roman885-85/hearlink/docs/uk/hardware.md

# Обладнання та схеми

[← до головної](../../README.uk.md) · [English](../en/hardware.md)

> **Набір 4.x.** Входи (цифровий AES/S/PDIF, аналоговий PCM1808, USB) тепер на **мості** — платі Raspberry Pi Pico між
> пультом і передавачем. Що докупити, як переробити модуль PCM1808, схеми підключення, зворотний бік передавача з
> роз'ємом H1 і варіанти цифрового входу — **[Набір 4.x: міст, входи, схеми](next-edition.md)**. Нижче — модулі,
> приймачі, навушники й ЦАП (для 4.x без змін) і підключення PCM1808 прямо до передавача (лише для 3.x).

## Що потрібно

### Передавач (1 шт.)

| Вузол | Що саме | Примітки |
|---|---|---|
| Модуль | **ESP32-4848S040** (він же ESP32-4848S040C_I): ESP32-S3-WROOM-1U **N16R8**, екран 4″ 480×480 (ST7701), ємнісний сенсор GT911, гніздо microSD, міст USB CH340 | потрібна саме версія з 16 МБ флеш і 8 МБ PSRAM |
| Антена | зовнішня 2,4 ГГц на роз'єм IPEX (U.FL) | модуль «1U» без антени майже не чути: на столі −45…−68 дБм замість −14 |
| Живлення | блок 5 В, **не менше 1 А** | від порту ноутбука не живити: струм в імпульсі великий, порт «відвалюється» |
| Вхід звуку | 4 резистори 10 кОм, конденсатори 1 мкФ і 4,7 нФ, фільтр зміщення 1 кОм + 100 мкФ | на роз'ємі H1 немає 3,3 В, тому зміщення береться від 5 В через фільтр |
| Розв'язка (бажано) | ізолятор «земляної петлі» 3,5 мм між пультом і передавачем | прибирає гул 50 Гц |
| Картка пам'яті (за бажанням) | microSD, FAT32 | запис ефіру, файли в ефір, оновлення |
| Зовнішній АЦП (за бажанням) | модуль **PCM1808** | стерео й менший шум; у прошивці є, **на модулі 4848 не перевірено** |

### Приймач (на кожного слухача)

| Вузол | Що саме | Примітки |
|---|---|---|
| Плата | **ESP32-S3-DevKitC-1 N16R8** (або сумісна з 16 МБ флеш і 8 МБ PSRAM) | PSRAM потрібна для оновлення по радіо: образ 2,2 МБ приймається в пам'ять цілком |
| Екран із ручкою | модуль «M75»: OLED **SH1106 1,3″ 128×64 I2C** + енкодер **EC11** з кнопкою | живити **тільки від 3,3 В**: підтяжки I2C на модулі йдуть до VCC |
| Кольоровий екран (за бажанням, з 3.03) | **IPS 1,9″ 170×320 ST7789** (модуль MSP1901), шина SPI | замість OLED; вибір — перемичкою «вивід 21 → GND»; ручка й кнопки — як і раніше. Див. розділ [нижче](#кольоровий-екран-ips-19-на-приймачі-з-прошивки-303) |
| Вихід звуку | навушники напряму: на кожне плече 1 кОм + 10 нФ і розділовий конденсатор 1 мкФ | або підсилювач навушників із різницевим входом (MAX97220) |
| Зовнішній ЦАП (за бажанням) | модуль **PCM5102** або **CS4344** (з 2.85) | чистіший звук: шум живлення процесора в навушники не потрапляє; див. розділи нижче |
| Живлення | повербанк або акумулятор із виходом 5 В | екран не обов'язковий: без нього приймач просто грає |

Плата приймача може бути й без екрана та ручки — тоді ним керують із передавача (гучність, вимкнення, усі
налаштування).

## Як виглядають модулі

### Фотографії

| | |
|---|---|
|  | **ESP32-4848S040** — модуль передавача, лицьовий бік: сенсорний екран 4″ |
|  | **ESP32-4848S040**, зворотний бік: модуль ESP32-S3 з антеною на дроті, гніздо microSD, USB-C, роз'єм H1 |
|  | напис на корпусі модуля — за ним його й шукати |
|  | **ESP32-S3 N16R8** — плата приймача (два роз'єми USB-C, кнопки BOOT і RST, кольоровий світлодіод) |
|  | **екран SH1106 1,3″ з енкодером EC11** і кнопками BACK / CONFIRM |
|  | **MAX97220** («HYT») — підсилювач навушників (за бажанням): входи L+, L−, R+, R−, вихід R, G, L, живлення VCC, GND, керування CTRL |
|  | **PCM1808** — зовнішній АЦП передавача (за бажанням) |
|  | **PCM5102** — зовнішній ЦАП приймача (за бажанням) |

Фотографії модулів належать їхнім виробникам і продавцям; ліцензія MIT проєкту на них не поширюється.

### Малюнки з підписами виводів

Малює їх `tools/gen_modules.py`. Розташування деталей умовне — виводи звіряйте з написами на своїй платі.

ESP32-4848S040
ESP32-S3-DevKitC-1
M75
IPS 1,9″ ST7789
MAX97220
PCM5102
PCM1808

Справжній вигляд плати ESP32-S3-DevKitC-1 — у документації виробника:
<https://docs.espressif.com/projects/esp-dev-kits/en/latest/esp32s3/esp32-s3-devkitc-1/>. Решту модулів легко
знайти за назвою: «ESP32-4848S040», «SH1106 1.3 OLED EC11», «MAX97220 module», «PCM5102 module», «CS4344 module» (або «Pmod I2S»), «PCM1808 module».

## Виводи

### Приймач (ESP32-S3)

| Призначення | Вивід |
|---|---|
| Екран SDA, SCL | 8, 9 |
| Ручка: A (TRA), B (TRB), кнопка (PSH) | 5, 6, 7 |
| Кнопки модуля CON, BAK (не використовуються, підтягнуті) | 15, 16 |
| Вихід звуку «+», «−» (однобітний PDM) | 17, 18 |
| PCM5102: BCK, LCK, DIN, XSMT; SCK — на GND (або на вивід 10, там нуль) | 11, 12, 13, 14 |
| CS4344: MCLK, SCLK, LRCK, SDIN (живлення VCC — від 3V3) | 10, 11, 12, 13 |
| Кольоровий світлодіод плати (WS2812) | 48 (у нових плат — 38) |
| Кольоровий екран IPS 1,9″: SCL, SDA, DC, CS, RES, BLK (з 3.03) | 42, 41, 40, 39, 2, 1 |
| Перемичка вибору екрана: на GND — кольоровий, вільний — OLED (з 3.13) | 21 |

### Передавач на модулі ESP32-4848S040

| Призначення | Вивід |
|---|---|
| Вхід звуку (вбудований АЦП) | IO2 |
| PCM1808: MCLK, BCK, LRCK, DOUT | IO43 (TXD), IO1, IO2, IO40 |
| Картка пам'яті SPI: SCK, MOSI, MISO, CS | 48, 47, 41, 42 |
| Сенсор GT911 SDA | 19 |
| Підсвітка | 38 |

Вільних виводів на модулі лише три: IO1, IO2, IO40 (на роз'ємі H1 вони підписані L1–L3; порядок на роз'ємі
знаходиться командою порту `H`). Коли працює PCM1808, вихід порту (TXD) зайнятий тактом АЦП — передавач нічого не
друкує в порт, але команди приймає. З версії 2.56 такт подається на цей вивід лише тоді, коли вхід
PCM1808 справді йде в ефір: з перевірочним звуком чи файлом із картки в ефірі порт працює як звичайно (докладніше — на
початку [«Команди порту»](commands.md)). Вбудований АЦП — лише для перевірки без зовнішнього АЦП: з ним радіо
передавача часом «стає» на 0,2 с (вбудований АЦП і радіо ділять один вузол мікросхеми).

**Виводи FMT, MD0, MD1 модуля PCM1808.** MD0 і MD1 — на GND (АЦП веде передавач). FMT за схемою — на GND (формат I2S),
але працює й FMT на 3,3 В («ліве вирівнювання», дані на такт раніше): з 3.19 передавач розпізнає формат сам і збирає
відліки наново, ліво й право ставить на місце (так у власника: «при подключении к минусу звука не было вообще»). До 3.19
з FMT на 3,3 В гучні місця «перевертались» — тріск, і рівень на індикаторі був удвічі завищений (`e14`, `e18`).

**Рівень на вході АЦП.** Повна шкала PCM1808 — 3 В розмаху (за живлення 5 В), тобто ±1,5 В. Вольтметр показує
середнє, а піки музики в 3–4 рази вищі, тож «0,7 В» на вольтметрі — уже біля краю шкали. Ознака перевантаження — червоне
«АЦП зрізає» на листі «Піки входу» або «на краю шкали» в `e14`: тоді зменшити вихід пульта (чи поставити на вході
R1, R2 по 22 кОм замість 10 — див. схему). Бас сильно навантажує АЦП: якщо низи все одно зрізаються еквалайзером
передавача, краще зрізати їх на пульті для цієї лінії.

**Такти — найслабшими виходами** (з 3.26): гармоніки такту 8,192 МГц потрапляють у діапазон 2,4 ГГц і заважали
власному радіо передавача (шум +2–3 дБ, коли в ефірі пульт). Провід такту до модуля тримайте коротким і подалі від
антени.

### Передавач на звичайній платі ESP32-S3 (без екрана)

Вхід звуку — вивід 4 (АЦП), PCM1808 — 10 (SCK), 11 (BCK), 12 (LRC), 13 (OUT). Керування — тільки з порту.

## Схеми

Передавач на модулі з екраном, вхід — вбудований АЦП:

Передавач

Вхід: R1, R2 по 10 кОм складають лівий і правий канали пульта, R3, R4 по 10 кОм задають зміщення посередині,
C1 1 мкФ відділяє постійну складову, C2 4,7 нФ зрізає радіочастоти. Сигнал послаблюється вдвічі; на вхід можна
подавати до 2 В.

Приймач, навушники напряму до плати:

Приймач із навушниками

Приймач із підсилювачем навушників (вихід «протифаза»):

Приймач

Варіанти із зовнішніми перетворювачами (не перевірені на платах):
[передавач + PCM1808](../skhema-peredatchik-4848-pcm1808.png),
приймач + PCM5102, приймач + CS4344 і приймач із кольоровим екраном — у розділах нижче.

Схеми малює `tools/gen_schema.py`; є також у SVG.

## Зовнішній ЦАП PCM5102 на приймачі

Модуль — фіолетова плата GY-PCM5102 (PCM5102A, два стабілізатори 3,3 В, гніздо 3,5 мм; на виходах послідовно по
470 Ом — тому навушники можна вмикати просто в гніздо).

| Вивід модуля | Куди | Навіщо |
|---|---|---|
| VIN | 5V приймача | живлення (на модулі свої стабілізатори 3,3 В) |
| GND | GND | |
| BCK | **11** | такт бітів, 1,024 МГц |
| LCK (LRCK) | **12** | такт каналів, 32 кГц |
| DIN | **13** | дані I2S, 16 біт |
| SCK | **GND** (або вивід 10 — приймач тримає на ньому нуль) | головний такт не подається: ЦАП відновлює його з BCK сам |
| XSMT | **14** (або 3V3) | «звук увімкнено». З 2.63 приймач тримає тут «землю» від першого рядка запуску й піднімає рівень, лише коли звук справді пішов (див. нижче «Без хлопків») |
| FLT | **GND** або 3V3 — тільки не «в повітрі» | цифровий фільтр: GND — звичайний, 3V3 — із малою затримкою |
| DEMP | **GND** або 3V3 — тільки не «в повітрі» | корекція передспотворень: GND — вимкнено, 3V3 — увімкнено (верхи м'якші) |
| FMT | **GND** | формат I2S |

Приймач із PCM5102

**Без хлопків у навушниках.** Щоб ЦАП мовчав, поки приймач завантажується, XSMT має бути на виводі 14 (а не на
3V3 і не перемичкою H3L на «H»). З версії 2.63 прошивка: (1) ставить вивід 14 у «землю» першим же рядком запуску;
(2) піднімає його, лише коли приймач у роботі й звук пішов (заставка й початок «запуску» минають із заглушеним
ЦАП), і опускає, щойно робота скінчилась; (3) перед будь-яким перезапуском плати спершу глушить ЦАП і втримує
«землю» на виводі крізь перезапуск. Одного прошивка зробити не може: від подачі живлення до її запуску (частки
секунди) вивід процесора нічим не керується. Якщо хлопок **при вмиканні живлення** лишається — поставте резистор
10–47 кОм між XSMT і «землею»: він тримає ЦАП заглушеним, доки прошивка не візьме вивід на себе.

### Підсилювач навушників MAX97220 після ЦАП

З гнізда модуля PCM5102 до навушників 32 Ом доходить близько 6 % напруги ЦАП: на виходах модуля стоять резистори
470 Ом. Тому «на повну» з навушниками напряму тихо, і цифрове «Підсилення» тут не допоможе — гучніше за повну шкалу
ЦАП цифрою не зробити. Запас дає підсилювач навушників: модуль MAX97220 («HYT») віддає в навушники всю напругу ЦАП.

| Площадка модуля | Куди |
|---|---|
| L+, R+ | лівий і правий вихід ЦАП |
| L−, R− | «земля» ЦАП (AGND) |
| VCC, GND | живлення; краще 5 В — від 3,3 В на найгучніших місцях можливий зріз |
| CTRL | на «плюс» — підсилювач увімкнено (за описом мікросхеми) |
| R, G, L | навушники |

- **Підсилення модуля — одиниця.** Усі резистори біля мікросхеми — 10 кОм. Напис «E01» на частині з них — це ті
  самі «103», припаяні догори ногами.
- **Щоб підняти підсилення**, зменшують резистор на вході «+»: підсилення = 2 · 10 кОм / (10 кОм + R). З 470 Ом
  це 1,9 (+5,6 дБ), з перемичкою — 2 (+6 дБ). Але на навушники 32 Ом мікросхема віддає приблизно до 2 В при
  живленні 5 В, а ЦАП на повній шкалі дає 2,1 В — тож із підсиленням 2 на великій гучності вона зрізає піки.
  Тоді в приймачі ставлять «Межа гучності» близько 85 % (5 В) чи 70 % (3,3 В).
- **«Підсилення» в меню приймача з підсилювачем тримають на нулі**, гучність регулюють ручкою; для слухачів варто
  обмежити «Межа гучності» — 100 % тепер справді гучно.

Числа про напругу й зріз — розрахунок за описом мікросхеми, на платі не виміряні.

**Головне — жоден керівний вивід мікросхеми не має «висіти в повітрі».** За схемою модуля чотири виводи (FLT, DEMP,
XSMT, FMT) задаються перемичками H1L–H4L на звороті, і зазвичай модуль приходить із запаяними: H1L → L, H2L → L,
H3L → H, H4L → L; SCK замкнений на «землю» краплею припою біля виводу. **Трапляються модулі з незапаяними
перемичками** — тоді ці входи нічим не задані (внутрішніх підтяжок у мікросхеми немає), і ЦАП або мовчить (XSMT),
або хрипить і тріщить (FMT, FLT, DEMP ловлять наведення від сусідніх ліній). Ліки без паяння — дроти з гребінки
модуля: FLT, DEMP і FMT на сусідній вивід AGND (G) тієї ж гребінки, XSMT — на вивід 14 приймача. Або запаяти
перемички, як у таблиці.

| Перемичка | Вивід ЦАП | Що задає | Як має бути | Якщо інакше |
|---|---|---|---|---|
| H1L | FLT | цифровий фільтр | **L** або **H** | L — звичайний фільтр, H — із малою затримкою; «в повітрі» — клацання, «бруд» у звуку |
| H2L | DEMP | корекція передспотворень 44,1 кГц | **L** або **H** | L — звук як є, H — верхи м'якші; «в повітрі» — «бруд» у звуку |
| H3L | XSMT | приглушення | **H** | L або «в повітрі» — тиша |
| H4L | FMT | формат даних | **L** (I2S) | H — інший формат: гучний шум замість звуку; «в повітрі» — хрип |

**Перевірено на приладі (09.10.2026).** На приймачі з модулем, у якого H1L, H2L і H4L не були запаяні, звук ішов із
цифровим «брудом»: фонове дзижчання на деяких гармоніках, «ніби дуже низька дискретизація» — хоча сигнал до ЦАП був
правильний біт у біт (`n8=9`). Після запаювання **H1L → H, H2L → H, H4L → L** (H3L → H уже була) бруд зник, звук
чистий. Тобто запаяні мають бути всі чотири перемички; у робочому приймачі набору стоїть саме це поєднання.

Про H2L → H: це корекція передспотворень, розрахована на 44,1 кГц; на наших 32 кГц вона приглушує верхи — за
розрахунком приблизно −2 дБ на 2 кГц, −5 дБ на 4 кГц, −8 дБ на 8 кГц (не виміряно). Якщо мові бракує чіткості —
підняти верхи на приймачі («Чіткість», смуги еквалайзера 2,5 і 6 кГц) або запаяти H2L → L.

- Якщо перемичку H3L запаяно на «H» — вивід 14 до XSMT **не під'єднувати**; якщо SCK на модулі вже замкнений на
  «землю» — нікуди його більше не вести.
- У меню приймача: «Вихід звуку» → **PCM5102** (плата перезапуститься); з порту — `o1`. Навушники з виводів 17/18
  у цьому режимі мовчать.
- Що саме йде на ЦАП, приймач показує сам: `n8=7` — чи «тремтять» BCK, LRCK і дані, рівні SCK та XSMT; `n8=9` —
  знімає сигнали з виводів і друкує біти одного слова (перевірка формату).
- Документація: [PCM5102A, Texas Instruments](https://www.ti.com/lit/ds/symlink/pcm5102a.pdf) — режим без головного
  такту (розділ 9.3.5.3, таблиця 11: 32 кГц при BCK 1,024 або 2,048 МГц), вхід XSMT (9.3.3).

## Зовнішній ЦАП CS4344 на приймачі (з прошивки 2.85)

Модуль — плата з мікросхемою **CS4344** (Cirrus Logic) і гніздом 3,5 мм: Digilent Pmod I2S або її копії, «CS4344
DAC module». На гребінці зазвичай шість виводів: MCLK, LRCK, SCLK, SDIN, GND, VCC; на різних платах підписи бувають
інші — BCK або BCLK замість SCLK, WS або LRC замість LRCK, DIN або SDATA замість SDIN.

| Вивід модуля | Куди | Навіщо |
|---|---|---|
| VCC | **3V3** приймача | живлення ЦАП, близько 16 мА. Якщо на модулі свій стабілізатор і вхід підписано «5V» чи «VIN» — тоді 5V приймача |
| GND | GND | |
| MCLK | **10** | головний такт 8 МГц — без нього CS4344 мовчить |
| SCLK (BCK, BCLK) | **11** | такт бітів, 2 МГц |
| LRCK (WS) | **12** | такт каналів, 31,25 кГц |
| SDIN (DIN, SDATA) | **13** | дані I2S, 16 біт |

Приймач із CS4344

**Живлення — 3,3 В, а не 5 В.** «Одиниця» на входах CS4344 — від 60 % напруги його живлення (опис мікросхеми,
таблиця «Digital input characteristics»). При 3,3 В це 2 В, і виводи ESP32-S3 мають запас; при 5 В — 3 В, а вивід
процесора дає 3,3 В, тобто на межі.

**Чому вихід на 31,25 кГц.** CS4344 обов'язково потребує головного такту (MCLK), і він має бути цілим кратним
частоти каналів (розділ 4.1: «MCLK/LRCK must be an integer ratio»). Для звичних 32 кГц це 8,192 МГц, а ESP32-S3
отримує його лише дробовим дільником зі 160 МГц — періоди такту нерівні (саме такий такт у 2.35–2.37 на PCM5102 давав
хрип). 160 МГц / 20 = 8 МГц ділиться без залишку, а 8 МГц / 256 = 31 250 Гц. Звук ефіру (32 кГц) приймач сам
перераховує на цю частоту тією ж підгонкою темпу, що тримає запас: на один відлік виходу припадає 1,024 відліку
ефіру замість одного. Частоти звуку при цьому не зсуваються; смуга — до 15,6 кГц.

**Вихід лінійний.** Розмах на повній шкалі — 0,65 від напруги живлення: при 3,3 В близько 0,76 В дійсного значення
(у PCM5102 — 2,1 В; CS4344 тихіший на 9 дБ). Навантаження — не менше 3 кОм, вихідний опір 100 Ом (таблиця «DAC Analog
Characteristics»): навушники прямо в гніздо модуля грають тихо, а на гучному — зі спотвореннями. Для роботи —
підсилювач навушників **MAX97220** (як після PCM5102, розділ вище): лівий і правий вихід модуля → L+ і R+; L−, R− і
«земля» модуля → «земля». Підсилення підсилювача можна підняти до 2 (резистор на вході «+» 470 Ом або перемичка):
0,76 В × 2 = 1,5 В — це менше за ~2 В, які MAX97220 віддає в навушники 32 Ом при 5 В, тож зрізу не буде (розрахунок,
не вимірювання).

**Вивід 14 — «увімкнено» підсилювача навушників** (з 3.28; власник: «в приемниках при работе с cs4344, вывод 14
использовать для управления модулем усилителя, пока устройство не загружено звука нет»). Виводу XSMT у CS4344 немає,
тож приймач веде виводом 14 сам підсилювач — так само, як XSMT у PCM5102: «земля» з першого рядка запуску, підйом —
лише коли приймач у роботі й звук пішов, «земля» в очікуванні, пошуку й сні та під час будь-якого перезапуску.
Провід — з виводу 14 на вхід увімкнення підсилювача (у MAX97220 — SHDN: високий — працює, низький — вимкнено; у
модулів підсилювачів він буває підписаний EN, SD, SHDN чи MUTE). Якщо вхід увімкнення на модулі вже запаяно на
живлення — розпаяти й завести на вивід 14; хлопок у самий момент подачі живлення прибирає резистор 10–47 кОм з цього
входу на «землю».

**Від клацань CS4344 береже себе й сама**
(Popguard, розділ 4.5): коли з'являється головний такт, вихід плавно встає за 0,25 с (0,42 с, якщо на VQ модуля стоїть
10 мкФ), а звук іде ще приблизно через 2000 відліків (≈ 64 мс); коли приймач засинає і такт зникає — вихід так само
плавно опускається. Тому після вмикання чи пробудження звук з'являється на 0,3–0,5 с пізніше, ніж із PCM5102.

**Вивід 10 і старе під'єднання PCM5102.** Раніше вивід 10 був «землею» для SCK модуля PCM5102, а SCK на самому модулі
міг бути ще й замкнений на «землю» краплею припою. Щоб не подати такт 8 МГц у замикання, приймач перед запуском
виходу перевіряє вивід 10: вмикає на ньому підтяжку до живлення, і якщо вивід однаково читається нулем — такт на нього
не подає (у `n8=7` — «ВИВІД 10 НА «ЗЕМЛІ»»); CS4344 тоді мовчить. Модуль PCM5102, залишений у режимі CS4344, грає:
він бере такт із BCK або з виводу 10.

- У меню приймача: «Вихід звуку» → **CS4344** (плата перезапуститься; по колу PDM → PCM5102 → CS4344); з порту — `o2`.
  Навушники з виводів 17/18 у цьому режимі мовчать.
- Перевірка: `n8=7` — чи «тремтять» виводи 10–13 і рядок «головний такт: джерело PLL 160 МГц, ділення 20 ціле
  (дробу z=0 y=0 x=0) → 8.000 МГц; такт бітів = головний / 4; частота виходу 31250 Гц»; `n8=8` — справжня частота
  виходу (близько 31 250 відліків за секунду).
- Документація: [CS4344/45/48, Cirrus Logic, DS613F2](https://statics.cirrus.com/pubs/proDatasheet/CS4344-45-48_F2.pdf) — розділ 4.1 (головний такт, таблиця 1), 4.2 (такт бітів,
  «External Serial Clock Mode»), 4.5 (Popguard), таблиці аналогових характеристик і цифрових входів.

**Що перевірено (14.10.2026).** Режим CS4344 — на приймачі з модулем PCM5102, який приймає ту саму схему тактів:
головний такт 8,000 МГц (дільник 20 цілий, дробу немає — прочитано з регістрів процесора), такт бітів = головний / 4,
вихід 31 249 відліків за секунду, підгонка темпу тримає запас, звук іде. **На самому модулі CS4344 не перевірено** —
у наборі його немає.

## Кольоровий екран IPS 1,9″ на приймачі (з прошивки 3.03)

Замість OLED приймач може мати кольоровий екран **IPS 1,9″ 170×320 на контролері ST7789** — модуль MSP1901
([опис на LCDwiki](https://www.lcdwiki.com/1.9inch_IPS_Module); приклад роботи з ESP32 —
[mboehmerm/IPS-Display-ST7789-170x320](https://github.com/mboehmerm/IPS-Display-ST7789-170x320)). Екран стоїть
горизонтально, 320×170; усі екрани, меню, значки, заставка й переходи для нього намальовані наново, у кольорі.
Керування те саме — ручкою (модуль M75 або окремий енкодер EC11 на тих самих виводах).

| Вивід модуля | Куди | Навіщо |
|---|---|---|
| VCC | **3V3** приймача | живлення модуля й підсвітки |
| GND | GND | |
| SCL | **42** | такт шини SPI |
| SDA | **41** | дані шини SPI |
| RES | **2** | скидання |
| DC | **40** | команда / дані |
| CS | **39** | вибір модуля |
| BLK | **1** | підсвітка: ШІМ 30 кГц (вище чутного), яскравість 1…5 |

**Вибір екрана — перемичкою (з 3.13).** Вивід **21** з'єднати з GND — приймач працює з кольоровим екраном; вивід
вільний (підтягнутий усередині до живлення) — з OLED. Читається під час увімкнення: поставили чи зняли перемичку —
перезапустити приймач. Визначити модуль програмно не можна: лінії читання в нього немає. Якщо стоять обидва екрани,
OLED при кольоровому 10 с показує підказку («OLED — зніміть перемичку 21-GND») і гасне. Команда порту `n14` каже,
який екран зараз. До 3.13 екран вибирали пунктом меню «Тип екрана» — його прибрано: якщо стоїть лише кольоровий
екран, перемикати меню без OLED нема чим.

Приймач із кольоровим екраном

**Шина.** Виводи шини SPI з прямим під'єднанням (10–13) зайняті звуком, тому шина йде через матрицю виводів. З 3.11 —
**20 МГц і найслабші виходи** ліній шини: на 40 МГц зі звичайними виходами зміна картинки давала в навушниках легкі
клацання (власник 15.10.2026; заміри показали, що радіо й цифрова частина звуку від шини не страждають — це наведення
вже після ЦАП). Після 3.11 — «практично зникли, майже не помітні». Якщо клацання чути:

- резистори **33–68 Ом** у лініях SCL і SDA біля плати (на схемі — пунктирно, за бажанням);
- дроти до модуля якомога коротші й подалі від дротів ЦАП і від антени;
- «земля» модуля — окремим дротом до GND плати; на живленні модуля 10 мкФ + 100 нФ.

Властивості модуля — командою порту `n27=<сума бітів>` (перезапуск): 1 — модуль повернутий на 180°, 2 — порядок
кольорів BGR (якщо червоне й синє переплутані), 4 — шина 80 МГц, 8 — 40 МГц (як до 3.11), 16 — сильні виходи шини
(як до 3.11). Яскравість — пункт меню «Яскравість» або `n15=1…5`.

**Що перевірено (15.10.2026, приймач 884A94).** Головний екран — 62–63 кадри за секунду, кадр 3,6–4,9 мс; на екран
іде лише те, що змінилося (сотні точок за кадр із 54 400). Оновлення прошивки по радіо в кольоровому режимі — шість
разів поспіль без збоїв. Сон і пробудження — як з OLED.

## Два способи під'єднати навушники

У меню приймача «Виводи» (і на передавачі: вікно приймача → «Налаштування» → «Вихід звуку»):

- **2 канали** — на виводі 17 лівий канал, на 18 правий; навушники напряму або стереопідсилювач. Працюють стерео
  й баланс.
- **протифаза** — один і той самий звук на двох виводах у протифазі: удвічі більший розмах для підсилювача з
  різницевим входом. З навушниками, під'єднаними напряму, у цьому режимі звук «навиворіт» — його не вмикати.

Виводи 17 і 18 поставлені на найбільший струм (до 40 мА). Гучність у навушниках напряму залежить від їхнього опору:
з 32 Ом тихіше, ніж із підсилювачем.

## Послідовність збирання

1. Спершу прошити плату ([Встановлення](install.md)) і переконатися, що вона запускається.
2. Під'єднати **тільки екран** — перевірити заставку. Потім ручку. Потім звук. По одному вузлу за раз: так видно,
   що саме не працює.
3. Перед подачею живлення перевірити, що VCC екрана на 3V3, а не на 5V.
   Кольоровий екран — так само від 3V3; перемичку 21 → GND ставити разом із ним.
4. Звук від пульта під'єднувати останнім і з малого рівня.
