roman885-85/hearlink/docs/en/technical.md

# How it works: full technical description

[← back to main page](../../README.md) · [Українська](../uk/technical.md)

Contents: [general layout](#general-layout) · [transmitter](#transmitter) · [receiver](#receiver) ·
[radio](#radio) · [packet and audio](#packet-and-audio) · [feedback](#feedback-and-commands) ·
[security](#security) · [update](#firmware-update) · [memory](#board-memory) ·
[firmware files](#firmware-files) · [quirks and pitfalls](#quirks-and-pitfalls) · [not verified](#not-verified)

## General layout

```
mixer ──line output──► [transmitter: ADC → frames → (compression) → cipher+signature] ══ ESP-NOW, 2.4 GHz ══►
      ══► [receiver: signature check → decryption → loss recovery → buffer → pace adjustment →
           clarity → volume → limiter → balance → one-bit output] ──► headphones
receiver ──(once every 2 s: information about itself)──► transmitter ──(commands)──► receiver
```

- One transmitter **broadcasts**; there can be any number of receivers, up to 16 in the transmitter's list.
- The processor everywhere is an ESP32-S3 (two cores, 240 MHz, hardware AES), 16 MB flash, 8 MB PSRAM.
- The audio rate is 32,000 samples per second, 16 bit. The audio is cut into chunks of 64 samples (2 ms).
- The protocol version is 4 (`PROTO_VER`); packets with another version are discarded.

## Bridge (4.x)

A Raspberry Pi Pico board (RP2040, 200 MHz) between the mixer and the transmitter; source in `bridge/`.

- **Inputs.** AES/EBU or S/PDIF on pin GP15, the `pico_spdif_rx` library (PIO0), 44.1 / 48 kHz, 24-bit. PCM1808 — the
  bridge drives all three clocks with integer dividers of 200 MHz: MCLK 12.5 MHz (PWM), BCK 3.125 MHz, LRCK 48 828 Hz
  (256 fs), PIO1; the I2S format (FMT to ground) is recognised by the bridge itself (data one bit late, left channel
  while LRCK = 0). USB — a USB Audio Class 2 sound card (48 kHz, 16-bit) and a “What goes on air” recording (32 kHz).
- **Resampling** (`asrc.c`): from the input rate to the transmitter clock — 32 kHz (64 taps) or 48 kHz in “Monitor”
  (32 taps); cut-off min(0.48·fout, 0.458·fin); 24-bit samples are multiplied with two 32-bit multiplications (upper
  16 bits and the low byte). A regulator keeps 16–24 frames in reserve; bridge latency ~1–1.6 ms.
- **Radio hum** (`hum.h`): after resampling the hum from the transmitter's packets repeats exactly with its frames; a
  16 ms template learns with the weight E0/(E0+E) by the cycle energy (E0 = −76 dB) — music does not get into it — and
  is subtracted.
- **Link to the transmitter.** The bridge is an I2S slave: BCK/LRCK come from the transmitter (IO1, IO2), audio goes to
  IO40; bits 7…4 of every word carry the bridge status frames (COBS + CRC). Commands — UART 115 200 from the
  transmitter's pin 43 (BP_SET once a second: input, balanced mode, hum, 48 kHz, test signal).
- **Updates.** The bridge flash holds a bootloader (28 KB, never rewritten) and the program; the transmitter carries the
  program image in its firmware (`hearlink/bridge_fw.h`) and, if the bridge CRC differs, puts it into the bootloader and
  writes the program over UART (~15 s). A failure mid-write leaves the bridge in the bootloader waiting for the next try.

## Transmitter

### Design
ESP32-4848S040 module: ESP32-S3-WROOM-1U, 480×480 display with a parallel RGB bus (ST7701 controller), GT911 touch
sensor (I2C), microSD card (SPI), CH340 USB bridge, a relay and a speaker amplifier (not used).

### Audio path
1. **Input.** The built-in ADC in continuous mode takes 64,000 samples per second; pairs are summed — the result is
   32,000 (this also gives a small gain in noise). The pace of the whole kit is set by the input. The external
   PCM1808 is connected over I2S, stereo; the transmitter recognises the data format by itself (since 3.19, see
   “What changed in 3.17–3.27”), the I2S queue is 8 frames of 2 ms.
2. **Input processing** (mixer sound only): equalizer (low cut and five bands), **gain** (−12…+24 dB), **peak
   limiter** (since 3.18), noise reduction (a separate task on the display core, since 3.23 with two frames of slack),
   measurement of level, peak and overload (the edge of the ADC scale → the `FLAG_CLIP` flag in the packet → the
   receiver shows «Гучно на вході!» (Input too loud!)), noise gate (since 3.17).
3. **Source**: the input, a test sound from the `assets` partition (voice — uncompressed, tunes — MP3 decoded on the
   fly by a separate task with a one-second buffer in PSRAM) or a file from the card.
4. **Frame**: 1, 2, 4 or 6 chunks depending on the quality. For 16 kHz — a half-band filter and decimation by two
   (flat up to 6 kHz, −3 dB at 7.5 kHz, −35 dB at 10 kHz).
5. **Compression**: IMA ADPCM (4 bits per sample) with selection of the initial step: the encoder tries several
   steps and takes the one with which the frame comes out more accurate (on sharp sound onsets this reduces channel
   crosstalk from −9 to −38 dB). The «найвища» (highest) quality goes uncompressed.
6. **Packet**: header + current frame + 1–2 previous frames (spare copies) → encryption and signature → ESP-NOW.

### Tasks (FreeRTOS)
| Task | Core | Priority | What it does |
|---|---|---|---|
| `tx` | 0 | 20 | input → frames → packets; commands to receivers; announcement of a channel hop |
| Wi-Fi (ESP-IDF core) | 0 | 23 | radio |
| `mp3` | 1 | 1…3 | MP3 decoding: priority 1 while the buffer is above 3/4, and 3 when it is below 45 % |
| `ui` | 1 | 2 | display and touch sensor |
| `rec` (card) | 1 | 1 | WAV recording, file manager, looking through the `UPDATE` folder — only this task works with the card |
| `touch` | 1 | 4 | polling the sensor, the queue of touches |
| `scan` | 1 | 3 | measuring channel occupancy (for the duration of the search) |
| `ota` | 0 | 19 | distributing firmware to receivers (for the duration of the update) |
| main loop | 1 | 1 | port, reports, saving settings, radio and ADC watchdogs |

### Screen
- Drawing goes not to the display but to a "shadow" sheet in memory; at the end of a frame only the changed
  rectangle is transferred to the display — no intermediate states are visible.
- Frame output to the RGB panel is custom: in portions of 10 lines through an intermediate buffer with pre-loading
  into the cache. Any flash read through `esp_partition_read` turns the cache off on both cores for fractions of a
  millisecond, and the picture jerks — which is why the sounds partition is **mapped into memory** (`mmap`).
- The firmware chooses the buffer for every portion itself: portion No. s always goes out of buffer s % 2 (output
  restarts from buffer 0 in every frame). The ESP-IDF 5.5.1 driver picks the buffer by the parity of an interrupt
  counter which, with `CONFIG_LCD_RGB_RESTART_IN_VSYNC`, it never resets: one merge of two interrupts and the picture
  stays broken until a restart (fixed in later ESP-IDF). The count of such faults is in the `u` report.
- While the transmitter's own firmware is being written, the cache is turned off for a long time — so the writing
  goes in cycles: backlight off → 1.7 s of writing → backlight on for 1.5 s. The screen warns about the blinking in
  advance.
- **The transmitter radio and the built-in ADC.** The Wi-Fi driver (ESP-IDF 5.5.1) sometimes stops transmitting:
  frames stay in it forever, reception works, `esp_wifi_stop/start` does not help, only `esp_wifi_deinit/init` does
  (the buffers of the stuck frames are lost — about 0.4 KB per frame). It happens only with the built-in ADC in
  continuous mode: a test on one build gave 4–7 stalls in 8 min with the ADC and 0 with the I2S input; with the ADC
  every packet takes 0.5 ms longer to get on air. The watchdog (`radioSend` in `radio.h`): 200 ms without a driver
  reply while packets are queued → full driver reload (16 ms); low memory → board restart.
  Since 2.63 the main cure is **two frames per packet** (below): on one and the same build with the built-in ADC,
  single packets gave 7 stalls in 3 min and double packets none in 14 min. The newer core (ESP-IDF 5.5.5, since
  2.63) stalls about five times less often in the worst mode, but it still stalls; the cause inside the driver has
  not been found.
- **Pin 43: PCM1808 clock or the port.** The I2S clock always runs inside; it is connected to the pin (`txMclkPin`
  in `txaudio.h`) only while the input itself is on air, otherwise the pin belongs to the UART.
- **Time budget of the radio core.** A “highest” quality frame is 2 ms. Before 2.63 the transmit task spent 1.4 ms
  per frame with the live input and 1.85 ms with the test music, 0.7–0.78 ms of it in the `esp_now_send` call itself
  (Wi-Fi code runs from flash through a small cache), and that call costs the same whatever the packet length.
  Since 2.63 two frames go in one packet: half as many calls, about 1.1–1.2 ms per frame (the “radio” stage
  0.33–0.38 ms). The `Q` command prints the breakdown by stages. Under overload the task yields the core by itself
  so that the task watchdog does not restart the board.
- Page flipping is a slide lasting 284 ms (12 steps); MP3 decoding is paused for this time.

### Transmitter radio: resilience
- **Searching for a free channel**: 2 s of silence, 150 ms on each of the 13 channels; the share of busy time is
  counted, taking adjacent channels into account.
- **Congestion**: a second is "bad" if packets waited long for the air or the driver refused them. Five bad ones
  out of eight — a hop; if the occupancy is already known — without a pause (a `CMD_HOP` announcement to all
  receivers: "from packet N I am on channel C"), otherwise — with a search. It moves to a new channel only if that
  channel is freer by at least a third.
- **Thinning**: when the driver queue grows, the transmitter deliberately skips packets (`FLAG_THIN`); the receiver
  takes their frames from the spare copies — this is not loss.
- **Reviving the radio**: if the driver stops responding to sends (all 32 buffers are taken, error
  `ESP_ERR_ESPNOW_NO_MEM`), the transmitter revives it step by step: ESP-NOW restart → Wi-Fi restart → a quick
  restart of the board without the splash screen. The "black box" (`bbox.h`) remembers the last 40 events (channel,
  settings write, card, messages) and at the moment of the first failure takes a snapshot — prints it to the port
  («# РАДІО СТАЛО…», "# RADIO STOPPED…"), writes it to `/LOG/` on the card and carries it across the restart in the
  RTC memory. The cause of such a stall has not been found yet.

## Receiver

### Design
ESP32-S3-DevKitC-1 N16R8 board; SH1106 display (I2C at 800 kHz if the display can handle it, otherwise 400), EC11
encoder, on-board WS2812 RGB LED. The audio output is one-bit (PDM) on two pins through simple RC filters, or an
external DAC: the PCM5102 (I2S at 32 kHz, no master clock — the DAC derives it from BCK) or the CS4344 (since 2.85: I2S at
31.25 kHz, an 8 MHz master clock on pin 10 — an integer division of 160 MHz by 20; bit clock 2 MHz, 32-clock channel
word). Why not 32 kHz — see hardware.md, “External CS4344 DAC”.

### Audio path
1. **Reception** (Wi-Fi task): own kit and version → signature check → replay protection → decryption.
2. **Recovery**: the packet number shows how many frames were lost. The last one or two are taken from the spare
   copies of the next packet; the rest are replaced by a smooth fade to silence, and the first frame after silence
   fades in smoothly (2–4 ms).
3. **16 → 32 kHz** with the same half-band filter (delay 0.72 ms).
4. **Buffer** — a ring of 256 ms; the sound starts playing once the set number of milliseconds has accumulated.
   The «сам» (auto) mode: buffer = the deepest dip over the last minute + 4 ms; after a dropout it immediately grows
   by the length of the dropout. The limits depend on the frame length: from 4 + frame/2 to 26 + 2·frame ms.
5. **Pace adjustment**: the crystals of the two boards run differently, so the receiver plays fractions of a
   percent faster or slower, holding the buffer (the conversion is a windowed-sinc table, Kaiser window, since 2.44;
   since 2.86 — 48 taps × 128 phases with the cutoff at 15 kHz: error no worse than −77 dB up to 15 kHz, the top above
   14 kHz rolls off smoothly, −5.6 dB at 15 kHz). No more than ±0.3 % — otherwise a "drift" of
   pitch is audible on music. With the CS4344 (2.85) the same conversion also takes the 32 kHz of the air to the
   31.25 kHz output: the input step per output sample is 1.024 × (1 ± adjustment).
6. **Speech clarity**: a "shelf" filter (+12 dB above 2 kHz) and a mix of "the sound + its boosted copy" in a
   proportion of 0.196 / 0.507 / 1 — that is +4 / +8 / +12 dB. "Strong": 1 kHz +0.9 dB, 2 kHz +6.0, 3 kHz +9.8,
   4 kHz +11.2, 8 kHz +12.0.
7. **Volume**: 21 steps of 2 dB; step 20 (100 %) — the audio as it is, below it — quieter (step 1 is −38 dB).
   There is no gain above “as it is” (since 2.40) — just like in an ordinary player or radio. Before 2.40 “as it is”
   was step 12 (60 %), and above it came gain up to +16 dB held by the limiter: on music mastered to full scale the
   limiter worked almost all the time above 60 % (at 85 % volume — 84 % of the time, up to −10.8 dB), and the sound
   “sagged” on every bass note. A quiet source is amplified at the transmitter: «Звук» (Sound) → «Підсилення входу»
   (Input gain). The volume changes smoothly. After an update from an older version the stored volume and its limit
   are converted once (+8 steps, not above 100 %), so that it sounds as before.
   Separately there is **«Підсилення» (Boost)** (0…+24 dB in 2 dB steps, since 2.48). Since 2.63 it is a plain
   multiplication after the volume (a “trim”): whatever does not fit the scale after it is held by the limiter (the
   next item). In 2.48–2.56 the boost was applied “with a hold” — only within the headroom left below full scale: at
   100 % volume with full-scale music only +0.2 dB of a +14 dB setting acted, and that looked like “the setting does
   not work”.
8. **Look-ahead limiter** (since 2.37) — common to both channels. The audio passes through a 3 ms delay
   (96 samples; before 2.86 — 1.5 ms) and the gain is computed from the largest sample in that window: it goes down
   BEFORE the peak arrives — since 2.86 as the average over the whole window, i.e. exactly to the value needed at the
   peak and never over full scale — and comes back slowly (a quarter of a second; 40 ms with compression). When there is nothing to limit, the audio passes
   unchanged. Since 2.40 the threshold is full scale, so without “Clarity” and “Boost” the limiter does not work at all (the
   one-bit output still gets no more than 30 000 of 32 767). The previous limiter (instant attack, 80 ms release) clipped the top of each peak and its gain
   wandered by 1–2 dB within one bass period — with the DAC this was heard as overload in the bass, especially
   with “Clarity” switched on.
9. **Balance** — attenuation of one channel by 3 dB per step.
10. **Output**: PDM 32 kHz on pins 17/18 (16 bits, since 2.86 rounded instead of truncated) or I2S to an external
    DAC — since 2.86 **24 bits in a 32-bit word** (before 2.86 — 16 bits: the receiver volume is digital, and at 2 of
    20 only 10 bits of the sound were left). After power-on the PDM pins rise to mid-level in 0.7 s; before sleep they
    drop to ground in 0.5 s — so that the capacitors do not click in the headphones.

### States
```
SEARCH (splash 4 s, waits up to 10 s) ─signal─► STARTUP (4.4 s; sound from 1.5 s) ─► RUNNING
RUNNING ─10 s without a signal─► LEAVING (6 s of a message) ─► STANDBY (sleep)
STANDBY ─heard the transmitter─► WAKE-UP (splash) ─► STARTUP   (before 3.14 a knob press woke it too)
any ─"turn off" from the transmitter─► LEAVING ─► STANDBY (woken only by "turn on" from the transmitter; before 2.65 also by a double press of the knob)
```
The knob acts only while running and only while there is a signal (packets not older than 0.5 s; since 3.14): without a
signal, while searching, asleep or turned off from the transmitter it does nothing, and an open menu closes when the
signal is lost. The service exit for a turned-off receiver whose transmitter is gone remains: hold the knob for 10 s
without the transmitter being heard — the kit is forgotten and the receiver asks for access again.

The sleep cycle: radio off, light sleep of the processor for 0.5 s (woken by the timer; before 3.14 also by the knob button), then
70 ms of listening to its own channel; every fourth cycle — another 12 channels at 25 ms each. If the transmitter is
heard — once every ~2 s the receiver reports "I am asleep" and waits 80 ms for a command in reply.

### The receiver radio: staying alive (since 2.63)
A receiver transmits little — two short packets about itself every two seconds — but the transmitting part of its
Wi-Fi driver can stall too while reception keeps working: the sound plays, commands are executed, and the
transmitter does not “see” such a receiver (twice within 24 hours on 2026-10-09/10; only a restart of the receiver
cured it). Before 2.63 the receiver did not watch its own transmissions at all. Now:
- **Send watchdog** (`rxSend`, `rxTxWatchTick` in `radio.h`). Every transmission is counted and the receiver waits
  for the driver's “packet sent” reply. A packet in the driver without a reply for more than 0.5 s (or four
  refusals in a row) — the Wi-Fi driver is reloaded completely (20–30 ms without reception, 16–24 ms of sound from
  the spare copies or silence).
- **The channel is never changed under the receiver's own packet.** The channel search, the “adjacent channel”
  correction, the hop after the transmitter and the sleep cycle wait until the packet is gone (the hop — no longer
  than 12 ms). The second status packet goes only after the driver has answered the first; no status is sent while
  a hop is announced or when the transmitter has not been heard for more than 0.4 s.
- **Check against the “whom I hear” list** (`TxSeen`, below; `rxSeenTick` in `rxlink.h`) — catches what the
  watchdog cannot see. The transmitter is heard, it announces whom it hears, the receiver has reported itself four
  times — and it is not in the list for 12 s: reload the radio; another 12 s — restart the board once, without the
  splash (about a second without sound). If it is still not heard after that, the receiver is not the cause (for
  example, the transmitter is farther than the receiver can reach): no more restarts, only rare radio reloads
  (after 1, 2, 4, 8 and then every 10 min). Everything is forgotten once the receiver has been heard for ten
  minutes in a row. If the transmitter's list of receivers is full, the receiver does nothing.
- **The receiver reports every such case to the transmitter** with a line (the “event” kind of the radio debug
  channel, always sent): the transmitter prints it to the port and appends it to the log on the card —
  `# [4C3B10] приймач: радіо не відповідало…`.
- A check without a real fault — the receiver port command `n12` (see [commands](commands.md)).

### Tasks
| Task | Core | Priority | What it does |
|---|---|---|---|
| `rx` | 1 | 20 | audio output, in blocks of 1 ms |
| Wi-Fi | 0 | 23 | receiving packets |
| `ui` | 0 (before 2.96 — 1) | 2 (21 while a frame is being sent) | screen at 60 frames/s, knob, menu |
| `led` | 0 | 3 | LED 200 times/s (smooth "breathing" by dithering between adjacent levels) |
| `knob` timer (esp_timer) | 0 | — | (since 3.09) the knob button every 5 ms: debouncing is 4 equal samples, presses and releases are counted, so they are not lost even between slow frames |
| main loop | 1 | 1 | port, reports, states, sleep, information to the transmitter, update |

### Receiver screen
The frame is drawn by the U8g2 library into its own sheet; what goes to the display is **custom output**: the frame
is compared with the previous one, and for each of the eight pages of the display one transfer is sent with only the
changed columns. This gives 60 frames/s (the library gave 33). "Halftones" on the one-bit display — with a 4×4
raster; transitions between screens — by blending with the previous frame (dissolve, slide, circular reveal,
curtain).

The I2C bus takes 32 bytes at a time: the ESP-IDF 5.5 driver (`i2c_master_transmit`, synchronous) puts the next portion
from the task that called it, when the interrupt says "the previous one is gone". So the output speed depends on how
fast the display task gets the core. Before 2.96 it shared core 1 with the sound task (priority 20), and with noise
suppression in stereo a frame took ~20 ms and the screen showed 17–23 frames/s. Since 2.93 the display task is raised to
priority 21 while a frame is being sent, since 2.96 it runs on core 0 (40–45 % free there; the radio at priority 23
still goes first). Measurements — in `G1`: «екран: N кадрів за секунду, малювання …, передача кадру …» (display: frames
per second, drawing, frame transfer); the sound chain stages — `Y15`.

Since 3.12 the OLED main-screen status line (link level, name, volume) is redrawn only when something in it changed:
the key is the bar heights as drawn, the volume, the name and the ticker offset (`rxs::statusKey`); otherwise it comes
from a 1 KB cache, and only the line under it and the view below are drawn every frame (`Y17` — as before 3.12). The
spectrum for both displays is analysed with the esp-dsp library (`dsps_fft2r_fc32`, S3 vector instructions): 320 µs
instead of 1721 (`Y19`/`Y20`/`Y21`). Its output is in bit-reversed bin order; the bins up to 8 kHz are read through the
permutation table, the whole array is not reordered. Bands: OLED — 14, colour — 10.

### Colour display (since 3.03)
IPS 1.9″ 170×320 on an ST7789, landscape 320×170 (`rxlcd.h` — hardware, `rxcolor.h` — all screens, `rxstrip.h` —
output). The display type is set by a jumper: pin 21 to GND — colour, open — OLED (since 3.13; before that, a setting).

- **The bus.** SPI2 through the GPIO matrix (the IO MUX pins 10–13 are taken by audio), DMA, the `esp_lcd` driver
  (ST7789: inversion, `swap_xy`, mirror, a 35-row gap). Since 3.11 — 20 MHz and the weakest output drive
  (`GPIO_DRIVE_CAP_0`): at 40 MHz with normal drive, picture changes caused clicks in the headphones. Measurements (`Y22`):
  radio noise is the same whether the bus is idle or busy non-stop (−90.5 / −90.0 dBm), no packet losses; the audio
  output never ran dry (`n8=8`). So it is pick-up after the DAC, and the cure is slower edges. A full frame takes 76 ms
  at 20 MHz and 55 ms at 40 (22 of them on the bus, the rest is the CPU).
- **The frame lives in external memory** (PSRAM, 108 KB), a second frame is for transitions. It is drawn in one pass
  over the scene (`m2::Gfx` with anti-aliasing: 4-bit font text, circles, lines, gradients). Only what changed goes to
  the display: 32×10 tile hashes; a strip may send several pieces if two or more unchanged tiles separate the changes
  (since 3.09). A piece is copied to internal memory, its bytes are swapped (the display wants the high byte first) and
  it goes out by DMA while the next one is prepared.
- **Scene and key (since 3.07).** `ui_rx.h` fills a `Scene` once per frame (what is on the display); `sceneKey` is a hash
  of everything the static part of the screen depends on, with the precision it is drawn with (the link level in
  quarter steps, the mute frame "breathing" in steps). While the key is unchanged, the frame is not redrawn: the analyser
  redraws only the bars that moved (`analyzerStep`: a piece of the column is cleared and redrawn with clipping — exactly
  as a full redraw would; neighbouring pieces go out as one if that is cheaper), and the areas that move by themselves
  (`sceneDyn`: the ticker, the flipping volume, the mute intro, the menu edit arrows) are redrawn with clipping. Key 0
  means the whole screen moves (searching, "it's me", splash): the full frame every time.
- **Transitions.** The previous screen is a snapshot of the frame at the start of the transition (since 3.09; before,
  it was redrawn every frame): slides copy rows of the snapshot, the "iris" draws the new screen only inside the circle's
  square and computes a square root only for edge pixels, the "wipe" draws the new screen only left of its edge.
- **Main screen (since 3.08).** Volume top left (154×78), the analyser bottom left (154×80, 10 bars with peak marks),
  link, stereo/mono, noise reduction and the name on the right (154×162).
- **Measurements (884A94, 15.10.2026).** Main screen: 62–63 frames/s, 3.6–4.9 ms per frame (spectrum 0.35–0.40, drawing
  0.4–0.6, sending 1.2–3.2), 750–900 pixels per frame out of 54,400. Before 3.06 the frame was drawn in 17 strips of 10
  rows — 17 passes over the scene: 6–35 frames/s; 3.06 (frame in PSRAM) — 32–51; 3.07 (key) — 61–63, 5–9 ms per frame.
- **Simulator** `tools/simrxc/run.sh`: the same code on a Mac — an animation, a sheet of key frames, a check "the
  incrementally drawn screen = the frame drawn in full" (`-DAN_NO_JITTER` — without the ±1 pixel bar tolerance;
  `SIM_DIFF=1` — which pixels differ), a check of transitions against a reference, `SIM_EN=1` — English labels.

## Radio
- **ESP-NOW**, broadcast address, channels 1–13 of the 2.4 GHz band, 20 MHz bandwidth.
- Rates: 1, 2, 5.5, 11 Mbit/s (DSSS, 802.11b), 6…54 Mbit/s (OFDM, 802.11g), 0.5 Mbit/s (Espressif's "long range"
  mode). On the bench, 3–8 % of packets were lost at 6–24 Mbit/s and 0–2 % at 1–11: a single carrier holds up
  better against narrow interference such as Bluetooth.
- The stream "fits" if a packet occupies no more than 45 % of the interval between packets.
- The transmitter listens to the air before every transmission, like an ordinary Wi-Fi participant, so it does not
  harm neighboring networks.
- Wi-Fi power saving is turned off (`WIFI_PS_NONE`).

## Packet and audio

Header (14 bytes, sent in the clear but signed):

| Field | Bytes | Content |
|---|---|---|
| `magic` | 2 | `0x4C48` ("HL") |
| `ver` | 1 | 4 |
| `kit` | 1 | kit number |
| `boot` | 4 | "epoch" — the number of the transmitter's power-on |
| `seq` | 4 | packet number |
| `flags` | 1 | low bits: tone, overload, silence, thinning; high 4 — the transmitter's channel number |
| `q` | 1 | quality (0–3), `0x80` — stereo, `0x40` — the interface language is English, `0x10` — two frames in the packet (since 2.63) |

Then, encrypted: the current frame (uncompressed or an ADPCM block: first sample 2 bytes, step 1 byte, 4 bits per
sample), in stereo — a block of the channel difference, then the spare copies, and at the end — an 8-byte signature.

| Quality | Frame | Copies (mono/stereo) | Packet | Packets/s | Stream |
|---|---|---|---|---|---|
| «найвища» (highest, since 2.63) | 64 samples, 2 ms; **two frames per packet** | copies of the four previous frames (the two previous packets) | 418 / 564 bytes (mono / stereo) | 250 | ~840 / ~1130 kbit/s |
| highest (since 2.77, exact copies) | the same; the previous packet once more uncompressed | 2 exact + 2 compressed | 604 / 750 | 250 | ~1210 / ~1500 |
| highest stereo (since 2.87) | the same; **channel difference uncompressed** — in the frames and in the copies of the previous packet | 2 exact (mid and difference) + 2 compressed (mid only) | 1116 | 250 | ~2230 |
| «найвища» (before 2.63 and for old receivers) | 64 samples, 2 ms | 2 / 1 | ~220 bytes | 500 | ~850 kbit/s |
| «стандартна» (standard) | 128, 4 ms | 2 / 1 | ~223 | 250 | ~430 |
| «мова» (speech) | 128 @16 kHz, 8 ms | 2 / 1 | ~223 | 125 | ~215 |
| «дальня» (far) | 192 @16 kHz, 12 ms | 1 / — | ~220 | 83 | ~141 |

A single packet is no longer than 250 bytes (the limit of ESP-NOW version 1) — hence the frame lengths and the
number of copies.

**Two frames per packet (since 2.63, «найвища» only).** ESP-NOW version 2 (ESP-IDF 5.4+) carries up to 1470 bytes.
A double packet: header 14 · frame A (mid 128 and, in stereo, difference 35) · frame B · compressed copies of the
**four previous frames** — the two previous packets, from the nearest to the farthest (35 each) · in stereo — copies
of their difference (19 each) · signature 8. 564 bytes in stereo, 418 in mono. The packet number is the number of
the first frame and the second frame is the next number, so frames and numbers are the same as in single packets.
Why: a send call costs the radio core 0.7 ms whatever the packet length, and 500 calls a second kept the core
70–93 % busy; now it is 250. On air a packet takes 633 µs out of 4000 (15 %) instead of 383 out of 2000 (19 %).
The price: +2 ms of delay.
Loss resistance: two lost packets in a row (8 ms of sound) are recovered completely and in stereo. A calculation on
the computer (`tools/host/dbl.cpp`, 8 s of sound, random packet loss) — sound lost:

| Packet loss | Single, stereo | Double, stereo | Single, mono | Double, mono |
|---|---|---|---|---|
| 5 % | 18 ms | 0 | 0 | 0 |
| 10 % | 68 ms | 0 | 0 | 0 |
| 20 % | 302 ms | 76 ms | 64 ms | 76 ms |

Compatibility: an old receiver drops a double packet as foreign, and an old receiver that is asleep or has just
been switched on cannot find the transmitter by the rare single packets either. So (a) the transmitter **remembers
the version of every receiver** of its list in flash and uses double packets only when **all** receivers of the
list — in touch or not — have reported version 2.60 or newer (the first release with double packets is 2.63), and not while the “add a receiver” window is open;
`?` names the receiver that is in the way; (b) after every 75 double packets (three times a second) an ordinary
single packet with the number of the second frame follows: new receivers drop it as a repeat, and an old one that
is awake stays in touch by it. A receiver that no longer exists but is still in the list keeps the transmitter on
single packets — delete it from the list. A pause-free channel hop is scheduled on a pair boundary.

**Stereo**: what goes on air is the "mid" (L+R)/2 — the same sound as in mono — and the "difference" (L−R)/2. A
receiver in mono mode does not touch the difference. Before 2.86 the difference was ADPCM (4 bits per sample); since
2.86 on "найвища" it goes **uncompressed**, like the mid: in stereo the receiver gets the same L and R that left the
transmitter (up to the least significant bit lost when dividing by 2). The packet (since 2.87) is 1116 bytes: header · two frames
(mid 128 + difference 128) · mid of N−1, N−2 uncompressed · mid of N−3, N−4 — ADPCM · difference of N−1, N−2
uncompressed · tag. A single loss is restored bit for bit in stereo; when two packets in a row are lost, frames N−3,
N−4 play in mono, the difference fading out and back in within 1 ms. At 5.5 Mbit/s it is 1878 µs of 4000 (47 % of the
air; the previous kind — 34 %). In 2.86 the packet was 968 bytes and the copies of the difference stayed 4-bit — on the
clean sound every loss sounded like a rustle. The transmitter uses the new kind when every receiver on the list has
reported 2.87+; serial `Qr0` — temporarily the old way (to compare by ear).

**Channel number in the header**: adjacent Wi-Fi channels overlap, and a receiver may hear a packet while sitting
on an adjacent one; by this number it tunes exactly.

## Feedback and commands

| Message | Tag | Who → whom | Content |
|---|---|---|---|
| `RxStatus` / `RxStatus2` | `0x5348` | receiver → transmitter, once every 2 s | volume, flags (mute, turned off, screen, sound is playing, sleep, stereo, output alive), signal, buffer, loss, dropouts, uptime, version, name (13 or 32 letters) |
| `RxInfo` (since 2.32) | `0x5348`, different length | receiver → transmitter | clarity, balance, volume limit, view, LED, language, whether a headphone test is running |
| `TxCommand` / `TxCommand2` | `0x4348` | transmitter → receiver | command and argument (below) |
| `TxSeen` (since 2.63) | `0x5648` | transmitter → all receivers, every 2 s | “whom I hear”: the numbers of the receivers in touch (up to 16) and a “list is full” flag; a receiver that does not find itself repairs its own radio |
| `PairReq` / `PairRsp` | `0x5048` / `0x5148` | adding a receiver | X25519 public keys, the kit key under the shared secret |
| `KeyMsg` / `KeyReq` | `0x4B48` / `0x5248` | kit key change | the new key under the receiver's personal key |
| OTA | `0x4F48` | update | announcement, blocks, polling, status, cancellation |
| debugging | `0x4748` | both ways | serial lines and commands over the radio; since 2.63 also a receiver “event” (it reloaded its radio or restarted by itself): always sent, the transmitter writes it to the port and to the log on the card |

Transmitter commands: 1 "identify yourself", 2 name, 3 turn on/off, 4 volume, 5 mute, 6 output stereo/antiphase,
7 output check by ear, 8 "forget the kit", 9 channel hop (to everyone), 10 setting (number × 32 + value:
0 clarity, 1 balance+5, 2 volume limit, 3 view, 4 LED, 5 language), 11 headphone test.
Each command is sent four times; the receiver executes it once (power-on number + counter).

**Compatibility**: new messages are distinguished by length or by a new tag, old ones do not change — an old
transmitter simply skips the new ones. The over-the-air update format never changes: old receivers are updated
through it.

## Security
- **Kit key** — 32 random bytes, born in the transmitter, stored in the boards, never goes on air or to the port.
- **Cipher** AES-128-CTR, **signature** AES-128 CBC-MAC (8 bytes in the packet); encryption first, then the
  signature; on reception the signature is checked first. It is computed by the chip's **hardware AES**, block by
  block, directly through the registers — tens of microseconds per packet with no memory allocation. The ready-made
  AES-CCM from mbedTLS cost 1.2 ms per packet (60 % of the processor at 500 packets/s), so it is not used.
- **Nonce**: packet type + epoch + packet number (+ receiver number). Every message type has its own type number —
  the nonce never repeats.
- **Replays**: the receiver remembers the highest epoch and packet number; yesterday's recording of the air cannot
  be slipped to it.
- **Adding**: an X25519 exchange, the four-digit code is a fingerprint of the receiver's public key; the operator
  compares it by eye. The transmitter listens for requests only while the adding window is open.
- **The receiver's personal key** is derived from the same exchange: the new kit key is protected with it when
  someone is removed. A removed receiver cannot obtain the new key.
- What the security does not give: the air can still be jammed with interference, as before.

## Firmware update

**Over the radio** (`ota.h`):
1. The transmitter stops the sound and for 2.5 s announces: size, number of blocks, SHA-256 fingerprint, version.
2. The receiver compares the fingerprint with its own firmware: the same — "I have this one"; different — it
   takes memory for the whole image (PSRAM, ~2.2 MB) and answers "receiving".
3. Blocks of 200 bytes in a row (~11,000 blocks in ~11–18 s). Once every 0.3 s the receiver reports which blocks
   are missing; the transmitter resends them.
4. The receiver verifies the fingerprint of the whole image, writes it to the second firmware partition, makes this
   partition the boot one and restarts.

**From the card** (`upd.h`): the file is checked (an image for ESP32-S3, length, fingerprint in the tail, the tag
`HEARLINK-FW:<version>`); first to the receivers over the radio, then the transmitter writes itself. The order is
deliberate: while the distribution is in progress, both sides run the old firmware and are certain to understand
each other.

## Board memory

`hearlink/partitions.csv` (16 MB flash):

| Partition | Address | Size | What |
|---|---|---|---|
| nvs | 0x9000 | 20 KB | settings, keys, list of receivers |
| otadata | 0xE000 | 8 KB | which firmware partition to boot |
| app0 | 0x10000 | 3 MB | firmware |
| assets | 0x310000 | 9.9 MB | transmitter test sounds |
| app1 | 0xCF0000 | 3 MB | second firmware partition (update) |
| coredump | 0xFF0000 | 64 KB | dump of the last crash |

In NVS: namespace `hearlink`, entry `cfg` — the `Settings` structure in one piece (new fields are added only at the
end: an entry from an older version is shorter, from a newer one — longer, the beginning is read); `hl-peers` /
`list3` — the list of receivers with personal keys; a separate namespace — the kit key, the epoch, the key
generation.

The sounds partition: "HLPK", the number of entries, the entries (name 16 bytes, offset, length); the last byte of
the name is the type: 0 — uncompressed sound 32 kHz mono, 1 — MP3.

## Firmware files
| File | What is in it |
|---|---|
| `hearlink.ino` | startup, serial commands, reports, settings |
| `config.h` | version, sample rate, pins, settings structure |
| `proto.h` | packets, qualities, ADPCM, 16↔32 kHz conversion |
| `radio.h` | ESP-NOW, rates, parsing of incoming packets, reviving the radio |
| `sec.h` | cipher, signature, keys, adding and removing receivers |
| `bbox.h` | the radio "black box" |
| `txaudio.h`, `txmp3.h`, `assets.h` | input, test sounds, MP3 |
| `txpeers.h` | list of receivers, commands, "auto" rate |
| `txscan.h` | channel search, congestion, hop |
| `txrec.h`, `txfiles.h`, `fm.h`, `fmui.h`, `cardfmt.h` | card: recording, files, formatting |
| `ota.h`, `upd.h` | update over the radio and from the card |
| `panel4848.h`, `m2gfx.*`, `txui.h`, `ui_tx.h`, `slide.h`, fonts `f*.h`, `m2*.h` | transmitter screen |
| `rxaudio.h` | reception, buffer, audio output |
| `rxlink.h`, `rxled.h` | information to the transmitter, commands, states, sleep, LED |
| `rxfx.h`, `rxscreens.h`, `ui_rx.h` | receiver screen and menu |
| `rxcolor.h`, `rxstrip.h`, `rxlcd.h`, fonts `rxTxt*.h`, `rxNum.h`, `logo_rx.h` | receiver colour display (since 3.03): screens, change output, hardware |
| `rsdot.h`, `nsfx.h` | pace-conversion convolution, noise reduction and compression |
| `lang.h`, `lang_en.h` | translation of on-screen texts |
| `dbgair.h`, `dbgtee.h` | debugging over the radio |

## What changed in 2.64–3.02 (technical)

- **Receiver status messages (2.64)** — to the transmitter’s address with acknowledgement and retries, not
  “to everybody”; with a weak signal the receiver raises its power to 20 dBm by itself (since 2.77 — below −76 dBm,
  back above −70). `P` shows delivery counters for each receiver.
- **“The transmitter is in charge” (2.65)** — a receiver turned off from the transmitter cannot be turned on with its
  own knob; the transmitter brings it back to the set state. **Radio update (2.66–2.67)**: the receiver does not sleep
  while receiving, the hand-out does not wait for laggards longer than 3 minutes, the “freezes at 99 %” bug is fixed.
- **Processing “for hearing” (2.68–2.72, `hearlink/nsfx.h`)** — in the receiver: compression instead of
  “boost + limiter”, the boost removed in speech pauses, spectral noise reduction (FFT 256, the Wiener rule with the
  decision-directed approach, the noise is learned only in pauses: not silence, flat in spectrum and 15 dB below the
  loudest of the last 10 minutes — since 2.76); in the transmitter — input noise reduction on the display core. 2.75–2.76
  fix two bugs that made noise reduction almost inactive on the devices (garbage in the “sample remembered” flag after a
  restart; no pauses found for 10 minutes after a sound gap).
- **Input noise gate (3.17, `txaudio.h`, `TxGate`)** — after noise reduction and level metering, before “silence on
  air”; mixer sound only. Frame level (2 ms) — the mean square of the mid and the difference; the input noise — the
  quietest (down in ~40 ms, up 0.25 dB/s, within −96…−36 dB); the threshold — noise + 3…15 dB or manual (`e12`); a 6 dB
  soft knee; after sound it stays open 60 / 150 / 300 ms and closes evenly in decibels in 60 / 150 / 400 ms; it opens
  within a frame; the gain changes sample by sample. Host check (noise −62 dB, “words” −20 dB and a quiet syllable
  −34 dB): pauses −11.9 / −19.8 / −29.5 dB / zero, words and the syllable 0.00 dB, extra sample jump up to 3 units. With
  the gate off it still measures the input noise — shown on the “Input noise” page and by `e10`.
- **Rate steps (2.73–2.83, `txpeers.h`, `rateAutoTick`)** — two: the upper (5.5 Mbit/s in “auto” or the one chosen by
  hand) and 1 Mbit/s. Down: the smoothed signal of the weakest receiver is −75 dBm or weaker, or it loses sound, or a
  weak receiver has just vanished; up: all at −70 dBm or better for 30 s (if the weakest is −66 or better) or 120 s,
  doubling the wait if it had to step down again after returning (up to 10 min). A rate or quality chosen by hand steps
  up at once when possible, otherwise the screen explains why. The `cfg.rateLadder` setting («Слабкий сигнал»). While
  packets are being lost, the receiver’s buffer does not go below the copy depth + a frame + 2 ms; the channel search
  starts only after 2.5 s of silence.
- **«Найвища» (2.77)** — the double packet repeats the previous packet uncompressed: one loss is recovered bit for bit.
- **The far-mode codec (2.79–2.82, `hearlink/subc.h`)** — eight cosine-modulated bands (an 80-sample window, a 2.25 ms
  filter-bank delay), a frame of 128 samples = 4 ms, scale and bits of every band anew in every frame, noise fill for
  bands without bits; a 158-byte packet: frame 46 + copy 46 + copy 32 + coarse copy 12. Since 2.82 analysis, packing and
  synthesis run from fast memory (IRAM): the ESP32-S3 instruction cache is only 16 KB for both cores, and code from flash
  cost four times the estimate (encoder 0.58 → 0.16 ms per frame, receiver 0.60 → 0.14 ms per packet).
- **Channel (2.82–2.83, `txscan.h`)** — the channel scan adds a “strong neighbour risk” from access point beacons and
  their real channel; the transmitter counts seconds when a packet waited 15 ms or more for the air and shows it on
  «Ефір»; the soft move is a trial with a return (`hopSoftTick`). Since 2.88 also by the packet losses of receivers
  with a good signal (`airLossPm`: every second the largest of the latest loss shares among those playing at −62 dBm
  or stronger, averaged over a minute; threshold 15 ‰; stay if on the new channel the losses are at least 30 % smaller
  and not larger by 1 %). Measured 14.10: on channel 1 the near receiver (−47 dBm) lost 1–6 % of packets, on channel 5 —
  0 %; by its own scan the transmitter considered channel 1 the best.
- **Sound self-recovery (2.84)** — the row number of the tempo-adjustment table is computed in integers (once in ~17 min
  it rounded up to 128, and the row past the table end was read — the source of a “not-a-number” that silenced the
  filters for good); not-a-numbers at the processing input, after noise reduction and at the output are replaced with
  zero and the filter memory is reset; an output watchdog (the output stuck on one value for 1.5 s while loud sound is
  on air — reset; did not help within 4 s — a quiet restart, no more than once in 10 min); a restart with `CMD_RESTART`
  from the transmitter and a menu item.
- **CS4344 (2.85)** — see “Design” above and hardware.md.
- **“Graininess” (2.86)** — the owner: with an ideal signal, on both DACs, on the test sound and on a good recording —
  “unpleasant graininess”. The chain was reproduced on a computer (`tools/host/rxchain.cpp`) and the error of each
  stage measured per frequency band. Four causes: (1) **the 4-bit channel difference in stereo** — its noise is flat in
  frequency while the top of music is quiet: in the 2–16 kHz bands the noise was only 27…2 dB below the music, and at
  15–16 kHz louder than it; (2) **16 bits with truncation after the digital volume** — at volume 2 of 20 only 5–10 bits
  of the sound were left, and the distortion followed the sound; (3) **the limiter** with +24 dB “Boost” and no
  compression could not keep up with its 0.3 ms attack: 1426 samples in 87 s went over full scale and were clipped
  hard; (4) **the 24-tap pace conversion** — image frequencies at 14–16 kHz (−26…−6 dB). Fixed: uncompressed
  difference (2.87: in the copies too; a 1116-byte packet), 24 bits to the DAC, a limiter with a 3 ms window average (over full scale — a few
  samples, intermodulation −48 → −59 dB), a 48-tap table. Packet check — `tools/host/dbl.cpp`: the difference arrives
  bit for bit.
- **Noise suppression in stereo and radio updates (2.89–2.92)** — the owner: “clicks appear when the noise suppressor is
  on”, “one channel disappears”. (1) The channel difference had no spectrum of its own — it was only delayed and
  attenuated by one overall number, so when the mid was attenuated per band, L and R stopped being “left and right”:
  quiet music panned to L leaked into R at −16…−20 dB (`tools/host/nsstereo.cpp`). Since 2.89 the difference goes
  through the same window and transform with the same band gains as the mid: leakage −27…−31 dB (that is only the
  noise of R suppressed a little differently), noise in R with loud music in L −56…−60 dB instead of −52. (2) The DAC
  output ran dry once in 30–60 s — the output queue was 2 ms, and the heaviest block with noise suppression took up to
  0.65–0.9 ms plus rare delays from the shared instruction cache and the radio; since 2.92 the queue is 4 ms: not a
  single dropout in 3 minutes. (3) A radio update with noise suppression on ran 6–12 times slower (both receiving and
  writing) — the whole sound chain was processing silence; since 2.90 plain silence goes to the output during an update:
  two receivers update in 45 s instead of 2–10 minutes. (4) The transmitter waited for the write at most 2 minutes and
  counted the rest as “vanished”; since 2.91 — while the receivers write and answer, up to 10 minutes.
- **Receiver menu and analyzer with noise suppression (2.93–3.02)** — the owner: “with the noise suppressor on the menu
  and the analyzer on the main page are very sluggish”. Measured (`Y15`, `Y14` in a build with `HL_TASK_LOAD`): since
  2.86 the sound chain took 710 µs of every millisecond, with noise suppression in stereo 830–910 (pace conversion
  270–290, processing and output 270–300, noise suppression 140, block preparation 130–150); the `rx` task — 83–93 % of
  core 1, the display got 14 %: 17–30 frames/s. Done: (1) a frame goes to the display at a priority above the sound
  (2.93); (2) the display task on core 0 (2.96); (3) the pace-conversion convolution as a separate function compiled with
  O2 (`hearlink/rsdot.h`): inside `rxTask` (9 KB of code, `-Os`) the sum lived on the stack, ~45 cycles per tap; now two
  partial sums per convolution, a coefficient is corrected once and used in both — 648 cycles per sample instead of
  ~2000, the difference from the former computation is float rounding (`tools/host/rsdot.cpp`); (4) in the compressor
  `log10f`/`powf` (up to four times per 8 samples) replaced with exact approximations `nsxLog2a`/`nsxExp2a` (error under
  a millionth of a dB; the `tools/host/nsfx.cpp` check prints the same figures); (5) the volume `powf` — only when the
  volume changes (two calls per block cost ~70 µs); (6) the noise-suppression step compiled with O2. Result on the
  devices 15.10: the chain of 4C3B10 (noise suppression 2, compression 3) — 630 µs per millisecond, 884A94 — 485; the
  display 62–63 frames/s on the main screen and in the menu; output ran dry 0 times in 3 minutes on both. Nothing was
  moved to fast memory (IRAM): the transmitter has 42 KB of internal memory free with the rule “not less than 40”.

## What changed in 3.03–3.13 (technical)

- **Colour display (3.03–3.08)** — see "Colour display" above: strips → frame in PSRAM (3.06) → scene key and incremental
  drawing (3.07) → main screen by the owner's layout, 10 bars with peaks (3.08). Menu items "Brightness" and (until
  3.13) "Screen type", icons 22, 23.
- **Over-the-air update with the colour display (3.06).** The task watchdog restarted the receiver (core 0 without idle
  time for over 5 s: the display drew without pauses next to the flash writes). Now during an update the display draws
  10 frames/s and always yields at least 2 ms; six updates in a row checked.
- **Knob button (3.09)** — by a timer every 5 ms, not once per frame: on the mute screen a frame took 30–40 ms, and a
  short press was lost ("cannot leave mute on the first press").
- **20 MHz bus and the weakest outputs (3.11)** — against clicks from picture changes; `n27` (bits 8, 16) — as before.
- **esp-dsp for the spectrum, OLED status line cache (3.12).**
- **Display select jumper (3.13)** — pin 21 to GND; the "Screen type" item is removed.
- **Diagnostics:** `Y22` (display bus interference), `Y23` (listen for pick-up), `Y17`/`Y18`, `Y19`–`Y21`; `Y15` — the most
  important values first (a long line is cut over the radio).

## What changed in 3.17–3.27 (technical)

The owner, 16.10: “with overloads at the input there is crackling at the output”; “on the test sound everything is
perfect even at full overload on the level meter, but through the ADC the same level is just crackling”. The test sound
bypasses I2S, the equalizer and the noise reduction, so “clean on the test sound” says nothing about the input — the
causes were found from recordings made on the device (`e19`/`e21`/`e22`, `tools/adcdump.py`).

- **Input noise gate (3.17)** — see above, in 2.64–3.02.
- **Input peak limiter (3.18, `TxLim`)** — after the equalizer and the gain: a 48-sample delay (1.5 ms), the smallest
  “must cut” over the window via a deque, release, the average over the window; the peak is the larger channel
  (|mid| + |side|), so no sample passes the ceiling; below the ceiling — soft compression (±3 dB knee). Memory from the
  heap, transmitter only. Serial `e14…e17`; on screen — the “Input peaks” page (3.24).
- **PCM1808 data format (3.19–3.21).** With FMT at 3.3 V the module sends “left-justified” data — one clock earlier than
  the ESP32's Philips I2S expects: the sample's MSB lands in bit 0 of the PREVIOUS word, the word holds D22…D0. The
  sample read twice as loud, and everything above half of the ADC scale flipped its sign — crackling. Recognition per
  frame: in an aligned word bit 8 is the LSB (noise) and bit 0 is zero; in a shifted one the other way round (4 frames in
  a row). Shifted words are rebuilt: the sign from bit 0 of the previous word, D22…D0 from its own; the first sample of a
  frame takes whichever of the two signs is closer to the next sample of the same channel (I2S can skip between
  frames). In left-justified mode the left channel is at high LRCK, so with the shift the channels are swapped back.
  Checked on device recordings: without the mixer the sign matches bit 0 of the previous word in 100 % of words; with the
  mixer, 188 and 201 sign flips per 1.5 s → 0. Serial `e18`.
- **Lost I2S frames (3.21–3.22) — the main crackle.** With the mixer the transmit task spent 1.76 ms of 2 per frame on
  average (input processing 465 µs against 232 for the test sound), and I2S lost frames — 20–30 gaps of 2 ms per second.
  The equalizer and gain (`txInEqGain`), the limiter (`TxLim::run`) and the gate (`TxGate::apply`) are built with -O2
  and placed in IRAM (the methods moved out of the struct bodies: otherwise the linker reports “l32r: literal placed
  after use”), `txReadI2s` with -O2; the I2S queue is 8 frames (was 4). Gaps — 0. The I2S loss counter
  (`on_recv_q_ovf`) is in `e14`.
- **Slack for the input noise reduction (3.23).** The task on the display core had one frame (2 ms), but its step (an FFT
  of 256 samples) falls on every second frame and takes ~1.3 ms: it was late thousands of times, and an unprocessed frame
  went on air — a quiet “digital” click in silence. Now two frames (the noise-reduction path is 10 ms instead of 8); if
  it is late anyway — the unprocessed frame, attenuated by the current reduction. Late frames — 0.
- **Weak I2S clock outputs (3.26).** MCLK (pin 43), BCK and LRCK use `GPIO_DRIVE_CAP_0`: the 8.192 MHz harmonics come
  every 8.2 MHz and fall into any 2.4 GHz channel; the transmitter's radio noise with the mixer was 2–3 dB higher than
  with the test sound, now 0.5 dB.
- **Colour display.** Analyser bars — each row's shade by its height on the scale (`anRowColor`: green up to 1/3, then
  to yellow, bright red at the top; 3.23 — the whole bar in one colour, 3.25 — by rows); only rows that moved are
  redrawn, fewer pixels per frame than before. All text is white (3.23, 3.27).
- **Diagnostics:** `e18` (ADC format), `e19`/`e21`/`e22` (recording raw ADC words and what goes on air), `e20` +
  `tools/adcdump.py`; `e14` shows the ADC counters, lost I2S frames, corrected first-sample signs.

## Quirks and pitfalls

Things that have already been stepped on — so as not to step on them again.

- **The scene key must know everything that is drawn, with the same precision.** The link icon was drawn smoothly
  while the key knew the level in quarters — the incrementally drawn screen drifted from the full redraw (found by the
  simulator check). Rule: draw with exactly the precision the key knows.
- **The rounded top of a bar.** When a bar grows, the old rounded top must be erased — the new corners go onto the
  background, not onto the old colour.
- **Display bus pick-up in the headphones** is neither radio nor digital: the "radio noise" and "output ran dry"
  measurements do not see it. The cure is slower edges (output drive, bus clock) and wiring.
- **"<" and ">" in schematic labels** (`tools/gen_schema.py`) break the SVG — `sips` then silently produces no PNG.

- **A software restart of the ESP32 does not reset the pins.** The Arduino core's `pinMode` takes the pin's
  "previous interrupt type" and enables it by itself. In sleep, the knob button is a wake-up source with a "while
  the level is low" interrupt; after "sleep → over-the-air update → restart" the first press hung the board
  (interrupt watchdog). The cure: remove the interrupt and the wake-up source at startup and after every wake-up.
- **`attachInterrupt` installs the handler through a service task with a 1 KB stack** — if an audio interrupt
  arrives at that moment, the stack overflows ("Stack canary watchpoint triggered (ipc1)"). The knob interrupts are
  attached directly (`esp_intr_alloc` from the screen task).
- **The task watchdog (5 s).** In a receiver it watches the idle task of core 0. In the transmitter, since 2.63,
  it watches **the transmit task itself** (`esp_task_wdt_add` in `txTask`): with single packets the radio core is
  93–100 % busy, and “the idle task got no time for five seconds” there is ordinary work with a background load,
  not a hang; because of it the watchdog used to restart the transmitter while an update was being handed out (five
  times in a row on 2026-10-10). The idle task must be taken off with `esp_task_wdt_reconfigure()` and
  `idle_core_mask = 0`: `disableCore0WDT()` of the Arduino core leaves the idle hook behind, and it prints “task not
  found” 500 times a second.
- **Long computations do not belong on the radio core.** The preparation of an update hand-out (the fingerprint of
  the 2.2 MB firmware) runs in a separate task on the display core: on the radio core with single packets it did
  not finish even in 40 s.
- **Flash operations turn the cache off on both cores** — the transmitter's picture jerks; read through `mmap`.
- **ESP-NOW packets longer than 250 bytes** work (ESP-NOW version 2): since 2.63 «найвища» goes in 564-byte
  packets. The old note “the driver sent them 2.5 times slower and went silent” was about a build with a slow cipher
  and never disproved long packets.
- **Do not change the radio channel while your own packet is still in the driver** (and do not put a second packet
  on top of the first) — see “The receiver radio: staying alive”.
- **The pin that drives the DAC's XSMT floats until the firmware starts**: the firmware holds it at ground from its
  first line until the sound begins and across a software restart (`gpio_hold_en`), but the first fractions of a
  second after power-up are covered only by a resistor to ground (see [hardware](hardware.md)).
- **`WiFi.mode(WIFI_OFF)` in core 3.3.3 does not remove the driver**; the handler of the "station started" event
  turns power saving on by itself — it has to be turned off again.
- **The clear part of the packet under the signature must be no longer than 16 bytes**: with 20 the cipher silently
  refused.
- **The version in the receiver's message is ×10 with rounding** (2.31 and 2.34 are both "23") — versions cannot be
  compared by it; the transmitter learns the receiver's capabilities from which messages it sends.
- **A counter changed by two tasks without protection "drifts"** — make two counters (put / took).
- **The built-in ADC of the ESP32-S3** stops from time to time — there is a watchdog that restarts it.
- **Pins 17 and 18** are at their weakest after a reset (10 mA) — they are set to the highest drive current.
- **The 4848S040 module**: there is no 3.3 V on the connectors; the CH340 bridge makes errors at speeds above
  230,400; do not power it from a laptop port.

## Not verified
- Range in a large hall. One measurement: at 8 m with the module's internal antenna the receiver lost the signal;
  after the external antenna was connected there were no systematic measurements.
- The "input to headphones" delay acoustically: the estimate is 13–17 ms (since 2.37 including the 1.5 ms of the limiter) for "highest", ~20, 30–35 and 40–50 ms for
  the others.
- Receiver power consumption in operation and in sleep, battery run time.
- PCM1808 on the transmitter module. (PCM5102 on the receiver does produce sound — verified on 2026-10-08; its sound quality is still being evaluated.)
- More than two receivers at the same time.
- The cause of the rare stall of the transmitter's Wi-Fi driver (it revives itself; the details are written by the
  "black box").
- The cause of a receiver playing while the transmitter does not hear it (since 2.63 the receiver repairs itself and
  leaves a record in the log on the card — the cause is to be found from those records).
- Double packets in really crowded air (a packet is longer, but there are half as many of them).
