roman885-85/hearlink/docs/uk/commands.md

# Команди порту та налагодження

[← до головної](../../README.uk.md) · [English](../en/commands.md)

Порт USB, **115200 бод**, команда — рядок із кінцем рядка. Перша літера — команда, далі аргумент без пробілу
(`c7`, `V12`). Відповіді — українською. Приймач мовчить у порт, доки з порту нічого не прийшло; після першої
команди друкує звіт щосекунди.

> **Набір 4.x.** Вивід 43 (TXD) передавача тепер завжди — порт і провід команд мосту: передавач друкує в порт за
> будь-якого входу. (У 3.x, поки в ефірі був PCM1808 прямо на передавачі, порт мовчав — такт АЦП ішов тим самим
> виводом.) `a1` — вхід передавача з моста (I2S), `a0` — вбудований АЦП лише для налагодження.

З комп'ютера: `python3 tools/port.py ПОРТ СЕКУНД [команда …]` — надіслати команди й показати відповіді;
`python3 tools/txlog.py ПОРТ СЕКУНД [секунда:команда …]` — записати весь друк із позначками часу й надіслати
команди в призначені секунди.

## Загальні

| Команда | Дія |
|---|---|
| `?` | усі налаштування, версія, причина останнього запуску |
| `t` / `r` | зробити плату передавачем / приймачем (перезапуск) |
| `b0` / `b1` | плата: звичайна ESP32-S3 / модуль ESP32-4848S040 (перезапуск) |
| `k<0–255>` | номер набору |
| `c<1–13>` | канал; `c0` — приймач шукає канал сам |
| `L0` / `L1` | мова написів: українська / English |
| `K` | захист: чи є ключ набору, лічильники відкинутих пакетів; `K0` — забути ключ |
| `B` | самоперевірка шифру й вимір його часу |
| `u` | перевірка екрана, ручки, сенсора, картки |
| `x<0–3>` | налагодження: апаратний AES «вхолосту» додатково до робочого |

## Передавач

| Команда | Дія |
|---|---|
| `v<швидкість>` | 0.5 1 2 5.5 11 6 9 12 18 24 36 48 54 Мбіт/с; `v0` — сама. З 2.78 вибрана вручну — верхня сходинка: заради слабкого приймача передавач сходить на 1 Мбіт/с сам (якщо «Слабкий сигнал: знижую») |
| `Ql2` / `Ql3` | налаштування «Слабкий сигнал»: не знижувати / знижувати швидкість заради слабкого приймача (запам'ятовується, як з екрана; з 2.83) |
| `Ql0` / `Ql1` | нижню сходинку швидкості тимчасово заборонити / дозволити — для вимірів на заданій швидкості (не запам'ятовується) |
| `Qc0` / `Qc1` | новий кодек дальнього режиму заборонити / дозволити — порівняти на слух із колишнім стисненням (не запам'ятовується; з 2.79) |
| `Qr0` / `Qr1` / `Qr2` | різниця каналів «найвищої» в стерео: 4-бітна, як до 2.86 (порівняти на слух) / без стиснення, коли всі приймачі списку мають 2.87+ (так і стоїть) / завжди (дослід). Не запам'ятовується; `?` каже, яка зараз іде |
| `p<2–20>` | потужність, дБм |
| `q<0–3>` | якість: 0 найвища, 1 стандартна, 2 мова, 3 дальня |
| `g<0–6>` | джерело: 0 вхід, 1 тон, 2 голос, 3 голос і музика, 4 музика, 5 музика з оголошенням, 6 перевірка каналів ліво/право |
| `y<№> <знач.>` | перевірочний звук: 1 мелодія (0 — по черзі), 2 оголошення раз на N с, 3 музика під голосом, дБ, 4 пауза між повторами голосу, 5 гучність музики, 6 гучність голосу |
| `w0` / `w1` | стерео в ефір |
| `a0` / `a1` | вхід: вбудований АЦП / PCM1808 (перезапуск) |
| `m` | тиша в ефірі (пакети йдуть, звуку немає) |
| `z1` / `z0` | замовкнути в ефірі зовсім / повернутися — перевірка сну приймачів |
| `s` | знайти вільний канал |
| `h0` / `h1` / `h2` / `h3` | відхід із зайнятого каналу: вимк. / увімк. / перейти зараз / 6 с вважати «поганими» |
| `h` / `h4` | стан м'якого переходу (з 2.83): чи йде проба, секунди з чеканням ефіру 15 мс і довше, досвід каналів, оцінки за заміром / проба найкращого за заміром каналу зараз із поверненням за хвилину (перевірка ходу) |
| `T0` / `T1` | проріджування пакетів при зайнятому ефірі |
| `A1` / `A0` | рахувати чужі передачі на своєму каналі |
| `O` | вимкнути передавач (вмикає дотик до екрана) |
| `S<назва>` | назва джерела звуку; `S` — повернути «З пульта» |
| `H` | модуль 4848: перевірка вільних виводів IO1, IO2, IO40 (25 с) |
| `D` | стан картки пам'яті |
| `Z1` / `Z0` / `Z` | запис на картку: почати / зупинити / список; `Z2`, `Z3`, `Zv<файл>` — перевірочний візерунок і його звірка |
| `F…` | файли: `Fl<тека>` список, `Fi<файл>` відомості, `Fp<файл>` в ефір, `Fs` стоп, `Fm<тека>` створити, `Fd<шлях>` видалити, `Fc<файл>\|<тека>` копіювати, `F` — що в ефірі |
| `Q` | «чорна скринька» радіо; `Q0…Q3` — до якої сходинки оживляти (лише дослід: обмеження саме знімається за 60 с або за 5 с без ефіру); `Q7 Q8 Q9 Q6` — виконати сходинку на здоровому радіо; `Q10` — удаваний «мертвий» драйвер; `Qn` — що чує радіо (рівень шуму); `Qp<біти>` — дослід із режимами радіо (1 b, 2 g, 4 n, 8 LR; `Qp15` — як звичайно). `Q` також друкує заміри: проміжки між надсиланнями, шлях одиночного пакета, час обробки кадру за етапами |
| `Y1`/`Y0`, `Y3`/`Y4`, `Y5…Y8` | досліди з виведенням кадру екрана |
| `M8` | попередження на весь екран «оновлення кабелем — екран згасне на хвилину» (25 с або до скидання плати) |
| `Qp<налаштування>=<значення>` | (модуль із екраном, з 2.83) вибір «як з екрана» без дотику — перевірка обробки; номери — `enum Param` у `txui.h` (2 — швидкість, 9 — якість, 20 — «Слабкий сигнал»). З 2.86 — лише зі знаком «=»: до того цей розбір забирав і `Qp<біти>`, і на модулі з екраном дослід із режимами радіо не працював |
| `e6=<0…3>`, `e8=<0…4>`, `e7=1` / `e7=0` | шумозаглушення входу (з 2.71–2.72): сила / чутливість / зразок шуму — запам'ятати зараз / сам у паузах |
| `e10=<0…4>`, `e11=<0…4>`, `e12=<-80…-30>`, `e13=<0…2>`; `e10` | шумовий поріг входу (з 3.17): вимкнено / у паузах −12 / −20 / −30 дБ / тиша; поріг на 3 / 6 / 9 / 12 / 15 дБ над шумом входу; ручний поріг у дБ від повної шкали (`e12=0` — знову від шуму); закриття швидко / середньо / повільно. `e10` без «=» — показати: шум входу, поріг зараз, скільки часу закрито |
| `e14=<0/1>`, `e15=<0…3>`, `e16=<0…3>`, `e17=<0…2>`; `e14` | обмежувач піків входу (з 3.18; на екрані — лист «Піки входу», з 3.24): вимкнено / увімкнено; стеля −0,5 / −1 / −2 / −3 дБ; стискання піків немає / легке / середнє / сильне; відпускання швидко / середньо / повільно. `e14` без «=» — показати: скільки обмежувач знижував, і рахунок самого АЦП з минулого показу — найбільші відліки, «на краю шкали» (справжній зріз АЦП), «перескоків через весь розмах», молодший байт слова, втрачені кадри I2S, формат даних |
| `e18=<0…2>`; `e18` | формат даних PCM1808 (з 3.19): 0 — сам (з коробки), 1 — читати як є, 2 — завжди збирати відліки наново (дані на такт раніше — FMT на 3,3 В, «ліве вирівнювання»). Не зберігається — для проби на слух |
| `e19=<мс>`, `e21=<мс>`, `e22=<мс>`; `e19`; `e20` | запис для розбору на комп'ютері (з 3.20): `e19` — сирі 32-бітні слова АЦП, щойно вхід оживе; `e21` — те саме, але вхід вмикається сам на час запису (перевірочний звук повертається сам); `e22` — те, що йде в ефір після всієї обробки (з 3.21). До 1500 мс (`e22` — не більше 1000). `e19` без «=» — що із записом; `e20` — вивантажити (`python3 tools/adcdump.py <порт> <файл.bin>`) |
| `Qd0` / `Qd1` / `Qd2` / `Qd3` | два кадри в пакеті на «найвищій»: ніколи / сам, коли всі приймачі на зв'язку вміють (так і стоїть) / завжди (дослід); з 2.77 у подвійному пакеті минулий пакет повторено без стиснення, `Qd3` — колишні стиснуті копії. Діє до перезапуску. `?` каже «ДВА кадри в пакеті» чи «один кадр у пакеті» |
| `Y9`, `Y10`/`Y11` | навмисно збити драйвер екрана з черги буферів; класти порції кадру, куди каже драйвер (як до 2.49) / по-своєму |

### Приймачі з передавача
| Команда | Дія |
|---|---|
| `P` | список приймачів із усіма показниками та налаштуваннями; з 2.73 — рядок «звук від команди P0»: скільки звуку пропало в кожного |
| `P0` | обнулити ці лічильники |
| `I` | першому на зв'язку — «покажи себе» |
| `E0` / `E1` | вимкнути / увімкнути його; `E0 <номер>` / `E1 <номер>` — саме цей приймач |
| `E2 <номер>` | перезапустити цей приймач (як кнопка «Перезапустити»; приймачі з 2.84) |
| `V<0–20>` | гучність |
| `W0` / `W1` | вихід «протифаза» / «два канали» |
| `N<ім'я>` | дати ім'я |
| `X` | перевірка виходу на слух (п'ять станів по 6 с) |
| `i<№>=<знач.>[@номер]` | налаштування: 0 чіткість 0–3, 1 баланс −5…5, 2 межа гучності 1–20, 3 вигляд 0–2, 4 світлодіод 0–3, 5 мова 0–2; `i9=1` / `i9=0` — перевірка навушників. Приклад: `i0=2@884A94` |
| `i7=<дБ 0…24>[@номер]` | цифрове підсилення приймача, як «trim» (на самому приймачі — `n10=<дБ>`); у відповіді `n7=3` — «підсилення +N дБ (зараз …)» |
| `i6=<0…3>[@номер]` | блокування ручки приймача: 0 немає, 1 меню, 2 гучність, 3 усе (на самому приймачі — `n6=<0…3>`) |
| `i16…i22=<знач.>[@номер]` | обробка звуку приймача (з 2.68 / 2.72): 16 шумозаглушення 0–3, 17 стискання 0–3, 18 у паузах 0–3, 19 чутливість до шуму 0–4, 20 поріг пауз 0–4 (+3…+15 дБ), 21 закриття пауз 0–2, 22 зразок шуму (2 — запам'ятати зараз, 0 — сам) |
| `i23`, `i24=<дБ>[@номер]`, `i25=<0/1>[@номер]` | еквалайзер приймача: смуги 2,5 кГц і 6 кГц (−12…12 дБ) і зріз низів; стан і рівень до/після — у відповіді `n7=3`. **Відома помилка 2.72–2.85:** номери `i20…i22` зайняті обробкою, тож смуги 125 Гц, 400 Гц і 1 кГц з порту не задаються (з екрана передавача — задаються) |
| `e`, `e<0…4>=<дБ>`, `e5=<0/1>` | еквалайзер входу передавача: показати / смуга / зріз низів; `e9=1` — проба: діяти й на тон 1 кГц (для виміру) |
| `a0` / `a1` / `a2` | вхід: вбудований / PCM1808 / проба — PCM1808 на один запуск без головного такту (порт працює; звичайно з PCM1808 передавач у порт не друкує: такт іде виводом TXD) |
| `J` / `J1` / `J0` | запити на доступ / відкрити вікно додавання на 3 хв / закрити |
| `j<№>` | дозволити доступ приймачу зі списку запитів |
| `R<номер>` | видалити приймач із набору (`R4C3B10`) |
| `M` / `M1` / `M0` | оновлення приймачів по радіо: стан / почати / скасувати |
| `M6` / `M7` | автооновлення приймачів зі старішою прошивкою: увімкнути (так з коробки) / вимкнути |
| `M2` / `M3` / `M4` / `M5` / `M9` | оновити все з картки / переглянути теку `UPDATE` / пробне / дозволити старішу версію / примусовий прохід |

### Екран передавача без рук
| Команда | Дія |
|---|---|
| `U<0–5>`, `U9` | відкрити вкладку (0 головна … 5 довідка), 9 — картку |
| `Ut<№>` | «натиснути» кнопку з цим номером |
| `Ux<x>,<y>,<мс>` | дотик у точці; серія: `Ux<пауза>:<x>,<y>,<мс>;<x>,<y>,<мс>;…` |
| `Uk`, `Uq` | що набрано на клавіатурі / що на екрані картки |
| `ud` | друкувати кожен дотик сенсора |

### Міст із передавача (4.x)

| Команда | Дія |
|---|---|
| `C` | стан моста: що обрано й що звучить, AES (частота, помилки), кадри стану, версія й CRC програми моста, хід оновлення |
| `C1` / `C2` / `C7` | вхід моста: цифровий (AES/S/PDIF) / аналоговий (PCM1808) / USB (комп'ютер) — як кнопки на екрані |
| `C3` … `C6` | перевірочний сигнал моста замість входу через увесь шлях: `C3` вимкнути, `C4` тон 1 кГц −12 дБ, `C5` рожевий шум −20 дБ, `C6` розгортка 20 Гц → 16 кГц |
| `C8` | журнал моста (до 512 записів) |
| `C9` | оновити програму моста зараз (звичайно передавач робить це сам, коли CRC не збігається) |
| `C10` / `C11` | аналоговий вхід: стерео / симетричний (моно з різниці каналів) |
| `C12` / `C13` | гул радіо на аналоговому вході: прибирати / не прибирати |
| `q0` … `q4` | якість звуку: найвища / стандартна / мова / дальня / **монітор** (48 кГц, 24 біти; лише з моста) |
| `H` | модуль 4848S040: перевірка виводів IO1, IO2, IO40 (25 с: торкатися дротом від GND — передавач назве вивід) |

## Міст

Порт USB самого моста (Pi Pico), друк — щосекундний рядок стану. Команда — **одна буква без кінця рядка**
(`HL_DTR=1 HL_NOLF=1 python3 tools/timedcmd.py ПОРТ СЕКУНД файл 1:c`). Вибір входу з порту тримається хвилину,
потім міст знову слухає передавач.

| Буква | Дія |
|---|---|
| `?` або `h` | перелік букв і версія |
| `a` / `p` / `w` / `u` / `m` | вхід: AES / PCM1808 / USB / як велить передавач / тиша |
| `t` | перевірочний сигнал по колу (тон, рожевий шум, розгортка) |
| `d` | аналоговий вхід симетричний ↔ стерео (до перезапуску) |
| `r` | гул радіо: прибирати ↔ ні — навпаки до передавача (до перезапуску) |
| `c` | одночасний знімок обох входів: 1024 сирі кадри AES і PCM1808 з одного моменту (рядки `@@CAP…`) |
| `g` | що на вході AES: 1 мс опитування виводу 15 |
| `k` | чи живі виводи: такти й дані PCM1808, такти передавача, AES |
| `j` | журнал моста |
| `l` | у завантажувач (чекає програму від передавача) |
| `b` | у режим запису USB без диска (для picotool) |

## Приймач

| Команда | Дія |
|---|---|
| `d<0\|4–40>` | запас, мс (0 — сам) |
| `l<0–20>` | гучність |
| `m` | тиша |
| `o0` / `o1` / `o2` | вихід: PDM / PCM5102 / CS4344 (перезапуск; `o2` — з 2.85) |
| `w0` / `w1` | виводи: протифаза / два канали |
| `n` | налаштування «для слуху»: чіткість, баланс, межа, вигляд, світлодіод, мова |
| `n<№>=<знач.>` | змінити (номери як у `i`) |
| `n9=1` / `n9=0` | перевірка навушників |
| `n7=1` / `n7=2` / `n7=3` | відкрити меню / екран «Зв'язок» / головний екран |
| `n11=1` / `n11=2` / `n11=0` | перевірка сумісності без старої прошивки: не розуміти подвійних пакетів / ще й називатися версією 2.56 (передавач повернеться до одиночних пакетів) / як є. До перезапуску |
| `n12=1…4` / `n12=0` | перевірка самолікування радіо приймача без справжньої несправності: 1 — драйвер «узяв пакет і мовчить»; 2 — пакети «йдуть у нікуди» (до перезавантаження радіо); 3 — те саме до перезапуску плати; 4 — і після перезапуску; 0 — вимкнути |
| `Y2` | (з 2.93) вільний час обох ядер за секунду, умовні одиниці: більше — вільніше. Друге ядро приймача — звук і екран |
| `Y12` / `Y13` | (з 2.93) кадр на екран іде з пріоритетом екрана, як до 2.93 (порівняти) / вище за звук (так і стоїть). До перезапуску; частоту кадрів показує звіт при `G1` — «екран: N кадрів за секунду, малювання …, передача кадру …» |
| `Y15` | (з 2.94) ступені тракту звуку, мкс на блок 1 мс від минулого такого виклику: усього й найдовший блок (з 3.12 — на початку рядка: по радіо довгий рядок обрізається), до підгонки темпу (запас, темп, налаштування, гучність), підгонка темпу, шумозаглушення, обробка й вихід, решта. Понад ~900 мкс у середньому — ядру звуку тісно |
| `n14` | (з 3.03; з 3.13 — лише довідка) який екран зараз: тип вибирає перемичка — вивід 21 на GND — кольоровий, вільний — OLED |
| `n15=1…5` | (з 3.03) яскравість: підсвітка кольорового екрана або контраст OLED (як пункт меню «Яскравість») |
| `n27=<сума бітів>` | (з 3.03) властивості кольорового модуля, перезапуск: 1 — повернутий на 180°, 2 — кольори BGR, 4 — шина 80 МГц, 8 — 40 МГц (як до 3.11; без 4 і 8 — 20 МГц), 16 — сильні виходи шини (як до 3.11; без нього — найслабші) |
| `Y17` / `Y18` | (з 3.12) OLED: рядок стану головного екрана щокадру наново (як до 3.12) / із запасу — малюється, лише коли в ньому щось змінилося (так і стоїть). Порівняти «малювання» у звіті екрана |
| `Y19` / `Y20` / `Y21` | (з 3.12) розбір спектра своїм БПФ (як до 3.12) / бібліотекою esp-dsp (так і стоїть; у 5,4 раза швидше) / обидва на одній копії вікна звуку: рівні смуг, найбільша різниця в дБ і час кожного |
| `Y22` | (з 3.10) кольоровий екран: перевірка завад від шини — 7 фаз по 5 с (екран стоїть / шина без упину з різною силою виходів); у кожній — шум радіо, «ефір зайнятий», втрати пакетів; підсумок — таблицею у звіті |
| `Y23[=0…3]` | (з 3.11) кольоровий екран: 8 с кадр цілком без упину — послухати наведення в навушниках; сила виходів шини на цей час (без числа — за налаштуванням) |
| `Y16` | (з 2.98) згортка підгонки темпу окремо: тактів на виклик (3.02 — 648) |
| `Y14` | час ядер по задачах за 2 с — лише у збірці з `#define HL_TASK_LOAD` (функції FreeRTOS займають 600 байт швидкої пам'яті, у передавача їх нема звідки взяти) |

У звіті `?` приймача (з 2.63) — два рядки про його радіо: скільки пакетів надіслано й на скільки драйвер
відповів, найдовше чекання відповіді, скільки разів радіо перезавантажувалось (не відповідало + передавач не чув) і
чи чує приймач передавач: «передавач мене чує: ТАК / НІ / невідомо».

### Ручка без рук
Вивід сам замикається на «землю» — рівно те, що робить кнопка чи контакт енкодера.

| Команда | Дія |
|---|---|
| `n8=1` | налаштування виводу кнопки (вид переривання, чи дозволене, чи будить зі сну) і лічильники сну |
| `n8=<мс>` (від 50) | натиснути на стільки мілісекунд: 300 — натискання, 1000 — довге (відкриє меню) |
| `n8=3` / `n8=4` | повернути на один клац в один і в другий бік |
| `n8=5` | натиснути на секунду, не затримуючи головний цикл |
| `n8=6` | те саме через 30 с — перевірка пробудження зі сну (уві сні порт не слухає) |
| `n8=7` | що на виводах виходу звуку: частка одиниць і перепади на 10 (SCK), 11 (BCK), 12 (LRCK), 13 (дані), 17, 18 (PDM); рівень XSMT (вивід 14); з CS4344 (2.85) — ще й дільник головного такту (ціле чи з дробом), частоту виходу і чи не на «землі» вивід 10 |
| `n8=9` | «логічний аналізатор»: знімає BCK, LRCK і дані з виводів (ЦАП на цей час приглушено, на вихід ідуть відомі числа 0x5A01 / 0xA5F3) і друкує біти одного слова — видно формат і зсув |
| `n8=8` | справжні частоти за час від попереднього такого виклику: звук з ефіру (годинник передавача) і вихід (свій годинник), у відліках за секунду та ppm |
| `n8=2` | лишити вивід «брудним», як після сну в старих версіях (перевірка очищення при запуску) |
| `n8=11` / `n8=12` / `n8=13` / `n8=14` | перевірка самовідновлення звуку (з 2.84): «не число» на вхід обробки / у пам'ять еквалайзера / тримати вихід на одному числі (сторож мусить скинути обробку, потім перезапустити плату) / зняти |

## Налагодження по радіо
На передавачі: «Налашт.» → «Налагодження ефіром» або `G1` (вимкнути — `G0`). Після цього рядки порту приймачів
видно в порту передавача з номером: `[884A94] ПРИЙМАЧ к=7 …`. Команда іншому пристрою набору:

```
@884A94 ?        приймачу з цим номером
@tx u            передавачу (з порту приймача)
@* ?             усім
```

Пакети налагодження закриті ключем набору; команда чинна лише свіжа.

## Щосекундний звіт

Передавач:
```
ПЕРЕДАВАЧ к=7 шв=5.5 як=найвища набір 1 | пакетів 500, відмов 0, не пішло в ефір 0, перезапусків радіо 0,
до ефіру сер. 1600 макс. 6300 мкс | …
```
- *відмов* — драйвер не взяв пакет (черга повна); *до ефіру* — скільки пакет чекав вільного ефіру: середнє понад
  ~10 мс або максимум понад ~60 мс — ефір зайнятий.

Приймач:
```
ПРИЙМАЧ к=7 набір 1 | кадрів 500, відновлено 0, втрачено 0, порожньо 0.0 мс, зсувів 0, перезапусків 0, з копій 0 |
запас 10.6 мс (9.0…12.1, ціль 10.6 сам), темп +68 ppm | сигнал -37 дБм | рівень -11.5 дБ …
екран: 62 кадрів за секунду, передача кадру сер. 2.7 мс, найдовша 6.7 мс, обмін 800 кГц
```
- *відновлено* — кадри, взяті із запасних копій; *втрачено* — не відновлені (чути як коротку тишу);
  *порожньо* — скільки мілісекунд запас був порожній; *зсувів* — запас переповнився й був скинутий;
  *перезапусків* — приймання починалося заново; *з копій* — навмисне проріджування передавача (не втрати);
  *темп* — наскільки приймач підганяє свій хід під передавач.

## Інструменти вимірювань (`tools/`)

| Інструмент | Що робить |
|---|---|
| `port.py` | порт: надіслати команди, показати відповіді |
| `txlog.py` | весь друк плати у файл із часом + команди за розкладом |
| `watch.py`, `watch2.py` | передавач (і приймач) поруч: підсумок за N секунд — очікування ефіру, відмови, провали |
| `duo.py`, `trio.py`, `kwatch.py` | виміри з двох-трьох боків, перевірка зміни ключа |
| `sleeptest.py` | сон і пробудження приймачів за розкладом команд: `sleeptest.py ПОРТ 4:z1 26:z0 конец:42` |
| `stallrun.sh` | прогін «чи стає радіо передавача»: рядок на хвилину — час роботи, вхід, один чи два кадри в пакеті, зупинки радіо, час обробки кадру: `caffeinate -i tools/stallrun.sh ПОРТ <a0\|a1\|-> <Qd0\|Qd1\|-> ХВИЛИН` |
| `getlogs.py`, `logstat.py` | зняти журнали `/LOG/` з картки через порт і порахувати зупинки радіо та зв'язок приймачів |
| `qsweep.py` | порівняння якостей і швидкостей: `qsweep.py ПОРТ СЕКУНД якість:швидкість[:потужність] …` |
| `sweep.py`, `hoptest.py` | порівняння каналів, перевірка переходу на канал |
| `fliptest.py`, `idletest.py` | плавність перегортання сторінок і спокій екрана передавача |
| `sendfile.py` | покласти файл на картку передавача через порт |
| `langtest.py` | перевірка перекладу |
| `linktest/` | окрема прошивка перевірки радіоканалу на «голих» платах |
