roman885-85/hearlink/docs/uk/technical.md

# Як це влаштовано: повний технічний опис

[← до головної](../../README.uk.md) · [English](../en/technical.md)

Зміст: [загальна схема](#загальна-схема) · [передавач](#передавач) · [приймач](#приймач) · [радіо](#радіо) ·
[пакет і звук](#пакет-і-звук) · [зворотний зв'язок](#зворотний-звязок-і-команди) · [захист](#захист) ·
[оновлення](#оновлення-прошивки) · [пам'ять](#память-плати) · [файли прошивки](#файли-прошивки) ·
[особливості й граблі](#особливості-й-граблі) · [що не перевірено](#що-не-перевірено)

## Загальна схема

```
пульт ──лінійний вихід──► [передавач: АЦП → кадри → (стиснення) → шифр+підпис] ══ ESP-NOW, 2,4 ГГц ══►
      ══► [приймач: перевірка підпису → розшифрування → відновлення втрат → запас → підстроювання темпу →
           чіткість → гучність → обмежувач → баланс → однобітний вихід] ──► навушники
приймач ──(раз на 2 с: відомості про себе)──► передавач ──(команди)──► приймач
```

- Один передавач мовить **широкомовно**; приймачів може бути скільки завгодно, у списку передавача — до 16.
- Процесор усюди ESP32-S3 (два ядра, 240 МГц, апаратний AES), 16 МБ флеш, 8 МБ PSRAM.
- Частота звуку 32 000 відліків за секунду, 16 біт. Звук ріжеться на шматки по 64 відліки (2 мс).
- Версія протоколу — 4 (`PROTO_VER`); пакети з іншою версією відкидаються.

## Міст (4.x)

Плата Raspberry Pi Pico (RP2040, 200 МГц) між пультом і передавачем; вихідні тексти — `bridge/`.

- **Входи.** AES/EBU або S/PDIF — вивід GP15, бібліотека `pico_spdif_rx` (PIO0), 44,1 / 48 кГц, 24 біти. PCM1808 — міст
  веде всі три такти цілими дільниками від 200 МГц: MCLK 12,5 МГц (ШІМ), BCK 3,125 МГц, LRCK 48 828 Гц (256 fs), PIO1;
  формат I2S (FMT на землі) міст розпізнає сам (дані на біт пізніше, лівий канал — при LRCK = 0). USB — звукова карта
  USB Audio Class 2 (48 кГц, 16 біт) і запис «Що йде в ефір» (32 кГц).
- **Перерахунок частоти** (`asrc.c`): з частоти входу в такт передавача — 32 кГц (64 відводи) або 48 кГц у
  «Моніторі» (32 відводи); зріз min(0,48·fвих, 0,458·fвх); 24-бітні відліки множаться двома 32-бітними множеннями
  (старші 16 і молодший байт). Регулятор тримає запас 16–24 кадри; затримка моста ~1–1,6 мс.
- **Гул радіо** (`hum.h`): після перерахунку гул від пакетів передавача повторюється рівно в такт його кадрам; шаблон
  16 мс вчиться з вагою E0/(E0+E) за енергією циклу (E0 = −76 дБ) — музика в шаблон не потрапляє — і віднімається.
- **Зв'язок із передавачем.** Міст — ведений I2S: такти BCK/LRCK дає передавач (IO1, IO2), звук іде на IO40; у
  бітах 7…4 кожного слова — кадри стану моста (COBS + CRC). Команди — UART 115 200 з виводу 43 передавача (BP_SET раз
  на секунду: вхід, симетричний режим, гул, 48 кГц, перевірочний сигнал).
- **Оновлення.** У флеші моста — завантажувач (28 КБ, не переписується) і програма; передавач везе образ програми
  у своїй прошивці (`hearlink/bridge_fw.h`) і, якщо CRC моста інший, переводить його в завантажувач і пише програму
  по UART (~15 с). Збій посеред запису — міст лишається в завантажувачі й чекає наступної спроби.

## Передавач

### Будова
Модуль ESP32-4848S040: ESP32-S3-WROOM-1U, екран 480×480 з паралельною шиною RGB (контролер ST7701), сенсор GT911
(I2C), картка microSD (SPI), міст USB CH340, реле й підсилювач динаміка (не використовуються).

### Шлях звуку
1. **Вхід.** Вбудований АЦП у безперервному режимі знімає 64 000 відліків за секунду; пари складаються — виходить
   32 000 (це й невеликий виграш у шумі). Темп усього набору задає саме вхід. Зовнішній PCM1808 — по I2S, стерео;
   формат даних передавач розпізнає сам (з 3.19, див. «Що змінилось у 3.17–3.27»), черга I2S — 8 кадрів по 2 мс.
2. **Обробка входу** (лише звук із пульта): еквалайзер (зріз низів і п'ять смуг), **підсилення** (−12…+24 дБ),
   **обмежувач піків** (з 3.18), шумозаглушення (окрема задача на ядрі екрана, з 3.23 — із запасом 2 кадри),
   вимірювання рівня, піку та перевантаження (край шкали АЦП → прапорець `FLAG_CLIP` у пакеті → приймач показує
   «Гучно на вході!»), шумовий поріг (з 3.17).
3. **Джерело**: вхід, перевірочний звук із розділу `assets` (голос — без стиснення, мелодії — MP3, які на льоту
   розбирає окрема задача із запасом на секунду в PSRAM) або файл із картки.
4. **Кадр**: 1, 2, 4 або 6 шматків залежно від якості. Для 16 кГц — півсмуговий фільтр і проріджування вдвічі
   (рівно до 6 кГц, −3 дБ на 7,5 кГц, −35 дБ на 10 кГц).
5. **Стиснення** IMA ADPCM (4 біти на відлік) з підбором початкового кроку: кодер пробує кілька кроків і бере той,
   з яким кадр виходить точніше (на різких початках звуку це знижує просочування каналів із −9 до −38 дБ).
   «Найвища» якість іде без стиснення.
6. **Пакет**: заголовок + поточний кадр + 1–2 попередні кадри (запасні копії) → шифрування й підпис → ESP-NOW.

### Задачі (FreeRTOS)
| Задача | Ядро | Пріоритет | Що робить |
|---|---|---|---|
| `tx` | 0 | 20 | вхід → кадри → пакети; команди приймачам; оголошення переходу на канал |
| Wi-Fi (ядро ESP-IDF) | 0 | 23 | радіо |
| `mp3` | 1 | 1…3 | розбір MP3: пріоритет 1, поки запас більший за 3/4, і 3, коли менший за 45 % |
| `ui` | 1 | 2 | екран і сенсор |
| `rec` (картка) | 1 | 1 | запис WAV, файловий менеджер, перегляд теки `UPDATE` — з карткою працює лише вона |
| `touch` | 1 | 4 | опитування сенсора, черга дотиків |
| `scan` | 1 | 3 | вимірювання зайнятості каналів (на час пошуку) |
| `ota` | 0 | 19 | роздавання прошивки приймачам (на час оновлення) |
| головний цикл | 1 | 1 | порт, звіти, збереження налаштувань, сторожі радіо й АЦП |

### Екран
- Малювання йде не на екран, а в «тіньовий» аркуш у пам'яті; у кінці кадру на екран переноситься лише змінений
  прямокутник — проміжних станів не видно.
- Виведення кадру на панель RGB — власне: порціями по 10 рядків через проміжний буфер із попереднім
  підвантаженням у кеш. Будь-яке читання флеш через `esp_partition_read` на частки мілісекунди вимикає кеш на обох
  ядрах, і картинка смикається — тому розділ звуків **відображено в пам'ять** (`mmap`).
- Буфер для кожної порції прошивка вибирає сама: порція № s завжди йде з буфера s % 2 (видача в кожному кадрі
  починається з буфера 0). Драйвер ESP-IDF 5.5.1 вибирає буфер за парністю лічильника переривань, якого за
  `CONFIG_LCD_RGB_RESTART_IN_VSYNC` ніколи не скидає: одне злиття двох переривань — і картинка зірвана до перезапуску
  (у новішому ESP-IDF виправлено). Лічильник таких збоїв — у звіті `u`.
- Під час запису прошивки самого передавача кеш вимикається надовго — тому запис іде колами: підсвітку погасили →
  1,7 с запису → підсвітку ввімкнули на 1,5 с. Про блимання екран попереджає заздалегідь.
- **Радіо передавача і вбудований АЦП.** Драйвер Wi-Fi (ESP-IDF 5.5.1) часом перестає передавати: кадри лишаються в
  нього назавжди, приймання працює, `esp_wifi_stop/start` не допомагає, допомагає лише `esp_wifi_deinit/init` (буфери
  завислих кадрів при цьому губляться — близько 0,4 КБ на кадр). Трапляється це тільки з вбудованим АЦП у
  безперервному режимі: дослід на одній збірці — 4–7 зупинок за 8 хв з АЦП і 0 зі входом I2S; з АЦП кожен пакет іде
  в ефір на 0,5 мс довше. Сторож (`radioSend` у `radio.h`): 200 мс без відповіді драйвера при пакетах у черзі →
  повне перезавантаження драйвера (16 мс); мало пам'яті → перезапуск плати.
  З 2.63 головні ліки — **два кадри в пакеті** (нижче): на тій самій збірці з вбудованим АЦП одиночні пакети дали
  7 зупинок за 3 хв, подвійні — жодної за 14 хв. Новіше ядро (ESP-IDF 5.5.5, з 2.63) зупиняється в найгіршому
  режимі разів у п'ять рідше, але зупиняється; причину всередині драйвера не знайдено.
- **Вивід 43: такт PCM1808 або порт.** Такт I2S усередині йде завжди; на вивід він підключається (`txMclkPin` у
  `txaudio.h`) лише коли в ефірі сам вхід, інакше вивід віддано UART.
- **Бюджет часу ядра радіо.** Кадр «найвищої» якості — 2 мс. До 2.63 задача передачі витрачала на кадр 1,4 мс зі
  звуком із входу й 1,85 мс із перевірочною музикою, з них 0,7–0,78 мс — сам виклик `esp_now_send` (код Wi-Fi
  виконується з флеш-пам'яті через малий кеш), і коштує цей виклик однаково за будь-якої довжини пакета. З 2.63
  два кадри йдуть одним пакетом: викликів удвічі менше, на кадр — близько 1,1–1,2 мс (етап «радіо» 0,33–0,38 мс).
  Команда `Q` друкує розклад за етапами. За перевантаження задача сама віддає ядро, щоб сторож задач не
  перезапустив плату.
- Перегортання сторінок — зсув за 284 мс (12 кроків); на цей час розбір MP3 призупиняється.

### Радіо передавача: живучість
- **Пошук вільного каналу**: 2 с тиші, по 150 мс на кожен із 13 каналів, рахується частка зайнятого часу з
  урахуванням сусідніх каналів.
- **Затор**: секунда «погана», якщо пакети чекали ефіру довго або драйвер відмовляв. П'ять поганих із восьми —
  перехід; якщо зайнятість уже відома — без паузи (оголошення `CMD_HOP` усім приймачам: «з пакета N я на каналі C»),
  інакше — з пошуком. На новий канал переходить, лише якщо там вільніше щонайменше на третину.
- **Проріджування**: коли черга драйвера росте, передавач навмисно пропускає пакети (`FLAG_THIN`); їхні кадри
  приймач бере із запасних копій — це не втрати.
- **Оживлення радіо**: якщо драйвер перестає відповідати на відправлення (всі 32 буфери зайняті, помилка
  `ESP_ERR_ESPNOW_NO_MEM`), передавач оживляє його сходинками: перезапуск ESP-NOW → перезапуск Wi-Fi → швидкий
  перезапуск плати без заставки. «Чорна скринька» (`bbox.h`) пам'ятає 40 останніх подій (канал, запис налаштувань,
  картка, повідомлення) і в мить першої відмови робить зліпок — друкує в порт («# РАДІО СТАЛО…»), пише в `/LOG/`
  на картці й переносить через перезапуск у пам'яті годинника. Причину такої зупинки поки не знайдено.

## Приймач

### Будова
Плата ESP32-S3-DevKitC-1 N16R8; екран SH1106 (I2C 800 кГц, якщо екран тягне, інакше 400), енкодер EC11, кольоровий
світлодіод WS2812 на платі. Вихід звуку — однобітний (PDM) на двох виводах через прості RC-фільтри або зовнішній ЦАП:
PCM5102 (I2S 32 кГц, без головного такту — ЦАП бере його з BCK) чи CS4344 (з 2.85: I2S 31,25 кГц, головний такт 8 МГц
на виводі 10 — ціле ділення 160 МГц / 20; такт бітів 2 МГц, слово каналу 32 такти). Чому не 32 кГц — див. hardware.md,
«Зовнішній ЦАП CS4344».

### Шлях звуку
1. **Приймання** (задача Wi-Fi): свій набір і версія → перевірка підпису → захист від повторів → розшифрування.
2. **Відновлення**: номер пакета показує, скільки кадрів пропало. Один-два останні беруться із запасних копій
   наступного пакета; решта замінюється плавним спадом до тиші, а перший кадр після тиші входить плавно (2–4 мс).
3. **16 → 32 кГц** тим самим півсмуговим фільтром (затримка 0,72 мс).
4. **Запас** — кільце на 256 мс; звук починає грати, коли набралося заданих мілісекунд. Режим «сам»: запас =
   найглибше просідання за останню хвилину + 4 мс; після провалу одразу росте на довжину провалу. Межі залежать
   від довжини кадру: від 4 + кадр/2 до 26 + 2·кадр мс.
5. **Підстроювання темпу**: кварци двох плат ідуть по-різному, тому приймач грає на частки відсотка швидше чи
   повільніше, утримуючи запас (перерахунок — таблиця sinc із вікном Кайзера, з 2.44; з 2.86 — 48 відліків × 128 фаз і зріз
   на 15 кГц: до 15 кГц похибка не більша за −77 дБ, верх вище 14 кГц плавно спадає, −5,6 дБ на 15 кГц). Не більше ±0,3 % — інакше на музиці чути «плавання» висоти.
   З CS4344 (2.85) той самий перерахунок ще й переводить 32 кГц ефіру на 31,25 кГц виходу: крок по входу на відлік
   виходу — 1,024 × (1 ± підстроювання).
6. **Чіткість мови**: фільтр-«полиця» (+12 дБ вище 2 кГц) і суміш «звук + його піднята копія» у частці 0,196 /
   0,507 / 1 — це +4 / +8 / +12 дБ. «Сильна»: 1 кГц +0,9 дБ, 2 кГц +6,0, 3 кГц +9,8, 4 кГц +11,2, 8 кГц +12,0.
7. **Гучність**: 21 крок по 2 дБ; крок 20 (100 %) — звук як є, нижче — тихіше (крок 1 — на 38 дБ). Підсилення
   понад «як є» немає (з 2.40) — так само, як у звичайному програвачі чи радіо. До 2.40 «як є» був крок 12 (60 %),
   а вище йшло підсилення до +16 дБ з обмежувачем: на музиці, записаній на всю шкалу, вище 60 % обмежувач працював
   майже весь час (85 % гучності — 84 % часу, до −10,8 дБ), і звук «завалювався» на кожному басі. Тихе джерело
   підсилюють на передавачі: «Звук» → «Підсилення входу». Змінюється плавно. Після оновлення з давнішої версії
   збережена гучність і її межа один раз перераховуються (+8 кроків, не вище 100 %), щоб звучало як раніше.
   Окремо є **«Підсилення»** (0…+24 дБ кроком 2, з 2.48). З 2.63 це просте множення після гучності («trim»): усе,
   що після нього не вміщується в шкалу, притримує обмежувач (наступний пункт). У 2.48–2.56 підсилення йшло
   «з притримкою» — лише в запас, що лишався до повної шкали: на гучності 100 % з музикою на всю шкалу з +14 дБ
   діяло +0,2 дБ, і це сприймалось як «настройка не працює».
8. **Обмежувач** із заглядуванням уперед (з 2.37) — спільний для обох каналів. Звук іде через затримку 3 мс
   (96 відліків; до 2.86 — 1,5 мс), а підсилення рахується за найбільшим відліком у цьому вікні: воно опускається ще
   ДО піка — з 2.86 середнім за все вікно, тобто рівно до потрібного на мить піка й без виходу за шкалу, — і повільно
   (чверть секунди; зі стисканням — 40 мс) повертається. Коли обмежувати нема чого, звук проходить без змін. З 2.40 поріг —
   повна шкала, тож без «Чіткості» й «Підсилення» обмежувач не працює взагалі (однобітний вихід, як і раніше, отримує не більше
   30 000 з 32 767). Попередній
   обмежувач (миттєва атака, відпускання 80 мс) зрізав верхівку піка й «гуляв» усередині періоду баса на 1–2 дБ —
   із ЦАП це було чути як перевантаження на низах, особливо з увімкненою «Чіткістю».
9. **Баланс** — ослаблення одного каналу по 3 дБ на крок.
10. **Вихід**: PDM 32 кГц на виводах 17/18 (16 біт, з 2.86 — з округленням, а не відкиданням дробу) або I2S на
    зовнішній ЦАП — з 2.86 **24 біти у 32-бітному слові** (до 2.86 — 16 біт: гучність приймача цифрова, і на 2 з 20
    від звуку лишалося 10 розрядів). Після ввімкнення виводи PDM піднімаються до середини за 0,7 с, перед сном за 0,5 с
    опускаються до «землі» — щоб конденсатори не клацали в навушниках.

### Стани
```
ПОШУК (заставка 4 с, чекає до 10 с) ─сигнал─► ЗАПУСК (4,4 с; звук із 1,5 с) ─► РОБОТА
РОБОТА ─10 с без сигналу─► ВІДХІД (6 с повідомлення) ─► ОЧІКУВАННЯ (сон)
ОЧІКУВАННЯ ─почув передавач─► ПРОБУДЖЕННЯ (заставка) ─► ЗАПУСК   (до 3.14 будило й натискання ручки)
будь-який ─«вимкнути» з передавача─► ВІДХІД ─► ОЧІКУВАННЯ (будить лише «увімкнути» з передавача; до 2.65 — ще й подвійне натискання ручки)
```
Ручка діє лише в роботі й лише поки є сигнал (пакети не старші 0,5 с; з 3.14): без сигналу, у пошуку, уві сні й коли
приймач вимкнено з передавача вона не робить нічого, відкрите меню без сигналу закривається. Службовий вихід для
вимкненого приймача, чий передавач зник, лишився: ручку тримають 10 с, і за цей час передавача не чути — набір
забувається, приймач просить доступ заново.

Коло сну: радіо вимкнено, легкий сон процесора 0,5 с (будить таймер; до 3.14 — ще й кнопка ручки), потім 70 мс слухання свого
каналу; кожне четверте коло — ще 12 каналів по 25 мс. Якщо передавач чутно — раз на ~2 с приймач повідомляє «сплю»
й 80 мс чекає команди у відповідь.

### Радіо приймача: живучість (з 2.63)
Приймач передає мало — раз на дві секунди два короткі пакети про себе, — але й у нього передавальна частина
драйвера Wi-Fi може стати, тоді як приймання працює: звук іде, команди виконуються, а передавач такого приймача
«не бачить» (двічі за добу 09–10.10.2026, лікувалося лише перезапуском приймача). До 2.63 приймач за своїми
надсиланнями не стежив зовсім. Тепер:
- **Сторож надсилань** (`rxSend`, `rxTxWatchTick` у `radio.h`). Кожне надсилання рахується, приймач чекає
  відповіді драйвера «пакет пішов». Пакет у драйвера без відповіді довше 0,5 с (або чотири відмови поспіль) —
  драйвер Wi-Fi перезавантажується повністю (20–30 мс без приймання, 16–24 мс звуку з копій чи тиші).
- **Канал не міняється під власним пакетом.** Пошук каналу, поправка «сусіднього каналу», перехід услід за
  передавачем і коло сну чекають, поки свій пакет піде (перехід — не довше 12 мс). Другий пакет відомостей іде
  лише після відповіді драйвера на перший; відомості не шлються, коли оголошено перехід і коли передавача не чути
  довше 0,4 с.
- **Звірка зі списком «кого чую»** (`TxSeen`, нижче; `rxSeenTick` у `rxlink.h`) — ловить і те, чого сторож не
  бачить. Передавач чутно, він оголошує, кого чує, приймач чотири рази повідомив про себе — а в списку його немає
  12 с: перезавантажити радіо; ще 12 с — один раз перезапустити плату без заставки (близько секунди без звуку).
  Якщо не чують і після цього — справа не в приймачі (наприклад, передавач далі, ніж дістає приймач): перезапусків
  більше немає, лишаються рідкі перезавантаження радіо (через 1, 2, 4, 8 і далі по 10 хв). Усе забувається, коли
  приймач чують десять хвилин поспіль. Якщо список приймачів у передавача повний — приймач нічого не робить.
- **Про кожен такий випадок приймач повідомляє передавачеві** рядком (вид «подія» налагодження по радіо, іде
  завжди): передавач друкує його в порт і дописує в журнал на картці — `# [4C3B10] приймач: радіо не відповідало…`.
- Перевірка без справжньої несправності — команда порту приймача `n12` (див. [команди](commands.md)).

### Задачі
| Задача | Ядро | Пріоритет | Що робить |
|---|---|---|---|
| `rx` | 1 | 20 | вихід звуку, блоками по 1 мс |
| Wi-Fi | 0 | 23 | приймання пакетів |
| `ui` | 0 (до 2.96 — 1) | 2 (на час передачі кадру — 21) | екран 60 кадрів/с, ручка, меню |
| `led` | 0 | 3 | світлодіод 200 разів/с (плавне «дихання» тремтінням між сусідніми рівнями) |
| таймер `knob` (esp_timer) | 0 | — | (з 3.09) кнопка ручки раз на 5 мс: захист від брязкоту — 4 однакові відліки, натискання й відпускання рахуються лічильниками, тож не губляться й між повільними кадрами |
| головний цикл | 1 | 1 | порт, звіти, стани, сон, відомості передавачу, оновлення |

### Екран приймача
Кадр малює бібліотека U8g2 у свій аркуш; на екран іде **власне виведення**: кадр порівнюється з попереднім, і по
кожній із восьми сторінок екрана йде одна посилка лише зі зміненими стовпцями. Так виходить 60 кадрів/с (бібліотека
давала 33). «Півтони» на однобітному екрані — растром 4×4; переходи між екранами — змішуванням із попереднім кадром
(розчинення, зсув, розкриття колом, шторка).

Шина I2C бере за раз 32 байти: драйвер ESP-IDF 5.5 (`i2c_master_transmit`, синхронно) кладе наступну порцію з
задачі, що його викликала, коли переривання скаже «попередня пішла». Тому швидкість виведення залежить від того, як
швидко задача екрана отримує ядро. До 2.96 вона ділила ядро 1 із задачею звуку (пріоритет 20), і з шумозаглушенням у
стерео кадр ішов ~20 мс, а екран показував 17–23 кадри/с. З 2.93 на час передачі кадру задача екрана піднімається до
пріоритету 21, з 2.96 вона — на ядрі 0 (там вільно 40–45 %, радіо з пріоритетом 23 її однаково випереджає). Заміри — у
`G1`: «екран: N кадрів за секунду, малювання …, передача кадру …»; ступені тракту звуку — `Y15`.

З 3.12 рядок стану головного екрана OLED (рівень зв'язку, ім'я, гучність) малюється, лише коли в ньому щось
змінилося: ключ — висоти стовпчиків, як вони малюються, гучність, ім'я й зсув бігучого рядка (`rxs::statusKey`); інакше
він береться із запасу (1 КБ), а щокадру малюються лише риска під ним і вигляд нижче (`Y17` — як до 3.12). Розбір
спектра для обох екранів — бібліотекою esp-dsp (`dsps_fft2r_fc32`, векторні команди S3): 320 мкс замість 1721
(`Y19`/`Y20`/`Y21`). Результат у неї — з переставленими бітами номера стовпця; потрібні стовпці до 8 кГц читаються через
таблицю перестановки, увесь масив не переставляється. Смуг: OLED — 14, кольоровий — 10.

### Кольоровий екран (з 3.03)
IPS 1,9″ 170×320 на ST7789, горизонтально 320×170 (`rxlcd.h` — залізо, `rxcolor.h` — усі екрани, `rxstrip.h` —
виведення). Тип екрана — перемичкою: вивід 21 на GND — кольоровий, вільний — OLED (з 3.13; до того — налаштування).

- **Шина.** SPI2 через матрицю виводів (виводи IO MUX 10–13 зайняті звуком), DMA, драйвер `esp_lcd` (ST7789: інверсія,
  `swap_xy`, дзеркало, зсув 35 рядків). З 3.11 — 20 МГц і найслабші виходи (`GPIO_DRIVE_CAP_0`): на 40 МГц зі звичайними
  виходами зміна картинки давала клацання в навушниках. Заміри (`Y22`): шум радіо однаковий, коли шина стоїть і коли
  гонить кадри без упину (−90,5 / −90,0 дБм), втрат пакетів немає; вихід звуку без даних — 0 разів (`n8=8`). Тобто це
  наведення вже після ЦАП, і лікується воно пологими фронтами. Кадр цілком при 20 МГц — 76 мс, при 40 — 55 (з них на
  шині 22: решта — процесор).
- **Кадр — у зовнішній пам'яті** (PSRAM, 108 КБ), другий кадр — для переходів. Малюється одним обходом сцени
  (`m2::Gfx` зі згладжуванням: текст 4-бітними шрифтами, кола, лінії, градієнти). На екран іде лише те, що змінилося:
  відбитки плиток 32×10 точок; у смузі — кілька кусків, якщо між змінами дві й більше незмінні плитки (з 3.09). Кусок
  копіюється у внутрішню пам'ять, байти переставляються (екран чекає старший першим) і йде по DMA, поки готується
  наступний.
- **Сцена й ключ (з 3.07).** `ui_rx.h` раз на кадр заповнює `Scene` (що на екрані); `sceneKey` — відбиток усього, від
  чого залежить нерухома частина екрана, з тією точністю, з якою вона малюється (рівень зв'язку — чвертями поділки,
  «дихання» рамки «тиші» — ступенями). Поки ключ той самий, кадр цілком не малюється: аналізатор дорисовує лише риски,
  що зрушили (`analyzerStep`: шматок стовпця стирається й малюється наново з обрізанням — точно як при малюванні
  цілком; сусідні шматки — однією посилкою, якщо так дешевше), а області, що рухаються самі (`sceneDyn`: бігучий
  рядок, гучність, що «перегортається», вступ «тиші», стрілки правки в меню), — з обрізанням. Ключ 0 — екран рухається
  весь (пошук, «це я», заставка): кадр цілком щоразу.
- **Переходи.** Попередній екран — знімок кадру на початку переходу (з 3.09; до того малювався наново щокадру): зсуви —
  копіюванням рядків знімка, «діафрагма» — новий екран лише в квадраті кола, корінь — лише для точок краю, «шторка» —
  новий лише лівіше краю.
- **Головний екран (з 3.08).** Ліворуч угорі гучність (154×78), ліворуч унизу аналізатор (154×80, 10 рисок із
  позначками піків), праворуч зв'язок, стерео/моно, шумодав, ім'я (154×162).
- **Заміри (884A94, 15.10.2026).** Головний екран: 62–63 кадри/с, кадр 3,6–4,9 мс (розбір спектра 0,35–0,40,
  малювання 0,4–0,6, відправка 1,2–3,2), 750–900 точок за кадр із 54 400. До 3.06 кадр малювався 17 смугами по 10
  рядків — 17 обходів сцени: 6–35 кадрів/с; у 3.06 (кадр у PSRAM) — 32–51; у 3.07 (ключ) — 61–63, кадр 5–9 мс.
- **Симулятор** `tools/simrxc/run.sh`: той самий код на Mac — анімація, аркуш ключових кадрів, звірка «дорисований екран =
  кадр, намальований цілком» (`-DAN_NO_JITTER` — без допуску ±1 точка в рисках; `SIM_DIFF=1` — які точки розійшлися),
  звірка переходів з еталоном, `SIM_EN=1` — англійські написи.

## Радіо
- **ESP-NOW**, широкомовна адреса, канали 1–13 діапазону 2,4 ГГц, смуга 20 МГц.
- Швидкості: 1, 2, 5,5, 11 Мбіт/с (DSSS, 802.11b), 6…54 Мбіт/с (OFDM, 802.11g), 0,5 Мбіт/с («дальній» режим
  Espressif). На столі на 6–24 Мбіт/с губилося 3–8 % пакетів, на 1–11 — 0–2 %: одна несуча краще тримає вузькі
  завади на кшталт Bluetooth.
- Потік «вміщується», якщо пакет займає не більше 45 % проміжку між пакетами.
- Передавач слухає ефір перед кожною передачею, як звичайний учасник Wi-Fi, тож сусіднім мережам не шкодить.
- Енергозбереження Wi-Fi вимкнено (`WIFI_PS_NONE`).

## Пакет і звук

Заголовок (14 байтів, іде відкрито, але підписаний):

| Поле | Байтів | Зміст |
|---|---|---|
| `magic` | 2 | `0x4C48` («HL») |
| `ver` | 1 | 4 |
| `kit` | 1 | номер набору |
| `boot` | 4 | «епоха» — номер увімкнення передавача |
| `seq` | 4 | номер пакета |
| `flags` | 1 | молодші біти: тон, перевантаження, тиша, проріджування; старші 4 — номер каналу передавача |
| `q` | 1 | якість (0–3), `0x80` — стерео, `0x40` — мова написів англійська, `0x10` — у пакеті два кадри (з 2.63) |

Далі зашифровано: поточний кадр (без стиснення або блок ADPCM: перший відлік 2 байти, крок 1 байт, по 4 біти на
відлік), у стерео — блок різниці каналів, далі запасні копії, у кінці — підпис 8 байтів.

| Якість | Кадр | Копій (моно/стерео) | Пакет | Пакетів/с | Потік |
|---|---|---|---|---|---|
| найвища (з 2.63) | 64 відліки, 2 мс; **два кадри в пакеті** | копії чотирьох попередніх кадрів (двох минулих пакетів) | 418 / 564 байти (моно / стерео) | 250 | ~840 / ~1130 кбіт/с |
| найвища (з 2.77, точні копії) | те саме; минулий пакет — ще раз без стиснення | 2 точні + 2 стиснуті | 604 / 750 | 250 | ~1210 / ~1500 |
| найвища стерео (з 2.87) | те саме; **різниця каналів без стиснення** — і в кадрах, і в копіях минулого пакета | 2 точні (середина й різниця) + 2 стиснуті (лише середина) | 1116 | 250 | ~2230 |
| найвища (до 2.63 і для старих приймачів) | 64 відліки, 2 мс | 2 / 1 | ~220 байтів | 500 | ~850 кбіт/с |
| стандартна | 128, 4 мс | 2 / 1 | ~223 | 250 | ~430 |
| мова | 128 @16 кГц, 8 мс | 2 / 1 | ~223 | 125 | ~215 |
| дальня | 192 @16 кГц, 12 мс | 1 / — | ~220 | 83 | ~141 |

Одиночний пакет не довший за 250 байтів (межа ESP-NOW версії 1) — звідси довжини кадрів і кількість копій.

**Два кадри в пакеті (з 2.63, лише «найвища»).** ESP-NOW версії 2 (ESP-IDF 5.4+) несе до 1470 байтів. Подвійний
пакет: заголовок 14 · кадр A (середина 128 і, у стерео, різниця 35) · кадр B · стиснуті копії **чотирьох попередніх
кадрів** — двох минулих пакетів, від ближчого до дальшого (по 35) · у стерео — копії їхньої різниці (по 19) ·
підпис 8. Разом 564 байти в стерео, 418 у моно. Номер пакета — номер першого кадру, другий кадр — наступний номер,
тобто кадри й номери ті самі, що в одиночних пакетах.
Навіщо: виклик надсилання коштує ядру радіо 0,7 мс за будь-якої довжини пакета, і 500 викликів за секунду займали
ядро на 70–93 %; тепер 250. В ефірі пакет 633 мкс із 4000 (15 %) замість 383 із 2000 (19 %). Ціна: +2 мс затримки.
Стійкість до втрат: два загублені пакети поспіль (8 мс звуку) відновлюються повністю і в стерео. Розрахунок на
комп'ютері (`tools/host/dbl.cpp`, 8 с звуку, випадкові втрати пакетів) — пропало звуку:

| Втрати пакетів | Одиночні, стерео | Подвійні, стерео | Одиночні, моно | Подвійні, моно |
|---|---|---|---|---|
| 5 % | 18 мс | 0 | 0 | 0 |
| 10 % | 68 мс | 0 | 0 | 0 |
| 20 % | 302 мс | 76 мс | 64 мс | 76 мс |

Сумісність: старий приймач подвійний пакет відкидає як чужий, а сплячий чи щойно ввімкнений старий приймач не
знаходить передавач і за рідкими одиночними пакетами. Тому (а) передавач **пам'ятає у флеш-пам'яті версію кожного
приймача** зі списку й іде подвійними, лише коли **всі** приймачі списку — на зв'язку вони чи ні — повідомляли
версію 2.60 або новішу (перший випуск із подвійними пакетами — 2.63), і не тоді, коли відкрите вікно додавання приймачів; `?` каже, який приймач заважає;
(б) кожні 75 подвійних пакетів (тричі на секунду) слідом іде звичайний одиночний пакет із номером другого кадру:
нові приймачі відкидають його як повтор, а старий, що не спить, за ним лишається на зв'язку. Приймач, якого вже
немає, але який лишився в списку, тримає передавач на одиночних пакетах — його треба видалити зі списку.
Перехід на інший канал без паузи призначається на межу пари.

**Стерео**: в ефір іде «середина» (Л+П)/2 — той самий звук, що в моно, — і «різниця» (Л−П)/2. Приймач у режимі
моно різницю не чіпає. До 2.86 різниця йшла ADPCM (4 біти на відлік), з 2.86 на «найвищій» — **без стиснення**, як
середина: у стерео приймач отримує ті самі Л і П, що пішли з передавача (з точністю до молодшого біта від ділення на 2).
Пакет (з 2.87) — 1116 байтів: заголовок · два кадри (середина 128 + різниця 128) · середина N−1, N−2 без стиснення ·
середина N−3, N−4 — ADPCM · різниця N−1, N−2 без стиснення · підпис. Одиночна втрата відновлюється біт у біт і в
стерео; при двох втратах поспіль кадри N−3, N−4 звучать у моно, різниця за 1 мс плавно йде до нуля й повертається. На
5,5 Мбіт/с — 1878 мкс із 4000 (47 % ефіру; попередній вид — 34 %). У 2.86 пакет був 968 байтів, і копії різниці
лишалися 4-бітними — на чистому звуці кожна втрата звучала шелестом. Передавач іде новим видом, коли всі приймачі
списку повідомляли 2.87+; порт `Qr0` — тимчасово по-старому (порівняти на слух).

**Номер каналу в заголовку**: сусідні канали Wi-Fi перекриваються, і приймач може почути пакет, стоячи на
сусідньому; за цим числом він стає точно.

## Зворотний зв'язок і команди

| Повідомлення | Ознака | Хто → кому | Зміст |
|---|---|---|---|
| `RxStatus` / `RxStatus2` | `0x5348` | приймач → передавач, раз на 2 с | гучність, прапорці (тиша, вимкнений, екран, звук іде, сон, стерео, вихід живий), сигнал, запас, втрати, провали, час роботи, версія, ім'я (13 або 32 літери) |
| `RxInfo` (з 2.32) | `0x5348`, інша довжина | приймач → передавач | чіткість, баланс, межа гучності, вигляд, світлодіод, мова, чи йде перевірка навушників |
| `TxCommand` / `TxCommand2` | `0x4348` | передавач → приймач | команда й аргумент (нижче) |
| `TxSeen` (з 2.63) | `0x5648` | передавач → усім приймачам, раз на 2 с | «кого чую»: номери приймачів на зв'язку (до 16) і ознака «список повний»; приймач, що не знайшов себе, лагодить своє радіо сам |
| `PairReq` / `PairRsp` | `0x5048` / `0x5148` | додавання приймача | відкриті ключі X25519, ключ набору під спільним секретом |
| `KeyMsg` / `KeyReq` | `0x4B48` / `0x5248` | зміна ключа набору | новий ключ під особистим ключем приймача |
| OTA | `0x4F48` | оновлення | оголошення, блоки, опитування, стан, скасування |
| налагодження | `0x4748` | в обидва боки | рядки порту й команди по радіо; з 2.63 — ще й «подія» приймача (сам перезавантажив радіо чи перезапустився): іде завжди, передавач пише її в порт і в журнал на картці |

Команди передавача: 1 «покажи себе», 2 ім'я, 3 увімкнути/вимкнути, 4 гучність, 5 тиша, 6 вихід стерео/протифаза,
7 перевірка виходу на слух, 8 «забудь набір», 9 перехід на канал (усім), 10 налаштування (номер × 32 + значення:
0 чіткість, 1 баланс+5, 2 межа гучності, 3 вигляд, 4 світлодіод, 5 мова), 11 перевірка навушників.
Кожна команда шлеться чотири рази; приймач виконує її один раз (номер увімкнення + лічильник).

**Сумісність**: нові повідомлення розрізняються довжиною або новою ознакою, старі не змінюються — старий передавач
нові просто пропускає. Формат оновлення по радіо не змінюється ніколи: за ним оновлюються старі приймачі.

## Захист
- **Ключ набору** — 32 випадкові байти, народжується в передавачі, зберігається в платах, в ефір і в порт не
  виходить.
- **Шифр** AES-128-CTR, **підпис** AES-128 CBC-MAC (у пакеті 8 байтів); спершу шифрування, потім підпис; на
  прийманні спершу перевірка підпису. Рахує **апаратний AES** мікросхеми, поблочно, напряму через регістри —
  десятки мікросекунд на пакет без виділення пам'яті. Готовий AES-CCM із mbedTLS коштував 1,2 мс на пакет (60 %
  процесора при 500 пакетах/с), тому не використовується.
- **Одноразове число**: вид пакета + епоха + номер пакета (+ номер приймача). Кожен вид повідомлення має свій
  номер виду — число не повторюється.
- **Повтори**: приймач пам'ятає найбільшу епоху й номер пакета; учорашній запис ефіру йому не підсунути.
- **Додавання**: обмін X25519, код із чотирьох цифр — відбиток відкритого ключа приймача; оператор звіряє його
  очима. Передавач слухає запити лише при відкритому вікні додавання.
- **Особистий ключ приймача** виводиться з того ж обміну: ним закривається новий ключ набору, коли когось
  видаляють. Видалений приймач нового ключа отримати не може.
- Чого захист не дає: заглушити ефір завадою можна, як і раніше.

## Оновлення прошивки

**По радіо** (`ota.h`):
1. Передавач зупиняє звук і 2,5 с оголошує: розмір, кількість блоків, відбиток SHA-256, версію.
2. Приймач звіряє відбиток зі своєю прошивкою: та сама — «в мене така», інша — бере пам'ять під увесь образ
   (PSRAM, ~2,2 МБ) і відповідає «приймаю».
3. Блоки по 200 байтів підряд (~11 000 блоків за ~11–18 с). Раз на 0,3 с приймач повідомляє, яких блоків бракує;
   передавач досилає.
4. Приймач звіряє відбиток усього образу, пише його в другий розділ прошивки, робить цей розділ завантажувальним
   і перезапускається.

**З картки** (`upd.h`): файл перевіряється (образ для ESP32-S3, довжина, відбиток у хвості, мітка
`HEARLINK-FW:<версія>`); спершу приймачам по радіо, потім передавач пише себе. Порядок навмисний: поки йде роздача,
обидві сторони працюють на старій прошивці й напевно розуміють одна одну.

## Пам'ять плати

`hearlink/partitions.csv` (флеш 16 МБ):

| Розділ | Адреса | Розмір | Що |
|---|---|---|---|
| nvs | 0x9000 | 20 КБ | налаштування, ключі, список приймачів |
| otadata | 0xE000 | 8 КБ | який розділ прошивки завантажувати |
| app0 | 0x10000 | 3 МБ | прошивка |
| assets | 0x310000 | 9,9 МБ | перевірочні звуки передавача |
| app1 | 0xCF0000 | 3 МБ | другий розділ прошивки (оновлення) |
| coredump | 0xFF0000 | 64 КБ | знімок останнього збою |

У NVS: простір `hearlink`, запис `cfg` — структура `Settings` одним шматком (нові поля додаються тільки в кінець:
запис від старої версії коротший, від новішої — довший, читається початок); `hl-peers` / `list3` — список
приймачів з особистими ключами; окремий простір — ключ набору, епоха, покоління ключа.

Розділ звуків: «HLPK», кількість записів, записи (ім'я 16 байтів, зсув, довжина); останній байт імені — вид:
0 — звук без стиснення 32 кГц моно, 1 — MP3.

## Файли прошивки
| Файл | Що в ньому |
|---|---|
| `hearlink.ino` | запуск, команди порту, звіти, налаштування |
| `config.h` | версія, частота, виводи, структура налаштувань |
| `proto.h` | пакети, якості, ADPCM, перехід 16↔32 кГц |
| `radio.h` | ESP-NOW, швидкості, розбір вхідних пакетів, оживлення радіо |
| `sec.h` | шифр, підпис, ключі, додавання й видалення приймачів |
| `bbox.h` | «чорна скринька» радіо |
| `txaudio.h`, `txmp3.h`, `assets.h` | вхід, перевірочні звуки, MP3 |
| `txpeers.h` | список приймачів, команди, швидкість «сама» |
| `txscan.h` | пошук каналу, затор, перехід |
| `txrec.h`, `txfiles.h`, `fm.h`, `fmui.h`, `cardfmt.h` | картка: запис, файли, форматування |
| `ota.h`, `upd.h` | оновлення по радіо та з картки |
| `panel4848.h`, `m2gfx.*`, `txui.h`, `ui_tx.h`, `slide.h`, шрифти `f*.h`, `m2*.h` | екран передавача |
| `rxaudio.h` | приймання, запас, вихід звуку |
| `rxlink.h`, `rxled.h` | відомості передавачу, команди, стани, сон, світлодіод |
| `rxfx.h`, `rxscreens.h`, `ui_rx.h` | екран і меню приймача |
| `rxcolor.h`, `rxstrip.h`, `rxlcd.h`, шрифти `rxTxt*.h`, `rxNum.h`, `logo_rx.h` | кольоровий екран приймача (з 3.03): екрани, виведення змін, залізо |
| `rsdot.h`, `nsfx.h` | згортка підгонки темпу, шумозаглушення й стискання |
| `lang.h`, `lang_en.h` | переклад написів |
| `dbgair.h`, `dbgtee.h` | налагодження по радіо |

## Що змінилось у 2.64–3.02 (технічно)

- **Повідомлення приймача про себе (2.64)** — на адресу передавача з підтвердженням і повторами, а не «всім»; при
  слабкому сигналі приймач сам піднімає потужність до 20 дБм (з 2.77 — нижче −76 дБм, назад вище −70). У `P` —
  лічильники доставки кожного приймача.
- **«Передавач головний» (2.65)** — приймач, вимкнений із передавача, своєю ручкою не вмикається; передавач сам
  повертає його в заданий стан. **Оновлення по радіо (2.66–2.67)**: приймач не засинає під час прийому, роздача не
  чекає відсталих довше 3 хвилин, виправлено «завмирає на 99 %».
- **Обробка «для слуху» (2.68–2.72, `hearlink/nsfx.h`)** — на приймачі: стискання замість «підсилення + обмежувач»,
  зняття підсилення в паузах мови, спектральне шумозаглушення (FFT 256, правило Вінера з рішучим зворотним зв'язком,
  оцінка шуму лише в паузах: тиша не вся, рівна за спектром і на 15 дБ тихіша за найгучніше за 10 хв — з 2.76); на
  передавачі — шумозаглушення входу на ядрі екрана. 2.75–2.76 — дві помилки, через які шумозаглушення на приладах
  майже не працювало (сміття в ознаці «зразок запам'ятовано» після перезапуску; паузи не знаходились 10 хв після
  розриву звуку).
- **Шумовий поріг входу (3.17, `txaudio.h`, `TxGate`)** — після шумозаглушення й вимірювання рівня, до «тиші в ефірі»;
  лише звук із пульта. Рівень кадру (2 мс) — середнє квадратів середини й різниці; шум входу — найтихіше (вниз за ~40 мс,
  угору 0,25 дБ/с, у межах −96…−36 дБ); поріг — шум + 3…15 дБ або вручну (`e12`); м'яке коліно 6 дБ; після звуку
  тримається відкритим 60 / 150 / 300 мс і закривається рівно в децибелах за 60 / 150 / 400 мс; відкривається за кадр;
  множник — по відліках. Перевірка на комп'ютері (шум −62 дБ, «слова» −20 дБ і тихий склад −34 дБ): паузи −11,9 / −19,8 /
  −29,5 дБ / нуль, слова й склад — 0,00 дБ, зайвий стрибок відліку — до 3 одиниць. Вимкнений поріг усе одно міряє шум
  входу — його видно на листі «Шум входу» й у `e10`.
- **Сходинки швидкості (2.73–2.83, `txpeers.h`, `rateAutoTick`)** — дві: верхня (5,5 Мбіт/с у «самої» або обрана
  вручну) і 1 Мбіт/с. Униз: згладжений сигнал найслабшого приймача −75 дБм і слабше, або в нього пропадає звук, або
  слабкий приймач щойно зник; угору: усі −70 дБм і краще 30 с (якщо найслабший −66 і краще) чи 120 с, із подвоєнням
  строку, якщо після повернення довелося знову сходити (до 10 хв). Ручний вибір швидкості чи якості — підйом одразу,
  якщо можна, інакше пояснення на екрані. Налаштування `cfg.rateLadder` («Слабкий сигнал»). Запас приймача, поки
  пакети губляться, не опускається нижче глибини копій + кадр + 2 мс; пошук каналу — лише після 2,5 с тиші.
- **«Найвища» (2.77)** — у подвійному пакеті минулий пакет повторено без стиснення: одна втрата відновлюється біт у біт.
- **Кодек дальнього режиму (2.79–2.82, `hearlink/subc.h`)** — вісім косинусно-модульованих смуг (вікно 80 відліків,
  затримка набору 2,25 мс), кадр 128 відліків = 4 мс, масштаб і біти кожної смуги в кожному кадрі заново, заповнення
  шумом смуг без бітів; пакет 158 байт: кадр 46 + копія 46 + копія 32 + груба копія 12. З 2.82 розбір, пакування й
  збирання — у швидкій пам'яті (IRAM): у кеші команд ESP32-S3 лише 16 КБ на обидва ядра, і код із флешу коштував
  учетверо більше за розрахунок (кодер 0,58 → 0,16 мс на кадр, приймач 0,60 → 0,14 мс на пакет).
- **Канал (2.82–2.83, `txscan.h`)** — замір каналів додає «ризик від сильного сусіда» за маяками точок доступу та їхнім
  справжнім каналом; передавач рахує секунди, коли пакет чекав ефіру 15 мс і довше, і пише це на «Ефірі»; м'який
  перехід — проба з поверненням (`hopSoftTick`). З 2.88 — і за втратами пакетів у приймачів із добрим сигналом
  (`airLossPm`: щосекунди найбільша з останніх часток втрат у тих, що грають на −62 дБм і сильніше, середнє за хвилину;
  поріг 15 ‰; лишатися — якщо на новому каналі втрат менше хоча б на 30 % і не більше на 1 %). Вимір 14.10: на каналі 1
  ближній приймач (−47 дБм) губив 1–6 % пакетів, на каналі 5 — 0 %; передавач за своїм заміром вважав канал 1 найкращим.
- **Самовідновлення звуку (2.84)** — номер рядка таблиці підгонки темпу рахується цілими (раз на ~17 хв він округлявся
  до 128, і читався рядок за краєм таблиці — звідти «не число», що назавжди глушило фільтри); «не числа» на вході
  обробки, після шумозаглушення й на виході замінюються нулем зі скиданням пам'яті фільтрів; сторож виходу (вихід
  1,5 с на одному числі при гучному звуці в ефірі — скидання, не допомогло за 4 с — тихий перезапуск, не частіше разу
  на 10 хв); перезапуск командою `CMD_RESTART` з передавача й пунктом меню.
- **CS4344 (2.85)** — див. вище «Будова» і hardware.md.
- **«Зернистість» (2.86)** — власник: на ідеальному сигналі, на обох ЦАП, на перевірочному звуці й гарному записі
  «неприємна зернистість». Тракт повторено на комп'ютері (`tools/host/rxchain.cpp`) і поміряно похибку кожного ступеня
  за смугами частот. Знайдено чотири причини: (1) **4-бітна різниця каналів у стерео** — її шум рівний по частоті, а
  верх у музики тихий: у смугах 2–16 кГц шум був лише на 27…2 дБ тихіший за музику, на 15–16 кГц — гучніший; (2) **16
  біт із відкиданням дробу після цифрової гучності** — на гучності 2 з 20 від звуку лишалося 5–10 розрядів, спотворення
  йшли за звуком; (3) **обмежувач** при «Підсиленні» +24 дБ без стискання не встигав атакою за 0,3 мс: 1426 відліків
  за 87 с виходили за шкалу й зрізалися жорстко; (4) **підгонка темпу** 24 відліки — дзеркальні частоти на 14–16 кГц
  (−26…−6 дБ). Виправлено: різниця без стиснення (2.87: і в копіях; пакет 1116 байтів), 24 біти на ЦАП, обмежувач із середнім за вікно
  3 мс (за шкалу — одиниці відліків, інтермодуляція −48 → −59 дБ), таблиця 48 відліків. Перевірка пакета —
  `tools/host/dbl.cpp`: різниця доходить біт у біт.
- **Шумозаглушення в стерео й оновлення по радіо (2.89–2.92)** — власник: «при включенні шумодава з'являються клацання»,
  «пропадає один канал». (1) Різниця каналів не мала свого спектра — лише чекала й ослаблялася одним загальним числом,
  тож при ослабленні середини по смугах Л і П переставали бути «лівим і правим»: тиха музика, зведена в Л, протікала
  в П на −16…−20 дБ (`tools/host/nsstereo.cpp`). З 2.89 різниця йде тим самим вікном і перетворенням із тими самими
  посиленнями смуг, що й середина: протікання −27…−31 дБ (це вже лише по-різному приглушений шум П), шум у П на гучній
  музиці в Л — −56…−60 дБ замість −52. (2) Вихід на ЦАП лишався без даних раз на 30–60 с — черга виходу була 2 мс, а
  найважчий блок із шумозаглушенням — до 0,65–0,9 мс плюс рідкі затримки від спільного кешу команд і радіо; з 2.92
  черга — 4 мс: за 3 хвилини — жодного пропуску. (3) Оновлення по радіо з увімкненим шумозаглушенням ішло в 6–12 разів
  повільніше (і прийом, і запис) — увесь звуковий тракт рахував тишу; з 2.90 на час оновлення на вихід іде готова
  тиша без рахунку: оновлення двох приймачів — 45 с замість 2–10 хвилин. (4) Передавач чекав запис не довше 2 хвилин
  і решту вважав «зниклими»; з 2.91 — поки приймачі пишуть і відгукуються, до 10 хвилин.
- **Меню й аналізатор приймача з шумозаглушенням (2.93–3.02)** — власник: «при включенном шумодаве очень тормозит
  меню и анализатор на главной странице». Замір (`Y15`, `Y14` у збірці з `HL_TASK_LOAD`): тракт звуку з 2.86 брав
  710 мкс із кожної мілісекунди, із шумозаглушенням у стерео — 830–910 (підгонка темпу 270–290, обробка й вихід
  270–300, шумозаглушення 140, підготовка блока 130–150); задача `rx` — 83–93 % ядра 1, екрану лишалося 14 %:
  17–30 кадрів/с. Зроблено: (1) кадр на екран — із пріоритетом вище звуку (2.93); (2) екран — на ядрі 0 (2.96);
  (3) згортка підгонки темпу — окремою функцією з O2 (`hearlink/rsdot.h`): у `rxTask` (9 КБ коду, `-Os`) сума жила в
  стеку, ~45 тактів на відвід; тепер дві суми на згортку, коефіцієнт підправляється раз і йде в обидві — 648 тактів
  на відлік замість ~2000, розбіжність із колишнім рахунком — округлення float (`tools/host/rsdot.cpp`); (4) у
  стисканні `log10f`/`powf` (до чотирьох разів на 8 відліків) замінено точними наближеннями `nsxLog2a`/`nsxExp2a`
  (похибка менше мільйонної частки дБ; перевірка `tools/host/nsfx.cpp` — ті самі цифри); (5) `powf` гучності —
  лише коли гучність змінилась (два виклики на блок коштували ~70 мкс); (6) крок шумозаглушення — з O2. Результат на
  приладах 15.10: тракт 4C3B10 (шумозаглушення 2, стискання 3) — 630 мкс на мілісекунду, 884A94 — 485; екран 62–63
  кадри/с на головній і в меню; вихід без даних — 0 разів за 3 хвилини на обох. У швидку пам'ять (IRAM) нічого не
  переносилось: у передавача внутрішньої вільно 42 КБ при правилі «не менше 40».

## Що змінилось у 3.03–3.13 (технічно)

- **Кольоровий екран (3.03–3.08)** — див. «Кольоровий екран» вище: смуги → кадр у PSRAM (3.06) → ключ сцени й
  дорисовування (3.07) → головний екран за розкладкою власника, 10 рисок із піками (3.08). Пункти меню «Яскравість» і
  (до 3.13) «Тип екрана», значки 22, 23.
- **Оновлення по радіо з кольоровим екраном (3.06).** Приймач перезапускав сторож задач (ядро 0 без простою понад 5 с:
  екран малював без пауз поряд із записом у флеш). Тепер на час оновлення екран малює 10 кадрів/с і завжди віддає
  щонайменше 2 мс; перевірено шість оновлень поспіль.
- **Кнопка ручки (3.09)** — таймером раз на 5 мс, не щокадру: на «тиші» кадр ішов 30–40 мс, і коротке натискання
  губилось («вийти з тиші не виходить з першого разу»).
- **Шина 20 МГц і найслабші виходи (3.11)** — проти клацань від зміни картинки; `n27` (біти 8, 16) — як було.
- **esp-dsp для спектра, запас рядка стану OLED (3.12).**
- **Перемичка вибору екрана (3.13)** — вивід 21 на GND; пункт «Тип екрана» прибрано.
- **Діагностика:** `Y22` (завади шини екрана), `Y23` (послухати наведення), `Y17`/`Y18`, `Y19`–`Y21`; `Y15` — найважливіше
  на початку рядка (по радіо довгий рядок обрізається).

## Що змінилось у 3.17–3.27 (технічно)

Власник 16.10: «при перегрузах на входе начинается треск на выходе»; «на тестовом звуке все идеально, даже при полном
перегрузе на индикаторе уровня, а через ацп этот же уровень это просто треск». Перевірочний звук іде повз I2S,
еквалайзер і шумозаглушення, тож «на перевірочному чисто» нічого не каже про вхід — причини знайдено записами з приладу
(`e19`/`e21`/`e22`, `tools/adcdump.py`).

- **Шумовий поріг входу (3.17)** — див. вище, у 2.64–3.02.
- **Обмежувач піків входу (3.18, `TxLim`)** — після еквалайзера й підсилення: затримка 48 відліків (1,5 мс),
  найменше «треба знизити» за вікно — чергою, відпускання, середнє за вікно; пік — більший із каналів
  (|середина| + |різниця|), тож за стелю відлік не виходить; нижче стелі — м'яке стискання (коліно ±3 дБ). Пам'ять — з
  купи, лише в передавача. Порт `e14…e17`; на екрані — лист «Піки входу» (3.24).
- **Формат даних PCM1808 (3.19–3.21).** Із FMT на 3,3 В модуль шле «ліве вирівнювання» — на такт раніше, ніж чекає
  I2S Philips у ESP32: старший розряд відліку потрапляє в біт 0 ПОПЕРЕДНЬОГО слова, у слові — D22…D0. Відлік читався
  вдвічі гучнішим, а все вище половини шкали АЦП «перевертало» знак — тріск. Розпізнавання по кожному кадру: у рівного
  слова біт 8 — молодший розряд (шум), біт 0 — нуль; у зсунутого навпаки (4 кадри поспіль). Зсунуті слова збираються
  наново: знак — біт 0 попереднього слова, D22…D0 — зі свого; перший відлік кадру — з того з двох варіантів знака, що
  ближчий до наступного відліку того ж каналу (між кадрами I2S буває пропуск). У «лівому вирівнюванні» лівий канал — за
  високого LRCK, тож при зсуві канали беруться навпаки. Перевірено на записах приладу: без пульта знак збігається з
  бітом 0 попереднього слова в 100 % слів, із пультом «перевертань» 188 і 201 за 1,5 с → 0. Порт `e18`.
- **Втрати кадрів I2S (3.21–3.22) — головний тріск.** Із пультом задача передачі витрачала на кадр у середньому
  1,76 мс із 2 (обробка входу — 465 мкс проти 232 у перевірочного звуку), і I2S губив кадри — 20–30 розривів по 2 мс за
  секунду. Еквалайзер і підсилення (`txInEqGain`), обмежувач (`TxLim::run`) і поріг (`TxGate::apply`) — з -O2 і в IRAM
  (методи винесено з тіла структур: інакше компонувальник «l32r: literal placed after use»), `txReadI2s` — з -O2;
  черга I2S — 8 кадрів (було 4). Розривів — 0. Лічильник втрат I2S (`on_recv_q_ovf`) — у `e14`.
- **Запас шумозаглушенню входу (3.23).** Задача на ядрі екрана мала один кадр (2 мс), а її крок (БПФ на 256 відліків)
  припадає на кожен другий кадр і триває ~1,3 мс: не встигала тисячі разів, і в ефір ішов кадр без обробки — у тиші
  тихе «цифрове» клацання. Тепер — два кадри (шлях шумозаглушення 10 мс замість 8); якщо не встигла все одно — кадр
  без обробки, приглушений на поточне «прибирає». Запізнень — 0.
- **Слабкі виходи тактів I2S (3.26).** MCLK (вивід 43), BCK і LRCK — `GPIO_DRIVE_CAP_0`: гармоніки 8,192 МГц ідуть
  кожні 8,2 МГц і потрапляють у будь-який канал 2,4 ГГц; шум радіо в передавача з пультом був на 2–3 дБ вищий, ніж із
  перевірочним звуком, тепер — на 0,5 дБ.
- **Кольоровий екран.** Стовпчики аналізатора — відтінок кожного рядка за висотою на шкалі (`anRowColor`: зелений до
  1/3, далі до жовтого, угорі — яскраво-червоний; 3.23 — увесь стовпчик одним кольором, 3.25 — рядками); дорисовуються
  лише зсунуті рядки, точок на екран за кадр навіть менше, ніж раніше. Усі написи — білі (3.23, 3.27).
- **Діагностика:** `e18` (формат АЦП), `e19`/`e21`/`e22` (запис сирих слів АЦП і того, що йде в ефір), `e20` +
  `tools/adcdump.py`; у `e14` — рахунок АЦП, втрачені кадри I2S, виправлені знаки першого відліку.

## Особливості й граблі

Те, на що вже наступали, — щоб не наступити знову.

- **Ключ сцени має знати все, що малюється, з тією самою точністю.** Значок рівня зв'язку малювався плавно, а ключ
  знав рівень чвертями — дорисований екран розходився з намальованим цілком (знайшла звірка симулятора). Правило:
  малювати рівно з тією точністю, яку знає ключ.
- **Скруглений верх риски.** Коли риска виросла, старий скруглений верх треба стерти — нові кути лягають на тло, а не
  на старий колір.
- **Наведення від шини екрана в навушниках** — не радіо й не цифра: заміри «шуму радіо» й «виходу без даних» його не
  бачать. Лікується пологими фронтами (сила виходів, частота шини) і проводкою.
- **Знаки «<» і «>» у написах схем** (`tools/gen_schema.py`) ламають SVG — `sips` тоді мовчки не робить PNG.

- **Програмний перезапуск ESP32 не скидає виводи.** `pinMode` ядра Arduino бере у виводу «попередній вид
  переривання» й сам його вмикає. Кнопка ручки у сні — «будильник» із перериванням «поки рівень низький»; після
  «сон → оновлення по радіо → перезапуск» перше натискання вішало плату (сторож переривань). Лікування: знімати
  переривання й «будильник» при запуску та після кожного пробудження.
- **`attachInterrupt` ставить обробник через службову задачу зі стеком 1 КБ** — якщо в цю мить приходить
  переривання звуку, стек переповнюється («Stack canary watchpoint triggered (ipc1)»). Переривання ручки
  підключаються напряму (`esp_intr_alloc` із задачі екрана).
- **Сторож задач (5 с).** У приймача він стежить за бездіяльною задачею ядра 0. У передавача з 2.63 — за **самою
  задачею передачі** (`esp_task_wdt_add` у `txTask`): ядро радіо за одиночних пакетів зайняте на 93–100 %, і
  «бездіяльна задача п'ять секунд не отримувала часу» там — звичайна робота з фоновим навантаженням, а не
  зависання; сторож через це перезапускав передавач під час роздачі оновлення (п'ять разів поспіль 10.10.2026).
  Знімати бездіяльну задачу треба `esp_task_wdt_reconfigure()` з `idle_core_mask = 0`: `disableCore0WDT()` ядра
  Arduino лишає «холостий гачок», і той 500 разів на секунду друкує «task not found».
- **Довгий рахунок — не на ядрі радіо.** Підготовка роздачі оновлення (відбиток 2,2 МБ прошивки) йде окремою
  задачею на ядрі екрана: на ядрі радіо за одиночних пакетів вона не закінчувалась і за 40 с.
- **Операції з флеш вимикають кеш на обох ядрах** — картинка передавача смикається; читати через `mmap`.
- **Пакети ESP-NOW довші за 250 байтів** працюють (ESP-NOW версії 2): з 2.63 «найвища» йде пакетами по 564
  байти. Давній запис «драйвер слав їх у 2,5 раза повільніше й замовкав» стосувався збірки з повільним шифром і
  довгих пакетів не спростовував.
- **Не міняти канал радіо, поки власний пакет ще в драйвера** (і не класти другий пакет поверх першого) — див.
  «Радіо приймача: живучість».
- **Вивід, що керує XSMT ЦАП, до запуску прошивки «висить у повітрі»**: прошивка тримає його в «землі» від першого
  рядка до початку звуку й крізь програмний перезапуск (`gpio_hold_en`), але перші частки секунди після подачі
  живлення закриває лише резистор на «землю» (див. [обладнання](hardware.md)).
- **`WiFi.mode(WIFI_OFF)` у ядрі 3.3.3 не знімає драйвер**; обробник події «станція стартувала» сам вмикає
  енергозбереження — його треба вимикати знову.
- **Відкрита частина пакета під підписом — не довша за 16 байтів**: із 20 шифр мовчки відмовляв.
- **Версія в повідомленні приймача — ×10 з округленням** (2.31 і 2.34 обидві «23») — порівнювати версії за нею не
  можна; можливості приймача передавач дізнається з того, які повідомлення той шле.
- **Лічильник, який міняють дві задачі без захисту, «пливе»** — робити два лічильники (поклав / забрав).
- **Вбудований АЦП ESP32-S3** час від часу зупиняється — є сторож, що його перезапускає.
- **Виводи 17 і 18** після скидання найслабші (10 мА) — їм ставиться найбільший струм.
- **Модуль 4848S040**: 3,3 В на роз'ємах немає; міст CH340 помиляється на швидкостях вище 230 400; від порту
  ноутбука не живити.

## Що не перевірено
- Дальність у великому залі. Один вимір: на 8 м із внутрішньою антеною модуля приймач втрачав сигнал; після
  підключення зовнішньої антени систематичних вимірів не було.
- Затримка «від входу до навушників» акустично: оцінка 13–17 мс для «найвищої» (з 2.37 — разом із 1,5 мс обмежувача), ~20, 30–35 і 40–50 мс для решти.
- Споживання приймача в роботі й у сні, час роботи від акумулятора.
- PCM1808 на модулі передавача. (PCM5102 на приймачі звук дає — перевірено 08.10.2026; якість звуку з ним ще оцінюється.)
- Більше двох приймачів одночасно.
- Причина рідкісної зупинки драйвера Wi-Fi передавача (він оживляється сам, подробиці пише «чорна скринька»).
- Причина того, що приймач грає, а передавач його не чує (з 2.63 приймач лагодиться сам і лишає запис у журналі на
  картці — за цими записами причину й шукати).
- Подвійні пакети в справді забитому ефірі (пакет довший, зате пакетів удвічі менше).
