roman885-85/hearlink/docs/img/rx-color-main.png

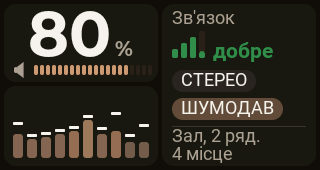
docs/img/rx-color-main.png
