roman885-85/hearlink/docs/img/tx-00-zastavka.png

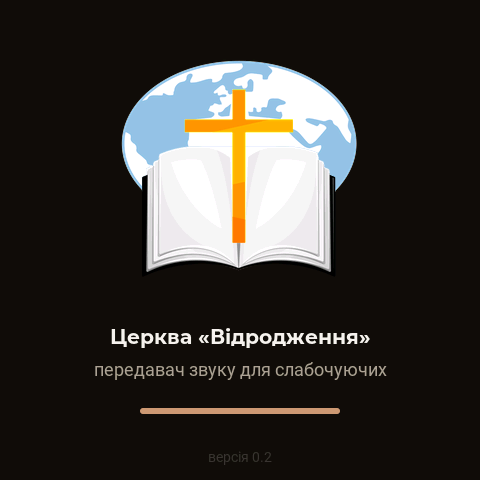
docs/img/tx-00-zastavka.png
