roman885-85/hearlink/docs/img/tx-01i-golovna-usb.png

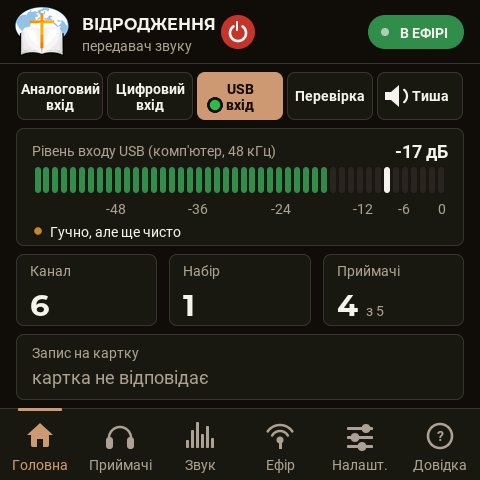
docs/img/tx-01i-golovna-usb.png
