roman885-85/hearlink/docs/img/tx-05a-zvuk-yakist.png

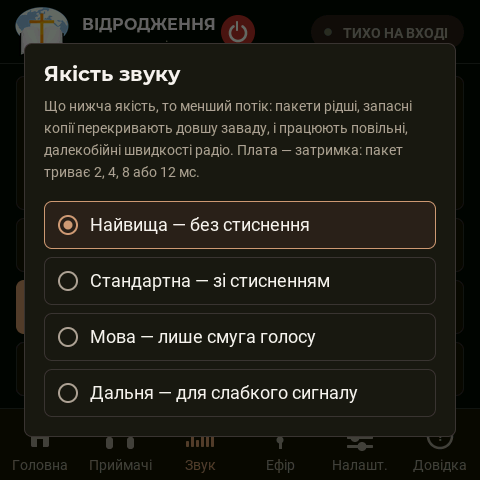
docs/img/tx-05a-zvuk-yakist.png
