roman885-85/hearlink/docs/img/tx-11-nalashtuvannya.png

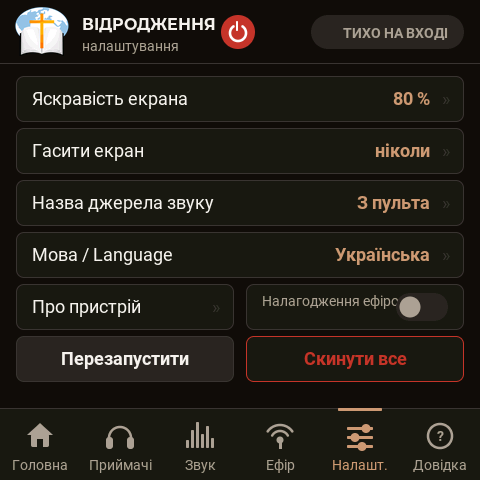
docs/img/tx-11-nalashtuvannya.png
