roman885-85/hearlink/docs/img/tx-14-dovidka.png

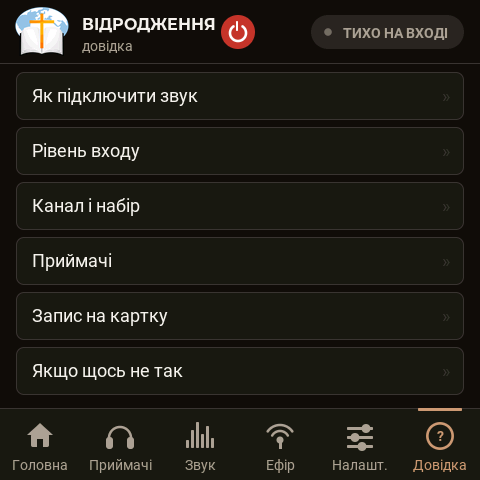
docs/img/tx-14-dovidka.png
