roman885-85/hearlink/docs/img/tx-17d-onovlennya-pochatok.png

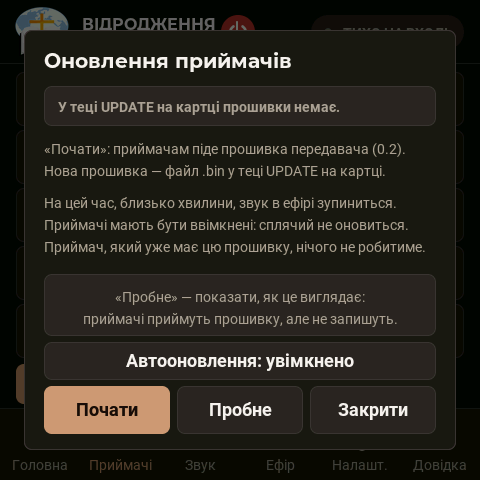
docs/img/tx-17d-onovlennya-pochatok.png
