roman885-85/hearlink/docs/img/tx-21b-zator-kanal-zmineno.png

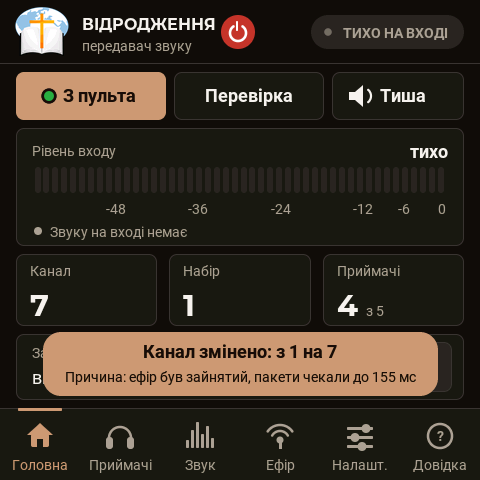
docs/img/tx-21b-zator-kanal-zmineno.png
