roman885-85/hearlink/docs/img/tx-en-1-home.png

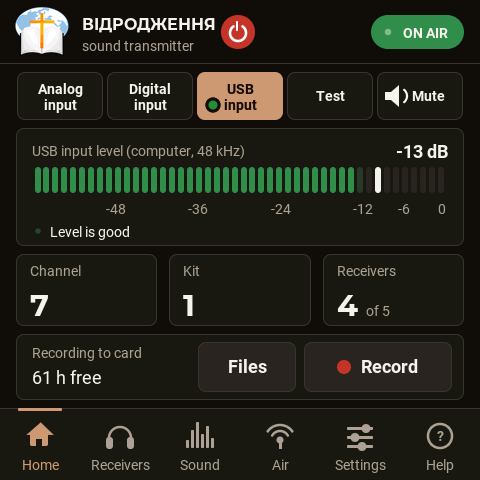
docs/img/tx-en-1-home.png
