roman885-85/hearlink/docs/img/tx-en-2-receivers.png

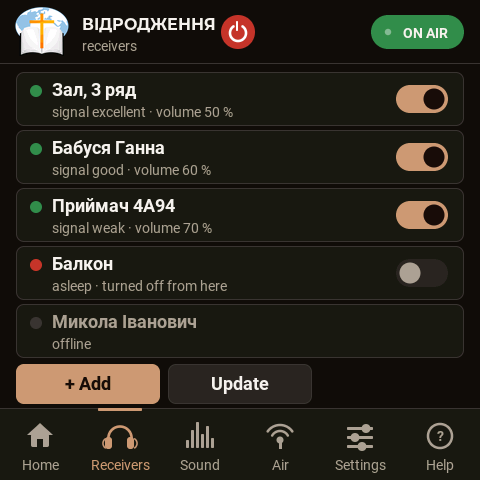
docs/img/tx-en-2-receivers.png
