roman885-85/hearlink/docs/img/tx-en-3-sound.png

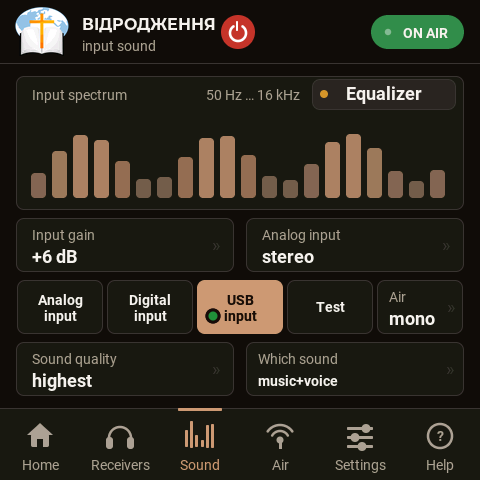
docs/img/tx-en-3-sound.png
