roman885-85/hearlink/docs/img/tx-en-4-air.png

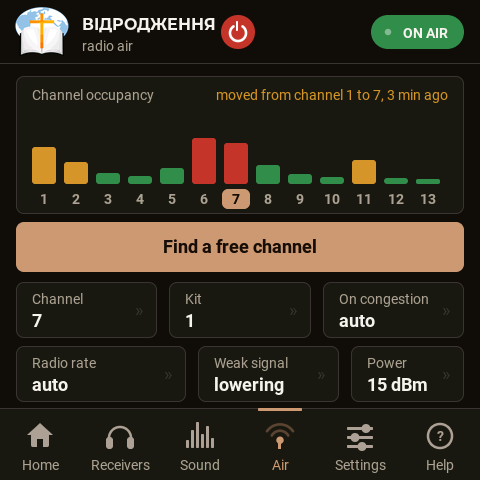
docs/img/tx-en-4-air.png
