roman885-85/hearlink/docs/img/tx-overview.png

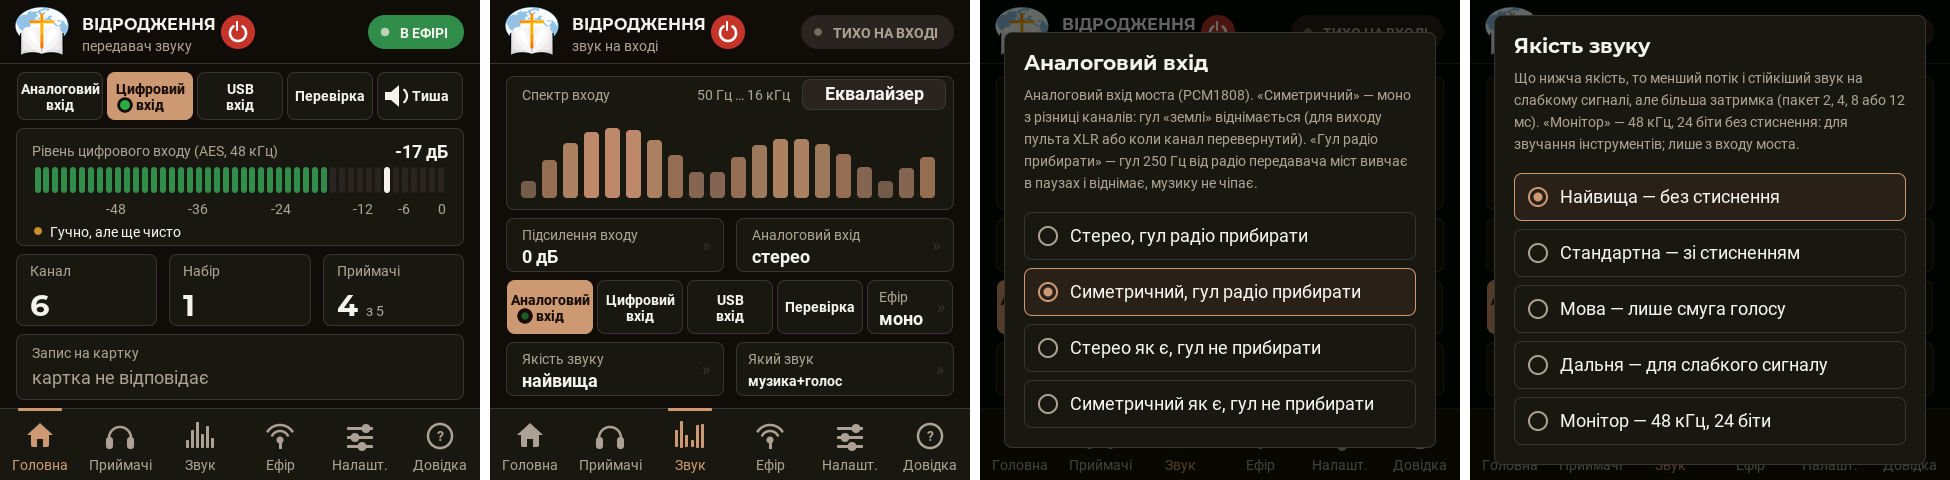
docs/img/tx-overview.png
