roman885-85/hearlink/docs/menyu-0.6.png

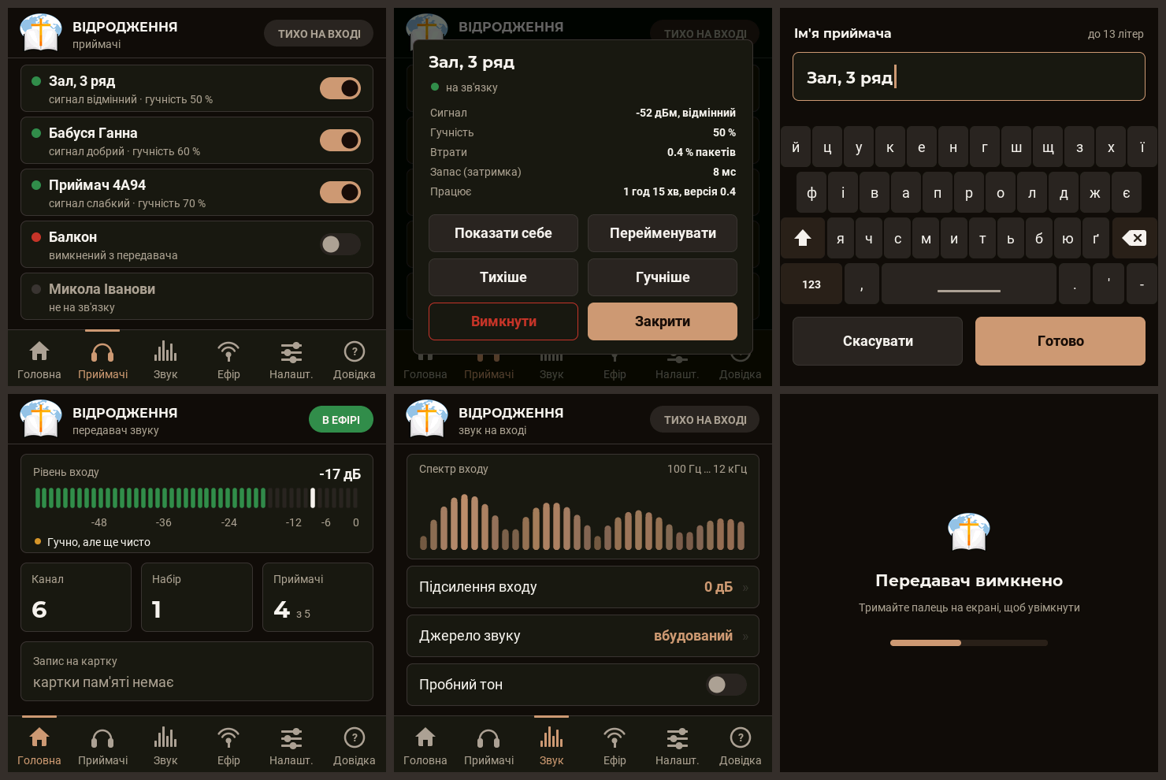
docs/menyu-0.6.png
