roman885-85/hearlink/docs/menyu-peredatchika.png

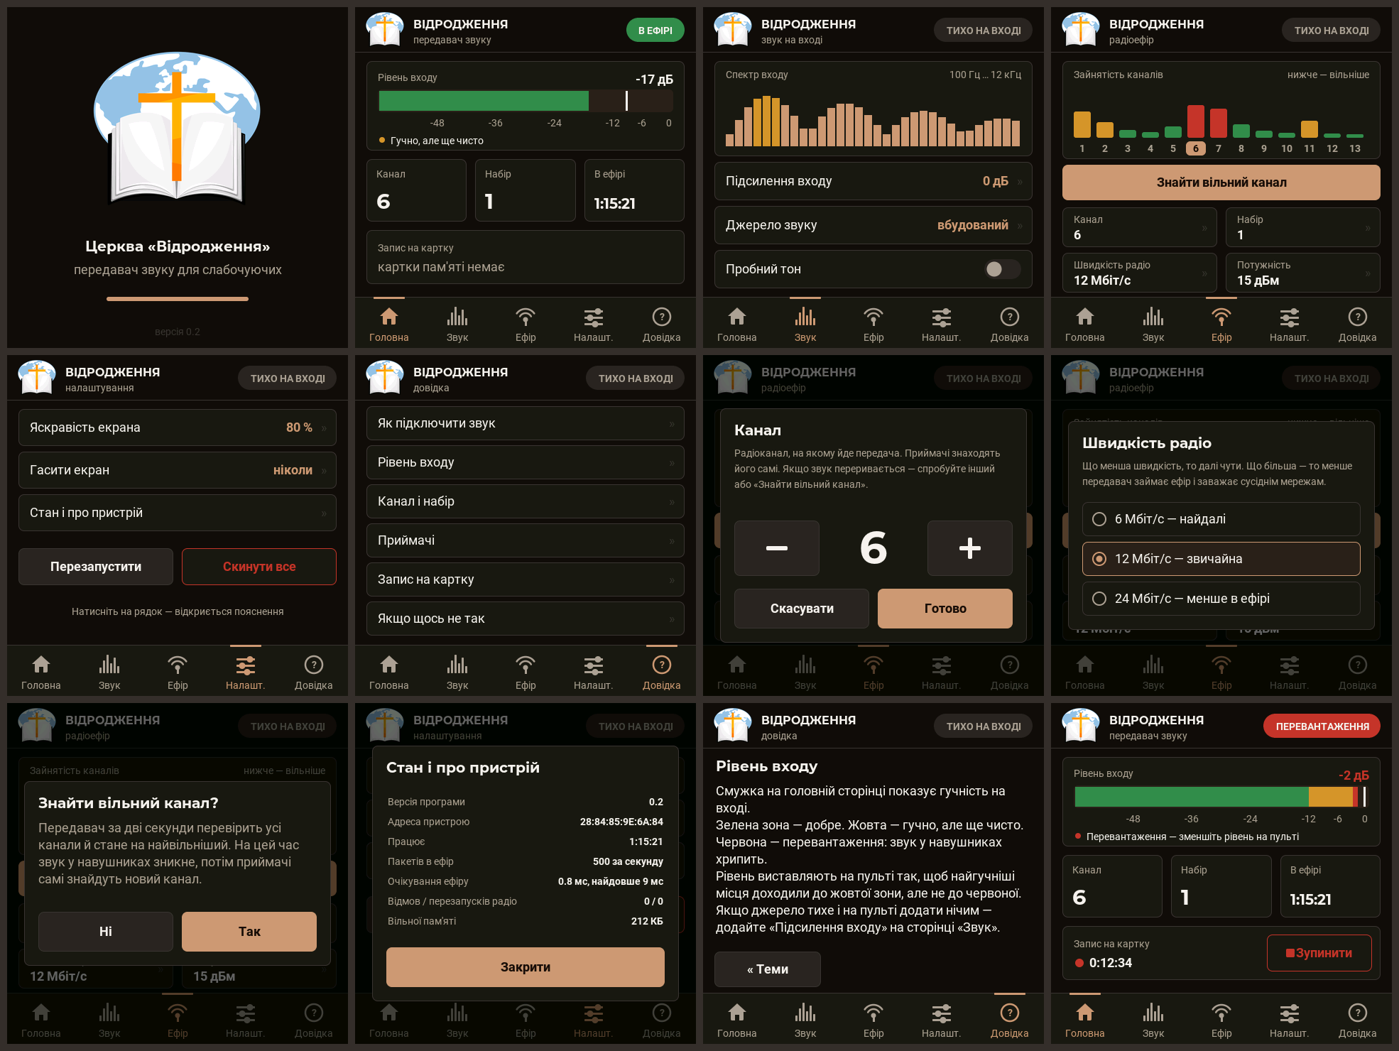
docs/menyu-peredatchika.png
