roman885-85/hearlink/docs/peredavach-english.png

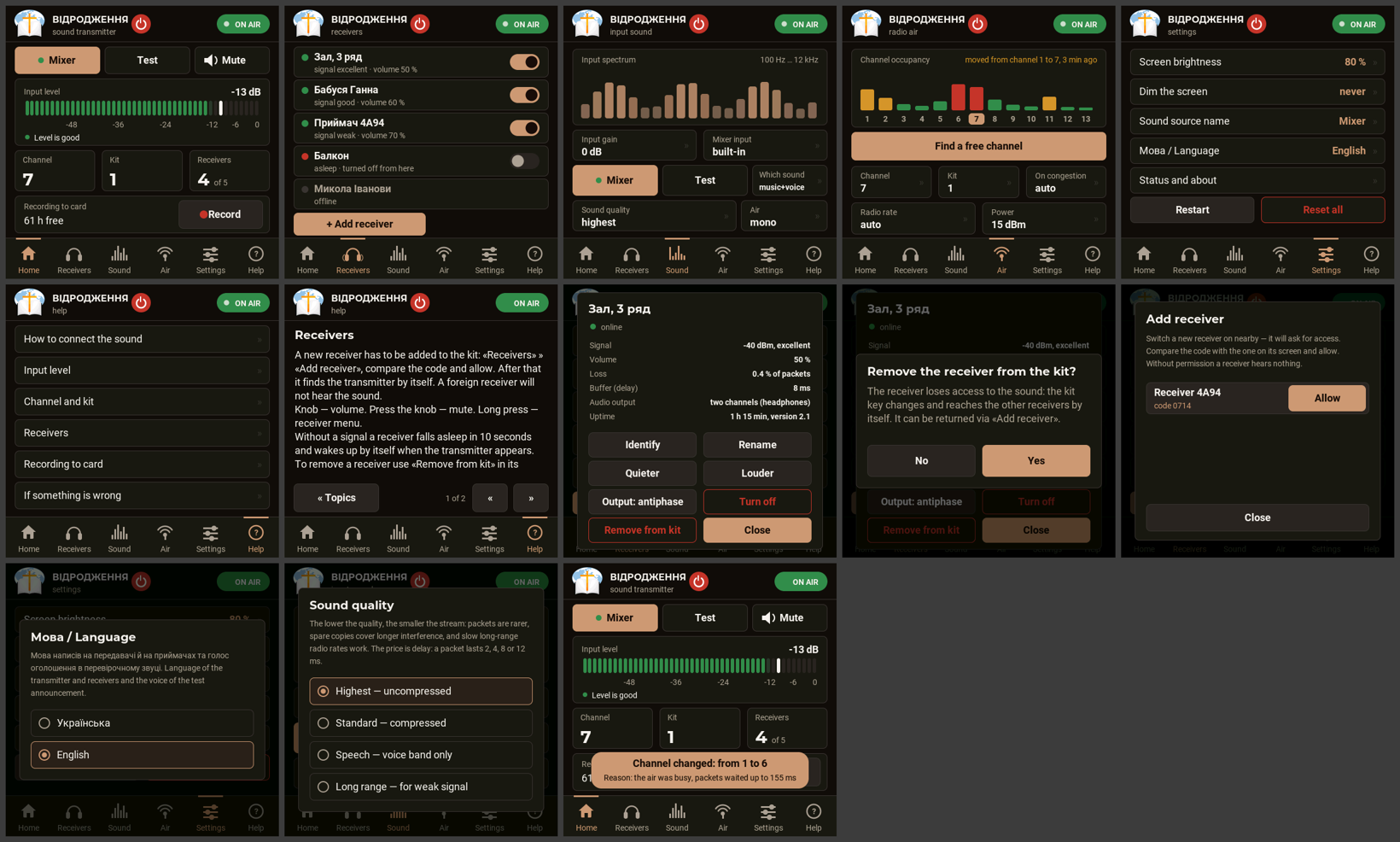
docs/peredavach-english.png
