roman885-85/hearlink/docs/peredavach-fayly-kartky.png

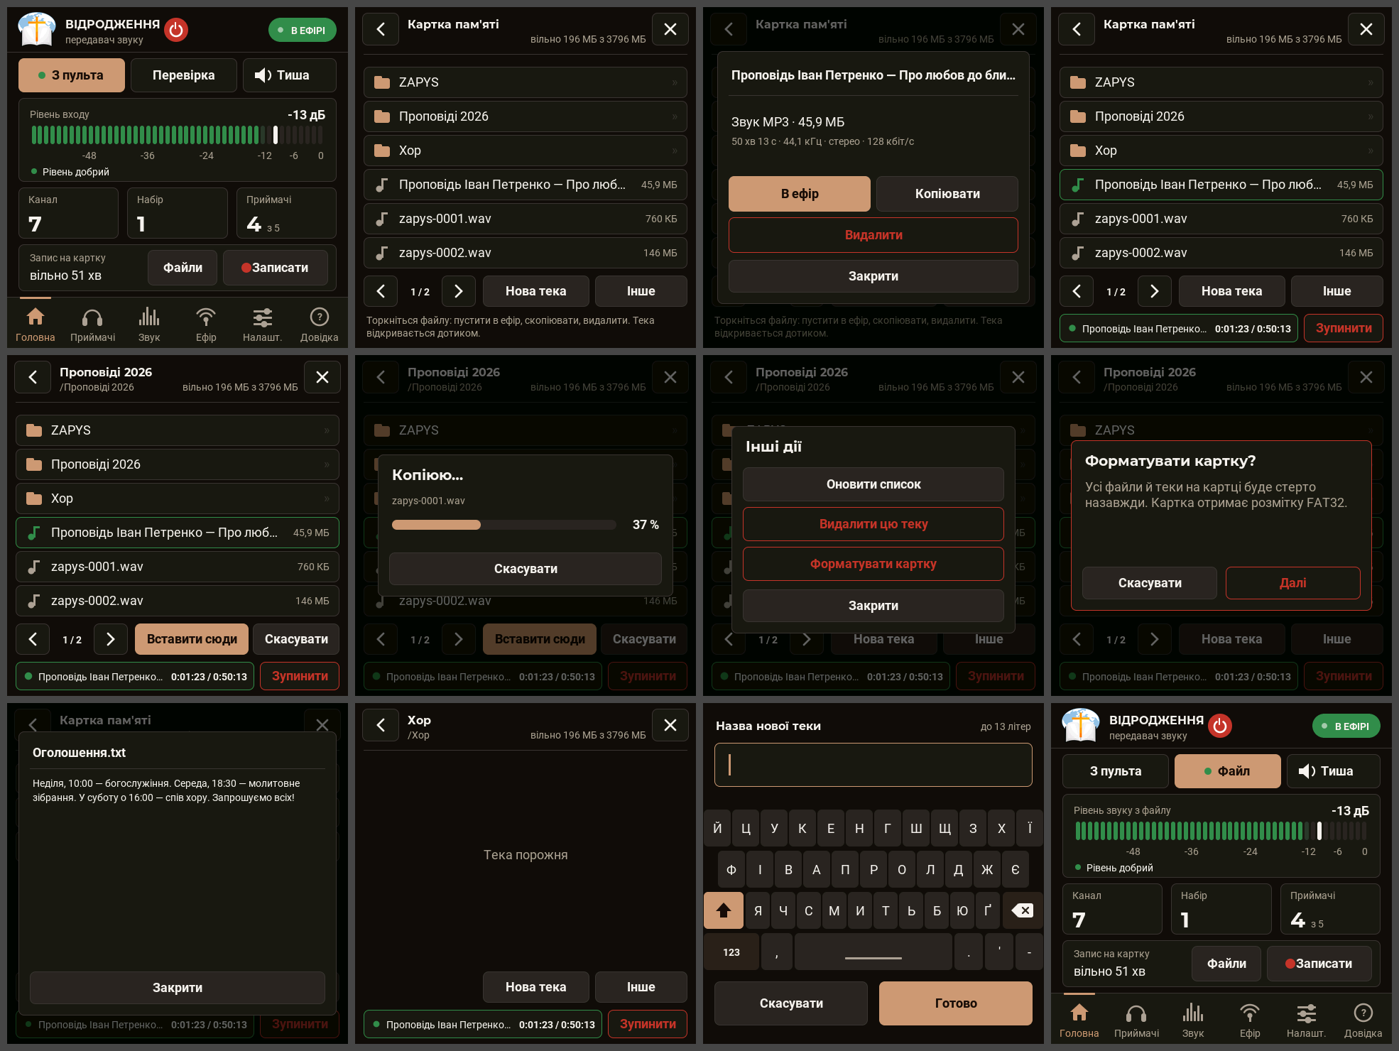
docs/peredavach-fayly-kartky.png
