roman885-85/hearlink/docs/peredavach-nalashtuvannya-dzherelo.png

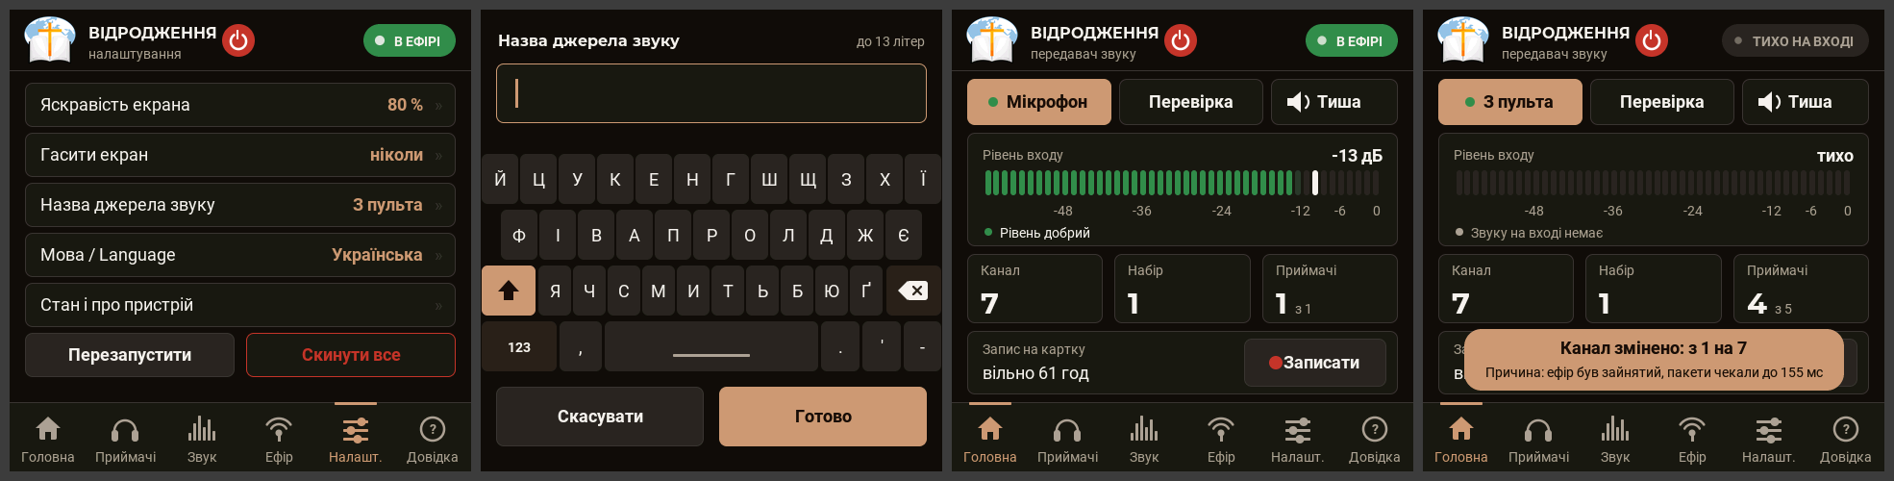
docs/peredavach-nalashtuvannya-dzherelo.png
