roman885-85/hearlink/docs/peredavach-novi-ekrany.png

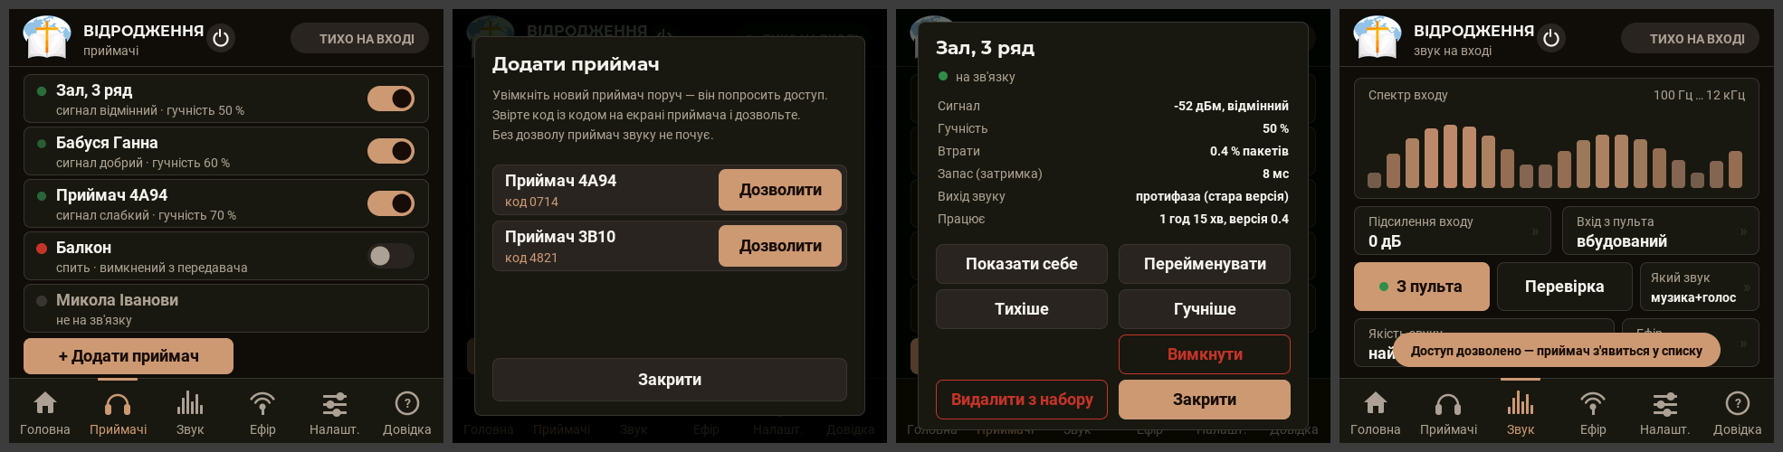
docs/peredavach-novi-ekrany.png
