roman885-85/hearlink/docs/peredavach-zhyvi-vognyky.png

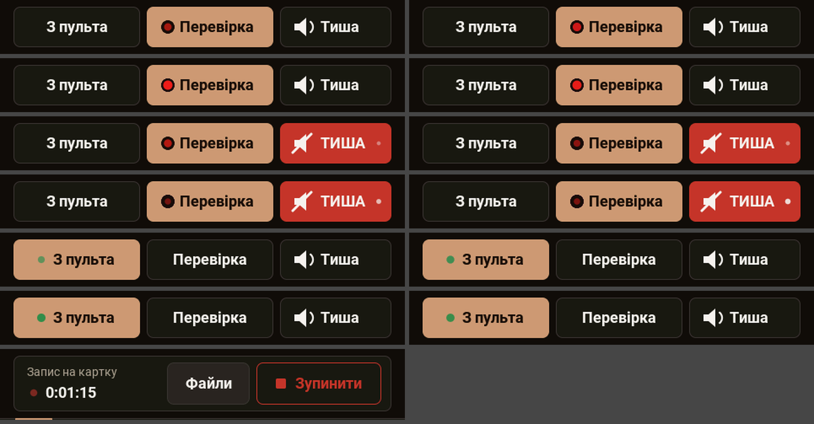
docs/peredavach-zhyvi-vognyky.png
