roman885-85/hearlink/docs/photos/yd-rp2040-flat.jpg

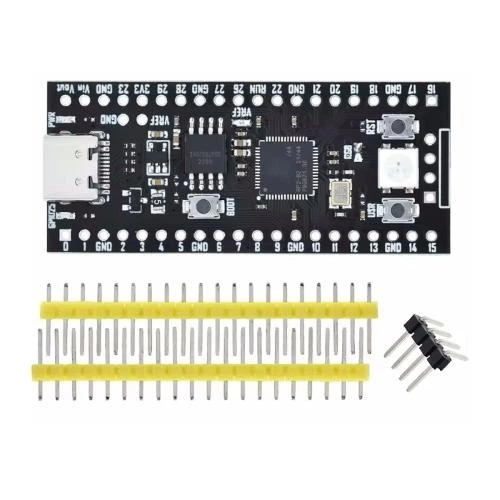
docs/photos/yd-rp2040-flat.jpg
