roman885-85/hearlink/docs/pryimach-ekrany-kadry.png

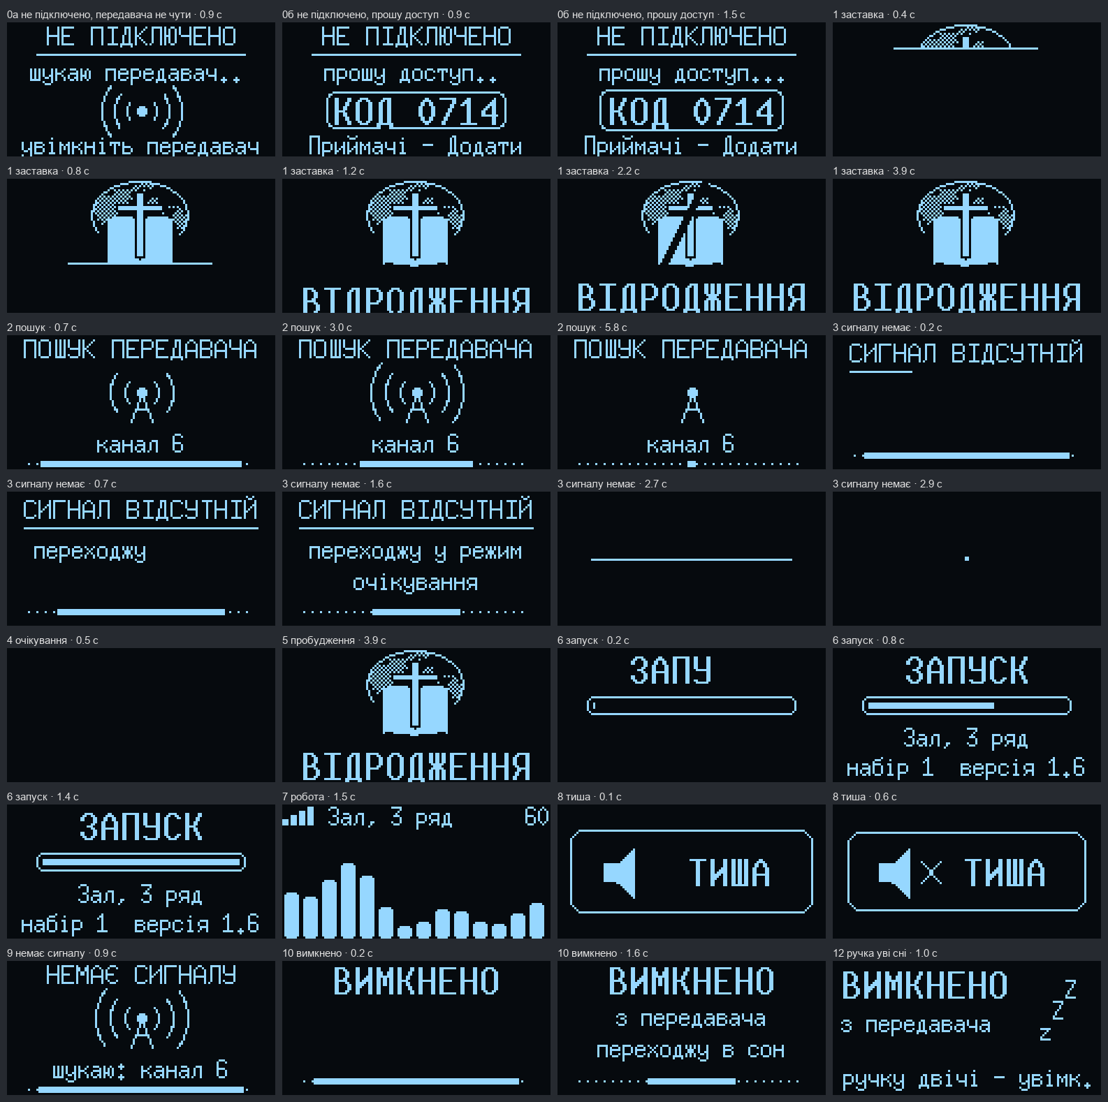
docs/pryimach-ekrany-kadry.png
