roman885-85/hearlink/docs/pryimach-ekrany.gif

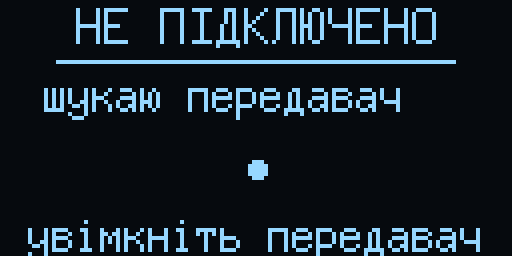
docs/pryimach-ekrany.gif
