roman885-85/hearlink/docs/skhema-peredatchik-4848-pcm1808.png

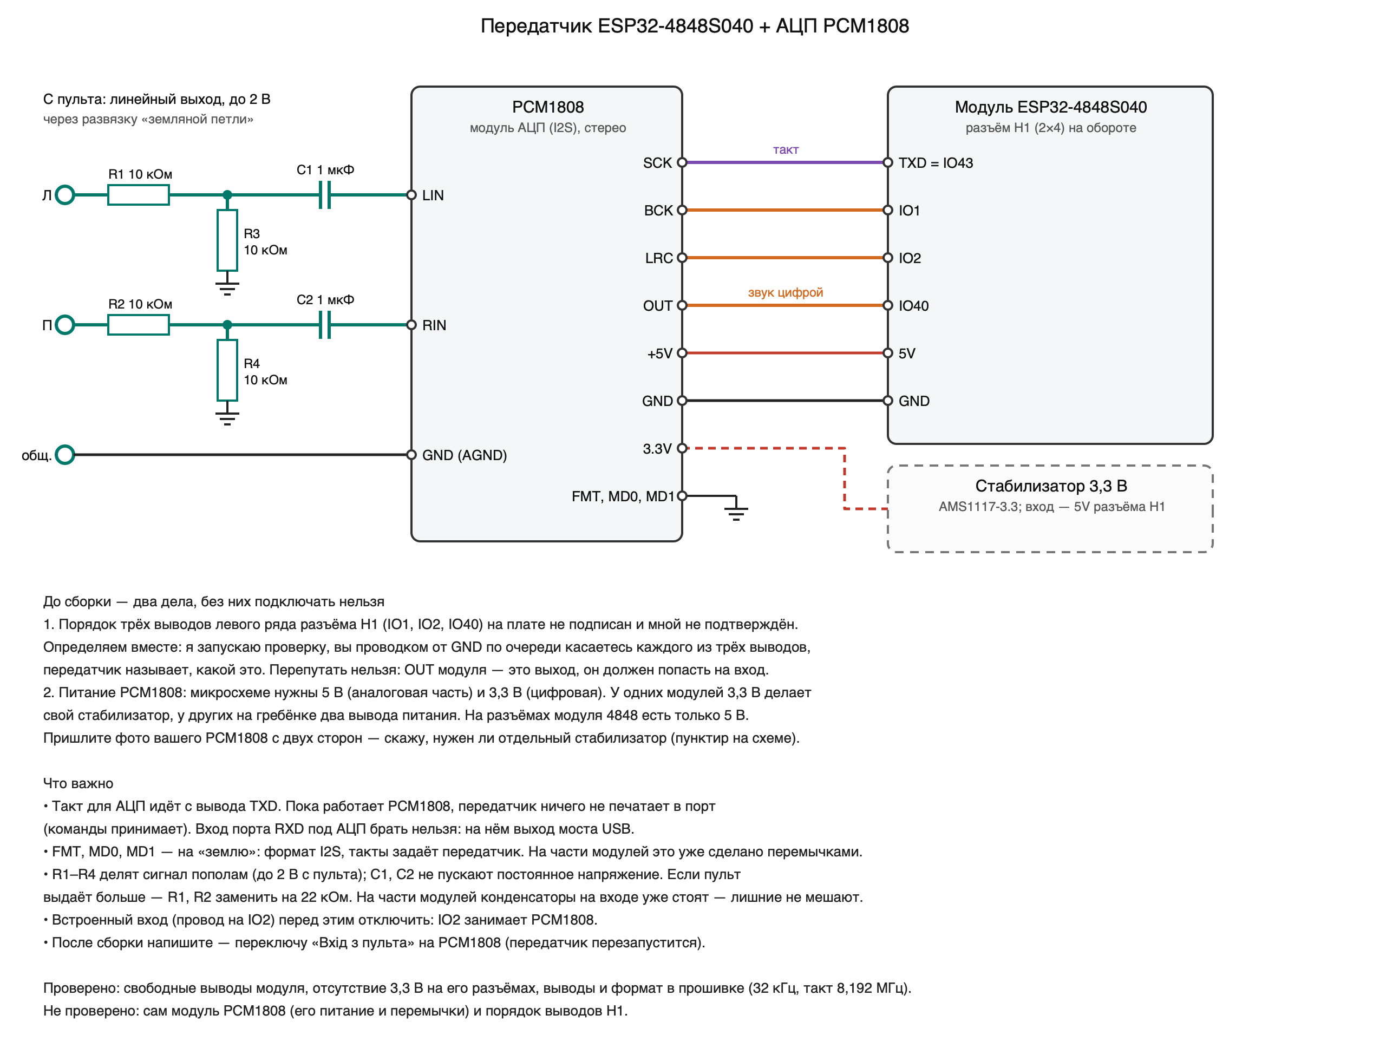
docs/skhema-peredatchik-4848-pcm1808.png
