roman885-85/hearlink/docs/skhema-peredatchik.png

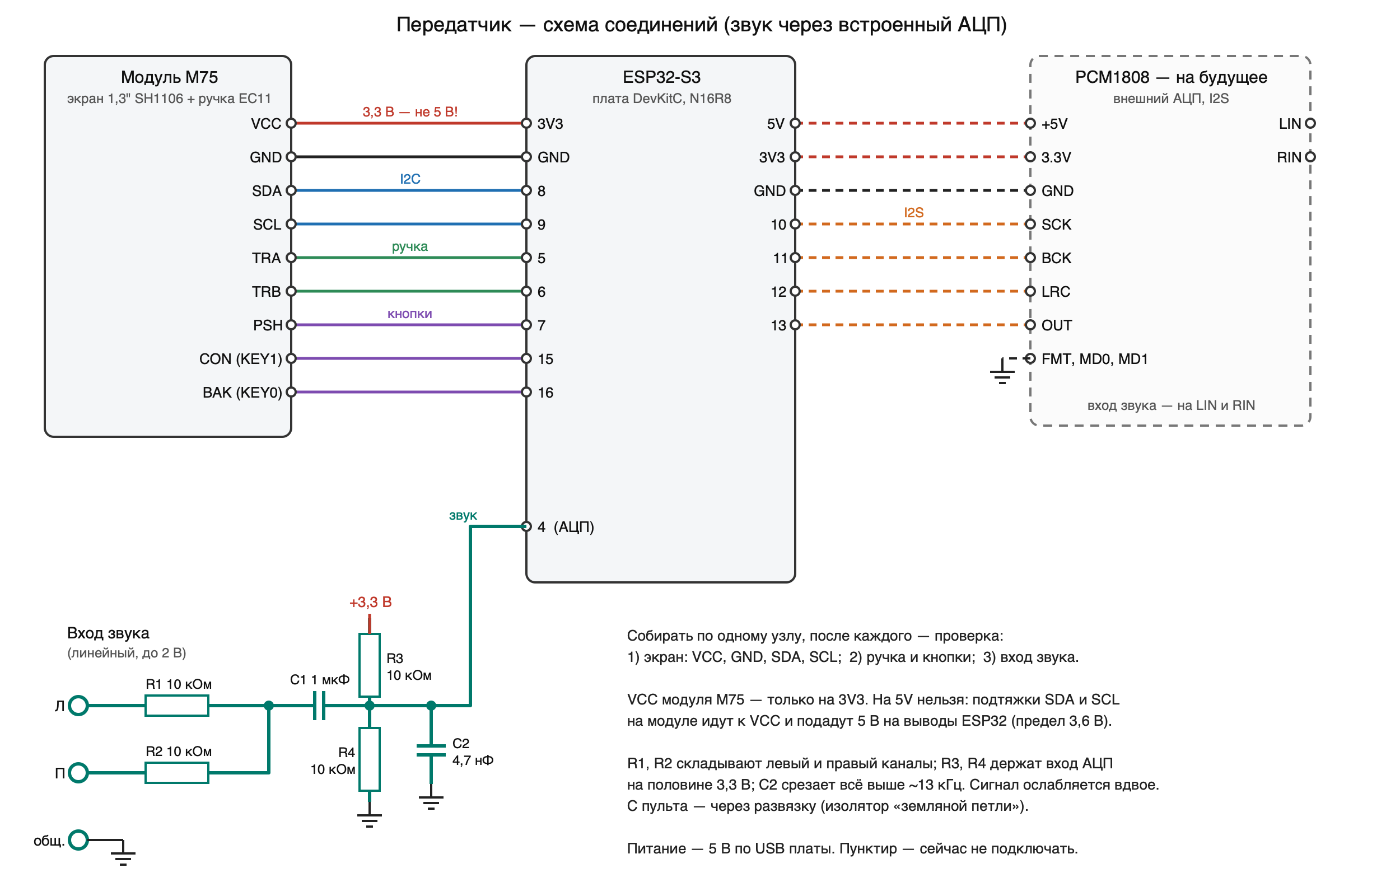
docs/skhema-peredatchik.png
