roman885-85/hearlink/docs/skhema-priemnik-esp32.png

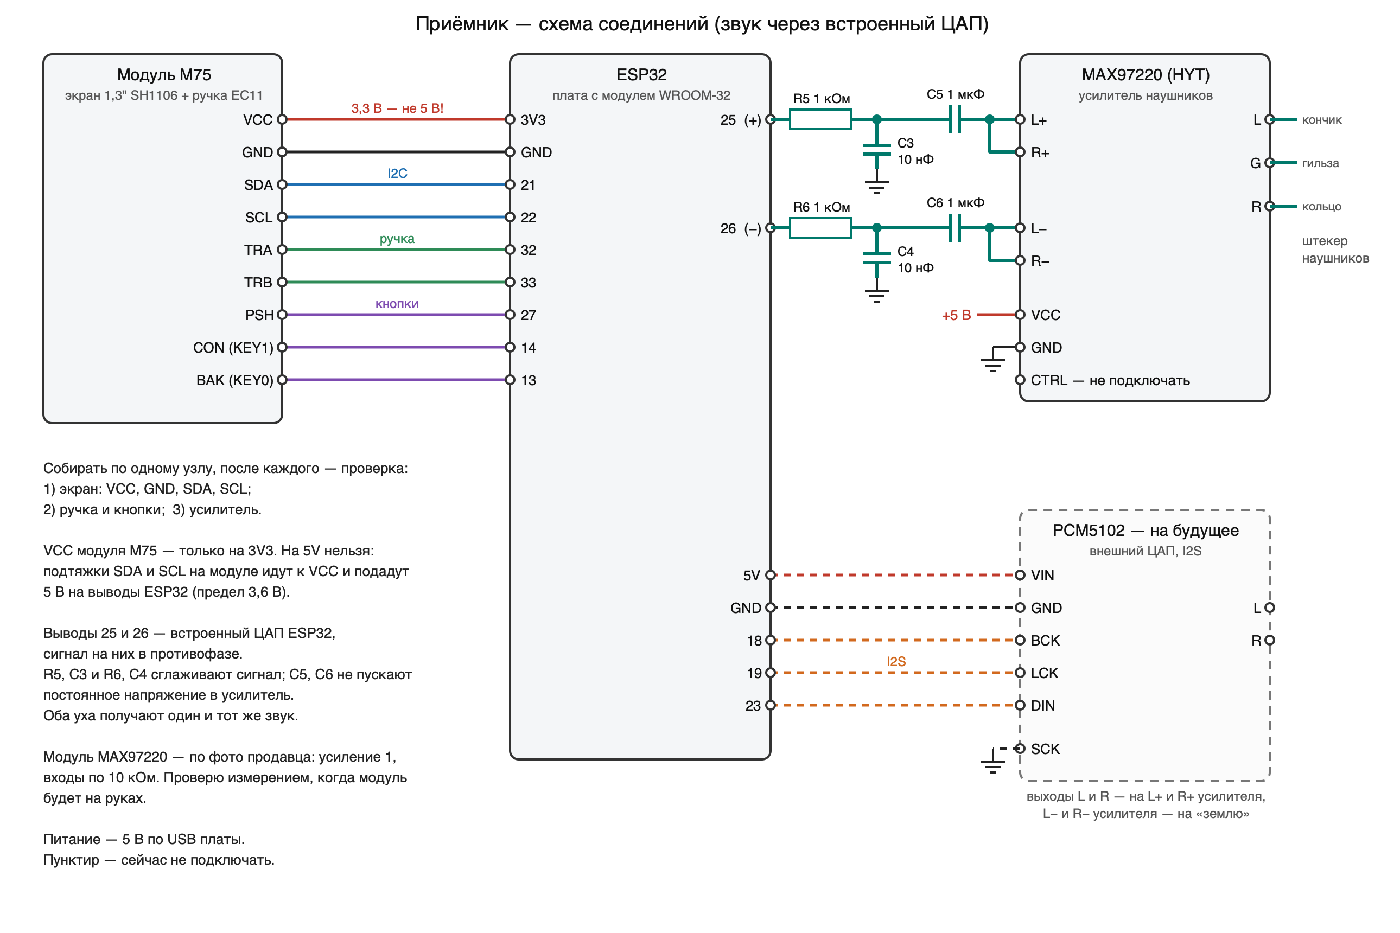
docs/skhema-priemnik-esp32.png
