roman885-85/hearlink/hearlink/config.h

// Общие настройки набора: частота звука, размер пакета, выводы плат.
#pragma once
#include <Arduino.h>

#define FW_VERSION "4.00"
#define SRATE 32000        // отсчётов звука в секунду
#define FRAME 64        // отсчётов в одном куске звука (2 мс); пакет набирается из 1–6 кусков — см. качество
#define MAGIC 0x4C48    // «HL» — по этим байтам свои пакеты отличаются от чужих
#define PROTO_VER 4

#if CONFIG_IDF_TARGET_ESP32S3
// модуль M75: экран SH1106 + ручка EC11 + две кнопки
#define PIN_SDA 8
#define PIN_SCL 9
#define PIN_ENC_A 5
#define PIN_ENC_B 6
#define PIN_ENC_SW 7
#define PIN_KEY_CON 15
#define PIN_KEY_BAK 16
// звук встроенными средствами
#define PIN_ADC_DEVKIT 4     // вход передатчика (ADC1) на обычной плате S3
#define PIN_ADC_4848 2       // то же на модуле ESP32-4848S040: свободны только IO1, IO2, IO40
#define PIN_OUT_P 17    // выход приёмника «+» (PDM)
#define PIN_OUT_N 18    // выход приёмника «−» (PDM, в противофазе)
// внешние модули I2S — на будущее
#define PIN_I2S_MCLK 10
#define PIN_I2S_BCK 11
#define PIN_I2S_WS 12
#define PIN_I2S_DIN 13  // от PCM1808 (передатчик)
#define PIN_I2S_DOUT 13 // к PCM5102 (приёмник)
#define PIN_DAC_XSMT 14 // приёмник: «звук включён» для PCM5102 (вывод XSMT модуля) — высокий, пока выход работает
// Приёмник: перемычка с этого вывода на «землю» — цветной экран IPS 1,9″, вывод свободен (подтянут к питанию) — OLED
// (с 3.13; владелец 15.10: «дисплеи переключать отдельным свободным пином на землю… если не подключен к земле, то oled
// (по умолчанию)», «через меню нет смысла переключать, если изначально использовать только цветной дисплей без
// подключенного олед»). 21 — на той же гребёнке, что выводы цветного экрана (39–42, 1, 2) и GND; не загрузочный, не
// связан с памятью (47, 48 у плат с октальной памятью могут быть на 1,8 В; 38/48 — светодиод у разных выпусков платы).
#define PIN_RX_COLOR 21
// То же на модуле ESP32-4848S040: выводы 10–13 там заняты экраном. Свободных три (IO1, IO2, IO40), PCM1808 нужно
// четыре. Четвёртым берётся ВЫХОД порта (TXD, IO43) под такт АЦП: это выход процессора, спорить ему не с кем —
// мост USB на нём только слушает. Вход порта (RXD, IO44) брать под данные АЦП нельзя: на нём сидит выход моста
// USB, два выхода на одном проводе. Цена: пока работает PCM1808, передатчик ничего не печатает в порт
// (команды принимает по-прежнему).
#define PIN_I2S_MCLK_4848 43
#define PIN_I2S_BCK_4848 1
#define PIN_I2S_WS_4848 2
#define PIN_I2S_DIN_4848 40
#else
#error "Пока собирается только для ESP32-S3 (у обычного ESP32 другие драйверы АЦП и PDM — добавим отдельно)"
#endif

// Сколько миллисекунд прошло с отметки t. Отметку может обновить другая задача (приём, передача) уже после того,
// как здесь прочитали время: разность выходит «минус одна миллисекунда» и без знака превращается в 49 суток.
// Так сторож радио несколько раз в минуту ложно перезапускал радио, а приёмник уходил искать канал (06.10).
static inline uint32_t msSince(uint32_t t, uint32_t now) {
  int32_t d = (int32_t)(now - t);
  return d < 0 ? 0 : (uint32_t)d;
}
static inline uint32_t msSince(uint32_t t) {
  return msSince(t, millis());
}

// какая плата: от этого зависят выводы и экран
enum { BOARD_DEVKIT = 0, BOARD_4848 = 1 };

// вход и выход звука
enum { IN_ADC = 0, IN_I2S = 1 };
enum { OUT_PDM = 0, OUT_I2S = 1, OUT_CS4344 = 2 };   // выход приёмника: однобитный на выводах 17/18 · ЦАП PCM5102 · ЦАП CS4344 (с 2.85)

// проверочный звук передатчика
enum { TEST_OFF = 0, TEST_TONE, TEST_VOICE, TEST_ALL, TEST_MUSIC, TEST_DUCK, TEST_LR, TEST_COUNT };   // 3 — голос и музыка по кругу, 5 — музыка с объявлением каждые 30 с

// качество звука в эфире (подробно — в proto.h); больше номер — меньше поток и дальше связь
enum { Q_HI = 0, Q_STD, Q_SPEECH, Q_FAR, Q_COUNT };
// «Монітор» (с 23.10): 48 кГц, 24 бита без сжатия, двойной пакет раз в 4 мс — для мониторинга звучания инструментов
// (владелец 22.10: «очень важно максимально близкое звучание от исходного»). Вне лестницы качеств (QDEF, Q_COUNT):
// скорость его не понижает; идёт только со входа моста (мост даёт 48 кГц, BP_OUT48).
#define Q_MON 4
#define MON_RATE 48000
#define MON_N 96   // отсчётов в кадре 2 мс

// настройки, которые хранятся в плате
struct Settings {
  bool isTx = false;
  uint8_t kit = 1;        // номер набора
  uint8_t channel = 6;    // канал Wi-Fi 1–13
  uint8_t rateIdx = 2;    // см. RATES в radio.h (2 — 5,5 Мбит/с)
  int8_t powerDbm = 15;
  uint8_t input = IN_ADC;
  uint8_t output = OUT_PDM;
  uint8_t tone = 0;       // передатчик: проверочный звук вместо входа — см. TEST_… ниже
  uint8_t depthMs = 0;    // приёмник: запас, мс; 0 — подбирается сам
  uint8_t volume = 16;    // приёмник: шаг громкости 0–20 (20 — звук как есть, шаг 2 дБ; до 2.40 «как есть» был шаг 12)
  bool autoChannel = true; // приёмник сам ищет канал своего набора
  uint8_t board = BOARD_DEVKIT;
  int8_t gainDb = 0;       // передатчик: подсиление входа, дБ
  uint8_t brightness = 80; // экран передатчика, %
  uint8_t dimIdx = 0;      // гасить экран: 0 никогда, 1 — через 1 мин, 2 — 5 мин, 3 — 15 мин
  uint8_t reserve[13] = {}; // запас
  char name[28] = "";      // приёмник: имя, которое ему дали с передатчика (пусто — «Приймач XXXX»)
  uint8_t off = 0;         // приёмник выключен с передатчика
  uint8_t rateAuto = 1;    // передатчик сам выбирает скорость радио по тому, как его слышат приёмники
  uint8_t quality = Q_HI;  // передатчик: качество звука в эфире
  // проверочный звук передатчика
  uint8_t testTrack = 0;   // какая мелодия: 0 — по очереди, иначе её номер
  uint8_t duckS = 30;      // «музыка с объявлением»: голос раз в столько секунд
  int8_t duckDb = -16;     // на сколько музыка тише, пока говорит голос, дБ
  uint8_t voiceGapS = 2;   // режим «голос»: пауза между повторами, с
  int8_t musicDb = 0;      // громкость музыки, дБ
  int8_t voiceDb = 0;      // громкость голоса, дБ
  uint8_t stereo = 0;      // передатчик: слать в эфир стерео, когда источник стереофонический
  uint8_t rxStereo = 1;    // приёмник: на двух выводах левый и правый канал (наушники напрямую, стерео-усилитель);
                           // 0 — один звук в противофазе (усилитель с разностным входом). По умолчанию два канала:
                           // с наушниками, подключёнными напрямую, противофаза звучит «наизнанку», и заметить это трудно
  uint8_t lastTone = TEST_DUCK;   // передатчик: какой проверочный звук включает кнопка «Перевірка» (последний выбранный)
  uint8_t txMute = 0;      // передатчик: тишина в эфире (владелец, 07.10: «запоминать последние настройки»)
  uint8_t autoHop = 1;     // передатчик: при затяжном заторе самому искать более свободный канал и переходить на него
  uint8_t lang = 0;        // язык надписей: 0 — українська (основной), 1 — English. Приёмник берёт его у передатчика
  char srcName[28] = "";   // передатчик: как назван источник звука (пусто — «З пульта»); владелец 07.10: «добавить функцию
                           // переименования источника звука»
  uint8_t dbgAir = 0;      // передатчик: отладка по радио — строки порта всех устройств набора видны в порту любого из них
  char nameLong[66] = "";  // приёмник: имя до 32 букв (с 2.19). Прежнее поле name (13 букв) осталось на месте — настройки
                           // записаны в плату одним куском, и раздвинуть поле в середине значило бы их испортить
                           // (владелец 07.10: «данная функция опционально должна включаться в настройках»)
  // ---- приёмник, с версии 2.32: меню «для слуха и удобства» (владелец 07.10 выбрал пункты из предложенного списка).
  // Каждую из них можно сменить и ручкой приёмника, и с передатчика (окно приёмника → «Налаштування»).
  uint8_t rxClarity = 0;   // чёткость речи: подъём верхних частот (выше ~1,5 кГц): 0 — нет, 1…3 — +4, +8, +12 дБ
  int8_t rxBalance = 0;    // баланс: −5…+5 (минус — громче левое: правое тише на 3 дБ за шаг); только при выходе «2 канали»
  uint8_t rxVolMax = 20;   // предел громкости, шаг 1…20: потолок шкалы — 100 % на ручке звучит как этот шаг (с 2.41;
                           // раньше выше него громкость просто не поднималась)
  uint8_t rxView = 0;      // вид главного экрана: 0 — спектр, 1 — стрелочные индикаторы, 2 — крупная громкость
  uint8_t rxLed = 2;       // светодиод: 0 — выключен, 1 — слабо, 2 — обычно, 3 — ярко
  uint8_t rxLang = 0;      // язык надписей: 0 — как у передатчика, 1 — українська, 2 — English
  uint8_t volScale = 1;    // шкала громкости: 1 — «100 % = звук как есть» (с 2.40). В записи от прежней версии поля нет —
                           // по этому признаку громкость и её предел один раз пересчитываются (см. settingsLoad)
  uint8_t autoUpd = 1;     // передатчик: сам обновляет по радио приёмники со старой прошивкой, когда они выходят на связь
  // приёмник, с 2.45: эквалайзер (настраивается с передатчика). Пять полос, значение 0…12 = −12…+12 дБ шагом 2 (6 — ровно):
  // 125 Гц (низ, «полка»), 400 Гц, 1 кГц, 2,5 кГц, 6 кГц (верх, «полка»). И срез низов ниже 100 Гц (1 — включён).
  uint8_t rxEq[5] = { 6, 6, 6, 6, 6 };
  uint8_t rxLowCut = 1;
  // передатчик, с 2.45: эквалайзер входа — тот же набор полос, действует на звук с пульта для всех приёмников сразу
  uint8_t txEq[5] = { 6, 6, 6, 6, 6 };
  uint8_t txLowCut = 0;
  // приёмник, с 2.46: блокировка ручки с передатчика (владелец 08.10: «полное удаленное управление приемниками с
  // передатчика, включая блокировку управления, громкости или меню»): 0 — нет, 1 — меню (долгое нажатие), 2 — громкость
  // (поворот и «тиша» нажатием), 3 — всё. С передатчика при этом всё меняется по-прежнему.
  uint8_t rxLock = 0;
  // приёмник, с 2.48: цифровое усиление сверх «звука как есть» (владелец 09.10: «требуется добавить цифровой настраиваемый
  // буст громкости на приемниках — усилитель наушников не очень вытягивает громкость»): 0…12 = 0…+24 дБ шагом 2.
  // Тихий звук усиливается полностью, громкий — насколько есть место до полной шкалы (см. rxaudio.h, «придержка»).
  uint8_t rxBoost = 0;
  // с 2.68: обработка «для слуха» (nsfx.h; владелец 11.10: «требуется активное шумоподавление… на передатчике и
  // приемниках», «при сильном усилении возникают завалы в звуке», «с настройками и включением\отключением функций»).
  // Шумозаглушение: 0 — выключено, 1…3 — слабое / среднее / сильное. У передатчика — звук со входа, сразу для всех
  // приёмников; у приёмника — свой выбор слушателя.
  uint8_t txNs = 0;
  uint8_t rxNs = 0;
  // Сжатие приёмника — как ведёт себя усиление у края шкалы: 0 — как до 2.68 (множитель и ограничитель, после громкого
  // звук «проваливается»), 1 — лёгкое, 2 — среднее, 3 — сильное.
  uint8_t rxComp = 1;
  // В паузах (приёмник): 0 — ничего, 1 — усиление снять, 2 — и приглушить ещё на 6 дБ, 3 — на 12 дБ.
  uint8_t rxGate = 0;
  // с 2.72 (владелец 11.10: «добавить настройки для шумодавов»): чувствительность шумозаглушения 0…4 (по умолчанию 2 —
  // средняя) у передатчика и приёмника; порог паузы 0…4 = на 3 / 6 / 9 / 12 / 15 дБ над шумом (по умолчанию 6);
  // скорость закрытия паузы 0…2 = быстро / средне / медленно.
  uint8_t txNsSens = 2;
  uint8_t rxNsSens = 2;
  uint8_t rxGateThr = 1;
  uint8_t rxGateRel = 1;
  uint8_t rateTop = 255;   // передатчик: скорость, выбранная вручную (номер в RATES); 255 — не выбрана («сама»).
                           // С 2.78 это ВЕРХНЯЯ ступень: ради слабого приёмника передатчик сам опускается с неё до
                           // 1 Мбит/с и возвращается (rateAutoTick в txpeers.h); работает он на cfg.rateIdx
  uint8_t rateLadder = 1;  // передатчик (с 2.83): ради слабого приёмника опускаться до 1 Мбит/с (1) или держать выбранную
                           // скорость и качество всегда (0) — настройка «Слабкий сигнал» на странице «Ефір». Владелец
                           // 12.10: «качество и скорость трансляции не переключается» — дальний приёмник держал нижнюю
                           // ступень, и выбор на экране ничего не менял, а выключить это можно было только с порта
  // приёмник, с 3.03 (владелец 15.10: цветной экран «опционально вместо текущего»): экран — 0 — OLED SH1106 1,3″ (модуль
  // M75), 1 — цветной IPS 1,9″ ST7789 320×170 по SPI (rxlcd.h); яркость 1…5 (подсветка цветного, у OLED — контраст);
  // свойства цветного модуля: бит 0 — повёрнут на 180°, бит 1 — порядок цветов BGR, бит 2 — шина 80 МГц (иначе 40)
  uint8_t rxDisp = 0;       // до 3.13 — тип экрана настройкой; с 3.13 не используется (тип задаёт перемычка PIN_RX_COLOR)
  uint8_t rxBright = 3;
  uint8_t rxDispOpt = 0;
  // передатчик, с 3.17: шумовой порог входа (txaudio.h, TxGate). Владелец 16.10: «имеется ровный фоновый шум в виде
  // шипения с передатчика… остается программный метод», «при проверочном звуке шипение полностью отсутствует, а значит
  // причина точно в adc», «функции настраиваемые должны быть». В паузах звук со входа убавляется (или глушится совсем),
  // пока он не громче шума входа на заданный порог; шум входа передатчик меряет сам.
  uint8_t txGate = 0;      // 0 — выключен; в паузах тише на 1 — 12 дБ, 2 — 20, 3 — 30, 4 — тишина
  uint8_t txGateThr = 2;   // порог: 0…4 — звук громче шума входа на 3 / 6 / 9 / 12 / 15 дБ
  uint8_t txGateRel = 1;   // закрытие: 0 — быстро, 1 — средне, 2 — медленно (держится 60 / 150 / 300 мс, гаснет 60 / 150 / 400 мс)
  int8_t txGateDb = 0;     // ручной порог, дБ от полной шкалы (−80…−30); 0 — порог от шума входа (txGateThr)
  // передатчик, с 3.18: ограничитель пиков входа (txaudio.h, TxLim). Владелец 16.10: «при перегрузах на входе начинается
  // треск на выходе. Нужно, чтобы передатчик выполнял компрессию звука в таких пиках, чтобы при завышенном входе, на
  // выходе был максимально громкий звук без искажений и треска».
  uint8_t txLim = 1;       // 0 — выключен (вход идёт как раньше: эквалайзер и подсиление с упором в край шкалы), 1 — включён
  uint8_t txLimCeil = 1;   // потолок: 0…3 — −0,5 / −1 / −2 / −3 дБ от полной шкалы
  uint8_t txLimComp = 1;   // сжатие пиков ниже потолка: 0 — нет (только ограничитель), 1 — лёгкое, 2 — среднее, 3 — сильное
  uint8_t txLimRel = 1;    // отпускание: 0 — быстро (40 мс), 1 — средне (120 мс), 2 — медленно (300 мс)
  // передатчик, с 4.00 («Next Edition», мост на Raspberry Pi Pico — bridge/, txbridge.h): какой вход играет мост.
  // Владелец 21.10: «вместо пульта название аналоговый вход и отдельно кнопка цифровой вход».
  uint8_t bridgeSrc = 1;   // 1 — цифровой вход (AES3 с пульта), 2 — аналоговый (PCM1808), 4 — USB (компьютер, с 22.10); как BP_SRC_* в bridge_proto.h.
                           // Сначала — цифровой: у владельца при переходе на 4.00 играл он (мост сам выбрал AES)
  uint8_t brAutoUpd = 1;   // мост с другой версией — передатчик сам ставит ему программу из своей прошивки (txbridge.h)
  // Аналоговый вход моста — симметричный (с 22.10, BP_PCM_DIFF в bridge_proto.h): мост берёт разность каналов PCM1808
  // (Л − П) / 2 в оба канала — моно. Гул «земли» одинаков в обоих проводах и вычитается (замер 22.10: 250 Гц −22…−34 дБ,
  // шум в тишине −81 → −89 дБ). Для симметричного выхода пульта (XLR: 2 → Л, 3 → П, 1 → земля) и для стерео, у
  // которого один канал пришёл перевёрнутым (у владельца 22.10 — так: каналы в противофазе, бас в разности +23 дБ).
  uint8_t pcmDiff = 0;
  // Гул радио передатчика на аналоговом входе моста — вычитать (с 23.10, BP_PCM_HUM, bridge/src/hum.h): импульсы тока
  // радио (250 Гц, −81 дБ в тишине) мост учит в паузах и вычитает — на записях 22.10 линия 250 Гц −81 → −100…−117 дБ,
  // музыка не меняется ни на бит. Выключатель — окно «Аналоговий вхід» (варианты «… як є») и порт C12 / C13.
  uint8_t pcmHum = 1;
  // новые настройки добавлять в конец: запись от старой версии короче, и прежние поля не слетают
};
extern Settings cfg;
