roman885-85/hearlink/hearlink/hearlink.ino

// Набор для слабослышащих: передатчик звука и приёмники с наушниками.
//
// Одна прошивка на все платы. Роль (передатчик или приёмник) и настройки хранятся в плате.
// Порт 115200, команды строкой:
//   ?            — что сейчас настроено
//   t / r        — сделать плату передатчиком / приёмником (перезапуск)
//   k<0–255>     — номер набора           c<1–13> — канал        c0 — приёмник ищет канал сам
//   v<скорость>  — 0.5 1 2 5.5 11 6 9 12 18 24 36 48 54 Мбит/с, v0 — сама      p<2–20> — мощность, дБм
//   g<0–6>       — передатчик: проверочный звук вместо входа (1 тон, 2 голос, 3 голос и музыка, 4 музыка,
//                  5 — музыка, раз в N с уходит в фон под голос, 6 — проверка каналов: гудок слева, два справа)
//   q<0–3>       — передатчик: качество звука (0 найвища, 1 стандартна, 2 мова, 3 дальня)
//   w<0|1>       — передатчик: стерео в эфир (идёт, когда источник стереофонический); приёмник: выход стерео
//                  (левый и правый на двух выводах) вместо моно в противофазе
//   W<0|1>       — передатчик: первому приёмнику на связи — выход «протифаза» / «два канали»
//   V<0–20>      — передатчик: первому приёмнику на связи — громкость
//   X            — передатчик: первому приёмнику на связи — проверка выхода на слух (пять состояний по 6 с,
//                  перед каждым гудки с его номером; то же — «Показати себе» дважды подряд)
//   y<№> <знач.> — передатчик: настройки проверочного звука: 1 — мелодия (0 по очереди), 2 — объявление раз в N с,
//                  3 — музыка под голосом, дБ, 4 — пауза между повторами голоса, с, 5 — громкость музыки, дБ,
//                  6 — громкость голоса, дБ
//   a<0|1>       — передатчик: вход — встроенный АЦП / внешний PCM1808 (перезапуск)
//   o<0|1|2>     — приёмник: выход — PDM / внешний PCM5102 / внешний CS4344 (перезапуск)
//   d<0|4–40>    — приёмник: запас, мс (0 — сам) l<0–20> — громкость    m — тишина вкл/выкл
//   m            — передатчик: тишина в эфире вкл/выкл (пакеты идут, звука в них нет)
//   U<0–5>       — передатчик: открыть вкладку меню (для замеров времени кадра на каждой)
//   u            — проверка экрана: приёмник — экран, ручка, кнопки; передатчик — экран, сенсор, время кадра, карта
//   s            — передатчик: найти свободный канал (звук прервётся на две секунды)
//   H            — передатчик на модуле 4848S040: проверка свободных выводов IO1, IO2, IO40 (25 с)
//   P            — передатчик: список приёмников (P0 — начать счёт их сообщений заново);  I — первому из них «покажи себя»;  E<0|1> — выключить/включить его;
//                  N<имя> — дать ему имя;  E<0|1> <номер> — выключить/включить приёмник с этим номером (например E0 4C3B10)
//   b<0|1>       — плата: 0 — обычная ESP32-S3, 1 — модуль ESP32-4848S040 (перезапуск)
//   K            — защита: есть ли ключ набора, счётчики отвергнутых пакетов;  K0 — забыть ключ (приёмник попросит
//                  доступ заново; передатчик заведёт новый ключ — все приёмники придётся подключить снова)
//   J / J1 / J0  — передатчик: просьбы приёмников о доступе / открыть окно добавления на 3 минуты / закрыть
//   j<№>         — передатчик: дозволить доступ приёмнику из списка просьб
//   R<номер>     — передатчик: удалить приёмник из набора (шесть знаков номера, например R4C3B10): он теряет доступ,
//                  ключ набора меняется и сам уходит оставшимся приёмникам
//   O            — передатчик: выключить (то же, что кнопка в шапке); включает касание экрана
//   h<0|1|2|3>   — передатчик: сам уходит с занятого канала — выключить / включить; h2 — искать и перейти сейчас;
//                  h3 — шесть ближайших секунд считать «плохими» (проверка самого счёта затора);
//                  h4 — «мягкий» уход сейчас: проба лучшего по замеру канала и через минуту возврат (проверка хода);
//                  h без числа — состояние, в том числе «мягкого» ухода и опыт работы на каналах
//   L<0|1>       — язык надписей: 0 — українська, 1 — English (ставится на передатчике, приёмники берут его сами)
//   S<имя>       — передатчик: назвать источник звука (надпись на кнопке вместо «З пульта»); S без имени — вернуть
//   D            — передатчик: что с картой памяти (отвечает ли, объём, разметка)
//   C…           — передатчик 4.x, мост: C — его стан; C1 — цифровой вход, C2 — аналоговый, C7 — USB (компьютер);
//                  C3…C6 — проверочный сигнал моста (нет, тон, розовый шум, развёртка); C8 — журнал моста; C9 — обновить мост сейчас;
//                  C10 / C11 — аналоговый вход стерео / симметричный (разность каналов, моно — гул «земли» вычитается)
//   B            — самопроверка шифра и замер его времени на плате
//   M / M1 / M0  — передатчик: обновление прошивки приёмников по радио (ota.h) — состояние / начать / отменить
//   Q            — передатчик: «чёрный ящик» радио (bbox.h) — счётчики, последний слепок, события этой минуты;
//                  Q0…Q3 — до какой ступени оживлять вставшее радио, Q7/Q8/Q9/Q6 — проверить ступени на здоровом
//   Ut<№> / Uk   — передатчик: «нажать» кнопку с этим номером (49 — клавиатура имени источника) / что набрано на клавиатуре
//   Ux…          — передатчик: «касание» экрана без пальца: Ux<x>,<y>,<мс>[,<сдвиг>] или серия
//                  Ux<пауза мс>:<x>,<y>,<мс>;<x>,<y>,<мс>;…  (проверка клавиатуры: скорость, уход пальца при отрыве)
//   G1 / G0 / G  — передатчик: отладка по радио; «@884A94 ?» — команда другому устройству набора
extern "C" {   // закрытая библиотека радиочасти: только чтение её показаний (опыты, команда Qn)
int phy_get_noise_floor(void);
int read_hw_noisefloor(void);
uint8_t phy_get_cca(void);
uint32_t phy_get_cca_cnt(uint32_t *out);
}
#include "soc/gpio_struct.h"   // для проверки настройки вывода кнопки (команда n8)
#include "hal/gpio_ll.h"       // сброс прерываний выводов при запуске
#include "driver/gpio.h"
#include "soc/i2s_struct.h"   // проверка n8=7 у приёмника с CS4344: делитель главного такта (I2S0.tx_clkm_…)
#include <Preferences.h>
#include "config.h"

Settings cfg;
static Preferences prefs;
void settingsSave();
void settingsFactory();

#include "dbgtee.h"   // с этого места Serial — порт «с ответвлением» (отладка по радио)
#include "radio.h"
#include "eq.h"       // эквалайзер — общий для входа передатчика и для приёмника
#include "txbridge.h"  // 4.x: мост на Pi Pico — входы аналоговый и цифровой (до txaudio.h: звуковая задача кладёт ему байты)
#include "txaudio.h"
#include "txpeers.h"
#include "txbrupd.h"   // 4.x: обновление моста отсюда, команды мосту, его стан в порт (после txaudio.h)
#include "rxaudio.h"
#include "rxlink.h"
#include "ota.h"      // обновление прошивки приёмников по радио
#include "ui_rx.h"
#include "dbgair.h"
#include "ui_tx.h"

void settingsSave() {
  uint32_t t0 = millis();
  prefs.putBytes("cfg", &cfg, sizeof(cfg));
  rLastNvsMs = millis();
  bbMark(BB_NVS, 0, millis() - t0);
}

// Радио не оживает (см. radioSend в radio.h): перезапустить плату без заставки и замера каналов — эфир вернётся
// через секунды. Признак «быстрый запуск» переживает перезапуск в памяти часов.
#define QUICK_BOOT 0x51424F4Fu
RTC_NOINIT_ATTR static uint32_t quickBootMagic;
RTC_NOINIT_ATTR static uint32_t quickBootCount;   // сколько таких перезапусков подряд (с включения питания)
// Метка прошивки набора внутри образа: по ней передатчик узнаёт «свой» файл на карте и его версию (upd.h).
static const char FW_TAG[] = FW_TAG_KEY FW_VERSION;
// Передатчик обновил сам себя с карты: перезапуск без заставки, после запуска — сообщение на экране.
#define UPDATED_BOOT 0x55504454u
RTC_NOINIT_ATTR static uint32_t updatedMagic;
static void updRestart() {
  settingsSave();
  quickBootMagic = QUICK_BOOT;
  updatedMagic = UPDATED_BOOT;
  ESP.restart();
}
// Приёмник: передатчик нас не слышит, перезагрузка радио не помогла (rxlink.h, rxSeenTick) — перезапустить плату.
// Признак переживает перезапуск в памяти часов: запуск будет без заставки, и второй раз подряд так не перезапустимся.
static void rxHealRestart() {
  rxHealBootMagic = RX_HEAL_BOOT;
  rxHealBootCount = rxHealBootCount + 1;
  if (rxTxFake == 4) rxFakeKeep = RX_HEAL_BOOT;   // проверка n12=4: «неисправность» остаётся и после перезапуска
  Serial.println("передавач не чує цей приймач, перезавантаження радіо не допомогло — перезапускаю плату");
  Serial.flush();
  rRebooting = true;
  ESP.restart();
}
// Приёмник: выход звука стоял при звуке в эфире, сброс обработки не помог (сторож в rxaudio.h) — перезапуск без заставки.
static void rxSoundRestart(const char *why) {
  rxHealBootMagic = RX_SOUND_BOOT;
  rxSoundBootCount = rxSoundBootCount + 1;
  Serial.printf("%s — перезапускаю плату\n", why);
  Serial.flush();
  settingsSave();
  rRebooting = true;
  ESP.restart();
}
// Приёмник: перезапуск по просьбе — с передатчика (без заставки: слушателю нужен звук, а не картинка) или из меню.
static void rxAskedRestart(bool fromTx) {
  if (fromTx) rxHealBootMagic = RX_ASKED_BOOT;
  Serial.println(fromTx ? "передавач попросив перезапуститися — перезапускаю плату" : "перезапуск із меню — перезапускаю плату");
  Serial.flush();
  settingsSave();
  rRebooting = true;
  ESP.restart();
}
static void radioDead() {
  bbRefresh();
  quickBootMagic = QUICK_BOOT;
  if (quickBoot && millis() < 15000) {   // только что так перезапускались, а радио опять стоит — сброс поглубже:
    esp_sleep_enable_timer_wakeup(100000);   // сон на 0,1 с снимает питание со всей цифровой части, кроме часов
    esp_deep_sleep_start();
  }
  ESP.restart();
}

void settingsFactory() {   // всё стереть и начать с начальных настроек (роль и вид платы сохраняются)
  bool isTx = cfg.isTx;
  uint8_t board = cfg.board;
  cfg = Settings();
  cfg.isTx = isTx;
  cfg.board = board;
  settingsSave();
}

static void settingsLoad() {
  prefs.begin("hearlink", false);
  size_t len = prefs.getBytesLength("cfg");   // запись от старой версии короче — новые поля остаются по умолчанию
  bool oldVolScale = len && len <= offsetof(Settings, volScale);   // записана до 2.40: шкала громкости была другой
  if (len && len <= sizeof(cfg)) prefs.getBytes("cfg", &cfg, len);
  else if (len && len <= 1024) {   // запись длиннее — её оставила более новая прошивка (вернулись на прежнюю): взять своё начало.
    uint8_t *tmp = (uint8_t *)malloc(len);   // До 2.32 такая запись не читалась вовсе, и возврат стирал все настройки
    if (tmp) {
      if (prefs.getBytes("cfg", tmp, len) == len) memcpy((void *)&cfg, tmp, sizeof(cfg));
      free(tmp);
    }
  }
  if (cfg.channel < 1 || cfg.channel > 13) cfg.channel = 6;
  {   // первая загрузка с другой версией прошивки — сказать на экране «оновлено» (после заливки по кабелю тоже)
    String seen = prefs.getString("fwseen", "");
    if (seen != FW_VERSION) {
      fwChangedBoot = seen.length() > 0;
      prefs.putString("fwseen", FW_VERSION);
    }
  }
  cfg.name[sizeof(cfg.name) - 1] = 0;   // имена, записанные до 2.19, могли кончаться половиной буквы (ошибка стирания
  cfg.nameLong[sizeof(cfg.nameLong) - 1] = 0;   // на клавиатуре передатчика) — обрывки убрать
  cfg.srcName[sizeof(cfg.srcName) - 1] = 0;
  utf8Clean(cfg.name);
  utf8Clean(cfg.nameLong);
  utf8Clean(cfg.srcName);
  if (cfg.rateIdx >= N_RATES) cfg.rateIdx = 2;
  if (cfg.rateTop != 255 && cfg.rateTop >= N_RATES) cfg.rateTop = 255;
  if (cfg.rateLadder > 1) cfg.rateLadder = 1;
  if ((cfg.depthMs && cfg.depthMs < 4) || cfg.depthMs > 40) cfg.depthMs = 0;
  if (cfg.volume > 20) cfg.volume = 16;
  if (cfg.tone >= TEST_COUNT) cfg.tone = 0;
  if (cfg.gainDb < -12 || cfg.gainDb > 24) cfg.gainDb = 0;
  if (cfg.brightness < 10 || cfg.brightness > 100) cfg.brightness = 80;
  if (cfg.dimIdx > 3) cfg.dimIdx = 0;
  if (cfg.txGate > 4) cfg.txGate = 0;
  if (cfg.txGateThr > 4) cfg.txGateThr = 2;
  if (cfg.txGateRel > 2) cfg.txGateRel = 1;
  if (cfg.txGateDb && (cfg.txGateDb < -80 || cfg.txGateDb > -30)) cfg.txGateDb = 0;
  if (cfg.txLim > 1) cfg.txLim = 1;
  if (cfg.txLimCeil > 3) cfg.txLimCeil = 1;
  if (cfg.txLimComp > 3) cfg.txLimComp = 1;
  if (cfg.txLimRel > 2) cfg.txLimRel = 1;
  if (cfg.quality >= Q_COUNT && cfg.quality != Q_MON) cfg.quality = Q_HI;
  if (cfg.testTrack > 7) cfg.testTrack = 0;
  if (cfg.duckS < 10 || cfg.duckS > 240) cfg.duckS = 30;
  if (cfg.duckDb < -40 || cfg.duckDb > -6) cfg.duckDb = -16;
  if (cfg.voiceGapS < 1 || cfg.voiceGapS > 60) cfg.voiceGapS = 2;
  if (cfg.musicDb < -30 || cfg.musicDb > 0) cfg.musicDb = 0;
  if (cfg.voiceDb < -30 || cfg.voiceDb > 0) cfg.voiceDb = 0;
  if (cfg.lastTone < 1 || cfg.lastTone >= TEST_COUNT) cfg.lastTone = TEST_DUCK;
  if (cfg.txMute > 1) cfg.txMute = 0;
  if (cfg.stereo > 1) cfg.stereo = 0;
  if (cfg.rxStereo > 1) cfg.rxStereo = 0;
  if (cfg.rxClarity > 3) cfg.rxClarity = 0;
  if (cfg.rxBalance < -5 || cfg.rxBalance > 5) cfg.rxBalance = 0;
  if (cfg.rxVolMax < 1 || cfg.rxVolMax > 20) cfg.rxVolMax = 20;
  if (cfg.rxView > 2) cfg.rxView = 0;
  if (cfg.rxLed > 3) cfg.rxLed = 2;
  if (cfg.rxLang > 2) cfg.rxLang = 0;
  if (cfg.autoUpd > 1) cfg.autoUpd = 1;
  for (uint8_t &v : cfg.rxEq) if (v > 12) v = 6;
  if (cfg.rxLowCut > 1) cfg.rxLowCut = 1;
  for (uint8_t &v : cfg.txEq) if (v > 12) v = 6;
  if (cfg.txLowCut > 1) cfg.txLowCut = 0;
  if (cfg.rxLock > 3) cfg.rxLock = 0;
  if (cfg.rxBoost > 12) cfg.rxBoost = 0;
  if (cfg.txNs > 3) cfg.txNs = 0;
  if (cfg.rxNs > 3) cfg.rxNs = 0;
  if (cfg.rxComp > 3) cfg.rxComp = 1;
  if (cfg.rxGate > 3) cfg.rxGate = 0;
  if (cfg.txNsSens > 4) cfg.txNsSens = 2;
  if (cfg.rxNsSens > 4) cfg.rxNsSens = 2;
  if (cfg.rxGateThr > 4) cfg.rxGateThr = 1;
  if (cfg.rxGateRel > 2) cfg.rxGateRel = 1;
  // До 2.40 «звук как есть» был шаг 12 (60 %), с 2.40 — шаг 20 (100 %). Чтобы после обновления приёмник звучал как до
  // него, шаг и предел сдвигаются на 8; всё, что стояло выше 60 % (там было усиление с ограничителем), становится 100 %.
  if (oldVolScale) {
    if (cfg.volume) cfg.volume = cfg.volume + 8 > 20 ? 20 : cfg.volume + 8;
    cfg.rxVolMax = cfg.rxVolMax + 8 > 20 ? 20 : cfg.rxVolMax + 8;
    cfg.volScale = 1;
    prefs.putBytes("cfg", &cfg, sizeof(cfg));
  }
}

// Почему плата запустилась в этот раз: важно отличать включение питания от провала напряжения и сбоя программы.
static const char *resetReason() {
  switch (esp_reset_reason()) {
    case ESP_RST_POWERON: return "увімкнення живлення";
    case ESP_RST_BROWNOUT: return "ПРОСІДАННЯ ЖИВЛЕННЯ";
    case ESP_RST_SW: return "перезапуск програмою";
    case ESP_RST_PANIC: return "ЗБІЙ ПРОГРАМИ";
    case ESP_RST_INT_WDT: return "ЗАВИСАННЯ (сторож переривань)";
    case ESP_RST_TASK_WDT: return "ЗАВИСАННЯ (сторож задач)";
    case ESP_RST_WDT: return "ЗАВИСАННЯ (сторож)";
    case ESP_RST_EXT: return "кнопка або порт";
    case ESP_RST_DEEPSLEEP: return "глибокий перезапуск (радіо не оживало)";
    default: return "інше";
  }
}

// Проверка свободных выводов модуля ESP32-4848S040 (IO1, IO2, IO40 — левый ряд разъёма H1).
// Сначала печатает, не притянуты ли выводы чем-то на самой плате; затем 25 секунд следит за ними:
// кто коснётся вывода проводом, идущим на GND разъёма, — в порт пишется, какой это вывод. Так находится
// порядок выводов L1–L3 без схемы платы. Вывод IO2 занят входом звука — он проверяется по отсчётам АЦП.
static void pinProbe() {
  if (cfg.board != BOARD_4848 || !cfg.isTx) {
    Serial.println("перевірка виводів — лише для передавача на модулі 4848S040");
    return;
  }
  auto adcAvg = []() {
    uint32_t s = 0;
    for (int i = 0; i < 50; i++) {
      s += txRawLast;
      delay(4);
    }
    return s / 50;
  };
  for (int pin : { 1, 40 }) {
    pinMode(pin, INPUT_PULLUP);
    delay(30);
    int up = digitalRead(pin);
    pinMode(pin, INPUT_PULLDOWN);
    delay(30);
    int dn = digitalRead(pin);
    pinMode(pin, INPUT_PULLUP);
    Serial.printf("IO%d: з підтяжкою вгору %d, вниз %d — %s\n", pin, up, dn,
                  up && !dn ? "вільний" : !up ? "щось тягне до землі" : "щось тягне до живлення");
  }
  uint32_t free = adcAvg();
  gpio_pullup_en(GPIO_NUM_2);
  delay(300);
  uint32_t up = adcAvg();
  float v = up * 3.1f / 4095;
  Serial.printf("IO2 (вхід звуку): без підтяжки %u з 4095, з внутрішньою підтяжкою %u (≈%.2f В)", (unsigned)free, (unsigned)up, v);
  if (v > 2.9f) Serial.println(" — вільний");
  else Serial.printf(" — на платі опір до землі ≈ %.0f кОм\n", 45.0f * v / (3.3f - v));
  Serial.println("тепер 25 с: торкайтеся дротом від GND до виводів L1–L3 по черзі…");
  int was1 = 1, was40 = 1, was2 = up > 600;
  for (uint32_t t0 = millis(); millis() - t0 < 25000;) {
    int a = digitalRead(1), b = digitalRead(40), c = adcAvg() > up / 2 && up > 600;
    if (a != was1) Serial.printf("  IO1: %s\n", a ? "відпустили" : "ЗАМКНУЛИ НА ЗЕМЛЮ");
    if (b != was40) Serial.printf("  IO40: %s\n", b ? "відпустили" : "ЗАМКНУЛИ НА ЗЕМЛЮ");
    if (up > 600 && c != was2) Serial.printf("  IO2: %s\n", c ? "відпустили" : "ЗАМКНУЛИ НА ЗЕМЛЮ");
    was1 = a;
    was40 = b;
    was2 = c;
  }
  gpio_pullup_dis(GPIO_NUM_2);
  pinMode(1, INPUT);
  pinMode(40, INPUT);
  Serial.println("перевірку виводів закінчено");
}

static void help() {
  Serial.printf("запуск через: %s; працює %u с\n", resetReason(), (unsigned)(millis() / 1000));
  Serial.printf("версія %s, %s, набір %u, канал %u%s, швидкість %s Мбіт/с%s, потужність %d дБм\n", FW_VERSION,
                cfg.isTx ? "ПЕРЕДАВАЧ" : "ПРИЙМАЧ", cfg.kit, cfg.channel, !cfg.isTx && cfg.autoChannel ? " (пошук сам)" : "",
                RATES[cfg.rateIdx].name, !cfg.isTx ? "" : cfg.rateAuto ? " (обирається сама)" : cfg.rateTop < N_RATES && cfg.rateTop != cfg.rateIdx ? " (обрано більшу — знижено заради слабкого приймача)" : " (обрано вручну)", cfg.powerDbm);
  Serial.printf("плата: %s; зібрано ядром Arduino %s (ESP-IDF %s)\n", cfg.board == BOARD_4848 ? "ESP32-4848S040" : "ESP32-S3", ESP_ARDUINO_VERSION_STR, esp_get_idf_version());
  if (cfg.isTx) {   // чому передавач стоїть на цій швидкості (rateAutoTick, txpeers.h)
    static const char *const WHY[] = { "приймачів на зв'язку немає", "усі приймачі чують добре", "найслабший приймач чує слабо", "у слабкого приймача пропадає звук", "слабкий приймач зник зі зв'язку — три хвилини тримаємо нижчу", "сигнал уже добрий — чекаємо строку повернення", "нижчої ступені немає або її вимкнено (налаштування «Слабкий сигнал» чи Ql0)" };
    Serial.printf("швидкість: верхня ступінь %s Мбіт/с (%s), зараз %s Мбіт/с — %s; найслабший із тих, що грають: %02X%02X%02X, %d дБм; змін швидкості від увімкнення: %u\n", RATES[cfg.rateAuto || cfg.rateTop >= N_RATES ? (cfg.rateAuto ? (int)R_5M : (int)cfg.rateIdx) : (int)cfg.rateTop].name, cfg.rateAuto ? "сама" : "обрано вручну", RATES[cfg.rateIdx].name, WHY[rateWhy > 6 ? 0 : rateWhy], rateWhyId[0], rateWhyId[1], rateWhyId[2], (int)rateWhyRssi, (unsigned)rateSteps);
  }
  if (cfg.isTx) Serial.printf("слабкий сигнал: швидкість заради далекого приймача %s (екран: «Ефір» › «Слабкий сигнал»; порт: Ql3 / Ql2)\n", cfg.rateLadder ? "ЗНИЖУЄТЬСЯ сама" : "НЕ знижується — завжди як обрано");
  if (cfg.isTx) Serial.printf("очікування ефіру на каналі %u: за останні %u с пакет чекав 15 мс і довше у %u секундах (у таких — у середньому до %u мс)%s\n", cfg.channel, (unsigned)airSecs, (unsigned)airSlowSecs, (unsigned)airSlowMs, airSecs >= 20 && airSlowSecs * 60 >= airSecs * 10 ? " — поруч сильна мережа або канал зайнятий: приймачі тримають більший запас, звук затримується; спробуйте інший канал" : "");
  if (cfg.isTx) Serial.printf("сторож задач: стежить за задачею передачі — %s (код 0x%x); за холостою задачею ядра радіо — %s\n", txWdtErr == 0 ? "так" : "НІ", (unsigned)txWdtErr, txIdleWdtOff ? "ні (знято)" : "так");
  Serial.printf("захист: ключ набору %s%s\n", secHave ? "є" : "НЕМАЄ", cfg.isTx || secHave ? "" : " — приймач не підключено до набору, просить доступ");
  if (cfg.isTx) {
    static const char *const T[TEST_COUNT] = { "вимкнено", "тон 1000 Гц", "голос", "голос і музика", "музика", "музика з оголошенням", "перевірка каналів (лівий — один гудок, правий — два)" };
    Serial.printf("вхід: %s, перевірочний звук: %s%s\n", cfg.input == IN_I2S ? (txI2sProbe ? "PCM1808 (I2S) — ПРОБА без головного такту" : "PCM1808 (I2S)") : "вбудований АЦП", T[cfg.tone < TEST_COUNT ? cfg.tone : 0],
                  txSoundsOk ? "" : " (звуків у пам'яті немає — замість них тон)");
    Serial.printf("  мелодія: %s; оголошення кожні %u с; музика під голосом %d дБ; повтор голосу через %u с; гучність музики %d дБ, голосу %d дБ\n",
                  cfg.testTrack ? String(cfg.testTrack).c_str() : "по черзі", cfg.duckS, cfg.duckDb, cfg.voiceGapS, cfg.musicDb, cfg.voiceDb);
    if (mpFrames && mpItem >= 0)
      Serial.printf("  зараз мелодія «%s» (%.15s)\n", assetTitles[mpItem][0] ? assetTitles[mpItem] : "без назви", assetTab[mpItem].name);
    if (mpFrames) {
      Serial.printf("мелодії MP3: %u Гц, каналів %u, %u кбіт/с; розбір кадру сер. %u, макс. %u мкс (кадр — 36 мс звуку); недобір %u, помилок %u\n", (unsigned)mpRate,
                    (unsigned)mpChans, (unsigned)mpKbps, (unsigned)(mpUsSum / mpFrames), (unsigned)mpUsMax, (unsigned)mpUnder, (unsigned)mpErrors);
      Serial.printf("  запас розібраного звуку %u мс, пріоритет розбору %u (1 — не заважає екрану, 3 — понад екран)\n", (unsigned)((mpHead - mpTail) * 1000 / SRATE), mpPrio);
      mpUsSum = 0;      // счёт — с прошлого вызова «?»: так видно, что было именно в этот промежуток
      mpFrames = 0;
      mpUsMax = 0;
      mpUnder = 0;
    }
    int q = txQNow < Q_COUNT ? (int)txQNow : qForRate(cfg.quality == Q_MON ? Q_HI : cfg.quality, cfg.rateIdx);
    bool st = txStNow;
    if (cfg.quality == Q_MON) {   // «Монітор» (с 23.10): своя ветка задачи звука (txaudio.h)
      uint32_t pl = (uint32_t)qPktLenMon(), air = airUs(pl, cfg.rateIdx);
      Serial.printf("якість звуку: МОНІТОР — %u Гц, 24 біти, стерео, два кадри по 2 мс у пакеті без копій, пакет %u байт, в ефірі %u мкс із 4000 (%u %%)%s\n",
                    (unsigned)MON_RATE, (unsigned)pl, (unsigned)air, (unsigned)(air / 40), cfg.input == IN_I2S ? "" : " — НЕ ЙДЕ: потрібен вхід моста");
    } else {
      bool db = txDblNow && q == Q_HI;   // два кадра в пакете (proto.h, Q_DOUBLE)
      bool dp = db && txDupNow;          // двойной пакет с точными копиями прошлого (с 2.77)
      bool ps = dp && st && txPcmSNow;   // и стерео с разностью без сжатия (с 2.86)
      bool sb = txSubNow && q == Q_STD;   // «стандартна» подполосным кодеком (с 2.79)
      int pl = sb ? qPktLenSub() : ps ? qPktLen4(q) : dp ? qPktLen3(q, st) : db ? qPktLen2(q, st) : qPktLen(q, st);
      uint32_t per = qFrameUs(q) * (db ? 2 : 1);
      if (q == Q_HI && !db && txDoubleMode == 1 && txDoubleWhy == 1) Serial.printf("два кадри в пакеті поки не можна: приймач %02X%02X%02X зі списку не повідомляв версію 2.60 або новішу (оновиться сам, щойно вийде на зв'язок; якщо його вже немає — видаліть зі списку)\n", txDoubleWho[0], txDoubleWho[1], txDoubleWho[2]);
      else if (q == Q_HI && !db && txDoubleMode == 1 && txDoubleWhy == 2) Serial.println("два кадри в пакеті поки не можна: відкрите вікно додавання приймачів");
      Serial.printf("якість звуку: %s%s — %u Гц, кадр %u мс, %s, пакет %d байт, в ефірі %u мкс із %u (%u %%)\n", Q_NAME[q],
                    q != cfg.quality ? " (знижено: обрана не вміщається в цю швидкість)" : "", QDEF[q].sr, (unsigned)(qFrameUs(q) / 1000),
                    sb ? "новий кодек (вісім смуг), у пакеті кадр і три запасні копії" : dp ? "ДВА кадри в пакеті, минулий пакет повторено без стиснення" : db ? "ДВА кадри в пакеті (копії стиснені)" : "один кадр у пакеті", pl, (unsigned)airUs(pl, cfg.rateIdx), (unsigned)per, (unsigned)(airUs(pl, cfg.rateIdx) * 100 / per));
    }
    Serial.printf("стерео в ефір: %s; зараз в ефірі %s%s%s\n", cfg.stereo ? "увімкнено" : "вимкнено", st ? "СТЕРЕО" : "моно",
                  cfg.stereo && !st ? " (джерело моно або якість «дальня»)" : "",
                  st && txPcmSNow ? ", різниця каналів БЕЗ стиснення (16 біт, як середина; Qr0 — 4-бітна, як до 2.86)" :
                  st && q == Q_HI ? (txSideMode == 0 ? ", різниця каналів 4-бітна (задано Qr0; Qr1 — без стиснення)" : !txPcmSOk ? ", різниця каналів 4-бітна: не всі приймачі зі списку мають 2.87+" : ", різниця каналів 4-бітна") : "");
    txNsPrint();
    txGatePrint();
    txLimPrint();
  }
  else Serial.printf("ім'я: «%s»%s; вихід: %s, %s, запас %s, гучність %u з 20\n", rxName(), cfg.off ? " (ВИМКНЕНИЙ з передавача)" : "", cfg.output == OUT_CS4344 ? "CS4344 (I2S, 31 250 Гц, головний такт 8 МГц на виводі 10)" : cfg.output == OUT_I2S ? "PCM5102 (I2S)" : "PDM",
                     cfg.rxStereo ? "ДВА КАНАЛИ (навушники напряму або стерео)" : cfg.output != OUT_PDM ? "моно" : "ПРОТИФАЗА (підсилювач з різницевим входом)",
                     cfg.depthMs ? (String(cfg.depthMs) + " мс").c_str() : "підбирається сам", cfg.volume);
  if (!cfg.isTx)   // выходной тракт (с 2.86): разрядность, таблица подгонки темпа, ограничитель
    Serial.printf("тракт виходу: %s; підгонка темпу — %s; обмежувач — вікно 3 мс, атака середнім за вікно\n",
                  cfg.output == OUT_PDM ? "16 біт з округленням (однобітний вихід)" : "24 біти у 32-бітному слові",
                  !rxRsTab ? "кубічна (на таблицю не знайшлося пам'яті)" : rxRsTaps == RXRS_MAX ? "таблиця 48 × 128, зріз 15 кГц" : "таблиця 24 × 128 (на більшу не знайшлося пам'яті)");
  if (!cfg.isTx) {   // здоровье радио приёмника (с 2.59): свои отправки и слышит ли его передатчик
    uint32_t now = millis();
    Serial.printf("радіо приймача: надіслано пакетів %u, відповідей драйвера %u, відмов %u, «не пішло» %u, найдовше чекання %u мс; перезавантажень радіо %u (не відповідало) + %u (передавач не чув); перезапусків плати через це %u\n", (unsigned)rxTxPutCount, (unsigned)rxTxDoneCount, (unsigned)rxTxErr, (unsigned)rxTxFail, (unsigned)rxTxWaitMaxMs, (unsigned)rxHealStuck, (unsigned)rxHealUnseen, (unsigned)rxHealBootCount);
    Serial.printf("  передавач мене чує: %s; оголошень «кого чую» прийнято %u; повідомлень про себе надіслано %u\n", !rxRosterMs ? "невідомо (передавач до 2.59 цього не оголошує)" : msSince(rxRosterMs, now) > 5000 ? "невідомо (оголошень зараз немає)" : rxSeenMs && msSince(rxSeenMs, now) < 9000 ? "ТАК" : rxRosterFull ? "ні (у передавача список приймачів повний)" : "НІ", (unsigned)rxRosterN, (unsigned)rxStatusSent);
    Serial.printf("  повідомлення про себе на адресу передавача: підтверджено %u (у середньому за %u мс, найдовше %u), не підтверджено %u (найдовше %u мс), без відповіді драйвера %u; надіслано «всім» %u; останнє підтвердження %s\n", (unsigned)rxUniOk, rxUniOk ? (unsigned)(rxUniMsSum / rxUniOk) : 0u, (unsigned)rxUniMsMax, (unsigned)rxUniFail, (unsigned)rxUniFailMsMax, (unsigned)rxUniLate, (unsigned)rxUniAll, !rxAckMs ? "не було" : (String(msSince(rxAckMs, now) / 1000.0f, 1) + " с тому").c_str());
    Serial.printf("  потужність радіо зараз %d дБм (налаштована %d; до повної піднімалась %u разів), передавача чую на %d дБм%s\n", (int)rxPowerNow, (int)cfg.powerDbm, (unsigned)rxPowerUps, (int)rRssi, rxUniOff ? "; ПЕРЕВІРКА: повідомлення йдуть по-старому, «всім» (n13=0 — вимкнути)" : "");
    rxFxPrint();
  }
  if (!cfg.isTx) {   // чем громкость оборачивается на деле: шкала 0…100 % растянута на 0…«межа гучності»
    float g = rxVolumeGain(rxVolumeScaled(cfg.volume));
    Serial.printf("гучність %u %% при межі %u %% — звук %s%.1f дБ від повної шкали\n", cfg.volume * 5, cfg.rxVolMax * 5, g > 0 ? "" : "вимкнено, ", g > 0 ? 20 * log10f(g) : 0.0f);
  }
}

// Свободное время ядер: на каждом ядре секунду крутится пустой счётчик с самым низким приоритетом. Чем меньше насчитал,
// тем больше ядро занято остальным (в том числе прерываниями). Числа сравнивать между собой и между режимами.
static volatile uint32_t spinCount[2];
static volatile bool spinRun;
static void spinTask(void *arg) {
  int core = (int)(intptr_t)arg;
  uint32_t n = 0;
  while (spinRun) {
    n = n + 1;
    __asm__ __volatile__("nop");
  }
  spinCount[core] = n;
  vTaskDelete(NULL);
}
static void cpuProbe() {
  spinCount[0] = spinCount[1] = 0;
  spinRun = true;
  xTaskCreatePinnedToCore(spinTask, "spin0", 2048, (void *)0, 1, NULL, 0);
  xTaskCreatePinnedToCore(spinTask, "spin1", 2048, (void *)1, 1, NULL, 1);
  delay(1000);
  spinRun = false;
  delay(60);
  Serial.printf("вільний час ядер за секунду (умовні одиниці, більше — вільніше): перше (радіо) %u, друге (екран) %u\n", (unsigned)(spinCount[0] / 1000),
                (unsigned)(spinCount[1] / 1000));
}

// Время ядер по задачам (с 2.94): счётчики времени FreeRTOS (в ядре Arduino они включены) — сколько каждая задача
// работала за две секунды, в процентах ядра; IDLE — свободное время. Прерывания засчитываются той задаче, которую
// прервали. Задачи без привязки к ядру — отдельной строкой.
// В обычную сборку не входит (с 3.01): uxTaskGetSystemState и её помощники лежат в быстрой памяти (FreeRTOS собран в
// IRAM) — 600 байт, а у передатчика каждый байт быстрой памяти уходит из внутренней кучи. Включается строкой
// #define HL_TASK_LOAD перед этим местом; команда — Y14.
#ifdef HL_TASK_LOAD
static void taskLoad() {
  const int MAXT = 40;
  TaskStatus_t *a = (TaskStatus_t *)malloc(sizeof(TaskStatus_t) * MAXT * 2);
  if (!a) return;
  TaskStatus_t *b = a + MAXT;
  configRUN_TIME_COUNTER_TYPE ta = 0, tb = 0;
  UBaseType_t na = uxTaskGetSystemState(a, MAXT, &ta);
  delay(2000);
  UBaseType_t nb = uxTaskGetSystemState(b, MAXT, &tb);
  uint32_t span = (uint32_t)(tb - ta);
  if (!span) span = 1;
  uint32_t d[MAXT];
  for (UBaseType_t i = 0; i < nb; i++) {
    uint32_t prev = 0;
    for (UBaseType_t j = 0; j < na; j++)
      if (a[j].xHandle == b[i].xHandle) {
        prev = a[j].ulRunTimeCounter;
        break;
      }
    d[i] = b[i].ulRunTimeCounter - prev;
  }
  const BaseType_t CORES[3] = { 0, 1, tskNO_AFFINITY };
  for (int c = 0; c < 3; c++) {
    char line[320];
    int len = snprintf(line, sizeof(line), c < 2 ? "ядро %d за %.1f с, %% часу:" : "без прив'язки до ядра%.0d за %.1f с:", c < 2 ? c : 0, span / 1e6f);
    bool used[MAXT] = {};
    for (;;) {   // по убыванию времени
      int best = -1;
      for (UBaseType_t i = 0; i < nb; i++)
        if (!used[i] && b[i].xCoreID == CORES[c] && (best < 0 || d[i] > d[best])) best = i;
      if (best < 0 || d[best] * 1000ull / span < 3) break;   // меньше 0,3 % — не печатать
      used[best] = true;
      len += snprintf(line + len, sizeof(line) - len, " %s %.1f", b[best].pcTaskName, d[best] * 100.0f / span);
      if (len >= (int)sizeof(line) - 32) break;
    }
    Serial.println(line);
  }
  free(a);
}
#endif

// Сверка записи проверочного узора (Z2): в файле должен идти счётчик без единого разрыва. Разрыв — потерянные,
// повторённые или не туда записанные секторы; печатается, где он и на сколько отсчётов.
static void recVerify(const char *path) {
  static int16_t *buf;   // во внешней памяти
  char full[300];
  if (!buf) buf = (int16_t *)heap_caps_malloc(1024 * 2, MALLOC_CAP_SPIRAM);
  if (!buf) return;
  snprintf(full, sizeof(full), "/sd%s", path);
  FILE *f = fopen(full, "rb");
  WavFmt w;
  if (!f || wavParse(f, w)) {
    Serial.println("звірка: файл не відкрився або це не запис");
    if (f) fclose(f);
    return;
  }
  fseek(f, w.dataPos, SEEK_SET);
  uint32_t total = w.dataLen / 2, n = 0, breaks = 0, at[5], jump[5];
  int16_t prev = 0;
  bool have = false;
  while (n < total) {
    size_t k = fread(buf, 2, total - n > 1024 ? 1024 : total - n, f);
    if (!k) break;
    for (size_t i = 0; i < k; i++) {
      if (have && (int16_t)(prev + 1) != buf[i]) {
        if (breaks < 5) {
          at[breaks] = n + i;
          jump[breaks] = (uint16_t)(buf[i] - prev - 1);
        }
        breaks++;
      }
      prev = buf[i];
      have = true;
    }
    n += k;
  }
  fclose(f);
  Serial.printf("звірка «%s»: дані з %u-го байта, відліків %u з %u (%.1f с), розривів лічильника %u", path, (unsigned)w.dataPos, (unsigned)n, (unsigned)total, n / (float)SRATE,
                (unsigned)breaks);
  for (uint32_t i = 0; i < breaks && i < 5; i++) Serial.printf("; на %u-му відліку стрибок %u", (unsigned)at[i], (unsigned)jump[i]);
  Serial.println();
}

// Приём файла с компьютера на карту через порт (tools/sendfile.py): Fu<путь>|<размер>|<скорость порта>.
// Карта стоит в передатчике, другого пути положить на неё файл без вынимания нет (владелец 07.10: «файл в загрузках …
// скопируй на карту и проверь»). Файл идёт кусками по 2048 байт; у каждого куска заголовок (A5 5A, длина) и
// контрольная сумма; на каждый кусок ответ: 06 'K' — принят, 15 'N' — повторить, 18 'E' — карта не пишет, конец.
// На время передачи порт переходит на заданную скорость (230400: на 460800 мост этого модуля сбоит), главный цикл
// стоит — отчётов в порт нет, журнал на карту и уход с занятого канала на эти минуты не работают.
static uint16_t upCrc(const uint8_t *d, size_t n) {
  uint16_t c = 0xFFFF;
  for (size_t i = 0; i < n; i++) {
    c ^= (uint16_t)d[i] << 8;
    for (int k = 0; k < 8; k++) c = c & 0x8000 ? (c << 1) ^ 0x1021 : c << 1;
  }
  return c;
}
static void fmUpload(const String &path, uint32_t size, uint32_t baud) {
  const uint32_t BLK = 2048;
  static uint8_t *buf;
  char full[300];
  snprintf(full, sizeof(full), "/sd%s", path.c_str());
  if (!buf) buf = (uint8_t *)heap_caps_malloc(BLK + 8, MALLOC_CAP_SPIRAM);
  if (!recSd || recOn || fm.op || fmWant || !buf || !size) {
    hwSerial.println("UPLOAD FAIL busy");
    return;
  }
  FILE *f = fopen(full, "wb");
  if (!f) {
    hwSerial.println("UPLOAD FAIL open");
    return;
  }
  hwSerial.printf("UPLOAD READY %u\n", (unsigned)BLK);
  hwSerial.flush();
  delay(60);
  hwSerial.end();                     // большой приёмный буфер порта (4 КБ) держим только на время передачи файла
  hwSerial.setRxBufferSize(4096);
  hwSerial.begin(baud);
  uint32_t got = 0, bad = 0;
  bool ok = true;
  sdwOn = true;   // секторы копятся и уходят на карту крупно — как при записи
  hwSerial.setTimeout(6000);
  while (got < size && ok) {
    uint32_t want = size - got > BLK ? BLK : size - got;
    uint8_t h[4];
    bool good = hwSerial.readBytes(h, 4) == 4 && h[0] == 0xA5 && h[1] == 0x5A && (uint32_t)(h[2] | h[3] << 8) == want &&
                hwSerial.readBytes(buf, want + 2) == want + 2 && upCrc(buf, want) == (uint16_t)(buf[want] << 8 | buf[want + 1]);
    if (!good) {
      if (++bad > 20) {
        ok = false;
        break;
      }
      delay(150);   // переждать остаток испорченного куска и выбросить его
      while (hwSerial.available()) hwSerial.read();
      hwSerial.write((uint8_t)0x15);
      hwSerial.write('N');
      continue;
    }
    if (fwrite(buf, 1, want, f) != want) {
      ok = false;
      break;
    }
    got += want;
    hwSerial.write((uint8_t)0x06);
    hwSerial.write('K');
  }
  if (fclose(f)) ok = false;
  sdwOn = false;
  if (!ok) {
    hwSerial.write((uint8_t)0x18);
    hwSerial.write('E');
    unlink(full);
  }
  hwSerial.flush();
  delay(300);
  hwSerial.end();
  hwSerial.setRxBufferSize(256);
  hwSerial.begin(115200);
  hwSerial.setTimeout(1000);
  delay(300);
  hwSerial.printf("\nUPLOAD %s %u з %u байт, повторів %u\n", ok ? "DONE" : "FAIL", (unsigned)got, (unsigned)size, (unsigned)bad);
}

// Обработка «для слуха» (nsfx.h): что включено и что она делает прямо сейчас.
static void txNsPrint() {
  static const char *const LV[] = { "вимкнено", "слабке (до −8 дБ)", "середнє (до −14 дБ)", "сильне (до −20 дБ)" };
  uint32_t n = txNsCalls, sum = txNsUsSum, mx = txNsUsMax;
  txNsCalls = 0;
  txNsUsSum = 0;
  txNsUsMax = 0;
  Serial.printf("шумозаглушення входу: %s (e6=0…3), чутливість %u (e8=0…4); шум %s (e7=1 — запам'ятати зараз, e7=0 — сам); зараз прибирає %.1f дБ, кроків у паузах %u; час на кадр (на ядрі екрана) сер. %u, найдовше %u мкс; не встигло кадрів %u\n", LV[cfg.txNs > 3 ? 0 : cfg.txNs], cfg.txNsSens, txNsFrozen ? "запам'ятовано на прохання" : "запам'ятовується сам у паузах", cfg.txNs ? -txNsRedDb : 0.0f, (unsigned)txNsPauseHops, n ? (unsigned)(sum / n) : 0u, (unsigned)mx, (unsigned)txNsLate);
}
// Шумовой порог входа (с 3.17, txaudio.h): настройки, шум входа, порог и что он делает сейчас.
static void txGatePrint() {
  static const char *const DP[] = { "вимкнено", "у паузах тихіше на 12 дБ", "у паузах тихіше на 20 дБ", "у паузах тихіше на 30 дБ", "у паузах тиша" };
  static const char *const RL[] = { "швидко", "середньо", "повільно" };
  uint32_t fr = txGateFrames, cl = txGateClosed, sw = txGateCloses;
  txGateFrames = 0;
  txGateClosed = 0;
  txGateCloses = 0;
  char thr[96];
  if (cfg.txGateDb) snprintf(thr, sizeof(thr), "вручну %d дБ (e12=0 — від шуму)", cfg.txGateDb);
  else snprintf(thr, sizeof(thr), "шум +%d дБ (e11=0…4; e12=-80…-30 — вручну)", 3 + 3 * (cfg.txGateThr > 4 ? 2 : cfg.txGateThr));
  Serial.printf("шумовий поріг входу: %s (e10=0…4); поріг %s; закриття %s (e13=0…2); шум входу %.1f дБ, поріг зараз %.1f дБ, звук %.1f дБ — %s; з минулого показу закрито %u%% часу, закривався %u разів\n",
                DP[cfg.txGate > 4 ? 0 : cfg.txGate], thr, RL[cfg.txGateRel > 2 ? 1 : cfg.txGateRel], txGateFloorDb, txGateThrDb, txGateLevDb,
                !txGateActive ? "не діє (перевірочний звук, файл або вимкнено)" : txGateOpen ? "відкрито" : "закрито", fr ? (unsigned)(cl * 100 / fr) : 0u, (unsigned)sw);
}
// Запись «сырых» слов АЦП (с 3.20, txaudio.h): вернуть проверочный звук после записи (e21) и выгрузка в порт.
static void txRawCapTick() {
  if (txRawCapTone == 0xFF) return;
  if (txRawCapState == 3 || millis() - txRawCapT0 > 6000) {
    cfg.tone = txRawCapTone;
    txRawCapTone = 0xFF;
    if (txRawCapState != 3) txRawCapState = 0;
  }
}
static void txRawCapDump() {
  static const char B64[] = "ABCDEFGHIJKLMNOPQRSTUVWXYZabcdefghijklmnopqrstuvwxyz0123456789+/";
  if (txRawCapState != 3 || !txRawCap) {
    Serial.println("запис АЦП: немає готового запису (e19=<мс> або e21=<мс>)");
    return;
  }
  uint32_t n = txRawCapN;
  Serial.printf("@@ADC begin %u %s\n", (unsigned)n, txRawCapKind ? "efir" : "adc");
  char line[300];
  for (uint32_t i = 0; i < n; i += 48) {
    uint32_t m = n - i < 48 ? n - i : 48;
    const uint8_t *p = (const uint8_t *)(txRawCap + i);
    uint32_t len = m * 4, o = snprintf(line, sizeof(line), "@@ADC %u ", (unsigned)i);
    for (uint32_t k = 0; k < len; k += 3) {
      uint32_t v = p[k] << 16 | (k + 1 < len ? p[k + 1] << 8 : 0) | (k + 2 < len ? p[k + 2] : 0);
      line[o++] = B64[v >> 18 & 63];
      line[o++] = B64[v >> 12 & 63];
      line[o++] = k + 1 < len ? B64[v >> 6 & 63] : '=';
      line[o++] = k + 2 < len ? B64[v & 63] : '=';
    }
    line[o] = 0;
    Serial.println(line);
    if ((i / 48) % 16 == 15) delay(1);
  }
  Serial.println("@@ADC end");
}
// Ограничитель пиков входа (с 3.18) и счёт самого АЦП: упирается ли он в край шкалы и нет ли «перескоков» отсчёта через
// весь размах (так выглядела бы ошибка формата данных — сдвиг на бит, — а не перегрузка).
static void txLimPrint() {
  static const char *const CL[] = { "-0,5", "-1", "-2", "-3" };
  static const char *const CP[] = { "немає (лише обмежувач)", "легке (від -6 дБ, 2:1)", "середнє (від -10 дБ, 3:1)", "сильне (від -14 дБ, 4:1)" };
  static const char *const RL[] = { "швидко", "середньо", "повільно" };
  float low = txLimLowG;
  uint32_t busy = txLimBusy, fr = txAdcFrames;
  txLimLowG = 1;
  txLimBusy = 0;
  Serial.printf("обмежувач піків входу: %s (e14=0/1); стеля %s дБ (e15=0…3); стискання %s (e16=0…3); відпускання %s (e17=0…2); підсилення входу %+d дБ; з минулого показу найбільше убавлено %.1f дБ, обмежувач працював %u мс\n",
                cfg.txLim ? "увімкнено" : "вимкнено", CL[cfg.txLimCeil > 3 ? 1 : cfg.txLimCeil], CP[cfg.txLimComp > 3 ? 1 : cfg.txLimComp], RL[cfg.txLimRel > 2 ? 1 : cfg.txLimRel],
                (int)cfg.gainDb, low < 1 ? -20.0f * log10f(low > 1e-6f ? low : 1e-6f) : 0.0f, (unsigned)(busy / 32));
  Serial.printf("АЦП PCM1808 з минулого показу: кадрів %u; найбільше |Л| %u, |П| %u; на краю шкали Л %u, П %u відліків; перескоків через весь розмах Л %u, П %u; молодший байт слова 0x%02X\n",
                (unsigned)fr, (unsigned)txAdcPeakL, (unsigned)txAdcPeakR, (unsigned)txAdcRailL, (unsigned)txAdcRailR, (unsigned)txAdcJumpL, (unsigned)txAdcJumpR, (unsigned)txAdcLowOr);
  static const char *const FF[] = { "само", "як є (e18=1)", "зсув на біт (e18=2)" };
  uint32_t w = txAdcWords, n0 = txAdcBit0, n8 = txAdcBit8;
  Serial.printf("АЦП: втрачено кадрів I2S %u; знак першого відліку кадру виправлено %u разів\n", (unsigned)txI2sOvfN, (unsigned)txAdcEdgeFix);
  txI2sOvfN = 0;
  txAdcEdgeFix = 0;
  Serial.printf("формат даних АЦП: %s, вибір %s (e18=0…2); слів з даними %u, з бітом 0 — %u, з бітом 8 — %u (%s); перемикань %u\n",
                (txAdcFmtForce ? txAdcFmtForce == 2 : txAdcShift) ? "дані зсунуті на біт — збираю відліки наново" : "дані рівно, як є",
                FF[txAdcFmtForce > 2 ? 0 : txAdcFmtForce], (unsigned)w, (unsigned)n0, (unsigned)n8,
                !w ? "АЦП мовчить — вхід не в ефірі" : n8 && !n0 ? "так буває при рівних даних" : n0 && !n8 ? "так буває при зсуві на біт" : "ознаки змішані",
                (unsigned)txAdcFlips);
  txAdcWords = txAdcBit0 = txAdcBit8 = 0;
  txAdcFrames = 0;
  txAdcPeakL = txAdcPeakR = 0;
  txAdcRailL = txAdcRailR = 0;
  txAdcJumpL = txAdcJumpR = 0;
  txAdcLowOr = 0;
}
static void rxFxPrint() {
  uint32_t n = rxNsCalls, sum = rxNsUsSum, mx = rxNsUsMax;
  float red = rxDynRedDb, gate = rxGateRedDb;
  rxNsCalls = 0;
  rxNsUsSum = 0;
  rxNsUsMax = 0;
  rxDynRedDb = 0;
  rxGateRedDb = 0;
  Serial.printf("обробка звуку: 16 шумозаглушення %u (зараз прибирає %.1f дБ, кроків у паузах %u, час на блок сер. %u, найдовше %u мкс); 17 стискання %u (найбільше з минулого разу −%.1f дБ); 18 у паузах %u (найбільше −%.1f дБ, дно шуму %.0f дБ); обмежувач найглибше %.1f дБ; 19 чутливість %u, 20 поріг пауз +%u дБ, 21 закриття пауз %u, 22 зразок шуму %s\n", cfg.rxNs, cfg.rxNs ? -rxNsRedDb : 0.0f, (unsigned)rxNsPauseHops, n ? (unsigned)(sum / n) : 0u, (unsigned)mx, cfg.rxComp, red, cfg.rxGate, gate, rxGateFloorDb, 20 * log10f(rxLimLow > 0.001f ? rxLimLow : 0.001f), cfg.rxNsSens, 3 + 3 * cfg.rxGateThr, cfg.rxGateRel, rxNsFrozen ? "запам'ятовано" : "сам");
}

// Проба нейросети ESP-SR над файлом с карты (итог 11.10 — в ЖУРНАЛе): в обычную сборку не входит (она тянет 139 КБ
// кода); включается строкой #define HL_NSNET_TEST перед этим местом.
#ifdef HL_NSNET_TEST
#include "nsnettest.h"
#endif
// Файловый менеджер карты — с порта (для проверки без рук). Ждёт конца работы и печатает итог.
static void fmSerial(const String &arg) {
  char c = arg.length() ? arg[0] : 0;
  if (!c) {
    Serial.printf("файл в ефірі: %s «%s» %u / %u с; кінець %u, помилка читання %u; розбір: %u Гц, %u кан., кадрів %u, помилок %u, недоборів %u, сер. %.1f мс, найдовше %.1f мс; читання картки %u мс, перерахунок частоти %u мс, запас %u мс\n",
                  fm.playing ? "ТАК" : "ні", fm.playName, (unsigned)fm.playS, (unsigned)fm.playTotalS, (unsigned)fm.playEnd, (unsigned)cpErr, (unsigned)mpRate, (unsigned)cpChans,
                  (unsigned)mpFrames, (unsigned)mpErrors, (unsigned)mpUnder, mpFrames ? mpUsSum / 1000.0f / mpFrames : 0.0f, mpUsMax / 1000.0f,
                  (unsigned)(cpReadUs / 1000), (unsigned)(cpRsUs / 1000), (unsigned)((mpHead - mpTail) / 32));
    cpReadUs = 0;
    cpRsUs = 0;
    mpFrames = 0;
    mpUsSum = 0;
    mpUsMax = 0;
    return;
  }
  String p = arg.substring(1), q;
  int bar = p.indexOf('|');
  if (bar >= 0) {
    q = p.substring(bar + 1);
    p = p.substring(0, bar);
  }
  if (c == 'w') {   // Fw — волна файла в эфире (плеер, с 3.28): сколько посчитано, кадров, длительность
    Serial.printf("хвиля: %s, стовпців %u з %u (%u%%)%s, «повна висота» %u дБ; кадрів MP3 %u (місця кадрів — %s), тривалість %u мс; частота %u; звук у файлі %u…%u; пауза %s\n",
                  cw.mp3 ? "MP3" : "WAV", (unsigned)cw.ready, (unsigned)CW_N, (unsigned)cw.pct, cw.done ? ", готово" : cw.failed ? ", НЕ ВДАЛОСЯ" : "", (unsigned)cw.ref,
                  (unsigned)cw.frames, cw.cap ? "є" : "немає пам'яті", (unsigned)cw.durMs, (unsigned)cw.rate, (unsigned)cw.start, (unsigned)cw.end, cpPause ? "так" : "ні");
    return;
  }
  if (c == 'k') {   // Fk<секунда> — перейти в файлі (як дотик по хвилі)
    cardSeekMs((uint32_t)(p.toFloat() * 1000));
    Serial.printf("перехід на %.1f с: %s\n", p.toFloat(), fm.playing && cw.rate ? "попрошено" : "не можна (файл не грає або ще не прочитано)");
    return;
  }
  if (c == 'z') {   // Fz — пауза / далі
    cardPause(!cpPause);
    Serial.printf("пауза: %s\n", cpPause ? "так" : "ні");
    return;
  }
  if (c == 'u') {   // Fu<путь>|<размер>|<скорость> — принять файл с компьютера (tools/sendfile.py)
    int b2 = q.indexOf('|');
    fmUpload(p, (uint32_t)q.toInt(), b2 >= 0 ? (uint32_t)q.substring(b2 + 1).toInt() : 115200);
    return;
  }
#ifdef HL_NSNET_TEST
  if (c == 'n') {   // Fn<вход.wav>|<выход.wav>|<с секунды>|<секунд> — проба нейросетевого шумоподавления над файлом (nsnettest.h)
    nsnetTest(p, q);
    return;
  }
#endif
  if (c == 'x') {   // Fx<файл>|<смещение>|<длина> — отдать кусок любого файла с карты на компьютер (tools/getfile.py):
                    // строки «=<48 байт в base64>*<сумма байтов, 4 знака>»; так снимаются записи звука для разбора
    int b2 = q.indexOf('|');
    uint32_t off = (uint32_t)strtoul(q.c_str(), NULL, 10), len = b2 >= 0 ? (uint32_t)strtoul(q.c_str() + b2 + 1, NULL, 10) : 0, total = 0;
    char full[300];
    snprintf(full, sizeof(full), "/sd%s", p.c_str());
    FILE *f = fopen(full, "rb");
    if (!f) {
      Serial.println("файл не відкрився");
      return;
    }
    fseek(f, 0, SEEK_END);
    uint32_t size = (uint32_t)ftell(f);
    fseek(f, off, SEEK_SET);
    static uint8_t raw[48];
    static char b64[72];
    while (total < len) {
      size_t n = fread(raw, 1, len - total < 48 ? len - total : 48, f), o = 0;
      if (!n) break;
      uint32_t sum = 0;
      for (size_t i = 0; i < n; i++) sum += raw[i];
      static const char T[] = "ABCDEFGHIJKLMNOPQRSTUVWXYZabcdefghijklmnopqrstuvwxyz0123456789+/";
      for (size_t i = 0; i < n; i += 3) {
        uint32_t v = raw[i] << 16 | (i + 1 < n ? raw[i + 1] << 8 : 0) | (i + 2 < n ? raw[i + 2] : 0);
        b64[o++] = T[v >> 18];
        b64[o++] = T[(v >> 12) & 63];
        b64[o++] = i + 1 < n ? T[(v >> 6) & 63] : '=';
        b64[o++] = i + 2 < n ? T[v & 63] : '=';
      }
      b64[o] = 0;
      Serial.printf("=%s*%04X\n", b64, (unsigned)(sum & 0xFFFF));
      total += n;
    }
    fclose(f);
    Serial.printf("— кінець шматка: %u байт від %u; розмір файла %u —\n", (unsigned)total, (unsigned)off, (unsigned)size);
    return;
  }
  if (c == 't') {   // Ft<файл> — напечатать текстовый файл с карты целиком (журнал работы после зала)
    char full[300];
    snprintf(full, sizeof(full), "/sd%s", p.c_str());
    FILE *f = fopen(full, "rb");
    if (!f) {
      Serial.println("файл не відкрився");
      return;
    }
    static char buf[513];
    size_t n, total = 0;
    while ((n = fread(buf, 1, 512, f)) > 0) {
      Serial.write((const uint8_t *)buf, n);
      total += n;
    }
    fclose(f);
    Serial.printf("\n— кінець файла, %u байт; рядків журналу записано %u, не записано %u —\n", (unsigned)total, (unsigned)logLines, (unsigned)logFails);
    return;
  }
  int op = c == 'l' ? FM_LIST : c == 'm' ? FM_MKDIR : c == 'd' ? FM_DELETE : c == 'c' ? FM_COPY : c == 'i' ? FM_INFO : c == 'p' ? FM_PLAY : c == 's' ? FM_STOP : 0;
  if (!op) return;
  uint32_t seq = fm.doneSeq, t0 = millis(), shown = 0;
  if (!fmAsk(op, p.c_str(), q.c_str())) {
    Serial.println("картка зайнята або її немає");
    return;
  }
  if (op == FM_PLAY || op == FM_STOP) {
    Serial.println(op == FM_PLAY ? "файл пішов в ефір" : "зупиняю файл");
    return;
  }
  while (fm.doneSeq == seq && millis() - t0 < 300000) {
    delay(20);
    if (op == FM_COPY && millis() - shown > 2000) {
      shown = millis();
      Serial.printf("  копіюю: %u %%\n", (unsigned)fm.progress);
    }
  }
  Serial.printf("картка: дія %d, код %u, %u мс; вільно %u МБ з %u\n", op, (unsigned)fm.result, (unsigned)(millis() - t0), (unsigned)fm.freeMb, (unsigned)fm.totalMb);
  if (op == FM_LIST && !fm.result) {
    for (int i = 0; i < fm.n; i++) Serial.printf("  %s %s  %u\n", fm.ent[i].dir ? "[тека]" : "      ", fm.ent[i].name, (unsigned)fm.ent[i].size);
    Serial.printf("  записів %d, не показано %d\n", fm.n, fm.more);
  }
  if (op == FM_INFO && !fm.result)
    Serial.printf("  «%s»: вид %u, в ефір %s (причина %u), %u Гц, %u кан., %u біт, %u кбіт/с, %u с, %u байт\n", fm.info.name, fm.info.kind, fm.info.playable ? "можна" : "НЕ МОЖНА",
                  fm.info.why, (unsigned)fm.info.rate, fm.info.chans, fm.info.bits, fm.info.kbps, (unsigned)fm.info.durS, (unsigned)fm.info.size);
}

// «Чёрный ящик» радио (bbox.h): последний слепок и — по просьбе — события этой минуты.
static void bbPrint(bool live) {
  char *t = logExtra ? logExtra + 2048 : nullptr;   // вторая половина той же памяти: первая может ждать записи на карту
  if (!t) return;
  Serial.printf("радіо: ставало %u разів, оживлено без перезапуску плати %u, швидких перезапусків плати %u; оживляти до ступеня %u, починати з %u\n",
                (unsigned)bbDeaths, (unsigned)rRevived, (unsigned)quickBootCount, rReviveMax, rReviveFrom);
  Serial.printf("надсилання: %s; у своїй черзі зараз %u, пакет у драйвера: %s; (старий спосіб) надсилань поверх попереднього пакета %u\n", rSerial && rq ? "по одному" : "як до 2.52",
                (unsigned)(rqHead - rqTail), rqInFlight ? "так" : "ні", (unsigned)rBusySends);
  {
    static uint32_t g0[4], bs0, sn0, ss0;
    uint32_t g[4], bs = rBusySends, sn = rSoloN, ss = rSoloSumUs, mx = rSoloMaxUs, tot = 0;
    rSoloMaxUs = 0;
    for (int i = 0; i < 4; i++) {
      g[i] = rGapHist[i] - g0[i];
      g0[i] += g[i];
      tot += g[i];
    }
    if (tot)
      Serial.printf("заміри з минулого Q: проміжки між надсиланнями <1 мс %u %%, 1–1,6 мс %u %%, 1,6–2,4 мс %u %%, довші %u %%; поверх попереднього %u %%; пакет «наодинці» (драйвер був вільний): %u шт., сер. %u мкс, найдовше %u мкс\n",
                    (unsigned)(g[0] * 100 / tot), (unsigned)(g[1] * 100 / tot), (unsigned)(g[2] * 100 / tot), (unsigned)(g[3] * 100 / tot), (unsigned)((bs - bs0) * 100 / tot),
                    (unsigned)(sn - sn0), sn != sn0 ? (unsigned)((ss - ss0) / (sn - sn0)) : 0, (unsigned)mx);
    bs0 = bs;
    sn0 = sn;
    ss0 = ss;
    static uint32_t pn0, ps0, po0;
    uint32_t pn = txProcN, ps = txProcSumUs, po = txProcOver, pm = txProcMaxUs;
    txProcMaxUs = 0;
    if (pn != pn0)
      Serial.printf("обробка кадру задачею передачі з минулого Q: сер. %u мкс, найдовше %u мкс, довших за 2000 мкс %u із %u; перевантажень (задача сама віддала ядро) від запуску %u\n",
                    (unsigned)((ps - ps0) / (pn - pn0)), (unsigned)pm, (unsigned)(po - po0), (unsigned)(pn - pn0), (unsigned)txYields);
    if (pn != pn0) {
      static uint32_t s0[7];
      static const char *const NM[7] = { "джерело", "рівні", "стиснення", "складання", "шифр", "радіо", "решта" };
      Serial.print("  за етапами, мкс на кадр:");
      for (int i = 0; i < 7; i++) {
        uint32_t v = txSec[i];
        Serial.printf(" %s %u", NM[i], (unsigned)((v - s0[i]) / (pn - pn0)));
        s0[i] = v;
      }
      Serial.println();
    }
    pn0 = pn;
    ps0 = ps;
    po0 = po;
  }
  if (bbSnapMagic == BB_MAGIC) {
    bbFormat(bbSnap, t, 2048, false);
    Serial.print(t);
  }
  if (live) {
    bbFormat(bbSnap, t, 2048, true);
    Serial.print("останні події:");
    Serial.print(t);
  }
}

static void command(String s) {
  s.trim();
  if (!s.length()) return;
  if (s[0] == '@') {   // команда другому устройству набора — по радио (dbgair.h)
    dbgRemote(s);
    return;
  }
  char c = s[0];
  String arg = s.substring(1);
  arg.trim();
  long v = arg.toInt();
  bool restart = false;
  if (cfg.isTx) bbMark(BB_CMD, (uint8_t)c, (uint32_t)(v < 0 ? 0 : v));
  switch (c) {
    case '?': help(); return;
    case 't':
      if (!cfg.isTx && cfg.autoChannel) cfg.channel = 6;   // канал, на котором приёмник застал поиск, передатчику не нужен
      cfg.isTx = true;                                     // (уже передатчик — канал не трогать: 07.10 так сбил канал владельца)
      restart = true;
      break;
    case 'r': cfg.isTx = false; restart = true; break;
    case 'k':
      if (v < 0 || v > 255) return;
      cfg.kit = v;
      rxNeedPrime = true;
      break;
    case 'c':
      if (v < 0 || v > 13 || (v == 0 && cfg.isTx)) return;
      if (cfg.isTx) {   // передатчик (с 4.00): переход с объявлением приёмникам; канал запишется, когда переход сделан
        txChannelSet((uint8_t)v);
        Serial.printf("канал: %u → %u%s\n", cfg.channel, (unsigned)v, txHopCh ? " (оголошую приймачам, перехід за ~0,2 с)" : "");
        return;
      }
      cfg.autoChannel = v == 0;
      if (v) cfg.channel = v;
      rApply = true;
      break;
    case 'v': {   // v0 — скорость выбирается сама
      int i = 0;
      while (i < N_RATES && arg != RATES[i].name) i++;
      if (arg == "0") {
        cfg.rateAuto = 1;
        cfg.rateTop = 255;
        rateKick = 1;
      } else if (i == N_RATES) return;
      else {   // выбранная вручную — верхняя ступень: ради слабого приёмника передатчик опустится с неё сам (Ql0 — запретить)
        cfg.rateAuto = 0;
        cfg.rateTop = i;
        // как с экрана (ui_tx.h): стоим внизу ради слабого приёмника — наверх ведёт rateAutoTick (сразу, если уже можно)
        if (!(cfg.isTx && rateHeldLow())) {
          cfg.rateIdx = i;
          rApply = true;
        }
        rateKick = 1;
      }
      break;
    }
    case 'w':
      if (cfg.isTx) cfg.stereo = v ? 1 : 0;
      else cfg.rxStereo = v ? 1 : 0;
      break;
    case 'y': {
      int sp = arg.indexOf(' ');
      if (sp < 0) return;
      long x = arg.substring(sp + 1).toInt();
      switch (v) {
        case 1: cfg.testTrack = constrain(x, 0, 7); break;
        case 2: cfg.duckS = constrain(x, 10, 240); break;
        case 3: cfg.duckDb = constrain(x, -40, -6); break;
        case 4: cfg.voiceGapS = constrain(x, 1, 60); break;
        case 5: cfg.musicDb = constrain(x, -30, 0); break;
        case 6: cfg.voiceDb = constrain(x, -30, 0); break;
        default: return;
      }
      break;
    }
    case 'q':   // якість звуку: 0 найвища … 3 дальня, 4 — «Монітор» (48 кГц, 24 біти, з 23.10)
      if (v < 0 || (v >= Q_COUNT && v != Q_MON)) return;
      cfg.quality = v;
      if (cfg.isTx && rateHeldLow()) rateKick = 1;   // как с экрана: подняться с нижней ступени, если приёмники уже слышат
      break;
    case 'p':
      if (v < 2 || v > 20) return;
      cfg.powerDbm = v;
      rApply = true;
      break;
    case 'g':   // 0 вход, 1 тон, 2 голос, 3 голос и музыка, 4 музыка, 5 музыка с объявлением
      if (v < 0 || v >= TEST_COUNT) return;
      cfg.tone = v;
      if (v) cfg.lastTone = v;
      break;
    case 'U':   // передатчик: открыть вкладку меню (0 головна … 5 довідка) — для замеров без рук
      if (cfg.isTx && arg.length() && arg[0] == 't') txscreen::tapAsk = arg.substring(1).toInt();   // Ut<номер> — «нажать» кнопку
      else if (cfg.isTx && arg.length() && arg[0] == 'q') txscreen::fmStateAsk = true;                // Uq — что на экране карты
      else if (cfg.isTx && arg.length() && arg[0] == 'k') txscreen::kbReport();                       // Uk — что набрано на клавиатуре
      else if (cfg.isTx && arg.length() && arg[0] == 'x' && !fakeAsk) {   // «касания» экрана без пальца (проверка клавиатуры):
        // Ux<x>,<y>,<мс>[,<сдвиг>] — одно; Ux<пауза>:<x>,<y>,<мс>[,<сдвиг>];<x>,<y>,<мс>;… — несколько подряд
        const char *c = arg.c_str() + 1;
        const char *colon = strchr(c, ':');
        fakeGap = colon ? atoi(c) : 50;
        if (colon) c = colon + 1;
        int n = 0;
        while (*c && n < 24) {
          int x = 0, y = 0, ms = 80, dx = 0;
          if (sscanf(c, "%d,%d,%d,%d", &x, &y, &ms, &dx) < 2) break;
          fakeTap[n++] = FakeTap{ (int16_t)x, (int16_t)y, (int16_t)dx, (uint16_t)(ms < 8 ? 8 : ms > 5000 ? 5000 : ms) };
          c = strchr(c, ';');
          if (!c) break;
          c++;
        }
        fakeN = n;
        fakeAsk = n > 0;
      } else if (cfg.isTx && v >= 0 && (v < ui::PG_N || v == 9)) txscreen::pageAsk = v;   // U<0–5> — открыть вкладку, U9 — карту
      return;
    case 'b': cfg.board = v ? BOARD_4848 : BOARD_DEVKIT; restart = true; break;
    case 'a':   // a0 — встроенный вход, a1 — PCM1808; a2 — проба: PCM1808 на один запуск без главного такта (порт работает)
      cfg.input = v ? IN_I2S : IN_ADC;
      txI2sNoMclk = v == 2 ? I2S_NO_MCLK : 0;
      restart = true;
      break;
    case 'o': cfg.output = v == 2 ? OUT_CS4344 : v ? OUT_I2S : OUT_PDM; restart = true; break;
    case 'd':
      if (v != 0 && (v < 4 || v > 40)) return;
      cfg.depthMs = v;
      break;
    case 'l':
      if (v < 0 || v > 20) return;
      cfg.volume = v;
      break;
    case 'm':   // приёмник: тишина в наушниках; передатчик: тишина в эфире
      if (cfg.isTx) {
        txMute = !txMute;
        cfg.txMute = txMute;
        settingsSave();
        Serial.printf("тиша в ефірі: %s\n", txMute ? "УВІМКНЕНО" : "вимкнено");
      } else rxMute = !rxMute;
      return;
    case 's':
      if (cfg.isTx) scanStart();
      return;
    case 'z':   // передатчик: замолчать в эфире совсем (z1) и вернуться (z0) — проверка ожидания приёмников; не запоминается
      if (cfg.isTx) {
        txHold = arg.length() ? v != 0 : !txHold;
        Serial.printf("передача %s\n", txHold ? "ЗУПИНЕНА (z0 — повернути)" : "йде");
      }
      return;
    case 'K':   // защита: состояние; K0 — забыть ключ
      if (arg == "0") {
        if (cfg.isTx) {
          secNewKey();
          Serial.println("створено НОВИЙ ключ набору: усі приймачі треба додати заново");
        } else {
          secForget();
          Serial.println("ключ набору забуто: приймач проситиме доступ");
        }
      }
      Serial.printf("захист: ключ набору %s (покоління %u), епоха %u; відкинуто: з чужим підписом %u, старих (повторів) %u; шифр апаратний AES-128\n",
                    secHave ? "Є" : "НЕМАЄ", (unsigned)secGen, (unsigned)secEpoch, (unsigned)secBadTag, (unsigned)secReplay);
      if (!cfg.isTx) Serial.printf("  особистий ключ приймача %s; новий ключ набору просив %u, отримав %u разів\n", secDev.ok ? "є" : "НЕМАЄ", (unsigned)rxKeyAsked,
                                   (unsigned)rxKeyTaken);
      Serial.printf("пам'ять: вільно %u байт (найменше з запуску %u), найбільший шматок %u; апаратний AES додатково: звернень %u, помилок %u\n",
                    (unsigned)heap_caps_get_free_size(MALLOC_CAP_INTERNAL), (unsigned)heap_caps_get_minimum_free_size(MALLOC_CAP_INTERNAL),
                    (unsigned)heap_caps_get_largest_free_block(MALLOC_CAP_INTERNAL), (unsigned)secHwRuns, (unsigned)secHwFails);
      if (cfg.isTx) pairPrint();
      else if (!secHave) Serial.printf("  прошу доступ: код %04u, запитів надіслано %u, передавач %s\n", (unsigned)rxPairCode, (unsigned)rxPairAsked,
                                       msSince(rLastAnyMs) < 1000 && rLastAnyMs ? "чути" : "не чути");
      return;
    case 'J':
      if (!cfg.isTx) return;
      if (arg.length()) pairOpen(v != 0);
      pairPrint();
      return;
    case 'j':
      if (cfg.isTx && v >= 1 && v <= PAIR_ASKS) pairApproveAsk = v - 1;
      return;
    case 'R':   // передатчик: удалить приёмник из набора — R<шесть знаков номера>, например R4C3B10
      if (cfg.isTx && arg.length() == 6) {
        uint8_t id[3];
        for (int i = 0; i < 3; i++) id[i] = (uint8_t)strtol(arg.substring(i * 2, i * 2 + 2).c_str(), NULL, 16);
        int i = peerFind(id);
        if (i >= 0) peerRemove(i);
        else Serial.println("такого приймача в наборі немає");
      }
      return;
    case 'B': secSelfTest(); return;
    case 'D':   // передатчик: что с картой памяти; D<число> — скорость обмена с картой, МГц (D4, D8, D16, D20), карта подключается заново
      if (cfg.isTx && cfg.board == BOARD_4848 && arg.length() && v >= 1 && v <= 40) {
        recSpiHz = (uint32_t)v * 1000000;
        recRemount = true;
        Serial.printf("картка: обмін тепер %ld МГц\n", v);
        return;
      }
      if (cfg.isTx && cfg.board == BOARD_4848) {
        Serial.printf("запис: обмін %u МГц; записів куска %u, найдовший %u мс; втрачено відліків %u; збоїв запису %u (останній: на %u-му байті, errno %d, тривав %u мс)\n",
                      (unsigned)(recSpiHz / 1000000), (unsigned)recWrN, (unsigned)recWrMaxMs, (unsigned)recLost, (unsigned)recFails, (unsigned)recFailAt, recFailErrno,
                      (unsigned)recFailMs);
        Serial.printf("картка: кластер %u КБ; звернень на запис %u, скидань накопичувача %u, повторів після заминки %u, найдовше чекання %u мс, здався %u разів\n",
                      (unsigned)recClusterKb, (unsigned)sdOps, (unsigned)sdwFlushes, (unsigned)sdRetries, (unsigned)sdSettleMaxMs, (unsigned)sdGiveUps);
        Serial.printf("  по одному сектору: %u разів, сер. %.1f мс; по кілька: %u разів, секторів %u, сер. %.1f мс на звернення; найдовше %.0f мс\n", (unsigned)sdN1,
                      sdN1 ? sdUs1 / 1000.0f / sdN1 : 0.0f, (unsigned)sdNm, (unsigned)sdSecM, sdNm ? sdUsM / 1000.0f / sdNm : 0.0f, sdMaxUs / 1000.0f);
        sdN1 = sdUs1 = sdNm = sdSecM = sdUsM = sdMaxUs = 0;
        static const char *const ST[] = { "картка не відповідає (її немає або немає контакту)", "підключена", "відповідає, але розмітка не та",
                                          "відповідає, але не запускається" };
        if (recCard == CARD_OK)
          Serial.printf("  %s; внутрішньої пам'яті до підключення картки %u КБ, після %u КБ\n", recOn ? "іде запис" : recFull ? "місця немає" : "запису немає",
                        (unsigned)(recMemBefore / 1024), (unsigned)(recMemAfter / 1024));
        Serial.printf("картка пам'яті: %s; обсяг %u МБ%s%s; вільно %u МБ%s\n", ST[recCard & 3], (unsigned)recCardMb, recCardFs[0] ? ", розмітка " : "", recCardFs,
                      (unsigned)recFreeMb, recCard == CARD_BAD_FS ? " — потрібна FAT32 (exFAT ця прошивка не читає)" : "");
        if (recCard != CARD_OK)
          Serial.printf("  відповідь на скидання: 0x%02X (0x01 — картка є, 0xFF — мовчить); на другий запит: 0x%02X [%02X %02X %02X %02X]; рівні виводів зараз: 41=%d 42=%d 47=%d 48=%d\n",
                        recRaw0, recRaw8, recRaw7[0], recRaw7[1], recRaw7[2], recRaw7[3], digitalRead(41), digitalRead(42), digitalRead(47), digitalRead(48));
        if (recCard != CARD_OK)
          Serial.printf("  вручну (без блока SPI): відповідь 0x%02X [%02X %02X %02X %02X %02X %02X %02X %02X]; такт 48: вгору %s, вниз %s; дані 47: вгору %s, вниз %s; лінія від картки 41 з підтяжкою вниз: у спокої %d, при вибраній картці %d; блок SPI %s\n",
                        recBbR1, recBbResp[0], recBbResp[1], recBbResp[2], recBbResp[3], recBbResp[4], recBbResp[5], recBbResp[6], recBbResp[7],
                        (recBbPins & 1) ? "так" : "НІ", (recBbPins & 2) ? "так" : "НІ", (recBbPins & 4) ? "так" : "НІ", (recBbPins & 8) ? "так" : "НІ",
                        (recBbPins >> 4) & 1, (recBbPins >> 5) & 1, recSpiOk ? "запущено" : "НЕ ЗАПУСТИВСЯ");
        recBbAsk = true;
        recProbeAsk = true;
      }
      return;
    case 'G':   // передатчик: отладка по радио — G1 включить, G0 выключить (то же — «Налашт.» › «Налагодження ефіром»); G — состояние
      if (cfg.isTx && arg.length()) {
        cfg.dbgAir = v ? 1 : 0;
        settingsSave();
        if (cfg.board == BOARD_4848) ui::needFull = true;
      }
      Serial.printf("налагодження ефіром: %s; надіслано рядків %u, почуто чужих %u, не вмістилось %u\n", dbgAirOn() ? "УВІМКНЕНО" : "вимкнено", (unsigned)dbgSent,
                    (unsigned)dbgHeard, (unsigned)dbgDropped);
      return;
    case 'Y':   // передатчик: Y1 — вывод кадра экрана «по-старому» (для сравнения), Y0 — свой; плата перезапускается
      if (cfg.isTx && v >= 5 && v <= 8) {   // Y5…Y8 — опыт: способ подготовки порции кадра в движении (0…3)
        lcdSlideMode = v - 5;
        Serial.printf("вивід кадру в русі: спосіб %u\n", lcdSlideMode);
        return;
      }
      if (v == 2) {   // Y2 — сколько свободного времени на каждом ядре: секунду крутим пустой счётчик на обоих (приёмник — с 2.93)
        cpuProbe();
        return;
      }
      if (v == 14) {   // Y14 — время ядер по задачам за 2 с (с 2.94; только в сборке с HL_TASK_LOAD)
#ifdef HL_TASK_LOAD
        taskLoad();
#else
        Serial.println("Y14 — лише у збірці з HL_TASK_LOAD (див. taskLoad у hearlink.ino)");
#endif
        return;
      }
      if (!cfg.isTx && v == 16 && rxRsTab && rxRing && rxRingS) {   // Y16 — приёмник: свёртка подгонки темпа отдельно, 32 вызова подряд (кэш «тёплый»), лучшее из 50
        uint32_t best = UINT32_MAX, first = 0;
        float ym = 0, ysum = 0;
        for (int r = 0; r < 50; r++) {
          uint32_t t0 = esp_cpu_get_cycle_count();
          for (int k = 0; k < 32; k++) {
            float a = 0, b = 0;
            rsDot(rxRsTab + (k & 63) * rxRsTaps, 0.37f, rxRsTaps, rxRing + 64 * k, rxRingS + 64 * k, &a, &b);
            ym += a;
            ysum += b;
          }
          uint32_t dt = esp_cpu_get_cycle_count() - t0;
          if (!r) first = dt;
          if (dt < best) best = dt;
        }
        Serial.printf("згортка підгонки темпу (%d відводів, два канали): найкраще %u тактів на виклик, перший прохід %u (%s)\n", rxRsTaps, (unsigned)(best / 32), (unsigned)(first / 32),
                      ym + ysum == 12345.0f ? "!" : "ok");
        return;
      }
      if (!cfg.isTx && (v == 17 || v == 18)) {   // Y17 — строка состояния OLED каждый кадр заново (как до 3.12), Y18 — из запаса (с 3.12)
        oledCache = v == 18;
        oledStaticKey = 0;
        Serial.printf("рядок стану OLED: %s\n", oledCache ? "із запасу, малюється лише при зміні" : "щокадру заново (як до 3.12)");
        return;
      }
      if (!cfg.isTx && (v == 19 || v == 20)) {   // Y19 — разбор спектра своим БПФ (как до 3.12), Y20 — esp-dsp (с 3.12, ui_rx.h)
        fftUseDsp = v == 20;
        Serial.printf("розбір спектра: %s\n", fftUseDsp ? (fftDsp ? "esp-dsp" : "esp-dsp не запустився — свій") : "свій (як до 3.12)");
        return;
      }
      if (!cfg.isTx && v == 21) {   // Y21 — оба разбора на одном окне звука: уровни полос и разница (с 3.12)
        fftCmpReady = false;
        fftCmpAsk = true;
        for (int t = 0; t < 300 && !fftCmpReady; t++) delay(1);
        if (!fftCmpReady) {
          fftCmpAsk = false;
          Serial.println("спектр зараз не рахується (не головний екран зі спектром)");
          return;
        }
        float dmax = 0;
        char line[200];
        int n = snprintf(line, sizeof(line), "смуги, дБ (свій / esp-dsp):");
        for (int b = 0; b < specBands && n < (int)sizeof(line) - 16; b++) {
          float d = fabsf(fftCmpA[b] - fftCmpB[b]);
          if (d > dmax) dmax = d;
          n += snprintf(line + n, sizeof(line) - n, " %.0f/%.0f", fftCmpA[b], fftCmpB[b]);
        }
        Serial.println(line);
        Serial.printf("найбільша різниця %.3f дБ; розбір: свій %u мкс, esp-dsp %u мкс\n", dmax, (unsigned)fftCmpUsA, (unsigned)fftCmpUsB);
        return;
      }
      if (!cfg.isTx && v == 23) {   // Y23[=сила 0…3] — приёмник с цветным экраном: 8 с кадр целиком без остановки — послушать наводку (с 3.11)
        if (!uiHaveColor) {
          Serial.println("кольорового екрана немає (n14=1)");
          return;
        }
        int eq = arg.indexOf('=');
        int cap = eq > 0 ? arg.substring(eq + 1).toInt() : -1;
        if (cap > 3) cap = 3;
        rxLcdDrive(cap);
        lcdStressUntil = (millis() + 8000) | 1;
        Serial.printf("8 с — кадр цілком без упину, виводи шини %d, шина %u МГц\n", cap < 0 ? (int)rxLcdCap : cap, (unsigned)rxLcdMhz(cfg.rxDispOpt));
        return;
      }
      if (!cfg.isTx && v == 22) {   // Y22 — приёмник с цветным экраном: помеха шины экрана радио, 7 фаз по 5 с (с 3.09; ui_rx.h, LCD_EMI)
        if (!uiHaveColor) {
          Serial.println("кольорового екрана немає (n14=1)");
          return;
        }
        lcdEmiStart();
        Serial.printf("перевірка завад від шини екрана: %d фаз по %u с, підсумок — у звіті за ~%u с\n", LCD_EMI_N, (unsigned)(LCD_EMI_MS / 1000), (unsigned)(LCD_EMI_N * LCD_EMI_MS / 1000 + 2));
        return;
      }
      if (!cfg.isTx && v == 15) {   // Y15 — приёмник: ступени тракта, мкс на блок 1 мс с прошлого такого вызова (с 2.94)
        rxStReady = false;
        rxStAsk = true;
        for (int t = 0; t < 50 && !rxStReady; t++) delay(1);
        if (!rxStReady) {
          rxStAsk = false;
          Serial.println("тракт приймача зараз не рахує (звук вимкнено)");
          return;
        }
        uint32_t n = rxStResN, *c = rxStRes;
        float k = n ? 1.0f / n : 0;
        // самое важное — в начале строки: по радио (отладка G1) длинная строка обрезается
        Serial.printf("тракт приймача: усього %.0f мкс на блок 1 мс, найдовший блок %u (блоків %u): до підгонки темпу %.0f, підгонка темпу %.0f, шумозаглушення %.0f, обробка й вихід %.0f, решта %.0f\n",
                      ((float)c[0] + c[1] + c[2] + c[3] + c[4]) * k, (unsigned)rxStResMax, (unsigned)n, c[0] * k, c[1] * k, c[2] * k, c[3] * k, c[4] * k);
        Serial.printf("  до підгонки темпу: запас %.0f, темп %.0f, налаштування %.0f, гучність %.0f\n", c[5] * k, c[6] * k, c[7] * k, c[8] * k);
        return;
      }
      if (!cfg.isTx && (v == 12 || v == 13)) {   // приёмник: Y12 — кадр экрана уходит с приоритетом экрана (как до 2.93), Y13 — выше звука
        oledFlushHigh = v == 13;
        Serial.printf("передача кадру на екран: %s\n", oledFlushHigh ? "вище за звук (як з 2.93)" : "з пріоритетом екрана (як до 2.93)");
        return;
      }
      if (cfg.isTx && (v == 3 || v == 4)) {   // Y3 — выключить подгрузку порций кадра в кэш (для сравнения), Y4 — включить; затем замер ядер
        lcdNoPreload = v == 3;
        delay(300);
        cpuProbe();
        return;
      }
      if (cfg.isTx && cfg.board == BOARD_4848 && v == 9) {   // Y9 — опыт: нарочно сбить драйвер экрана с очереди буферов (panel4848.h)
        lcdProvokeFlip();
        return;
      }
      if (cfg.isTx && cfg.board == BOARD_4848 && (v == 10 || v == 11)) {   // Y10 — класть порции, куда велит драйвер (как до 2.49), Y11 — по-своему
        lcdBbTrustDriver = v == 10;
        Serial.printf("буфер для порції кадру: %s\n", lcdBbTrustDriver ? "той, що називає драйвер (як до 2.49)" : "свій — за місцем порції в кадрі");
        return;
      }
      if (cfg.isTx && cfg.board == BOARD_4848 && v <= 1 && arg.length()) {
        lcdClassicMagic = v ? LCD_CLASSIC : 0;
        Serial.println("перезапуск із іншим виводом кадру");
        Serial.flush();
        ESP.restart();
      }
      return;
    case 'F':   // передатчик: файловый менеджер карты с порта — Fl<папка> список, Fi<файл> сведения, Fp<файл> в эфир, Fs стоп,
                // Fx<файл>|<смещение>|<длина> — кусок файла на компьютер (tools/getfile.py),
                // Fm<папка> создать, Fd<путь> удалить, Fc<файл>|<папка> копировать; F — что сейчас в эфире. Форматирования с порта нет.
      if (cfg.isTx && cfg.board == BOARD_4848) fmSerial(arg);
      return;
    case 'Z':   // передатчик: запись на карту — Z1 начать, Z0 остановить, Z — список записей
      if (cfg.isTx && cfg.board == BOARD_4848) {
        if (!recSd) Serial.println("картки немає — запис неможливий");
        else if (arg.length() == 0) recListAsk = true;
        else if (arg[0] == 'v') recVerify(arg.c_str() + 1);   // Zv<файл> — сверить запись проверочного узора
        else if (v) {   // Z1 — запись звука; Z2 — проверочный узор (счётчик); Z3 — узор без накопителя секторов
          recPattern = v >= 2;
          recNoCache = v == 3;
          recWantStart = true;
        } else recWantStop = true;
      }
      return;
    case 'C':   // передатчик 4.x: мост — C стан; C1 — цифровий вхід (AES), C2 — аналоговий (PCM1808), C7 — USB; C8 — журнал моста; C9 — оновити міст зараз
      if (cfg.isTx) {
        if (arg.length() && v == 9) brUpd.ask = true;
        if (arg.length() && v == 8) {
          txBridgeLogAsk();
          return;
        }
        if (arg.length() && (v == 10 || v == 11)) {   // аналоговый вход: C10 — стерео, C11 — симметричный (cfg.pcmDiff)
          cfg.pcmDiff = v == 11 ? 1 : 0;
          txBr.kick = true;
          settingsSave();
          if (cfg.board == BOARD_4848) ui::needFull = true;
        }
        if (arg.length() && (v == 12 || v == 13)) {   // гул радио на аналоговом входе: C12 — вычитать, C13 — нет (cfg.pcmHum)
          cfg.pcmHum = v == 12 ? 1 : 0;
          txBr.kick = true;
          settingsSave();
          if (cfg.board == BOARD_4848) ui::needFull = true;
        }
        if (arg.length() && v >= 3 && v <= 6) {   // проверочный сигнал моста: C3 нет, C4 тон, C5 розовый шум, C6 развёртка
          txBr.gen = (uint8_t)(v - 3);
          if (cfg.tone) cfg.tone = 0;   // сигнал идёт входом — вход и должен быть в эфире
          txBr.kick = true;
        }
        if (arg.length() && (v == BP_SRC_AES || v == BP_SRC_PCM || v == 7)) {
          cfg.bridgeSrc = (uint8_t)(v == 7 ? BP_SRC_USB : v);
          if (cfg.tone) cfg.tone = 0;   // выбор входа — это и «в ефір вхід» (как кнопка на экране)
          txBr.gen = BP_GEN_OFF;
          txBr.kick = true;
          settingsSave();
          if (cfg.board == BOARD_4848) ui::needFull = true;
        }
        txBridgePrint();
      }
      return;
    case 'S':   // передатчик: имя источника звука на кнопке (S без имени — вернуть «З пульта»)
      if (cfg.isTx) {
        strlcpy(cfg.srcName, arg.c_str(), sizeof(cfg.srcName));
        settingsSave();
        if (cfg.board == BOARD_4848) ui::needFull = true;
        Serial.printf("назва джерела звуку: «%s»\n", cfg.srcName[0] ? cfg.srcName : "З пульта");
      }
      return;
    case 'L':   // язык надписей: L0 — українська, L1 — English (на передатчике; приёмники берут его у передатчика)
      if (arg.length()) {
        cfg.lang = v ? 1 : 0;
        uiLang = cfg.lang;
        settingsSave();
        if (cfg.isTx && cfg.board == BOARD_4848) ui::needFull = true;
      }
      Serial.printf("мова написів: %s", cfg.lang ? "English" : "українська");
      if (cfg.isTx) Serial.printf("; голос оголошення: запис «%s»%s", txVoiceName(), cfg.lang && assetFind("golos-en") < 0 ? " (англійського голосу в пам'яті немає)" : "");
      Serial.println();
      return;
    case 'h':   // передатчик: сам уходит с занятого канала — h1 / h0; h2 — перейти сейчас (проверка без настоящего затора)
      if (cfg.isTx) {
        if (v == 2) hopForce = true;
        else if (v == 3) {            // шесть «плохих» секунд подряд — проверить счёт затора (паузу после прошлой попытки снять)
          hopFake = 6;
          hopQuietUntil = 0;
        } else if (v == 4) hopSoftForce = true;   // «мягкий» уход сейчас: проба лучшего по замеру канала, через минуту работы на нём — возврат (проверка хода)
        else if (arg.length()) cfg.autoHop = v ? 1 : 0;
        Serial.printf("канал при заторі: %s%s\n", cfg.autoHop ? "міняю сам" : "не міняю", v == 2 ? "; пошук почнеться за секунду" : v == 3 ? "; шість секунд вважаю поганими" : v == 4 ? "; м'яка проба почнеться за секунду, за хвилину повернуся" : "");
        hopSoftPrint();
        if (v < 2 && arg.length()) settingsSave();
      }
      return;
    case 'O':   // передатчик: выключить (как кнопкой в шапке); включает касание экрана — или сброс
      if (cfg.isTx && cfg.board == BOARD_4848) txscreen::offAsk = true;
      return;
    case 'x':   // отладка: шифр вхолостую вдобавок к рабочему (1 — в задаче передачи, 2 — в задаче Wi-Fi, 3 — в обеих, 0 — выключить)
      secShadow = v & 3;
      Serial.printf("апаратний AES додатково: %u\n", (unsigned)secShadow);
      return;
    case 'T':   // передатчик: короткая очередь и прореживание пакетов при занятом эфире — T1 (обычно), T0 — как до версии 1.7; не запоминается
      if (cfg.isTx) {
        txThinOn = v != 0;
        Serial.printf("прорідження при зайнятому ефірі %s\n", txThinOn ? "увімкнено" : "ВИМКНЕНО");
      }
      return;
    case 'A':   // передатчик: считать чужие передачи на своём канале (A1) — в ежесекундном отчёте; A0 — выключить
      if (cfg.isTx) {
        monSet(v != 0);
        Serial.printf("спостереження за ефіром %s\n", monOn ? "увімкнено" : "вимкнено");
      }
      return;
    case 'P':
      if (cfg.isTx && arg == "0") {
        peersStatZero();
        Serial.println("лічбу повідомлень приймачів почато заново");
      }
      peersPrint();
      return;
    case 'n':   // приёмник: настройки «для слуха и удобства» — n показать; n<номер>=<значение> сменить; n9=1 / n9=0 — проверка наушников
      if (!cfg.isTx) {
        int p = -1, val = 0;
        if (arg == "14") arg = "14=0";   // n14 без значения — тоже справка об экране (с 3.13)
        if (sscanf(arg.c_str(), "%d=%d", &p, &val) == 2) {
          if (p == 9) rxEarStart(val != 0);
          else if (p == 10) {   // n10=<дБ 0…24> — усиление (с 2.48)
            if (rxParamSet(RXP_X_BOOST, val / 2)) settingsSave();
          }
          else if (p == 11) {   // n11=<0|1|2> — проверка: вести себя как прошивка до 2.60 (см. rxOldSim в radio.h)
            rxOldSim = val < 0 || val > 2 ? 0 : (uint8_t)val;
            Serial.printf("перевірка сумісності: %s\n", rxOldSim == 2 ? "подвійних пакетів не знаю і називаюсь версією 2.56" : rxOldSim ? "подвійних пакетів не знаю" : "вимкнено");
          }
          else if (p == 12) {   // n12=<0…4> — проверка самолечения радио приёмника без настоящей неисправности (см. rxTxFake в radio.h)
            rxTxFake = val < 0 || val > 4 ? 0 : (uint8_t)val;
            static const char *const FK[] = { "вимкнено", "драйвер «узяв пакет і мовчить»", "пакети «йдуть у нікуди» (до перезавантаження радіо)", "пакети «йдуть у нікуди» (до перезапуску плати)", "пакети «йдуть у нікуди» (і після перезапуску плати)" };
            Serial.printf("перевірка радіо приймача: %s\n", FK[rxTxFake]);
          }
          else if (p == 13) {   // n13=<0|1> — проверка: сообщать о себе по-старому, «всем», без подтверждения (см. rxSendTo в radio.h)
            rxUniOff = val ? 1 : 0;
            Serial.printf("повідомлення про себе: %s\n", rxUniOff ? "по-старому, «всім» (перевірка)" : "на адресу передавача, з підтвердженням");
          }
          else if (p == 14) {   // n14 — какой экран (с 3.13 только справка: тип задаёт перемычка вывода 21 на «землю», ui_rx.h)
            Serial.printf("екран: %s; вибір — перемичкою: вивід %d на землі — кольоровий IPS 1,9″ (SCL 42, SDA 41, DC 40, CS 39, RES 2, BLK 1), вільний — OLED\n",
                          uiHaveColor ? "кольоровий" : rxColorJumper ? "перемичку поставлено, але кольоровий не запустився" : "OLED", PIN_RX_COLOR);
          }
          else if (p == 15) {   // n15=<1…5> — яркость экрана (с 3.03)
            cfg.rxBright = (uint8_t)(val < 1 ? 1 : val > 5 ? 5 : val);
            dispBright();
            settingsSave();
            Serial.printf("яскравість екрана %u з 5\n", cfg.rxBright);
          }
          else if (p == 27) {   // n27=<біти> — свойства цветного модуля (с 3.03; перезапуск): 1 — повёрнут на 180°, 2 — цвета BGR, 4 — шина 80 МГц,
                                // 8 — шина 40 МГц (без 4 и 8 — 20, с 3.11), 16 — сильные выводы шины (без него — самые слабые, с 3.11)
            cfg.rxDispOpt = (uint8_t)(val & 31);
            settingsSave();
            Serial.printf("кольоровий екран: %s, кольори %s, шина %u МГц, виводи шини %s — перезапуск\n", (cfg.rxDispOpt & 1) ? "повернутий на 180°" : "як є",
                          (cfg.rxDispOpt & 2) ? "BGR" : "RGB", (unsigned)rxLcdMhz(cfg.rxDispOpt), (cfg.rxDispOpt & 16) ? "сильні (як до 3.11)" : "найслабші");
            Serial.flush();
            delay(100);
            ESP.restart();
          }
          else if (p == 7) rxUiAsk = (uint8_t)val;   // n7=1 меню, n7=2 «Зв'язок», n7=3 главный экран — для замеров
          else if (p == 8) {   // n8=1 — как настроен вывод кнопки ручки; n8=<мс> — «нажать» её программно на столько миллисекунд
            if (val >= 11 && val <= 14) {   // n8=11 — «не число» на вход обработки, 12 — в память эквалайзера, 13 — держать выход на одном числе, 14 — снять
              rxFakeNan = val == 14 ? 0 : (uint8_t)val;
              Serial.printf("перевірка сторожа звуку: %s; скидань через «не число» %u, через стоячий вихід %u, спіймано на вході %u\n", val == 11 ? "«не число» на вхід обробки" : val == 12 ? "«не число» в пам'ять еквалайзера" : val == 13 ? "вихід тримаю на одному числі (n8=14 — зняти)" : "знято", (unsigned)rxFxNan, (unsigned)rxFxStuck, (unsigned)rxBadIn);
              return;
            }
            if (val == 9) {   // n8=9 — «логический анализатор»: что на самом деле идёт на ЦАП по выводам BCK, LRCK и данных
              if (cfg.output != OUT_I2S) {
                Serial.println("вихід не PCM5102 — знімати нічого");
                return;
              }
              const int N = 16384;
              uint8_t *b = (uint8_t *)malloc(N);
              if (!b) return;
              for (int pin : { PIN_I2S_MCLK, PIN_I2S_BCK, PIN_I2S_WS, PIN_I2S_DOUT }) gpio_input_enable((gpio_num_t)pin);
              digitalWrite(PIN_DAC_XSMT, LOW);   // ЦАП заглушить: в наушники постоянные числа не пойдут
              delay(40);
              rxPattern = true;
              delay(30);
              portDISABLE_INTERRUPTS();
              for (int i = 0; i < N; i++) b[i] = (uint8_t)(REG_READ(GPIO_IN_REG) >> 10);   // бит 0 — вывод 10, 1 — BCK, 2 — LRCK, 3 — данные
              portENABLE_INTERRUPTS();
              rxPattern = false;
              delay(30);
              digitalWrite(PIN_DAC_XSMT, rxDacOpen ? HIGH : LOW);
              static int idx[420];
              int n = 0;
              for (int i = 1; i < N - 4 && n < 420; i++)
                if (!((b[i - 1] >> 1) & 1) && ((b[i] >> 1) & 1)) idx[n++] = i;   // подъёмы BCK
              if (n < 80) {
                Serial.printf("BCK не видно (підйомів %d)\n", n);
                free(b);
                return;
              }
              float per = (float)(idx[n - 1] - idx[0]) / (n - 1);
              Serial.printf("знято %d відліків; на один такт BCK %.1f відліку; вивід 10 (SCK): %d\n", N, per, b[N / 2] & 1);
              int k0 = -1;   // первый подъём BCK, на котором LRCK уже 0, а на предыдущем был 1
              for (int k = 3; k < n - 40; k++)
                if (((b[idx[k - 1]] >> 2) & 1) && !((b[idx[k]] >> 2) & 1)) {
                  k0 = k;
                  break;
                }
              if (k0 < 0) {
                Serial.println("LRCK не змінюється");
                free(b);
                return;
              }
              char ws[40], d0[40], d1[40];
              int m = 0;
              for (; m < 36 && k0 + m < n; m++) {
                int i = idx[k0 + m];
                ws[m] = '0' + ((b[i] >> 2) & 1);
                d0[m] = '0' + ((b[i - 3 < 0 ? 0 : i - 3] >> 3) & 1);   // данные чуть раньше подъёма BCK
                d1[m] = '0' + ((b[i + 3] >> 3) & 1);                   // и чуть позже: должны совпадать
              }
              ws[m] = d0[m] = d1[m] = 0;
              // когда меняется LRCK: при каком уровне BCK и за сколько отсчётов до ближайшего подъёма
              int j = idx[k0 - 1];
              while (j < idx[k0] && ((b[j] >> 2) & 1)) j++;
              Serial.printf("LRCK:   %s\n", ws);
              Serial.printf("DATA до: %s\n", d0);
              Serial.printf("DATA по: %s\n", d1);
              Serial.printf("LRCK упав при BCK=%d, за %d відліків до підйому BCK (такт — %.0f відліків)\n", (b[j] >> 1) & 1, idx[k0] - j, per);
              free(b);
              return;
            }
            if (val == 8) {   // n8=8 — настоящие частоты за время с прошлого такого вызова: звук из эфира (часы передатчика) и выход (свои часы)
              static int64_t t0;
              static uint32_t in0, out0, st0, sn0;
              int64_t t = esp_timer_get_time();
              uint32_t in = rxInSamples, out = rxOutSamples;
              if (t0) {
                double sec = (t - t0) / 1e6, fin = (in - in0) / sec, fout = (out - out0) / sec;
                Serial.printf("за %.1f с: з ефіру %.2f відліків/с (%+.0f ppm від 32000), на вихід %.2f відліків/с (%+.0f ppm від %u), вихід відносно ефіру %+.0f ppm; темп %+.0f ppm\n",
                              sec, fin, (fin / 32000 - 1) * 1e6, fout, (fout / rxOutRate - 1) * 1e6, (unsigned)rxOutRate, (fout / (fin / rxRateBase) - 1) * 1e6, (double)rxRatioPpm);
              }
              if (t0) {
                Serial.printf("вихід лишався без даних %u раз із %u порцій по 1 мс\n", (unsigned)(rxOutStarved - st0), (unsigned)(rxOutSent - sn0));
                float low = rxLimLow;
                Serial.printf("обмежувач: працював %.1f %% часу, найбільше −%.1f дБ; гучність %u, чіткість %u\n", (out - out0) ? 100.0 * rxLimBusy / (out - out0) : 0.0,
                              low < 1 ? -20 * log10f(low) : 0.0f, cfg.volume, cfg.rxClarity);
                Serial.printf("кадрів із запасних копій: %u, із них без стиснення (точних) %u; зі стерео %u, у моно %u; подвійних пакетів (два кадри в пакеті) прийнято %u\n", (unsigned)rxRecAll, (unsigned)rxExactRec, (unsigned)rxScCount, (unsigned)rxMonoRec, (unsigned)rxDblCount);
                if (rxSubCalls) Serial.printf("новий кодек: пакетів розібрано %u, час на пакет сер. %u, найдовше %u мкс\n", (unsigned)rxSubCalls, (unsigned)(rxSubUsSum / rxSubCalls), (unsigned)rxSubUsMax);
                rxSubCalls = 0;
                rxSubUsSum = 0;
                rxSubUsMax = 0;
                rxDblCount = 0;
                rxRecAll = 0;
                rxExactRec = 0;
                rxScCount = 0;
                rxMonoRec = 0;
              }
              rxLimBusy = 0;
              rxLimLow = 1;
              st0 = rxOutStarved;
              sn0 = rxOutSent;
              t0 = t;
              in0 = in;
              out0 = out;
              return;
            }
            if (val == 7) {   // n8=7 — что на выводах выхода звука: доля единиц и число перепадов за 20 мс (BCK, LRCK, данные; PDM «+», «−»)
              for (int pin : { PIN_I2S_MCLK, PIN_I2S_BCK, PIN_I2S_WS, PIN_I2S_DOUT, PIN_OUT_P, PIN_OUT_N }) {
                gpio_input_enable((gpio_num_t)pin);
                uint32_t ones = 0, n = 0, edges = 0, t0 = micros();
                int prev = gpio_get_level((gpio_num_t)pin);
                while (micros() - t0 < 20000) {
                  int v = gpio_get_level((gpio_num_t)pin);
                  ones += v;
                  edges += v != prev;
                  prev = v;
                  n++;
                }
                Serial.printf("вивід %d: одиниць %u %%, перепадів за 20 мс %u (≈%u Гц), опитувань %u\n", pin, (unsigned)(n ? ones * 100 / n : 0), (unsigned)edges,
                              (unsigned)(edges * 25), (unsigned)n);
              }
              Serial.printf("вихід: %s, %s; XSMT (вивід %d): %d\n", cfg.output == OUT_CS4344 ? "CS4344 (I2S): MCLK 10 (8 МГц), SCLK 11, LRCK 12, SDIN 13; вивід 14 — «увімкнено» підсилювача (з 3.28)" : cfg.output == OUT_I2S ? "PCM5102 (I2S): BCK 11, LRCK 12, DIN 13; вивід 10 — нуль для SCK" : "PDM: 17, 18",
                            rxOutLive() ? "живий" : "СТОЇТЬ", PIN_DAC_XSMT, gpio_get_level((gpio_num_t)PIN_DAC_XSMT));
              if (cfg.output == OUT_CS4344) {   // делитель главного такта: целый ли (дробный даёт неровные периоды)
                uint32_t n = I2S0.tx_clkm_conf.tx_clkm_div_num, z = I2S0.tx_clkm_div_conf.tx_clkm_div_z, y = I2S0.tx_clkm_div_conf.tx_clkm_div_y;
                uint32_t x = I2S0.tx_clkm_div_conf.tx_clkm_div_x, b = I2S0.tx_conf1.tx_bck_div_num + 1, sel = I2S0.tx_clkm_conf.tx_clk_sel;
                Serial.printf("головний такт: джерело %s, ділення %u%s (дробу z=%u y=%u x=%u) → %.3f МГц; такт бітів = головний / %u; частота виходу %u Гц; %s\n", sel == 2 ? "PLL 160 МГц" : sel == 0 ? "XTAL 40 МГц" : "інше", (unsigned)n, z || y || x ? " з дробом" : " ціле", (unsigned)z, (unsigned)y, (unsigned)x, (sel == 2 ? 160.0 : 40.0) / n, (unsigned)b, (unsigned)rxOutRate, rxMclkGrounded ? "ВИВІД 10 НА «ЗЕМЛІ» — такт на нього не подається" : "такт виходить на вивід 10");
              }
              return;
            }
            if (val == 2) gpio_wakeup_enable((gpio_num_t)PIN_ENC_SW, GPIO_INTR_LOW_LEVEL);   // n8=2 — оставить вывод таким, каким его оставлял сон до 2.32
            if (val == 5 || val == 6 || val == 10) {   // n8=5 — «нажать» ручку на секунду, не задерживая главный цикл; n8=6 — то же через 30 с;
              // n8=10 — через 30 с нажать и держать 11 с (проверка «держать 10 с — забыть набор» у выключенного приёмника)
              // (во сне порт не слушает, поэтому пробуждение кнопкой проверяется нажатием, назначенным заранее)
              static esp_timer_handle_t rel;
              static volatile bool down;
              static volatile uint32_t holdUs;
              holdUs = val == 10 ? 11000000 : 1200000;
              if (!rel) {
                esp_timer_create_args_t ta = {};
                ta.callback = [](void *) {
                  if (!down) {   // пора нажать
                    down = true;
                    gpio_set_direction((gpio_num_t)PIN_ENC_SW, GPIO_MODE_INPUT_OUTPUT_OD);
                    gpio_set_level((gpio_num_t)PIN_ENC_SW, 0);
                    esp_timer_start_once(rel, holdUs);
                  } else {       // пора отпустить
                    down = false;
                    gpio_set_level((gpio_num_t)PIN_ENC_SW, 1);
                    gpio_set_direction((gpio_num_t)PIN_ENC_SW, GPIO_MODE_INPUT);
                  }
                };
                ta.name = "key";
                esp_timer_create(&ta, &rel);
              }
              esp_timer_stop(rel);
              down = false;
              esp_timer_start_once(rel, val == 5 ? 1000 : 30000000);
              Serial.printf("ручку буде натиснуто на %s %s\n", val == 10 ? "11 с" : "секунду", val == 5 ? "зараз" : "через 30 с");
              return;
            }
            if (val == 3 || val == 4) {   // n8=3 / n8=4 — «повернуть» ручку на щелчок в одну и в другую сторону (выводы сами замыкаются на «землю»)
              int a = val == 3 ? PIN_ENC_A : PIN_ENC_B, b = val == 3 ? PIN_ENC_B : PIN_ENC_A;
              for (int pin : { a, b }) gpio_set_direction((gpio_num_t)pin, GPIO_MODE_INPUT_OUTPUT_OD);
              const int seq[4][2] = { { a, 0 }, { b, 0 }, { a, 1 }, { b, 1 } };
              for (auto &st : seq) {
                gpio_set_level((gpio_num_t)st[0], st[1]);
                delay(3);
              }
              for (int pin : { a, b }) gpio_set_direction((gpio_num_t)pin, GPIO_MODE_INPUT);
              Serial.printf("ручку повернуто на крок: лічильник %d, гучність %u\n", (int)encCount, cfg.volume);
              return;
            }
            if (val >= 50) {   // вывод на это время сам тянет себя к «земле» — ровно то, что делает кнопка
              Serial.printf("натискаю ручку на %d мс\n", val);
              Serial.flush();
              gpio_set_direction((gpio_num_t)PIN_ENC_SW, GPIO_MODE_INPUT_OUTPUT_OD);
              gpio_set_level((gpio_num_t)PIN_ENC_SW, 0);
              delay(val > 5000 ? 5000 : val);
              gpio_set_level((gpio_num_t)PIN_ENC_SW, 1);
              gpio_set_direction((gpio_num_t)PIN_ENC_SW, GPIO_MODE_INPUT);
            }
            Serial.printf("вивід кнопки ручки (%d): рівень %d, вид переривання %u, переривання дозволено %u, будить зі сну %u; виходів з очікування %u, кіл сну %u\n",
                          PIN_ENC_SW, gpio_get_level((gpio_num_t)PIN_ENC_SW), (unsigned)GPIO.pin[PIN_ENC_SW].int_type, (unsigned)GPIO.pin[PIN_ENC_SW].int_ena,
                          (unsigned)GPIO.pin[PIN_ENC_SW].wakeup_enable, (unsigned)rxWakes, (unsigned)rxSleeps);
            return;
          }
          else if (rxParamSet((uint8_t)p, val)) settingsSave();
        }
rxFxPrint();
                Serial.printf("налаштування: 0 чіткість %u, 1 баланс %d, 2 межа гучності %u (гучність %u, звук %.1f дБ), 3 вигляд %u, 4 світлодіод %u, 5 мова %u (на екрані %s)%s; підсилення +%u дБ (зараз %+.1f); блокування %u; еквалайзер %d %d %d %d %d дБ, зріз низів %u; рівень до нього %.1f дБ, після %.1f дБ\n",
                      cfg.rxClarity, cfg.rxBalance, cfg.rxVolMax, cfg.volume, cfg.volume ? 20 * log10f(rxVolumeGain(rxVolumeScaled(cfg.volume))) : -99.0f, cfg.rxView, cfg.rxLed, cfg.rxLang, uiLang ? "English" : "українська",
                      rxEarTest ? "; ІДЕ ПЕРЕВІРКА НАВУШНИКІВ" : "", cfg.rxBoost * 2, 20 * log10f(rxBoostNow > 0.01f ? rxBoostNow : 0.01f), cfg.rxLock, (cfg.rxEq[0] - 6) * 2, (cfg.rxEq[1] - 6) * 2, (cfg.rxEq[2] - 6) * 2,
                      (cfg.rxEq[3] - 6) * 2, (cfg.rxEq[4] - 6) * 2, cfg.rxLowCut,
                      20 * log10f((rxEqPkIn + 1) / 32768.0f), 20 * log10f((rxEqPkOut + 1) / 32768.0f));
        rxEqPkIn = 0;
        rxEqPkOut = 0;
      }
      return;
    case 'e': {   // передатчик: эквалайзер входа — e<полоса 0…4>=<дБ −12…12>, e5=<0/1> — срез низов; e — показать
      int b = -1, val = 0;
      if (cfg.isTx && sscanf(arg.c_str(), "%d=%d", &b, &val) == 2 && b == 9) {   // e9=1 — проба: эквалайзер и на тоне 1 кГц
        txEqOnTone = val != 0;
        Serial.printf("еквалайзер входу на перевірочному тоні: %u\n", (unsigned)txEqOnTone);
        return;
      }
      if (cfg.isTx && sscanf(arg.c_str(), "%d=%d", &b, &val) == 2 && b >= 10 && b <= 13) {
        // шумовой порог входа (с 3.17): e10=<0…4> — выключен / в паузах −12 / −20 / −30 дБ / тишина; e11=<0…4> — порог на
        // 3…15 дБ над шумом входа; e12=<−80…−30> — ручной порог в дБ (0 — снова от шума); e13=<0…2> — закрытие
        if (b == 10) cfg.txGate = (uint8_t)constrain(val, 0, 4);
        else if (b == 11) cfg.txGateThr = (uint8_t)constrain(val, 0, 4);
        else if (b == 12) cfg.txGateDb = val ? (int8_t)constrain(val, -80, -30) : 0;
        else cfg.txGateRel = (uint8_t)constrain(val, 0, 2);
        txGatePrint();
        break;
      }
      if (cfg.isTx && arg == "10") {   // e10 без «=» — только показать
        txGatePrint();
        return;
      }
      if (cfg.isTx && sscanf(arg.c_str(), "%d=%d", &b, &val) == 2 && b >= 14 && b <= 17) {
        // ограничитель пиков входа (с 3.18): e14=<0/1> — выключен / включён; e15=<0…3> — потолок −0,5 / −1 / −2 / −3 дБ;
        // e16=<0…3> — сжатие пиков: нет / лёгкое / среднее / сильное; e17=<0…2> — отпускание
        if (b == 14) cfg.txLim = val ? 1 : 0;
        else if (b == 15) cfg.txLimCeil = (uint8_t)constrain(val, 0, 3);
        else if (b == 16) cfg.txLimComp = (uint8_t)constrain(val, 0, 3);
        else cfg.txLimRel = (uint8_t)constrain(val, 0, 2);
        txLimPrint();
        break;
      }
      if (cfg.isTx && arg == "14") {   // e14 без «=» — показать (и счёт АЦП)
        txLimPrint();
        return;
      }
      if (cfg.isTx && (arg == "19" || arg == "20" || (sscanf(arg.c_str(), "%d=%d", &b, &val) == 2 && (b == 19 || b == 21 || b == 22)))) {
        // e19=<мс> — записать «сырые» слова АЦП, когда вход оживёт; e21=<мс> — включить вход самому на время записи;
        // e22=<мс> — так же, но записать то, что уходит в эфир после всей обработки (с 3.21); e19 — что с записью;
        // e20 — выгрузить (с 3.20). При e21/e22 запись начинается через 1,5 с живого входа.
        if (arg == "20") {
          txRawCapDump();
          return;
        }
        if (arg != "19") {
          uint32_t ms = (uint32_t)constrain(val, 50, 1500);
          if (!txRawCap) txRawCap = (int32_t *)heap_caps_malloc(SRATE * 2 * sizeof(int32_t) * 3 / 2, MALLOC_CAP_SPIRAM);
          if (!txRawCap) {
            Serial.println("запис АЦП: немає пам'яті");
            return;
          }
          txRawCapState = 0;
          txRawCapN = 0;
          txRawCapKind = b == 22 ? 1 : 0;
          txRawCapWant = (b == 22 ? SRATE : SRATE * 2) * ms / 1000;
          txRawCapDelay = b == 19 ? 0 : 1500;
          txRawCapLive = 0;
          txRawCapT0 = millis();
          if (b != 19 && cfg.tone) {   // вход — в эфир на время записи; звук вернёт txRawCapTick (без записи во флеш)
            txRawCapTone = cfg.tone;
            cfg.tone = 0;
          }
          txRawCapState = 1;
        }
        Serial.printf("запис АЦП: %s, слів %u з %u%s\n",
                      txRawCapState == 0 ? "немає" : txRawCapState == 1 ? "чекаю живого входу" : txRawCapState == 2 ? "пишу" : "готово (e20 — вивантажити)",
                      (unsigned)txRawCapN, (unsigned)txRawCapWant, txRawCapTone != 0xFF ? "; вхід увімкнено на час запису — порт замовкне" : "");
        return;
      }
      if (cfg.isTx && (arg == "18" || (sscanf(arg.c_str(), "%d=%d", &b, &val) == 2 && b == 18))) {
        // e18=<0…2> — формат данных PCM1808 (с 3.19): само / как есть / сдвиг на бит; не сохраняется (проба на слух)
        if (arg != "18") txAdcFmtForce = (uint8_t)constrain(val, 0, 2);
        txLimPrint();
        return;
      }
      if (cfg.isTx && sscanf(arg.c_str(), "%d=%d", &b, &val) == 2 && b == 8) {   // e8=<0…4> — чувствительность шумозаглушения входа
        cfg.txNsSens = (uint8_t)constrain(val, 0, 4);
        txNsPrint();
        break;
      }
      if (cfg.isTx && sscanf(arg.c_str(), "%d=%d", &b, &val) == 2 && (b == 6 || b == 7)) {
        // e6=<0…3> — шумозаглушение входа: выключено / слабое / среднее / сильное; e7=1 — запомнить шум сейчас (в эфире
        // должна быть только тишина с шумом), e7=0 — снова оценивать его самому, в паузах
        if (b == 6) cfg.txNs = (uint8_t)constrain(val, 0, 3);
        else if (val) txNsLearnAsk = true;
        else txNsFrozen = false;
        txNsPrint();
        if (b == 6) break;
        return;
      }
      bool set = cfg.isTx && sscanf(arg.c_str(), "%d=%d", &b, &val) == 2 && b >= 0 && b <= 5;
      if (set) {
        if (b < 5) cfg.txEq[b] = (uint8_t)constrain(val / 2 + 6, 0, 12);
        else cfg.txLowCut = val ? 1 : 0;
        txEqGen = txEqGen + 1;
      }
      Serial.printf("еквалайзер входу: %d %d %d %d %d дБ (125 Гц, 400 Гц, 1 кГц, 2,5 кГц, 6 кГц), зріз низів %u\n", (cfg.txEq[0] - 6) * 2,
                    (cfg.txEq[1] - 6) * 2, (cfg.txEq[2] - 6) * 2, (cfg.txEq[3] - 6) * 2, (cfg.txEq[4] - 6) * 2, cfg.txLowCut);
      if (set) break;
      return;
    }
    case 'i':   // передатчик: настройка приёмнику — i<номер>=<значение>[@номер приёмника]; i9=1 / i9=0 — проверка наушников
      if (cfg.isTx) {
        int p = -1, val = 0;
        char who[8] = "";
        if (sscanf(arg.c_str(), "%d=%d@%6s", &p, &val, who) < 2) return;
        for (int i = 0; i < PEERS_MAX; i++) {
          if (!peers[i].used || !peerOnline(peers[i])) continue;
          char idx[8];
          snprintf(idx, sizeof(idx), "%02X%02X%02X", peers[i].id[0], peers[i].id[1], peers[i].id[2]);
          if (who[0] && strcasecmp(who, idx)) continue;
          if (!peers[i].hasInfo) continue;   // понимают приёмники с версии 2.32 — они сообщают свои настройки
          if (p >= RXP_Y_NS && p <= RXP_Y_LEARN) {   // i16 шумозаглушение, i17 сжатие, i18 «в паузах» — по 0…3 (приёмники с 2.68); с 2.72 —
            // i19 чувствительность 0…4, i20 порог пауз 0…4, i21 закрытие пауз 0…2, i22 образец шума (2 — запомнить сейчас, 0 — сам)
            peerCommand(peers[i].id, CMD_SET2, (uint8_t)(((p - 16) << 5) | constrain(val, 0, 4)));
          } else
          if (p == 7) {   // i7=<дБ 0…24> — усиление приёмника (с 2.48)
            peerCommand(peers[i].id, CMD_SET, (uint8_t)((RXP_X_BOOST << 5) | constrain(val / 2, 0, 12)));
          } else
          if (p == 6) {   // i6=<0…3> — блокировка ручки: 0 нет, 1 меню, 2 громкость, 3 всё (приёмники с 2.46)
            peerCommand(peers[i].id, CMD_SET, (uint8_t)((RXP_X_LOCK << 5) | (val & 3)));
          } else
          if ((p >= 30 && p <= 35) || (p >= 23 && p <= 25)) {   // i30…i34=<−12…12 дБ> — полосы эквалайзера, i35=<0/1> — срез низов
            // (до 3.30 / 4.00 — i20…i25, но i20…i22 с 2.72 заняты обработкой звука выше: 125 Гц, 400 Гц и 1 кГц с порта не
            // ставились; i23…i25 оставлены как были)
            if (!peers[i].hasEq) continue;
            int band = p >= 30 ? p - 30 : p - 20;
            int v = band == 5 ? (val ? 1 : 0) : constrain(val / 2 + 6, 0, 12);
            peerCommand(peers[i].id, CMD_EQ, (uint8_t)((band << 4) | v));
          } else
          if (p == 9) peerCommand(peers[i].id, CMD_EARTEST, val ? 1 : 0);
          else if (p >= 0 && p < RXP_COUNT) peerCommand(peers[i].id, CMD_SET, (uint8_t)((p << 5) | ((val + (p == RXP_BALANCE ? 5 : 0)) & 31)));
          Serial.printf("команду надіслано приймачу %s\n", idx);
          if (!who[0]) break;
        }
      }
      return;
    case 'H': pinProbe(); return;
    case 'I':
    case 'E':
    case 'W':
    case 'V':
    case 'X':
    case 'N':
      if (c == 'E' && arg.indexOf(' ') > 0) {   // E<0|1> <номер> — выключить/включить именно этот приёмник (на связи он или нет)
        String h = arg.substring(arg.indexOf(' ') + 1);
        h.trim();
        uint8_t id[3] = {};
        if (h.length() == 6)
          for (int k = 0; k < 3; k++) id[k] = (uint8_t)strtol(h.substring(k * 2, k * 2 + 2).c_str(), NULL, 16);
        int i = h.length() == 6 ? peerFind(id) : -1;
        if (i < 0) Serial.println("такого приймача в наборі немає");
        else {
          if (v == 2) {   // E2 <номер> — перезапустить этот приёмник (как кнопкой «Перезапустити» в его окне)
            peerCommand(peers[i].id, CMD_RESTART, 0);
            Serial.printf("приймач %02X%02X%02X: надіслано команду «перезапуститися»\n", peers[i].id[0], peers[i].id[1], peers[i].id[2]);
            return;
          }
          peerCommand(peers[i].id, CMD_ENABLE, v ? 1 : 0);
          peers[i].wantOff = !v;
          peersDirty = true;
          Serial.printf("приймач %02X%02X%02X: з передавача задано «%s»\n", peers[i].id[0], peers[i].id[1], peers[i].id[2], v ? "увімкнений" : "вимкнений");
        }
        return;
      }
      for (int i = 0; i < PEERS_MAX; i++)
        if (peers[i].used && peerOnline(peers[i])) {
          if (c == 'W' && peers[i].fw < 11) continue;   // стерео понимают приёмники с версии 1.1
          if (c == 'X' && peers[i].fw < 13) continue;   // проверку выхода — с версии 1.3
          if (c == 'X') peerCommand(peers[i].id, CMD_DACTEST, 0);
          if (c == 'I') peerCommand(peers[i].id, CMD_IDENTIFY, 0);
          if (c == 'E') {   // как выключатель на экране: команда повторяется, пока приёмник (он может спать) не подтвердит
            peerCommand(peers[i].id, CMD_ENABLE, v ? 1 : 0);
            peers[i].wantOff = !v;
            peersDirty = true;
          }
          if (c == 'W') peerCommand(peers[i].id, CMD_STEREO, v ? 1 : 0);
          if (c == 'V') peerCommand(peers[i].id, CMD_VOLUME, v < 0 ? 0 : v > 20 ? 20 : v);
          if (c == 'N') peerCommand(peers[i].id, CMD_NAME, 0, arg.c_str());
          Serial.printf("команду надіслано приймачу %02X%02X%02X\n", peers[i].id[0], peers[i].id[1], peers[i].id[2]);
          break;
        }
      return;
    case 'M':   // передатчик: обновление прошивки приёмников по радио — M1 начать, M0 отменить, M — состояние
      if (cfg.isTx) {
        // M1 — начать; M4 — пробное (приёмники принимают и сверяют, но не записывают); M9 — холостая передача всей
        // прошивки, даже если её никто не ждёт (проверка самого передатчика)
        // M2 — обновить всё файлом с карты (приёмники, затем сам передатчик); M3 — просмотреть папку UPDATE заново
        if (arg.length() && (v == 1 || v == 4 || v == 9))
          Serial.println(otaTxStart(v == 4, v == 9) ? "оновлення приймачів розпочато" : "оновлення зараз неможливе (уже йде або немає ключа набору)");
        else if (arg.length() && v == 5 && upd.state == UPD_OLDER && !upd.img) {   // M5: старую прошивку сперва прочитать с карты
          upd.keepOlder = true;
          upd.scanAsk = true;
          Serial.println("читаю з картки старішу прошивку — повторіть M5 за пів хвилини");
        } else if (arg.length() && (v == 2 || v == 5))   // M5 — то же, но и когда прошивка в файле старше работающей (возврат на прежнюю)
          Serial.println((upd.state == UPD_READY || (v == 5 && upd.state == UPD_OLDER)) && otaTxStart(false, false, upd.img, upd.len, upd.version, upd.sha) ? "оновлення з картки розпочато" : "на картці немає придатної нової прошивки");
        else if (arg.length() && v == 3) upd.scanAsk = true;
        else if (arg.length() && v == 8) {   // M8 — сейчас зальют по кабелю: предупреждение на весь экран (шлёт build.sh)
          cableNoteMs = millis() ? millis() : 1;
          Serial.println("екран: попередження про оновлення кабелем (25 с або до скидання плати)");
          return;
        }
        else if (arg.length() && (v == 6 || v == 7)) {   // M6 / M7 — автообновление приёмников включить / выключить
          cfg.autoUpd = v == 6;
          settingsSave();
        }
        else if (arg.length() && v == 0) otaTx.cancel = true;
        Serial.printf("картка: стан %u, файл «%s», версія «%s», причина %u; мітка цієї прошивки %s\n", upd.state, upd.file, upd.version, upd.why, FW_TAG);
        otaTxPrint();
        Serial.printf("автооновлення приймачів: %s (M6 — увімкнути, M7 — вимкнути); запусків у це ввімкнення %u\n", cfg.autoUpd ? "увімкнено" : "вимкнено", (unsigned)otaAutoRuns);
      } else Serial.printf("оновлення: стан %u, %u %%, блоків %u з %u, причина %u\n", otaRx.phase, otaRx.percent, (unsigned)otaRx.got, (unsigned)otaRx.blocks, otaRx.err);
      return;
    case 'Q':   // передатчик: «чёрный ящик» радио. Q — показать; Q0…Q3 — до какой ступени оживлять радио (обычно 3);
                // Q5 — начинать оживление со 2-й ступени, Q4 — с 1-й; Q7/Q8/Q9 — проверить ступень 1/2/3 на здоровом радио, Q6 — сброс поглубже (через сон)
      if (cfg.isTx) {
        if (arg.length() >= 1 && arg[0] == 'n') {   // Qn — что слышит радио: уровень шума и доля времени «эфир занят»
          // (только чтение: запись в регистр счётчика занятости, phy_set_cca_cnt, 09.10 ломала работу радио)
          for (int i = 0; i < 6; i++) {
            uint32_t c[2] = { 0, 0 };
            uint32_t st = phy_get_cca_cnt(c);
            Serial.printf("радіо чує: шум %d / %d, поріг-стан %u; лічильник зайнятості: стан %u, %u із %u (%.1f %%)\n", phy_get_noise_floor(), read_hw_noisefloor(), phy_get_cca(),
                          (unsigned)st, (unsigned)c[0], (unsigned)c[1], c[1] ? c[0] * 100.0f / c[1] : 0.0f);
            delay(150);
          }
          return;
        }
        if (arg.length() >= 2 && arg[0] == 'd') {   // Qd0 / Qd1 / Qd2 — два кадра в пакете: никогда / когда все приёмники умеют / всегда
          txDoubleMode = arg[1] == '3' ? 3 : arg[1] == '2' ? 2 : arg[1] == '1' ? 1 : 0;
          Serial.printf("два кадри в пакеті: %s; приймачі: %s; зараз в ефірі %s пакети\n", txDoubleMode == 3 ? "завжди, копії лише стиснені (перевірка)" : txDoubleMode == 2 ? "завжди, з точними копіями (перевірка)" : txDoubleMode ? "коли всі приймачі зі списку вміють" : "ні",
                        txDupOk ? "усі зі списку вміють і точні копії (2.77+)" : txDoubleOk ? "усі зі списку вміють (2.60+), точних копій — не всі" : txDoubleWhy == 2 ? "відкрите вікно додавання" : "у списку є зі старішою або невідомою прошивкою", txDupNow ? "ПОДВІЙНІ з точними копіями" : txDblNow ? "ПОДВІЙНІ" : "одиночні");
          return;
        }
        if (arg.length() >= 2 && arg[0] == 'c') {   // Qc0 / Qc1 — подполосный кодек не применять / применять (сравнение на слух с прежним сжатием; не запоминается)
          txSubOff = arg[1] == '0';
          Serial.printf("новий кодек для «стандартна»: %s; приймачі: %s; зараз в ефірі %s\n", txSubOff ? "ВИМКНЕНО (перевірка; Qc1 — повернути)" : "дозволено", txSubOk ? "усі зі списку вміють (2.79+)" : "не всі вміють", txSubNow ? "він" : "не він");
          return;
        }
        // Qp<настройка>=<значение> — выбор «как с экрана» (проверка обработки без касаний; номера — enum Param в txui.h).
        // Только со знаком «=»: до 2.86 этот разбор забирал себе и Qp<число> (опыт с режимами радио, ниже), и на 4848
        // тот молча не делал ничего.
        if (arg.length() >= 4 && arg[0] == 'p' && cfg.board == BOARD_4848 && arg.indexOf('=') > 1) {
          int eq = arg.indexOf('=');
          ui::out.setValue = arg.substring(eq + 1).toInt();
          ui::out.setParam = arg.substring(1, eq).toInt();
          Serial.printf("вибір як з екрана: налаштування %d = %d\n", (int)ui::out.setParam, (int)ui::out.setValue);
          return;
        }
        if (arg.length() >= 2 && arg[0] == 'r') {   // Qr0 / Qr1 / Qr2 — разность каналов «найвищої» стерео: 4-битная, как до 2.86 / без сжатия, когда все приёмники умеют / всегда (проверка); не запоминается
          txSideMode = arg[1] == '2' ? 2 : arg[1] == '1' ? 1 : 0;
          Serial.printf("різниця каналів у «найвищій» стерео: %s; приймачі: %s; зараз в ефірі %s\n",
                        txSideMode == 2 ? "завжди без стиснення (перевірка)" : txSideMode ? "без стиснення, коли всі приймачі зі списку вміють" : "4-бітна, як до 2.86 (порівняння на слух; Qr1 — повернути)",
                        txPcmSOk ? "усі зі списку вміють (2.87+)" : "не всі вміють", txPcmSNow ? "без стиснення" : "4-бітна або не стерео");
          return;
        }
        if (arg.length() >= 2 && arg[0] == 'l') {   // Ql0 / Ql1 — нижнюю ступень скорости запретить / разрешить (для замеров на заданной скорости; не запоминается)
          if (arg[1] == '2' || arg[1] == '3') {   // Ql2 / Ql3 — настройка «Слабкий сигнал»: не снижать / снижать (запоминается, как с экрана)
            cfg.rateLadder = arg[1] == '3';
            rateKick = 1;
            settingsSave();
          } else rateLadderOff = arg[1] == '0';
          Serial.printf("нижча ступінь швидкості заради слабкого приймача: %s; налаштування «Слабкий сигнал»: %s\n", rateLadderOff ? "ВИМКНЕНА (перевірка; Ql1 — повернути)" : "дозволена", cfg.rateLadder ? "знижувати" : "не знижувати");
          return;
        }
        if (arg.length() >= 2 && arg[0] == 's') {   // Qs1 / Qs0 — отправка по одному / как до 2.52 (для сравнения)
          rSerial = arg[1] != '0';
          Serial.printf("надсилання: %s\n", rSerial && rq ? "по одному — наступний пакет після відповіді на попередній" : "як до 2.52 — не чекаючи відповіді");
          return;
        }
        if (arg.length() >= 2 && arg[0] == 'p') {   // Qp<число> — опыт: режимы радио (1 b, 2 g, 4 n, 8 LR; 15 — как обычно)
          int bits = atoi(arg.c_str() + 1) & 15;
          rProtoKeep = PROTO_MAGIC | (bits ? bits : 15);
          esp_err_t e = esp_wifi_set_protocol(WIFI_IF_STA, radioProto());
          uint8_t got = 0;
          esp_wifi_get_protocol(WIFI_IF_STA, &got);
          Serial.printf("режими радіо: задано %u, стало %u (код %d); лишиться й після швидкого перезапуску плати; Qp15 — як звичайно\n", radioProto(), got, (int)e);
          return;
        }
        if (arg.length() && v >= 0 && v <= 3) rReviveMax = v;
        else if (v == 4 || v == 5) rReviveFrom = v - 3;
        else if (v == 10) {   // Q10 — драйвер «будто встал» (проверка оживления и того, что канал при этом не меняется)
          rFakeDead = true;
          Serial.println("дослід: драйвер радіо ніби став — ефіру немає, доки не спрацює друга ступінь оживлення");
        }
        if (arg.length() && v >= 0 && v <= 5) {
          bool limited = rReviveMax != 3 || rReviveFrom != REVIVE_FROM;
          rReviveLimitMs = limited ? (millis() ? millis() : 1) : 0;
          if (limited)
            Serial.printf("УВАГА: оживлення радіо обмежено (до ступеня %u, починати з %u) — лише на 60 с або до 5 с без ефіру, далі повернеться саме; Q3 і Q5 — зняти зараз\n",
                          rReviveMax, rReviveFrom);
        }
        else if (v >= 7 && v <= 9) bbTestStep = v - 6;
        else if (v == 6) {   // проверить «сброс поглубже»
          quickBootMagic = QUICK_BOOT;
          esp_sleep_enable_timer_wakeup(100000);
          esp_deep_sleep_start();
        }
        bbPrint(true);
      }
      return;
    case 'u':
      if (cfg.isTx) {
        if (arg == "d") {   // ud — печатать в порт каждое касание экрана (включить/выключить)
          txscreen::touchDebug = !txscreen::touchDebug;
          Serial.printf("друк дотиків %s\n", txscreen::touchDebug ? "увімкнено" : "вимкнено");
          return;
        }
        txscreen::report();
        return;
      }
      Serial.printf("екран: %s; ручка: %d чверть-кроків; кнопки зараз: ручка %d, CON %d, BAK %d\n", uiHaveOled ? "знайдено" : "НЕ ЗНАЙДЕНО",
                    (int)encCount, (int)(uiKeys & 1), (int)(uiKeys >> 1 & 1), (int)(uiKeys >> 2 & 1));
      return;
    default: return;
  }
  settingsSave();
  if (restart) {
    rRebooting = true;   // радио и задача передачи замолкают: иначе их печать может не дать дойти до перезапуска
    Serial.println("перезапуск…");
    delay(100);
    ESP.restart();
  }
  help();
}

// Журнал работы на карту (см. txrec.h): показатели копятся десять секунд и уходят одной строкой.
struct LogAcc {
  uint32_t n, frames, refused, air, thinned, skipped, airSumUs, airN, airMaxUs;
  int pendMax, pk;
};
static LogAcc logAcc;
static void logEmit() {
  if (!recSd || logSeq != logDone) return;   // карты нет или прежняя строка ещё не записана — эту пропускаем
  static bool head;
  int o = 0;
  char *t = logText;
  const int cap = sizeof(logText);
  if (!head) {   // первая строка файла: что за прибор и почему запустился
    head = true;
    o += snprintf(t + o, cap - o, "# hearlink %s; запуск: %s; рядки раз на 10 с: час с, канал, швидкість, якість, пакетів, відмов, не пішло, перезапусків радіо, "
                  "до ефіру сер./макс. мс, черга, проріджено, пропущено, рівень дБ, джерело, запис, шум радіо дБм | приймач: зв'язок, сон, сигнал там/тут дБм, запас мс, втрати %%, "
                  "пропусків, провалів мс, повідомлень про себе отримано/не дійшло | міст (4.x): версія, запуск, що грає, AES Гц, перескоки, "
                  "провали; рядки «міст #…» — записи журналу моста\n", FW_VERSION, resetReason());
  }
  const LogAcc &a = logAcc;
  o += snprintf(t + o, cap - o, "t=%u к=%u шв=%s як=%u пак=%u відм=%u неп=%u рест=%u еф=%.1f/%.1f черга=%d прор=%u проп=%u рів=%.0f дж=%s зап=%u шум=%.0f", (unsigned)(millis() / 1000),
                cfg.channel, RATES[cfg.rateIdx].name, (unsigned)txQNow, (unsigned)a.frames, (unsigned)a.refused, (unsigned)a.air, (unsigned)rRestarts,
                a.airN ? a.airSumUs / 1000.0f / a.airN : 0.0f, a.airMaxUs / 1000.0f, a.pendMax, (unsigned)a.thinned, (unsigned)a.skipped,
                a.pk > 0 ? 20 * log10f(a.pk / 32768.0f) : -99.0f, fm.playing ? "файл" : cfg.tone ? "перевірка" : txMute ? "тиша" : "вхід", recOn ? 1u : 0u, phy_get_noise_floor() / 4.0f);
  for (int i = 0; i < PEERS_MAX && o < cap - 104; i++) {
    Peer &p = peers[i];
    if (!p.used) continue;
    o += snprintf(t + o, cap - o, " | %02X%02X%02X зв=%u сон=%u с=%d/%d зап=%u втр=%.1f проп=%u пров=%u ст=%u/%u", p.id[0], p.id[1], p.id[2], peerOnline(p) ? 1u : 0u,
                  p.flags & ST_SLEEP ? 1u : p.flags & ST_OFF ? 2u : 0u, p.rssi, p.rssiHere, p.depthMs, p.lossPm / 10.0f, p.lostFrames, p.underMs, (unsigned)p.stGot10, (unsigned)p.stMiss10);
    p.stGot10 = p.stMiss10 = 0;
  }
  if (cfg.input == IN_I2S && o < cap - 120) {   // мост (4.x): его стан
    if (txBridgeOk()) {
      const bp_status_t &b = txBr.st;
      static const char *const A[] = { "-", "AES", "PCM", "тиша", "тест", "перем" };
      o += snprintf(t + o, cap - o, " | міст %u.%02u зап=%u грає=%s aes=%u пер=%u пров=%u/%u ядро=%u", b.verMajor, b.verMinor, (unsigned)b.boot,
                    A[b.act <= BP_ACT_SWITCH ? b.act : 0], (unsigned)b.aesRate, b.resync, b.under, b.over, b.cpu1);
    } else o += snprintf(t + o, cap - o, " | міст НЕ НА ЗВ'ЯЗКУ");
  }
  if (o > cap - 2) o = cap - 2;
  t[o++] = '\n';
  for (int k = 0; k < 8 && brLogGot != brLogPut && o < cap - 200; k++) {   // новые записи журнала моста — своими строками
    uint32_t i = brLogGot % BRLOG_Q;
    int n = txBridgeLogLine(brLogQn[i], brLogQ[i], t + o, cap - o - 2);
    o += n < cap - o - 2 ? n : cap - o - 2;
    t[o++] = '\n';
    brLogGot++;
  }
  t[o] = 0;
  logSeq = logSeq + 1;
}

static void reportTx() {
  {   // настройка, которую приёмник так и не принял (сверка, txpeers.h) — сказать один раз
    static uint32_t lostShown;
    if (pendLost != lostShown) {
      lostShown = pendLost;
      Serial.printf("приймач %02X%02X%02X НЕ ПРИЙНЯВ налаштування (команда %u, номер %u) після 20 спроб — на екрані те, що в нього насправді\n",
                    pendLastLost[0], pendLastLost[1], pendLastLost[2], pendLastLost[3], pendLastLost[4]);
    }
  }
  uint32_t frames = txFrames, refused = rRefused, air = rAirFail, raw = txRawSamples, clips = txClips;
  uint32_t mn = txRawMin, mx = txRawMax;
  int pk = txPeak;
  txFrames = 0;
  rRefused = 0;
  rAirFail = 0;
  rSent = 0;
  txRawSamples = 0;
  txClips = 0;
  txRawMin = 4095;
  txRawMax = 0;
  txPeak = 0;
  uint32_t airN = rAir2N, airSum = rAir2SumUs, airMax = rAir2MaxUs, thinned = txThinned, skipped = txSkipped;
  int32_t pendMax = rPendMax;
  rAir2N = 0;
  rAir2SumUs = 0;
  rAir2MaxUs = 0;
  rPendMax = 0;
  txThinned = 0;
  txSkipped = 0;
  Serial.printf("ПЕРЕДАВАЧ к=%u шв=%s як=%s набір %u | пакетів %u, відмов %u, не пішло в ефір %u, перезапусків радіо %u, до ефіру сер. %u макс. %u мкс | ",
                cfg.channel, RATES[cfg.rateIdx].name, txQNow == Q_MON ? "монітор" : Q_NAME[txQNow < Q_COUNT ? txQNow : 0], cfg.kit, (unsigned)frames, (unsigned)refused, (unsigned)air,
                (unsigned)rRestarts, (unsigned)(airN ? airSum / airN : 0), (unsigned)airMax);
  if (cfg.input == IN_ADC)
    Serial.printf("АЦП %u відл/с, сирі %u…%u, перевантажень %u, перезапусків АЦП %u | ", (unsigned)raw, (unsigned)mn, (unsigned)mx, (unsigned)clips,
                  (unsigned)txAdcRestarts);
  else Serial.printf("I2S %u відл/с | ", (unsigned)raw);
  int pkS = txPeakS, pkAir = txPeakAir;
  txPeakS = 0;
  txPeakAir = 0;
  Serial.printf("рівень %.1f дБ%s", pk > 0 ? 20 * log10f(pk / 32768.0f) : -99.0f, cfg.tone ? " (перевірочний звук)" : "");
  if (txHold) Serial.print(" | ПЕРЕДАЧА СТОЇТЬ (заставка або команда z)");
  else if (txMute) Serial.printf(" | ТИША В ЕФІРІ: в ефір іде %.1f дБ", pkAir > 0 ? 20 * log10f(pkAir / 32768.0f) : -99.0f);
  if (txStNow) Serial.printf(" | СТЕРЕО, різниця каналів %.1f дБ", pkS > 0 ? 20 * log10f(pkS / 32768.0f) : -99.0f);
  Serial.printf(" | черга макс. %d, проріджено %u, пропущено %u%s", (int)pendMax, (unsigned)thinned, (unsigned)skipped, txThinOn ? "" : " (прорідження вимкнено)");
  if (refused) Serial.printf(" | відмова драйвера: 0x%X", (unsigned)rLastErr);
  if (monOn) {   // чужие передачи Wi-Fi на нашем канале за эту секунду
    uint32_t fr = monFrames, us = monAirUs, mxu = monMaxUs, slow = monSlowUs;
    monFrames = 0;
    monAirUs = 0;
    monMaxUs = 0;
    monSlowUs = 0;
    Serial.printf(" | чужі: кадрів %u, зайнято %.1f %% часу (повільних 1–2 Мбіт/с %.1f %%), найдовший %u мкс", (unsigned)fr, us / 10000.0f, slow / 10000.0f,
                  (unsigned)mxu);
  }
  Serial.println();
  {   // журнал работы на карту: копим десять секунд
    LogAcc &a = logAcc;
    a.n++;
    a.frames += frames;
    a.refused += refused;
    a.air += air;
    a.thinned += thinned;
    a.skipped += skipped;
    a.airSumUs += airSum;
    a.airN += airN;
    if (airMax > a.airMaxUs) a.airMaxUs = airMax;
    if (pendMax > a.pendMax) a.pendMax = pendMax;
    if (pk > a.pk) a.pk = pk;
    if (a.n >= 10) {
      logEmit();
      a = LogAcc();
    }
  }
  hopTick(airMax, thinned, skipped, refused);   // затяжной затор — самому уйти на более свободный канал (своё сообщение — отдельной строкой)
}
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
