roman885-85/hearlink/hearlink/rxscreens.h

// Экраны приёмника с движением: заставка, поиск передатчика, запуск, уход в ожидание, сообщения.
//
// Здесь только рисование (сишные вызовы библиотеки U8g2) и никакого железа — поэтому этот же файл собирается
// на компьютере, и кадры можно посмотреть без платы: tools/simrx/run.sh (картинки и анимация — в tools/simrx/out).
// Каждая функция получает время t в миллисекундах от начала своего экрана и рисует один кадр в очищенный лист.
#pragma once
#include <math.h>
#include <stdio.h>
#include <string.h>
#include "logo_oled.h"
#include "lang.h"
#include "rxfx.h"   // растр, переходы, дуги с затуханием, искры, оповещения

namespace rxs {

static inline float clamp01(float k) {
  return k < 0 ? 0 : k > 1 ? 1 : k;
}
static inline float easeOut(float k) {   // быстро начать, мягко остановиться
  k = 1 - clamp01(k);
  return 1 - k * k * k;
}
static inline float easeInOut(float k) {
  k = clamp01(k);
  return k * k * (3 - 2 * k);
}
// какая доля отрезка [from, from + len] уже прошла, 0…1
static inline float phase(uint32_t t, uint32_t from, uint32_t len) {
  if (t <= from || !len) return t > from ? 1 : 0;
  return clamp01((float)(t - from) / len);
}

static void centered(u8g2_t *g, int y, const char *s) {
  if (y < 1 || y > 90) return;
  u8g2_DrawUTF8(g, (128 - u8g2_GetUTF8Width(g, s)) / 2, y, s);
}

static int charCount(const char *s) {
  int n = 0;
  for (; *s; s++)
    if ((*s & 0xC0) != 0x80) n++;
  return n;
}

// Строка «печатается» по буквам: k — какая часть уже напечатана. Буквы стоят там же, где будут в готовой строке.
static void typed(u8g2_t *g, int y, const char *s, float k) {
  char b[72];
  int show = (int)(clamp01(k) * charCount(s) + 0.5f);
  if (show <= 0) return;
  size_t i = 0;
  while (s[i] && show > 0 && i + 5 < sizeof(b)) {
    b[i] = s[i];
    i++;
    while ((s[i] & 0xC0) == 0x80) {
      b[i] = s[i];
      i++;
    }
    show--;
  }
  b[i] = 0;
  u8g2_DrawUTF8(g, (128 - u8g2_GetUTF8Width(g, s)) / 2, y, b);
}
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
