roman885-85/hearlink/(commit log)

2026-10-07 HearLink 2.34: firmware sources, tools, documentation (uk/en)
    [partitions.csv]
2026-10-07 Module drawings with pin labels in the hardware docs
2026-10-07 MAX97220 photo; amplifier drawing follows the real pin names
2026-10-08 2.35: PCM5102 receiver output — master clock on pin 10, output status and pin check for I2S; docs: module jumpers
2026-10-08 2.36: PCM5102 — XSMT driven from pin 14, mute before clocks stop, wider playback-rate margin, rate measurement (n8=8)
2026-10-08 2.37: look-ahead limiter in the receiver; PCM5102 docs and schematic (XSMT on pin 14, SCK to ground)
2026-10-08 2.39: PCM5102 output as a plain 3-wire I2S (16 bit, no master clock), one-channel bug of 2.38 fixed, on-board I2S capture (n8=9); docs: module control pins must not float
    [config.h, hearlink.ino, rxaudio.h]
2026-10-08 2.41: receiver volume — 100 % is unity gain (no boost above full scale), volume limit is a ceiling of the scale
    Above 60 % the old scale amplified by up to +16 dB into the limiter; on full-scale music it sagged and rasped
    on bass (very audible with the PCM5102 DAC). Stored volume and limit are converted once on update.
    Host codec checks build again.
    [config.h, hearlink.ino, rxaudio.h, rxlink.h, ui_rx.h]
2026-10-08 2.42: automatic over-the-air update of receivers with older firmware; receivers report the exact version; n7=3 prints the effective volume
2026-10-08 2.43-2.44: spare copy of the channel difference (recovered frames stay stereo), windowed-sinc playback-rate interpolator
2026-10-09 2.45 (untested on hardware): receiver equalizer set from the transmitter, 100 Hz low cut
2026-10-09 2.45: input equalizer on the transmitter, shared Eq6, restart no longer fights the radio watchdog, I2S probe without master clock; docs
    [config.h, eq.h, hearlink.ino, lang_en.h, radio.h, rxaudio.h]
2026-10-09 2.46 (not flashed yet): receiver knob lock from the transmitter, auto-update switch in the Update window
2026-10-09 2.46: released — knob lock, equalizers, auto-update switch verified on hardware; simulator scenes
2026-10-09 2.47: cheaper settings windows on the transmitter (dim only the visible part, pixel-identical), shorter decoder boosts over the screen, window timings in the u report
    [config.h, txmp3.h, txui.h, ui_tx.h]
2026-10-09 2.48 (not flashed yet): the Equalizer button on the Sound page no longer loses its bottom rows to the spectrum redraw; simulator scene with full-height bars
    [txui.h]
2026-10-09 2.49: transmitter picture no longer breaks up until power-off — work around the ESP-IDF 5.5.1 RGB driver bug (bounce-buffer index never resynced with restart-in-VSYNC); fault counter in the u report,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
    [bbox.h, config.h, hearlink.ino, panel4848.h, ui_tx.h]
2026-10-09 docs: PCM5102 jumpers verified on the receiver (H1L-H, H2L-H, H4L-L removed the digital dirt); FLT/DEMP may be L or H but never floating; note on de-emphasis at 32 kHz
2026-10-09 2.56 (includes 2.50-2.55): radio stalls traced to the built-in ADC, faster and leak-free revival, the port now works with the PCM1808 (MCLK pin shared on demand), false busy-channel moves fixed, upda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
    [config.h, hearlink.ino, lang_en.h, ota.h]
2026-10-10 2.63 (includes 2.57-2.62): two frames per packet with four spare copies, self-repairing receiver radio, real trim-like boost, no pops at receiver start, update hand-out no longer restarts the transmi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
    Sound and radio
    - "найвища" quality goes as two 2 ms frames per packet (564/418 bytes, 250 packets/s) with compressed copies of the
    four previous frames: frame processing 1.85 -> 1.1-1.2 ms of 2 ms, air time 19 % -> 15 %; two lost packets in a row
    are recovered in stereo. tools/host/dbl.cpp checks packing and loss behaviour against single packets.
    - The transmitter remembers every receiver's firmware version in flash and uses double packets only when all
    rec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
    [bbox.h, config.h, dbgair.h, hearlink.ino, lang_en.h, ota.h]
2026-10-14 2.85 (includes 2.64-2.84): continuous sound with a weak signal, far-mode codec, sound processing for hearing, self-recovering sound, CS4344 DAC
    - receivers report to the transmitter with acknowledgement and raise their power when weak (2.64);
    "the transmitter is in charge" and radio-update fixes (2.65-2.67)
    - receiver compression, pause gating and spectral noise reduction, transmitter input noise reduction,
    settings on the screen, in the receiver menu and from the port (2.68-2.72, fixes 2.75-2.76)
    - rate steps 5.5 <-> 1 Mbit/s for a weak receiver, also under a manual rate; deeper buffer while packets
    are lost; channel search only after 2.5 s of silence (2.73-2.78); "Weak signal" settin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
2026-10-14 2.88 (includes 2.86-2.87): no graininess, no rustle on packet loss, channel chosen by receivers' packet losses too
    - the stereo channel difference of "highest" goes uncompressed (it was 4-bit ADPCM, whose flat noise was only
    27...2 dB below the music in the 2-16 kHz bands); external DACs get 24 bits in a 32-bit word instead of 16 bits
    truncated after the digital volume; look-ahead limiter with a 3 ms window and an averaged attack (no samples over
    full scale: 1426 -> 6 in 87 s at +24 dB boost); pace conversion table 48 taps with a 15 kHz cutoff (2.86)
    - the spare copies of the previous packet carry the difference uncompressed too: a single lost packet is restored
    bit for bit in stereo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
2026-10-15 3.02 (includes 2.89-3.01): noise suppression in stereo without clicks or a lost channel, radio updates in under a minute, smooth receiver menu and analyzer
    - noise suppression in stereo: the channel difference gets its own spectrum with the same band gains as the
    mid (it was only delayed and scaled by one overall number, so L and R fell apart: quiet music panned to L
    leaked into R at -16...-20 dB, now -27...-31); host test tools/host/nsstereo.cpp (2.89)
    - receiver DAC output queue 2 -> 4 ms: with noise suppression the output ran dry once in 30-60 s (a 1 ms
    click), now 0 times in 3 minutes on both receivers (2.92)
    - radio update: the receiver sound chain no longer processes silence duri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
2026-10-16 3.16 (includes 3.03-3.15): optional colour display for the receiver, the knob does nothing without a signal, animated menu icons
    - receiver colour display (optional): IPS 1.9" ST7789 170x320 (MSP1901 module), landscape 320x170, on
    SPI2 through the GPIO matrix (SCL 42, SDA 41, DC 40, CS 39, RES 2, BLK 1); every screen, menu, icon,
    the splash, effects and transitions redrawn in colour (hearlink/rxcolor.h); the frame lives in PSRAM,
    only changed tiles are sent (hearlink/rxstrip.h), the analyser redraws only the bars that moved:
    main screen 62-63 frames/s at 3.6-4.9 ms per frame; desktop simulator tools/simrxc checks that the
    incrementally drawn screen equals a full redraw (1233 frames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
2026-10-21 3.29 (includes 3.17-3.28): final version of the first modification — no crackle from the mixer input, input noise gate and peak limiter, card file player with a waveform, colour spectrum on the recei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
    Next: 4.x "Next Edition" with a Raspberry Pi Pico bridge (digital AES/EBU input, minimal latency); the first modification's code stays in the first-edition branch.
2026-10-21 Fix receivers lost after a channel hop while asleep; reliable delivery of receiver settings
    Receiver: a sleeping receiver (switched off from the transmitter, or without
    signal) that caught a channel-hop announcement kept it forever: the hop was
    done only by the audio task, which does not run while asleep, and with a
    pending hop the receiver never reports itself. The transmitter could not hear
    it or switch it on; only a power cycle helped. Now the sleep cycle and the main
    loop perform an overdue hop (rxHopDo / rxHopTick).
    Transmitter: settings sent to receivers (equalizer, settings, processing,
    volume, output) were often lost at the highest quality in stereo: the service
    slot rarely found th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
2026-10-21 4.00 Next Edition: version and firmware image tag
    The kit with the Raspberry Pi Pico bridge starts at 4.00. Image tag
    HEARLINK-NE: instead of HEARLINK-FW:, so first-edition transmitters (3.x) do
    not take 4.x files from the card; 4.x recognizes a first-edition file and says
    so on screen (the old key is built at run time, never stored in the image).
2026-10-21 4.00: bridge inputs on screen, honest spectra, visible tone settings
    Transmitter talks to the Raspberry Pi Pico bridge: reads its status from the
    back channel in bits 7..4 of the I2S words (COBS + CRC), sends it the chosen
    input once a second over the port (pin 43 now always carries the port, the
    bridge clocks the PCM1808 itself). Buttons «Аналоговий вхід» and «Цифровий
    вхід» replace «З пульта»; the level card says when the bridge is silent or
    there is no AES signal. Port command C / C1 / C2.
    Spectra: the transmitter's input spectrum had a +4 dB/octave tilt and the
    receiver's about +3 dB/octave with the strongest bin per band, so next to the
    mixer's an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
2026-10-21 4.00: manual channel change announced to receivers; larger bridge back-channel ring
    A channel chosen by the operator (screen or port c) now goes the same way as
    the automatic move off a busy channel: announced, so playing receivers follow
    without a gap and a receiver asleep (switched off from the transmitter) picks
    the announcement up in its listening window. Before, the radio jumped at once:
    2.5 s of silence on playing receivers, sleeping ones found it only by search.
    Verified: receiver switched off and asleep, channel 5 -> 4 announced, it stayed
    online (off, asleep) on the new channel and woke on E1.
    Bridge back channel ring 4 KB -> 16 KB: the main loop stands while a long
    reply goes out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
2026-10-22 4.00: transmitter updates the bridge itself; equalizer in the receiver menu
    Bridge update: the transmitter carries the bridge program (hearlink/bridge_fw.h,
    generated by bridge/build.sh) and installs it when the bridge reports another
    version: command «to the loader», then 4 KB chunks with an ACK each, CRC-32
    check and boot, the loader answering on pin 40 (the I2S data wire) read by
    UART1 meanwhile; the input is muted for ~10 s, progress and result on the
    home screen. Switch «Оновлювати міст сам» on the settings page (in place of
    the source name: inputs have their own names now), port C9 — update now.
    A bridge silent for 20 s is asked once a minute whether it sits in i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
2026-10-22 Bridge 1.02: test signals instead of the input (tone, pink noise, sweep)
    The bridge can put a test signal on its output instead of the input, so the
    whole path (transmitter processing, air, receivers) can be measured without
    the mixer: 1 kHz tone (-12 dB), pink noise (Voss-McCartney, -20 dB rms),
    logarithmic sweep 20 Hz -> 16 kHz in 10 s. BP_SET carries the kind
    (BP_GEN_*); transmitter port C3 off, C4 tone, C5 pink noise, C6 sweep; the
    home screen says in orange that the input is replaced. The transmitter
    updates the bridge to 1.02 by itself.
2026-10-22 4.00: no more sound dropouts once a minute — false "bridge silent"
    The bridge status time stamp was millis() | 1, so half of the time it was
    1 ms ahead of the clock, and the unsigned "now - stamp" turned it into
    "ages ago". The transmitter then decided the bridge had been silent for
    over 20 s, muted the input and polled the bridge loader for 1.5 s —
    once a minute (the probe rate limit), while the bridge was playing
    normally (owner 22.10: "periodic short sound dropouts").
    All such checks now use msSince(), which treats a stamp from the future
    as "just now": bridge link, bridge update steps, command resend to
    receivers, channel experience, and the receiver's 12 ms wait for its own
    packet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
2026-10-22 timedcmd.py: HL_DTR=1 for the Pico bridge console (stdio_usb is silent without DTR), HL_NOLF=1 for one-letter commands
2026-10-22 Bridge: sources that were missing from git; RAM-only board probe
    Until now only bridge/src/main.c and version.h were tracked, so the
    bridge could not be rebuilt from the repository: added the build
    (CMakeLists.txt, build.sh, setup-rp2040.sh, flash.sh, linker overrides),
    the loader, the sample-rate converter and its Mac test, the PIO
    programs, the flash layout, the image maker and the measuring tools,
    and the copy of pico_spdif_rx (BSD 2-Clause, listed in NOTICE.md).
    test/board_probe.c (ninja board_probe; picotool load -x -f): runs from
    RAM only, the bridge program in flash stays as it was. Reports GP23,
    GP24, GP29, cycles the colour LED and prints USR button presses. On the
    owner's board (2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
2026-10-22 4.00 / bridge 1.02: bridge event log, USR button and colour LED; new bridge builds recognized by CRC
    Version numbers stay (owner 22.10: no bumps until 4.x is finished), so
    the bridge status now carries the CRC-32 of the bridge program (from the
    loader's info page) and the transmitter updates the bridge when the CRC
    differs from its embedded image — or when the bridge still sends the
    old, shorter status. The transmitter accepts both status sizes.
    Bridge log: 512 records in RAM at 0x2003E000, above everything the
    program and the loader use, so it survives watchdog resets, crashes, the
    loader and updates from the transmitter (not a power cut). Records: boot
    and why (a real hang only when the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
2026-10-22 4.00: bridge log records taken strictly in order; a gap (lost frame) is re-requested
    22.10 the card log missed bridge record #23 (C8 had it): the transmitter
    accepted any record number >= the expected one, so one lost frame of the
    streamed log left a hole nobody asked for again. Now only the expected
    number is accepted; a later number means a gap — the frame is skipped and
    the log is asked again from the expected record 0.3 s later. Records the
    bridge has already overwritten (older than the last 512) are skipped
    explicitly.
2026-10-22 4.00 / bridge 1.02: USB input — the bridge is a sound card for a computer
    The bridge is now a composite USB device: a UAC2 sound card «Міст «Слух»»
    (48 kHz stereo 16 bit, adaptive isochronous endpoint, no volume control —
    the sound passes as is), the console port and the picotool reset
    interface. Descriptors are ours (usb_audio.c, UTF-16 strings), TinyUSB
    init and its background task stay with the SDK. USB packets go to a
    ring on core 0, core 1 feeds them to the same sample-rate converter as
    AES (48 frames per 1 ms burst, reserve 72, the regulator is told how far
    into the next burst we are). The transmitter selects it as bridge source
    4 (BP_SRC_USB): a third input button «US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
2026-10-22 Bridge: USB recording of what goes on air; isochronous endpoint reopen fix; output clamp after dither
    USB, second direction: the bridge is also a capture device «Що йде в
    ефір» — the 32 kHz samples it sends to the transmitter, 16 bit stereo,
    with its own clock (the transmitter's) and an asynchronous endpoint:
    each 1 ms packet carries what the bridge produced (31…33 frames). macOS
    shows it as a separate input device. Core 1 writes the samples into a
    ring, the USB task moves them to TinyUSB before each packet.
    Crash found by re-opening the recording: TinyUSB 0.18 on RP2040 never
    closes an isochronous endpoint, so the packet queued before the stream
    was closed stays AVAIL and t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
2026-10-22 Silence is silent again: no bridge dither; filters flush tiny states
    Owner 22.10: white hiss in silence on every input, «if there is no sound
    on digital, the hiss has nowhere to come from». Measured with all
    sources off: the console sends exact zeros (left 0, right a constant -1
    LSB); the hiss was the bridge's own TPDF dither (±1 LSB of 16 bit,
    -98 dB RMS at the transmitter input, -91.5 dB on air), lifted by the
    transmitter input gain (+15 dB) and the receiver gain (+24 dB).
    The dither was added on 21.10 against the transmitter's equalizer
    filters crawling through denormal numbers on exact zeros (lost I2S
    frames). It is gone now; instead eq.h (transmitter input and receivers)
    zeroes filt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
2026-10-22 Bridge: 24 -> 16 bit by rounding, not truncation — the digital-input hiss
    Owner 22.10: «на цифре откуда шим» — the hiss stayed on the digital
    input after the dither was removed. The bridge reduced AES (24 bit) and
    PCM1808 words to 16 bit for the sample-rate converter by dropping the
    low bits (rounding down). A tiny signal from the console around zero
    (-140 dB, its own 24-bit noise) became jumps 0 <-> -1 LSB of 16 bit:
    -98.5 dB RMS with a mean of exactly minus half an LSB (measured -135.7 in
    24-bit units), identical in both channels — then +15 dB in the
    transmitter and +24 dB in the receiver. The constant -1 LSB on the right
    channel seen earlier was the same rounding-d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
2026-10-22 24-bit path from the console to the transmitter's input gain — quiet-signal hiss and crackle
    Owner: "at a low sound level on the digital input there is background hiss and a bit of crackle". Measured on his
    signal: console -87 dBFS RMS (peaks -75), i.e. +-5 steps of a 16-bit scale; the sound became 16-bit twice before the
    +24 dB input gain (bridge resampler input; transmitter `raw >> 16` with floor and `(l + r) / 2` truncation). On air the
    quiet music took only 11 distinct values in +-300 (all on the x15.85 gain lattice).
    - bridge: the resampler takes 24-bit samples (sample split into high 16 bits and low byte, each with its own
    multiply — RP2040 has only 32x32->32); AES and PCM1808 g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
2026-10-22 Receiver: never send the DAC pure zeros — PCM5102 auto-mute click at sound onset
    Owner: "on the digital input only a weak click remains when the signal appears". Since the 22.10 rounding fixes the
    digital-input silence is exact zero all the way to the receiver DAC. The PCM5102 (4C3B10) mutes its analog output
    after 1024 consecutive zero samples (TI PCM510xA "Zero Data Detect") and un-mutes at once, without a soft ramp, on
    the first non-zero sample — the click. Before 22.10 the bridge's rounding noise kept the data non-zero.
    The 32-bit word to an external DAC now carries +1 LSB of 24 bits (RX_DAC_AWAKE): a constant -138 dBFS DC level, no
    noise, removed by the output coupling capacitor. T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
2026-10-22 Bridge survives a transmitter reset: no loader on a low command line without TX clocks; TX probes early
    Owner: "if you reset the transmitter, the bridge does not work". The bridge journal showed "to the loader: command
    line break" at the moment of the TX reset, and the bridge stayed there ~74 s: a low line for >= 80 ms meant "go to the
    loader", but a resetting or powered-off TX also drops its TX pin to zero; the TX only asked the loader 15 s after its
    own start and then once a minute.
    - bridge: a break is now a pulse — the line was high, fell for 80 ms .. 1 s and rose again, with the TX I2S clocks
    running the whole time. Without clocks (TX resetting/off) or a line stuck low > 1 s it mea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
2026-10-22 Balanced analog input: the bridge takes (L - R) / 2 — ground hum cancels, inverted channel fixed
    Owner: "the analog still hums and is unusable at all", "analog PCM clearly works at very low quality compared to
    digital". Measured on his analog input: the 250 Hz hum (TX radio current pulses) is common to both PCM1808 channels
    (L -84.2, R -84.5 dB) and 34 dB weaker in their difference (-118.7 dB); and the music arrives with one channel
    inverted (correlation -0.67, bass +23 dB in the difference; the digital input of the same mixer: +0.64..+0.89).
    In the sum the bass and centre cancel — the "low quality".
    - protocol: BP_SET d[1] bit 1 (BP_PCM_DIFF) — balanced analog input; old bridges igno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
2026-10-22 AES blocks through the registers directly, word-wise XOR, in IRAM — the transmitter's cipher stage 297 -> 185 us per 2 ms frame
    The per-block aes_hal_transform_block call (flash, byte-wise copies) and byte-wise XOR made a 1116-byte 'highest'
    packet (~140 AES blocks) cost 594 us. Now key and blocks go straight to the AES registers, XOR by 32-bit words, code
    in IRAM; same algorithm and output bytes (self-test B matches the openssl reference). Measured on the transmitter:
    seal 212 B 162 -> 92 us, open 161 -> 94 us; cipher stage 297 -> 185 us/frame, mean frame 1096 -> 1024 us, frames
    over 2 ms 4.6 % -> 1.6 %.
2026-10-23 Monitor mode (Q_MON): 48 kHz, 24-bit, two 2 ms frames per packet — transmitter, bridge and receivers
    Owner's goal (22.10): monitoring how instruments sound, "as close to the original as possible", 24 bit 48 kHz
    "without down-conversion". First working chain, alongside the existing qualities (they are untouched):
    - protocol: Q_MON = 4 (outside the QDEF ladder: rate selection never lowers it); packet = header + 2 x 96 samples
    x (mid, side) x 3 bytes + tag = 1174 bytes every 4 ms, no spare copies (qPktLenMon). BP_SET d[1] bit 2 (BP_OUT48):
    bridge output 48 kHz.
    - bridge: output rate 32 / 48 kHz switched in silence like a source change; 48 kHz uses a 32-tap filter with cutoff
    min(0.48 f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
2026-10-23 Monitor: ADPCM copy of the previous pair in every packet — one lost packet plays the copy instead of 4 ms of silence
    884A94 lost up to 6 frames/s in the first monitor test, and every loss was 4 ms of silence (a click). Each packet now
    carries the previous pair as four IMA ADPCM blocks (mid and side of two frames, 51 bytes each): 1174 -> 1378 bytes
    every 4 ms, PKT_MAX 1200 -> 1400. The receiver plays the copy for the last two lost frames and silence for older
    ones; recovered frames are counted like in the other qualities.
2026-10-23 Equal source buttons, "Analog input: stereo / balanced" replaces "Transmitter input", PCM1808 at 48.8 kHz
    Owner: "Sound menu — the second row of buttons must be the same size"; "Home — top row — all buttons the same size";
    "the Transmitter input button is useless, every input has its own button"; "the ADC works unsatisfactorily — strong
    background noise and an extremely low sample rate, the sound is dull".
    - screen: the five buttons of the source row (home and Sound) are 86 px each; the lamp of the selected one sits left of
    the short second line ("вхід") or in the corner of one-line buttons; narrow "Ефір" row fits its value.
    - "Вхід передавача" row is now "А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
2026-10-23 Analog input: radio hum removed by a learned template; PCM1808 I2S channels in place; both-input capture
    Owner: "the analog still hisses and is unusable"; "the noise appeared with the bridge"; "fmy, md0, md1 are on gnd".
    - bridge (src/hum.h): the transmitter's radio pulses leak into the PCM1808 input as a 250 Hz hum (-81 dB in silence,
    15 dB more than with the module on the transmitter). After the resampler the hum repeats exactly with the
    transmitter's frames, so the bridge learns its 16 ms shape and subtracts it; every cycle teaches with the weight
    E0 / (E0 + E) of its own residual energy (E0 = -76 dB), so music never enters the template. Mac test on the 22.10
    recordings (test/hum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
2026-10-24 4.00 release docs: kit 4.x guide with schematics, digital input variants (AES, coaxial, optical), transmitter back side, upgrading from 3.x
    Owner: "now we can publish version 4 on GitHub, it works"; "describe the new configuration on the main page, the
    differences and the modifications needed to build it; build variants (connection variants for the digital input); all
    with detailed schematics and pictures"; "describe how to move to the new version with a software update"; "also
    instructions for the optical S/PDIF and coaxial digital inputs"; "publish all instructions for the firmware and
    programs"; "show pin numbers in the schematics, and draw the back panel of the display module with its co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
2026-10-24 Docs 4.00: the bridge board — Raspberry Pi Pico / YD-RP2040 pinout picture, which boards fit, buttons and LEDs
    Owner: "there is no photo or description of the Raspberry Pi Pico". tools/gen_pico.py draws all 40 pins (top view,
    pins used by the bridge coloured with where they go), uk and en; docs/uk|en/next-edition.md got a section on the board.
    [skip ci]
2026-10-24 Docs 4.00: photos of the owner's YD-RP2040 bridge board, the used pins marked on the photo, YD-RP2040 labels (Vin = VSYS, Vout = VBUS, GP23, GP29)
    Owner: "here is our module", "here is a good-quality one". docs/photos/yd-rp2040.jpg (main photo),
    yd-rp2040-flat.jpg + tools/gen_yd_photo.py: the pins the bridge needs marked with Pico pin numbers; the pinout picture
    and the wiring schematic show the YD-RP2040 labels; tables say VSYS (39) is "Vin" on the YD-RP2040.
    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
